Flash-Cart/Flash-Cart-Model/9.Eletrônica/Esquemáticos/Conexão da tela - PI2.jpg

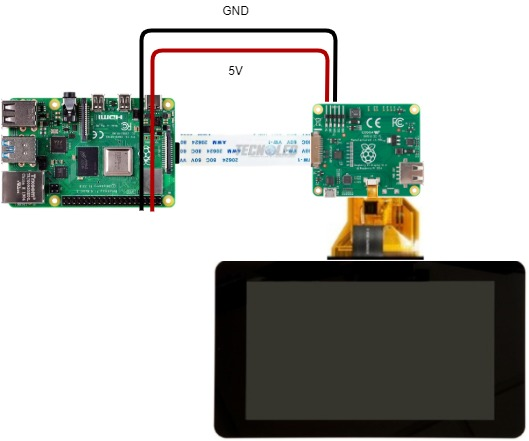
9.Eletrônica/Esquemáticos/Conexão da tela - PI2.jpg
