Flash-Cart/Flash-Cart-Model/2.CADs/Flash Cart Completo Final - 28_04_2021/FLASH CART/Toten de carregamento/suporte+toten.jpg

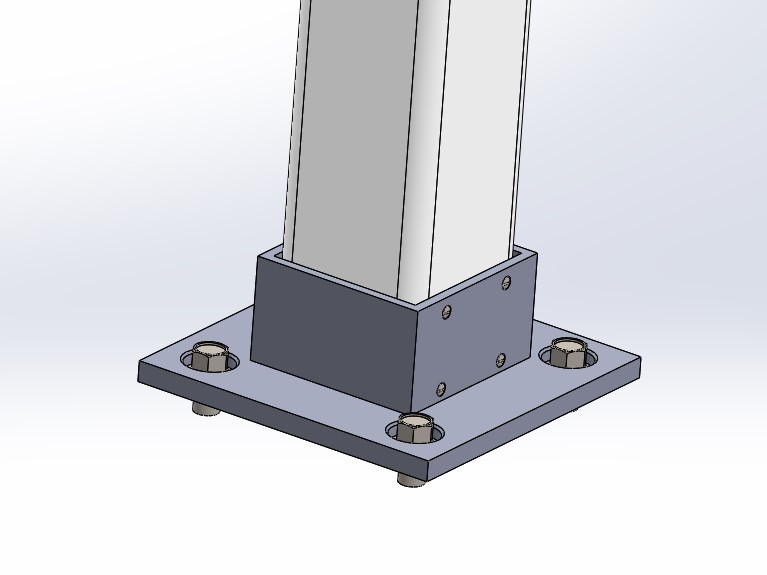
2.CADs/Flash Cart Completo Final - 28_04_2021/FLASH CART/Toten de carregamento/suporte+toten.jpg
