Flash-Cart/Flash-Cart-Model/9.Eletrônica/Referências/REFERÊNCIAS BIBLIOGRÁFICAS.docx

REFERÊNCIAS BIBLIOGRÁFICAS

BALANÇA:

[1] SILVA.F.T.F. Análise numérica e otimização de uma célula de carga de ponto único. UFRGS, 2017

Link: https://lume.ufrgs.br/bitstream/handle/10183/165161/001044445.pdf?sequence=1&isAllowed=y#page=1&zoom=auto,-15,842

[2] 7 PESO padronizado. . Acessado: 13-04-2021.

Link: https://www.troemner.com/weights/electronic-balance-test-weights/electronic-balance-test-weights-metric/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,

[3] SIMULADOR 625-Acessado: 13-04-2021

Link: https://docs.blhnobel.com/?id=2915

[5] ZHAO, W. et al. Design of dynamic calf weighing system based on moving-iir filter algorithm. Journal of Electrical Engineering & Technology, Springer, v. 16, n. 2, p. 1059–1069, 2021. Citado na página 50.

Link: https://link.springer.com/article/10.1007/s42835-020-00604-5

[6]datasheet L6E3

Link: https://www.zemiceurope.com/media/Documentation/L6E3_Datasheet.pdf, acessado em 13/04/21

[7]Peso da moeda de 1 real

Link: https://www.bcb.gov.br/dinheirobrasileiro/pdf/FolderMoedas.pdf, acesso em 12/04/21

[8]GETTING Started with Load Cells. . Acessado: 23-03-2021. Citado na página 50.

Link: https://learn.sparkfun.com/tutorials/getting-started-with-load-cells, acesso em 12/04/21

[9]Regulaçao técnica para célula de cargas:

ASL, S. E. et al. Part 1: Metrological and technical requirements. In: OIML. Metrological Regulation for Load Cells. [S.l.], 2017. p. 1–57. Citado na página 50.

Link: https://www.nist.gov/system/files/documents/2016/11/02/tc9_p1_n001_oiml_r60-1_5cd_clean.pdf , acesso em 12/04/21

[10] AMPLIFICADORHX711. . Acessado: 13-04-2021. Citado 2 vezes nas páginas 50 e 51

Link:https://www.alldatasheet.com/view.jsp?Searchword=HX711 , acesso em 12/04/21

[11]: ABNT_NBR_ISO_IEC_17025_2017

Link: http://www.inmetro.gov.br/credenciamento/eventos-cgcre/13-14-15Workshop/00-DOQ-CGCRE-087_rev_00_-_Orientacoes_gerais_sobre_os_requisitos_da_ABNT_NBR_ISO_IEC_17025_20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

[12] HIGH-SPEED CMOS Logic 16-Channel Analog Multiplexer/Demultiplexer. 2003. Acessado: 23-03-2021. Citado na página 50.

Link: https://www.alldatasheet.com/view.jsp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

SENSOR ULTRASSÔNICO:

[1] Datasheet hc-sr04:

ZHMUD, V. et al. Ultrasonic distance sensor hc-sr04. Automatics & Software Enginery. 2017. N4 (22), n. 7/212, p. 10, 2017

[2] LIU, Y.; YE, W.-J. Time consuming numerical model calibration using genetic algorithm (ga), 1-nearest neighbor (1nn) classifier and principal component analysis (pca). In: IEEE. 2005 IEEE Engineering in Medicine and Biology 27th Annual Conference. [S.l.], 2006. p. 1208–1211. Citado na página 67.

Link: https://pubmed.ncbi.nlm.nih.gov/17282410/

[3] GANDHA, G. I.; SANTOSO, D. A. The newton’s polynomial based-automatic model generation (amg) for sensor calibration to improve the performance of the low-cost ultrasonic range finder (hc-sr04). JURNAL INFOTEL, v. 12, n. 3, p. 115–122, 2020. Citado 3 vezes nas páginas 2, 67 e 68.

Link: https://ejournal.st3telkom.ac.id/index.php/infotel/article/view/486

[4]SRIVASTAVA, R.; SRIVASTAVA, P. K. Comparison of lagrange’s and newton’s interpolating polynomials. Journal of Experimental Sciences, v. 3, n. 1, 2012. Citado 2 vezes nas páginas 68 e 69.

Link : https://updatepublishing.com/journal/index.php/jes/article/download/1904/1886
