Flash-Cart/Flash-Cart-Model/10.Energia/folhas de projeto/folha de projeto carregador com fio.pdf

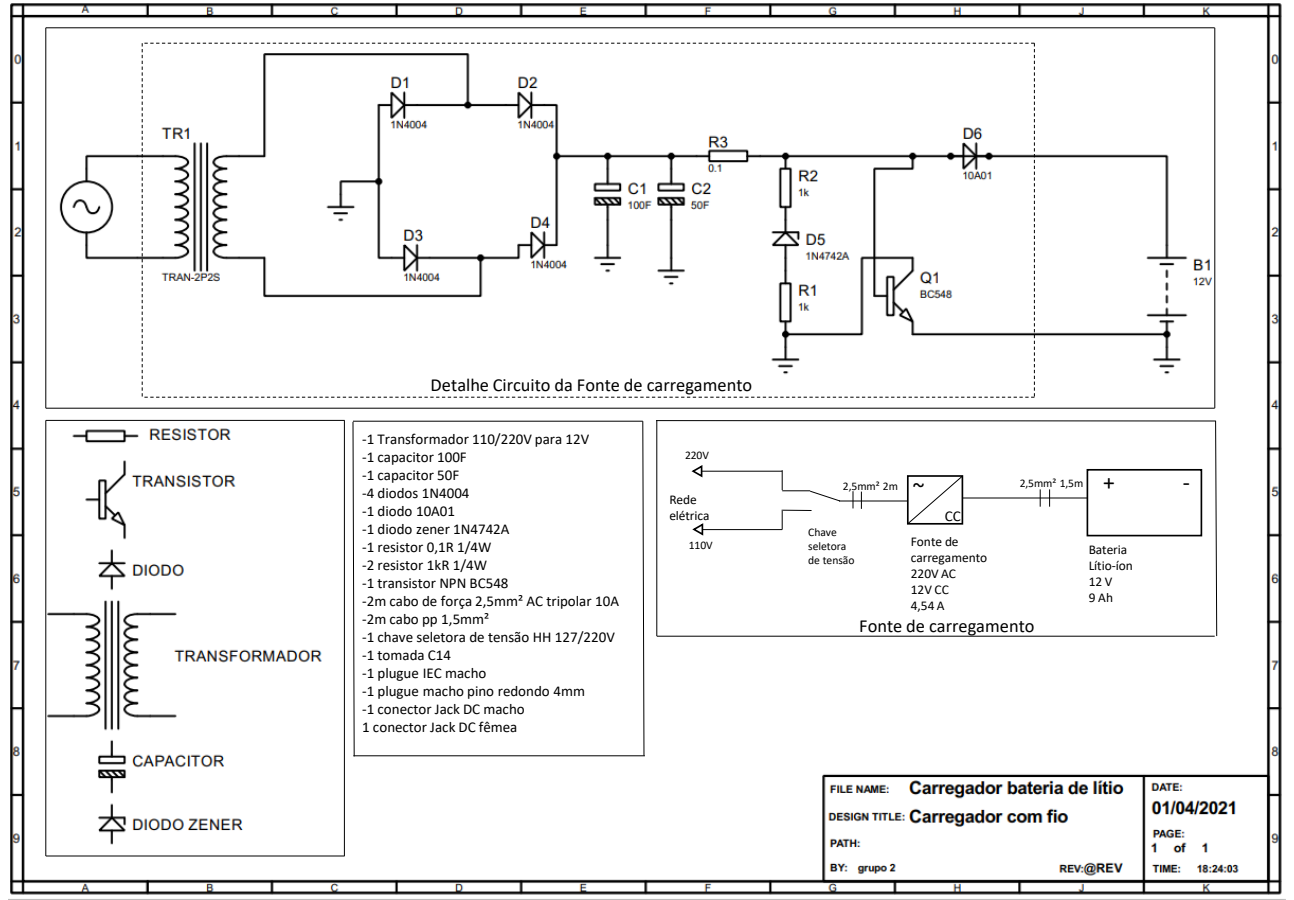
[picture p4: page 1]

### Detalhe Circuito da Fonte de carregamento

+ - ~

CC

Rede
elétrica

220V

110V

Chave
seletora
de tensão
2,5mm² 2m | 2,5mm² 1,5m

Fonte de
carregamento
220V AC
12V CC
4,54 A

Bateria
Lítio-íon
12 V
9 Ah

### Fonte de carregamento

-1 Transformador 110/220V para 12V -1 capacitor 100F
-1 capacitor 50F
-4 diodos 1N4004
-1 diodo 10A01
-1 diodo zener 1N4742A
-1 resistor 0,1R 1/4W
-2 resistor 1kR 1/4W
-1 transistor NPN BC548
-2m cabo de força 2,5mm² AC tripolar 10A -2m cabo pp 1,5mm²
-1 chave seletora de tensão HH 127/220V -1 tomada C14
-1 plugue IEC macho
-1 plugue macho pino redondo 4mm
-1 conector Jack DC macho
1 conector Jack DC fêmea
