Flash-Cart/Flash-Cart-Model/10.Energia/folhas de projeto/folha de projeto carregador sem fio  receptor.pdf

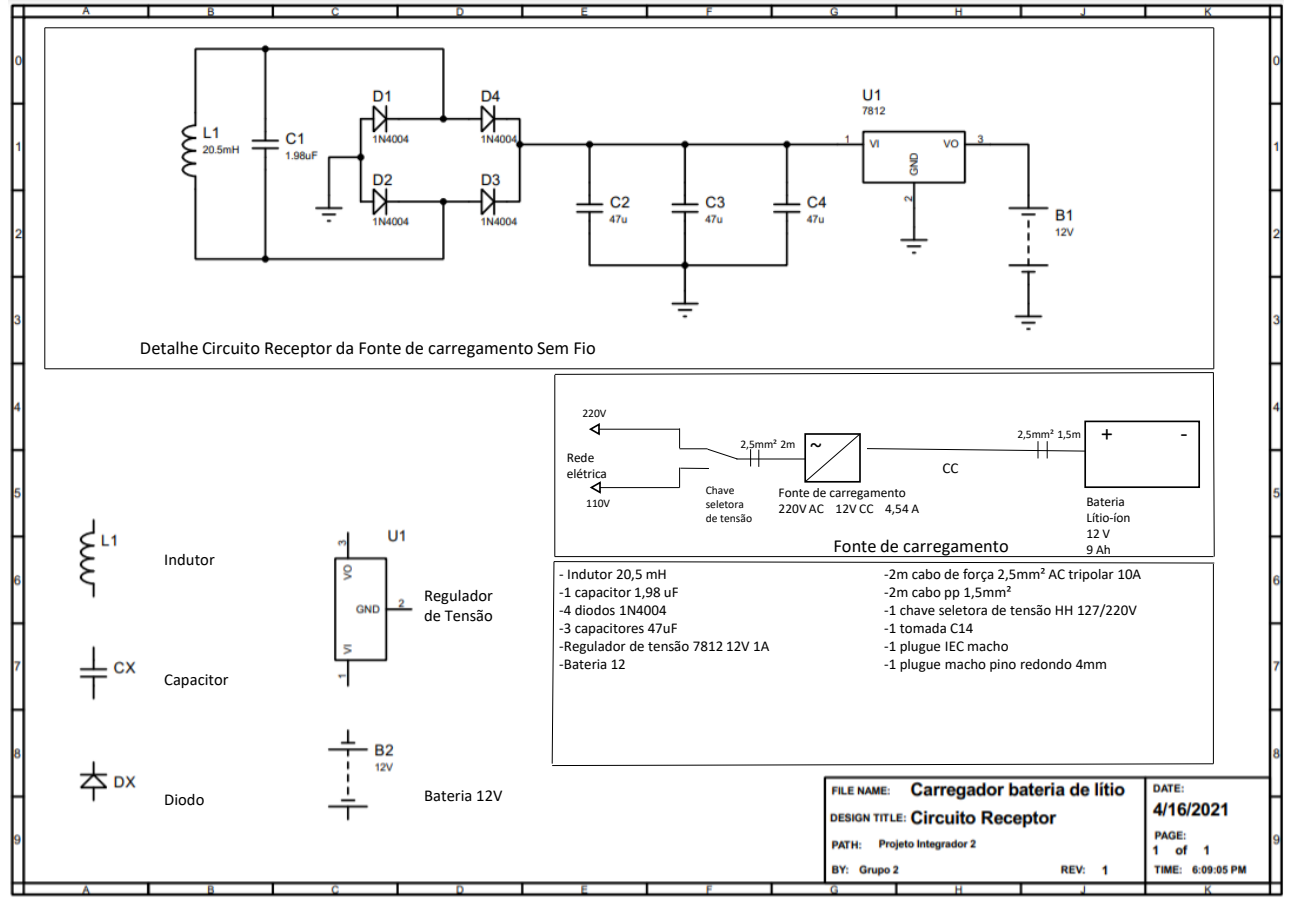
[picture p5: page 1]

### Detalhe Circuito Receptor da Fonte de carregamento Sem Fio

+ -
~
CC

Rede
elétrica

220V

110V

Chave
seletora
de tensão

2,5mm² 2m

2,5mm² 1,5m

Fonte de carregamento
220V AC 12V CC 4,54 A

Bateria
Lítio-íon
12 V
Fonte de carregamento | 9 Ah
- Indutor 20,5 mH
-1 capacitor 1,98 uF
-4 diodos 1N4004
-3 capacitores 47uF
-Regulador de tensão 7812 12V 1A -Bateria 12

-2m cabo de força 2,5mm² AC tripolar 10A -2m cabo pp 1,5mm²
-1 chave seletora de tensão HH 127/220V -1 tomada C14
-1 plugue IEC macho
-1 plugue macho pino redondo 4mm

Indutor

Capacitor

Diodo

Regulador
de Tensão

Bateria 12V

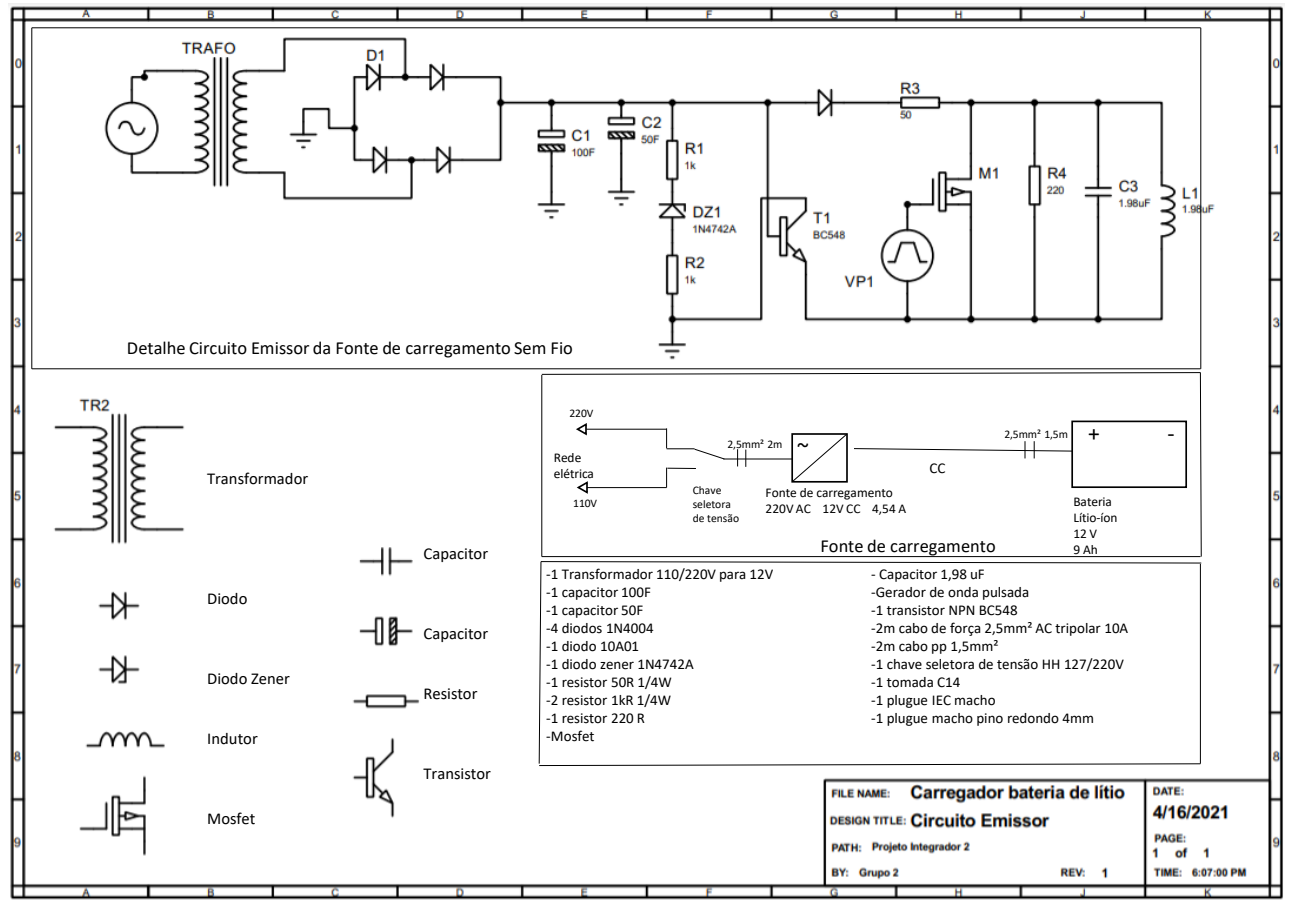
[picture p6: page 2]

### Detalhe Circuito Emissor da Fonte de carregamento Sem Fio

+ -
~
CC

Rede
elétrica

220V

110V

Chave
seletora
de tensão

2,5mm² 2m

2,5mm² 1,5m

Fonte de carregamento
220V AC 12V CC 4,54 A

Bateria
Lítio-íon
12 V
Fonte de carregamento | 9 Ah

-1 Transformador 110/220V para 12V -1 capacitor 100F
-1 capacitor 50F
-4 diodos 1N4004
-1 diodo 10A01
-1 diodo zener 1N4742A
-1 resistor 50R 1/4W
-2 resistor 1kR 1/4W
-1 resistor 220 R
-Mosfet
- Capacitor 1,98 uF
-Gerador de onda pulsada
-1 transistor NPN BC548
-2m cabo de força 2,5mm² AC tripolar 10A -2m cabo pp 1,5mm²
-1 chave seletora de tensão HH 127/220V -1 tomada C14
-1 plugue IEC macho
-1 plugue macho pino redondo 4mm

Transformador

Diodo

Diodo Zener

Indutor

Mosfet

Capacitor

Capacitor

Resistor

Transistor
