Flash-Cart/Flash-Cart-Model/9.Eletrônica/Eletrônica PC3.pptx

## Eletrônica - PC3

## Testes dos subsistemas

- Tem como objetivo verificar possíveis erros em cada subsistema em separado
- Devem ser realizados ao receber o carrinho e periodicamente para garantir o funcionamento do carrinho
- Composto de testes rápidos que podem ser efetuados por um funcionário sem experiência em eletrônica

## Teste da balança

- Consiste em posicionar um peso de teste cuja massa já é conhecida e verificar se o display mostra um valor adequado
- recomenda-se utilizar pesos padronizados; pesos de objetos comuns pode ser utilizados, mas deve-se adotar uma margem de erro maior nesses casos

## Teste do sensor ultrassônico

- Consiste em posicionar o carrinho contra a parede e utilizar um gabarito desenhado no chão como guia para movimentar o carrinho e checar a distância entre carrinho e parede

## teste do sistema RFID

- Os testes do sistema RFID podem ser divididos em 3 partes:
  - Teste de leitura: verificar se o sistema identifica uma tag colocada no carrinho
  - Teste de registro: verificar se o sistema leu e registro o produto relacionado aquela tag
  - Teste de tempo: verificar se a leitura e registro foram feitos em um tempo adequado
- Os testes dos sistema RFID requerem uma estrutura especial de antenas de teste

## Teste do sistema de trava

- Consiste em acionar o modo de teste que ativa os atuadores lineares de forma a travar as rodas do flash cart
- Depois de travado o funcionário deve tentar empurrar o carrinho e observar se há ou não movimento
- Deve-se atentar para movimento tanto das duas rodas quanto de uma das rodas somente

## Teste do sistema de áudio

- Este teste executa um áudio de teste.
- Para um bom resultado do teste recomenda-se a escolha de pelo menos 3 áudios com diferentes níveis de graves, médios e águdos

## Calibração dos subsistemas

- Tem objetivos de calibrar os subsistemas e ajustá-los de forma a obter uma resposta mais precisa
- Algumas calibrações envolvem processos que necessitam um funcionário com conhecimento técnico em eletrônica.

## Ajuste da odometria

- Esse ajuste se baseia no cálculo de um novo coeficiente que multiplica o número de passos contados pelo carrinho
- O funcionário deve movimentar linearmente o carrinho guiando-se pelo gabarito no chão
- Ao final do ajuste o algoritmo da MSP calcula automaticamente a nova constante que será utilizada na odometria

## Ajuste do sistema da balança

- Antes de ser feita a calibração em si deve-se verificar se há necessidade da calibração. Esta verificação é feita causando uma deformação virtual nos sensores da balança utilizando um resistor de teste. Caso o valor verificado nesse teste seja muito destoante do valor esperado deve-se prosseguir para a calibração.
- A calibração do sistema é feita utilizando um peso padronizado. O algoritmo na MSP ajusta o fator de calibração até que o peso medido pelo subsistema seja igual a ao peso padronizado
- A calibração das células individualmente é feita utilizando um calibrador portátil de precisão

## Ajuste do sensor ultrassônico

- Este ajuste é feito de forma automática pelo algoritmo de ajuste de curva na RASP
- Um funcionário deve mover o carrinho pelo gabarito desenhado no chão com o carrinho apontando na direção da parede
- O algoritmo calcula a distância medida e já tem embutido a distância real até o objeto . Esses dois valores são utilizados no aproximador de polinômio
