Flash-Cart/Flash-Cart-Model/2.CADs/Flash Cart Completo Final - 28_04_2021/FLASH CART/Balança/platform-scale-load-cell-350kg-200kg-100kg-60kg-1.snapshot.9/load_cell_sensor_FNL.JPG

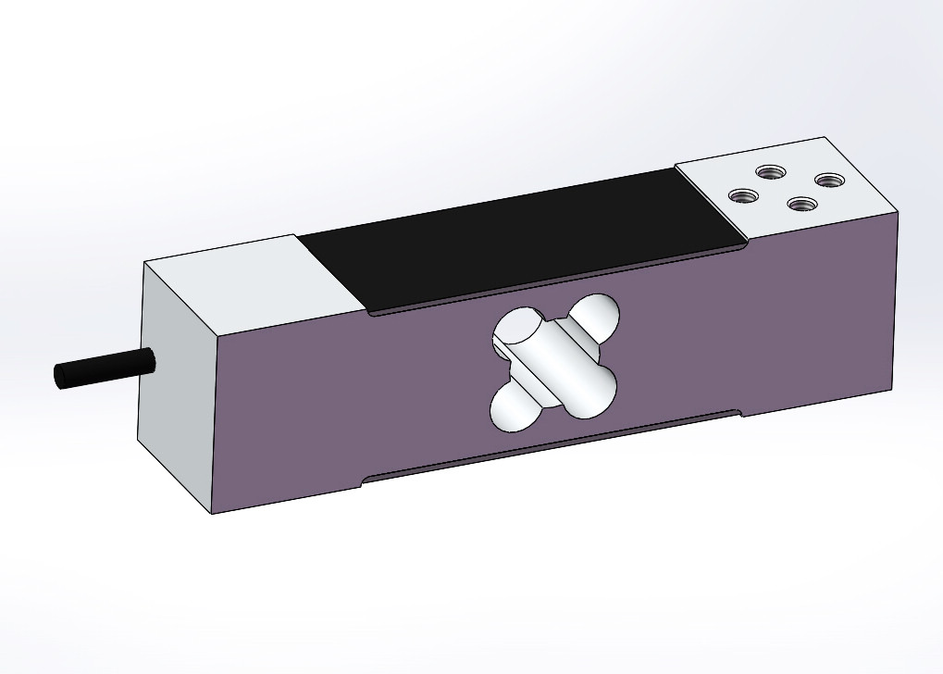
2.CADs/Flash Cart Completo Final - 28_04_2021/FLASH CART/Balança/platform-scale-load-cell-350kg-200kg-100kg-60kg-1.snapshot.9/load_cell_sensor_FNL.JPG
