Flash-Cart/Flash-Cart-Model/2.CADs/Flash Cart Completo Final - 28_04_2021/FLASH CART/Toten de carregamento/figuras/battery-circle-green-512.png

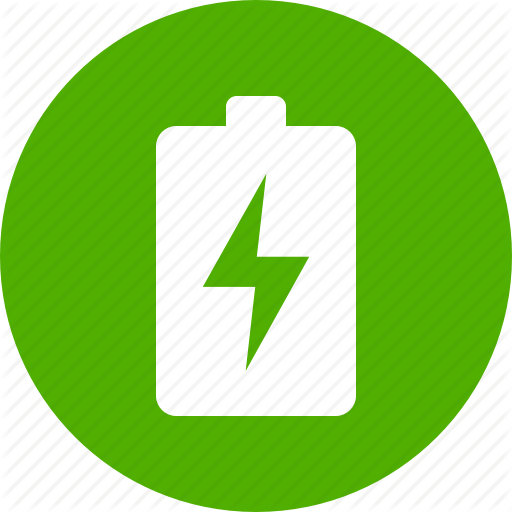
2.CADs/Flash Cart Completo Final - 28_04_2021/FLASH CART/Toten de carregamento/figuras/battery-circle-green-512.png
