Flash-Cart/Flash-Cart-Model/2.CADs/Flash Cart Completo Final - 28_04_2021/FLASH CART/Toten de carregamento/figuras/FOTO 1 - TOTEN.png

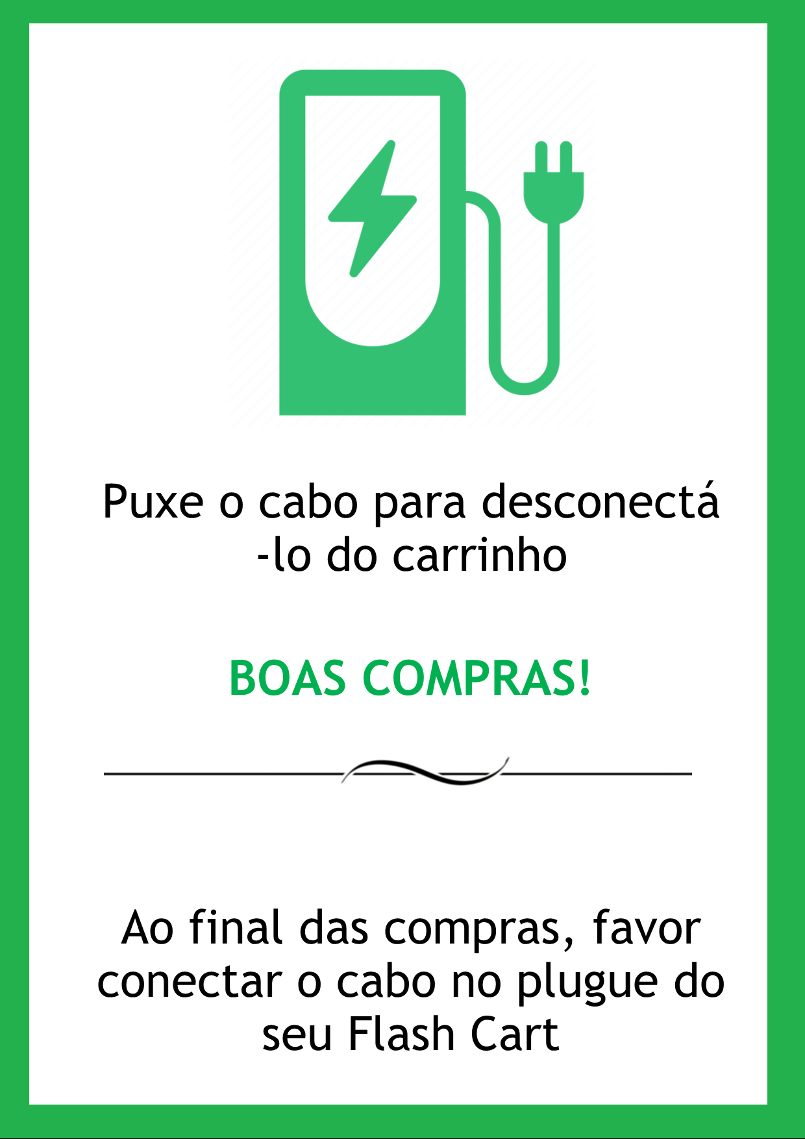
2.CADs/Flash Cart Completo Final - 28_04_2021/FLASH CART/Toten de carregamento/figuras/FOTO 1 - TOTEN.png
