Flash-Cart/Flash-Cart-Model/8.MoldeCesta/geometriaCesta.png

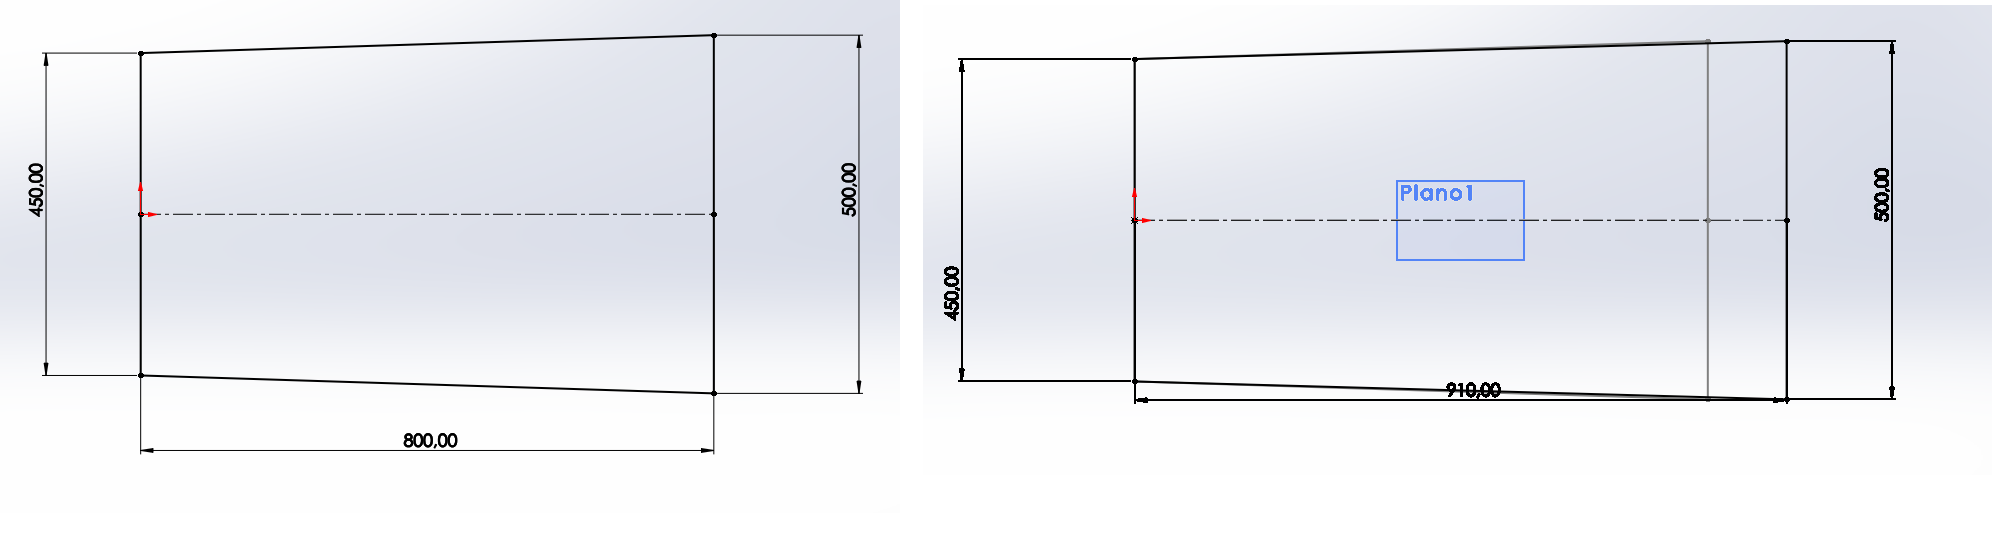
8.MoldeCesta/geometriaCesta.png
