Flash-Cart/Flash-Cart-Model/9.Eletrônica/Algoritmos/Diag_blocos_BalançaFinal.png

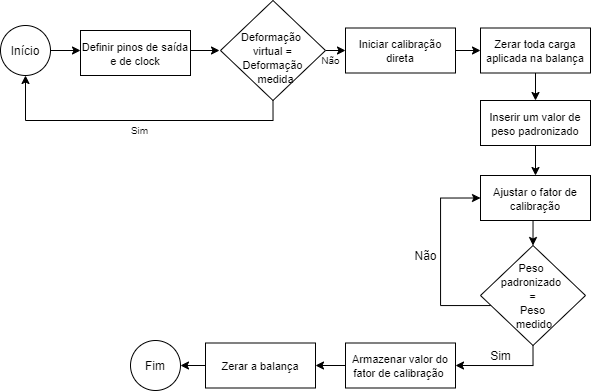
9.Eletrônica/Algoritmos/Diag_blocos_BalançaFinal.png
