Flash-Cart/Flash-Cart-Model/9.Eletrônica/Algoritmos/DiagBlocos_ultrassomFIR.png

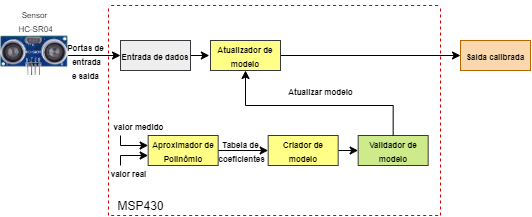
9.Eletrônica/Algoritmos/DiagBlocos_ultrassomFIR.png
