Flash-Cart/Flash-Cart-Model/9.Eletrônica/Esquemáticos/Altofalante - circuito.PNG

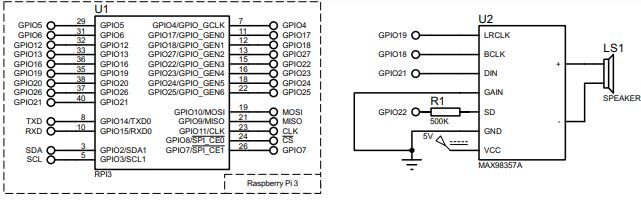
9.Eletrônica/Esquemáticos/Altofalante - circuito.PNG
