Flash-Cart/Flash-Cart-Model/9.Eletrônica/Esquemáticos/Altofalante - cirsuito da simulação.PNG

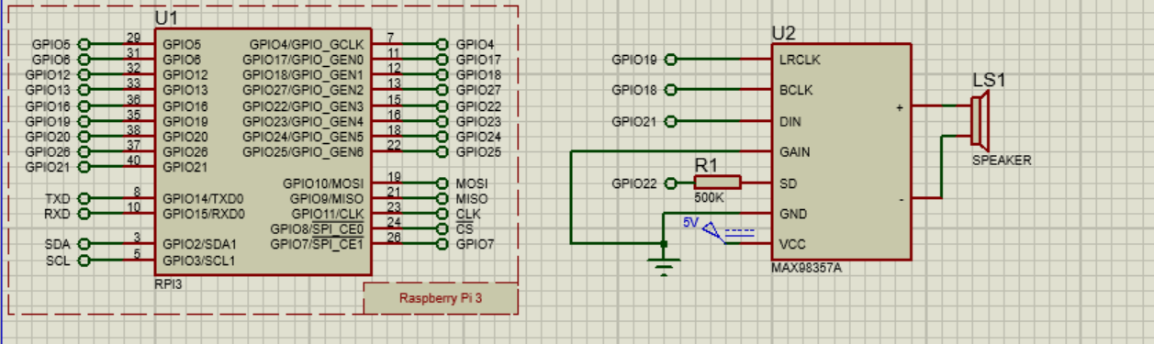
9.Eletrônica/Esquemáticos/Altofalante - cirsuito da simulação.PNG
