Flash-Cart/Flash-Cart-Model/9.Eletrônica/Esquemáticos/Diagrama geral.jpg

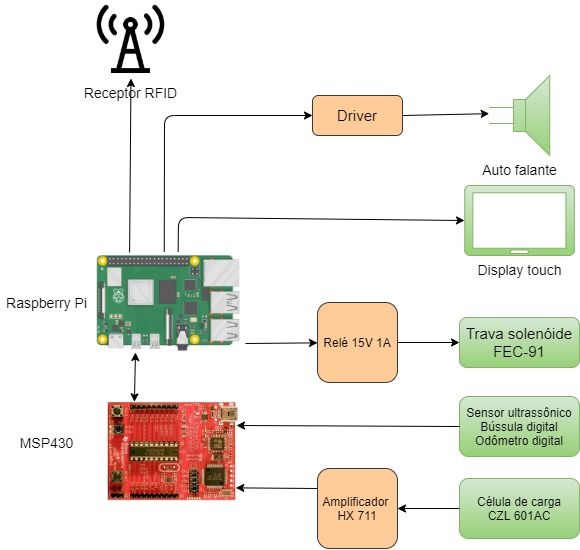
9.Eletrônica/Esquemáticos/Diagrama geral.jpg
