Flash-Cart/Flash-Cart-Model/9.Eletrônica/Esquemáticos/Trava de roda - circuito da simulacao.PNG

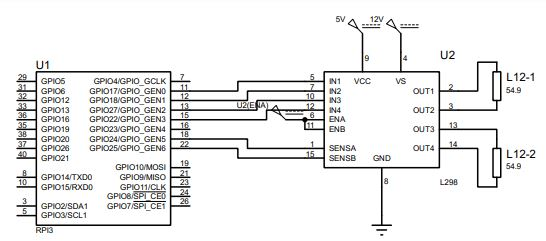
9.Eletrônica/Esquemáticos/Trava de roda - circuito da simulacao.PNG
