Flash-Cart/Flash-Cart-Model/10.Energia/imagens e esquemáticos/bateria_litio.png

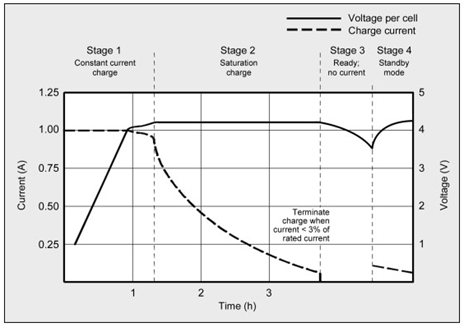
10.Energia/imagens e esquemáticos/bateria_litio.png
