Flash-Cart/Flash-Cart-Model/10.Energia/imagens e esquemáticos/Blocossemfio.PNG

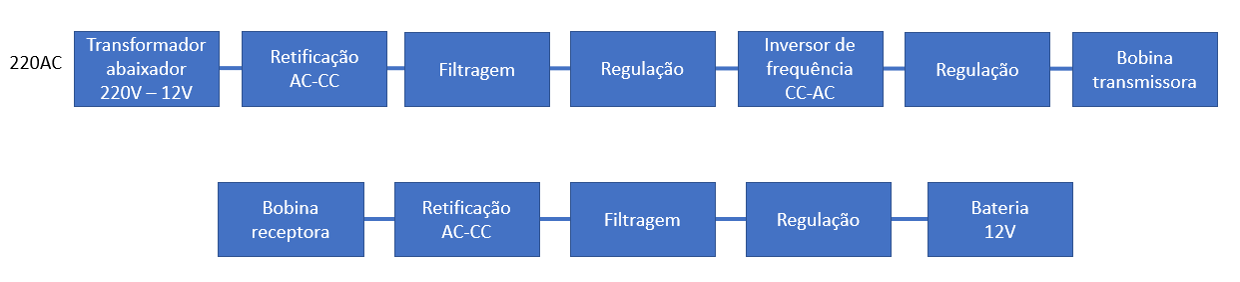
10.Energia/imagens e esquemáticos/Blocossemfio.PNG
