Flash-Cart/Flash-Cart-Model/10.Energia/imagens e esquemáticos/circuito_fonte_regulavel.PNG

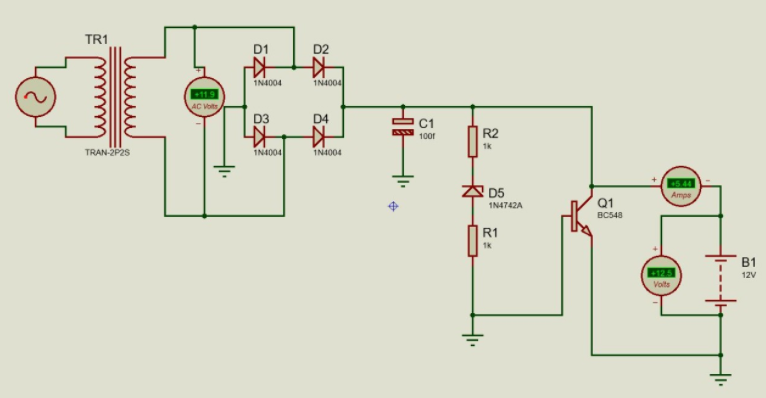
10.Energia/imagens e esquemáticos/circuito_fonte_regulavel.PNG
