Flash-Cart/Flash-Cart-Model/10.Energia/imagens e esquemáticos/diag_bloc_font_al.png

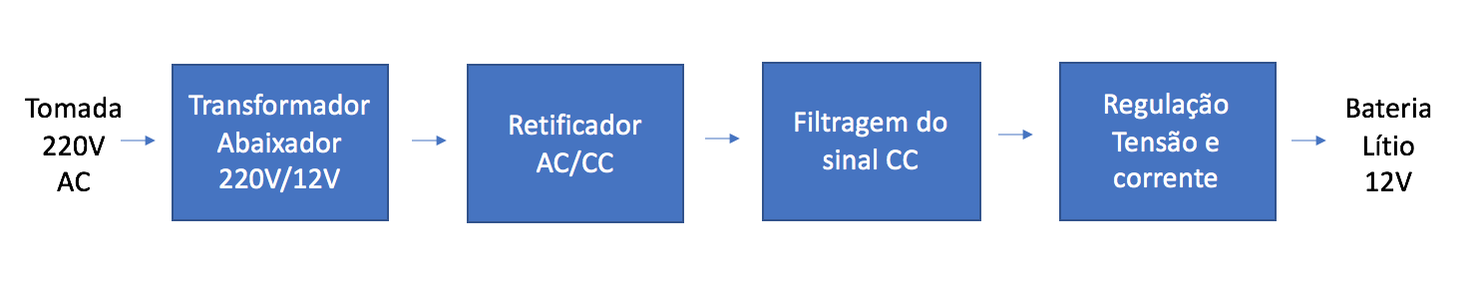
10.Energia/imagens e esquemáticos/diag_bloc_font_al.png
