Flash-Cart/Flash-Cart-Model/10.Energia/imagens e esquemáticos/emissor.JPG

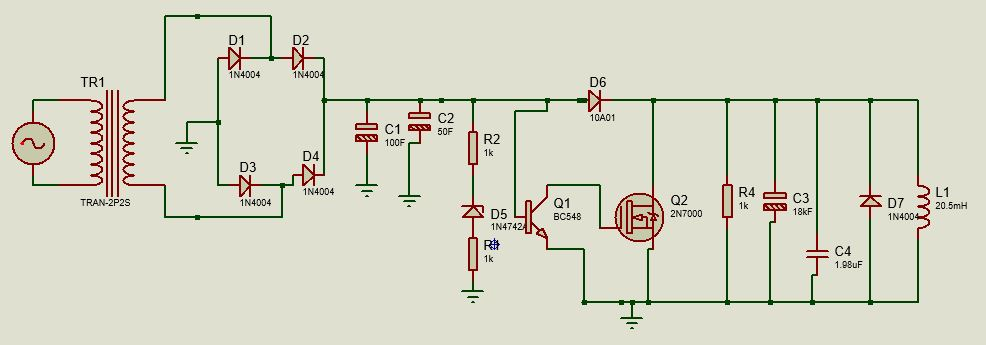
10.Energia/imagens e esquemáticos/emissor.JPG
