Flash-Cart/Flash-Cart-Model/10.Energia/imagens e esquemáticos/Figbobinas.png

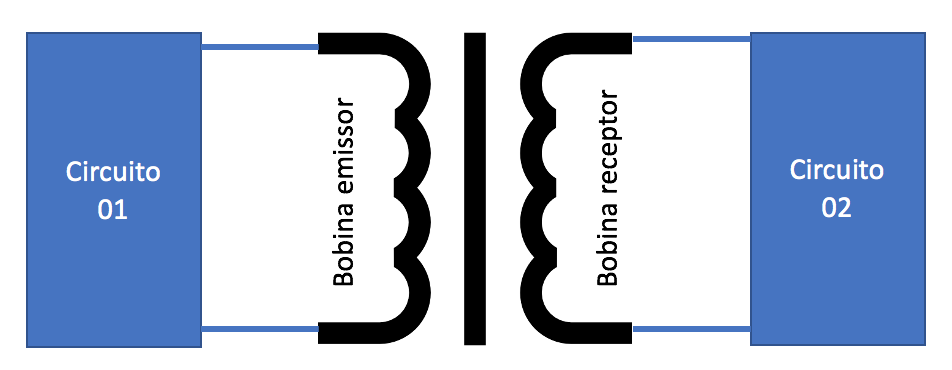
10.Energia/imagens e esquemáticos/Figbobinas.png
