Flash-Cart/Flash-Cart-Model/10.Energia/imagens e esquemáticos/filtro.PNG

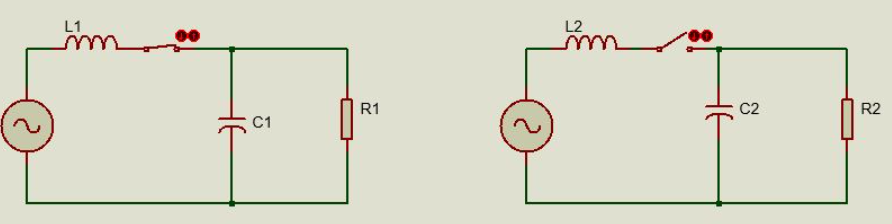
10.Energia/imagens e esquemáticos/filtro.PNG
