Flash-Cart/Flash-Cart-Model/10.Energia/imagens e esquemáticos/fio.PNG

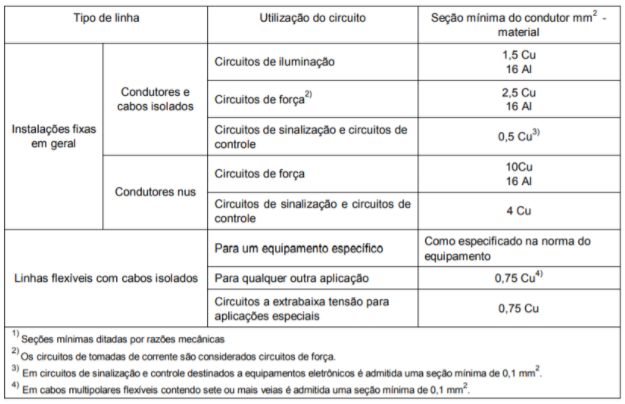
10.Energia/imagens e esquemáticos/fio.PNG
