Flash-Cart/Flash-Cart-Model/10.Energia/imagens e esquemáticos/fonte4.44.PNG

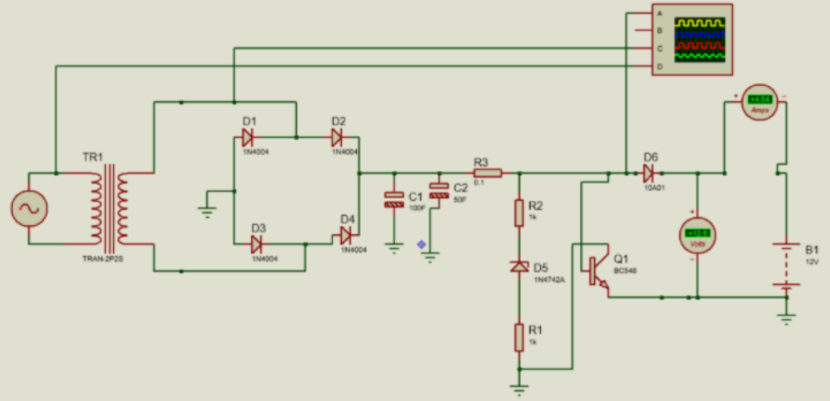
10.Energia/imagens e esquemáticos/fonte4.44.PNG
