Flash-Cart/Flash-Cart-Model/10.Energia/imagens e esquemáticos/ociloscopio.jpeg

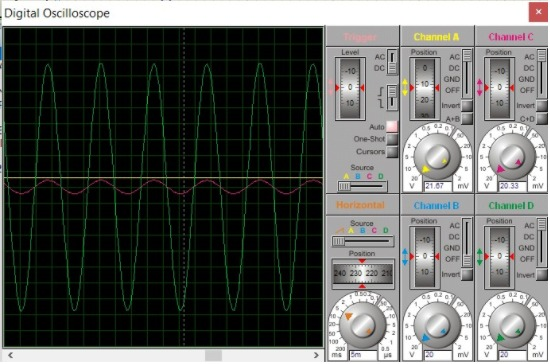
10.Energia/imagens e esquemáticos/ociloscopio.jpeg
