Flash-Cart/Flash-Cart-Model/10.Energia/imagens e esquemáticos/RCL.JPG

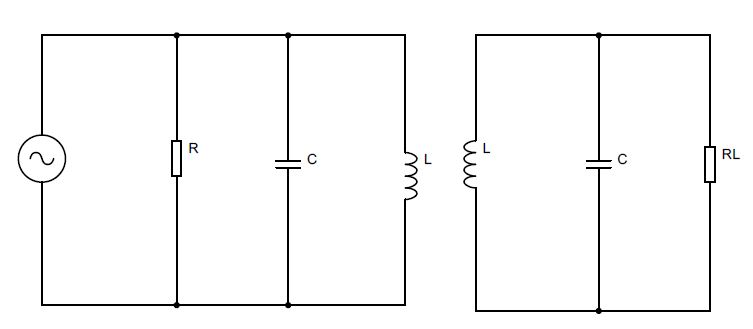
10.Energia/imagens e esquemáticos/RCL.JPG
