Flash-Cart/Flash-Cart-Model/10.Energia/imagens e esquemáticos/receptor.JPG

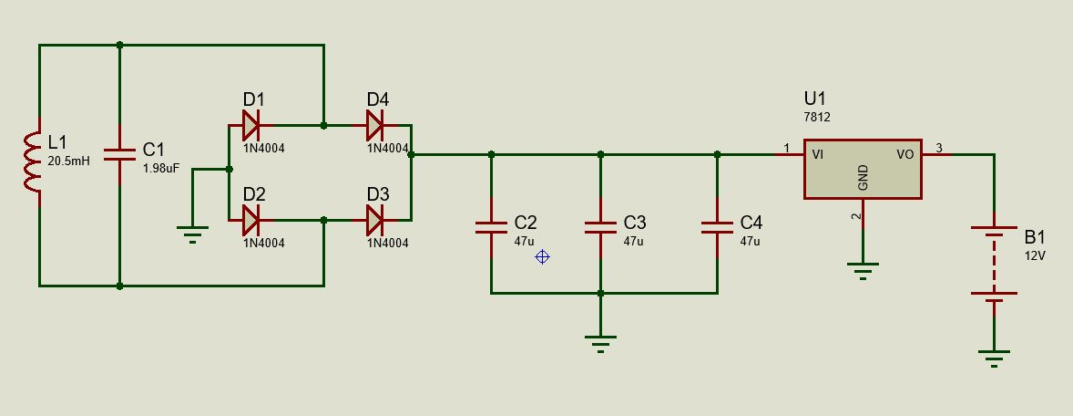
10.Energia/imagens e esquemáticos/receptor.JPG
