Flash-Cart/Flash-Cart-Model/10.Energia/imagens e esquemáticos/receptorsembateria.PNG

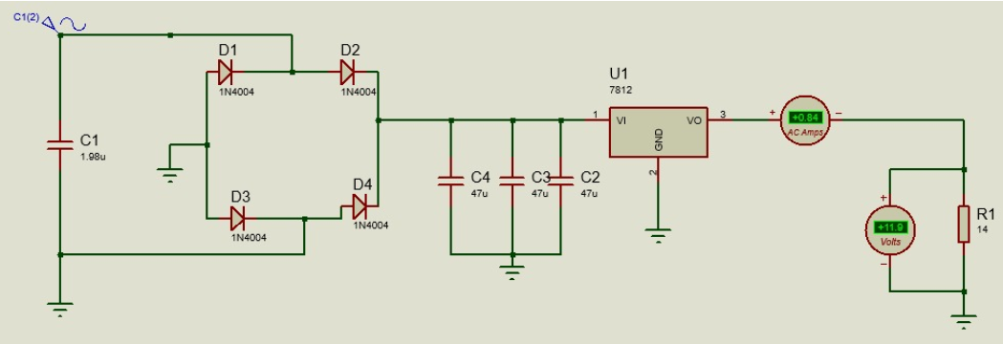
10.Energia/imagens e esquemáticos/receptorsembateria.PNG
