Flash-Cart/Flash-Cart-Model/10.Energia/imagens e esquemáticos/regulador.PNG

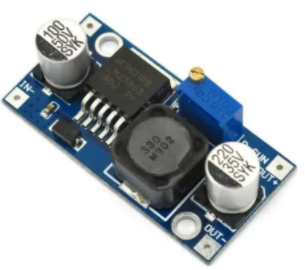
10.Energia/imagens e esquemáticos/regulador.PNG
