Flash-Cart/Flash-Cart-Model/10.Energia/imagens e esquemáticos/regulador_tensao.png

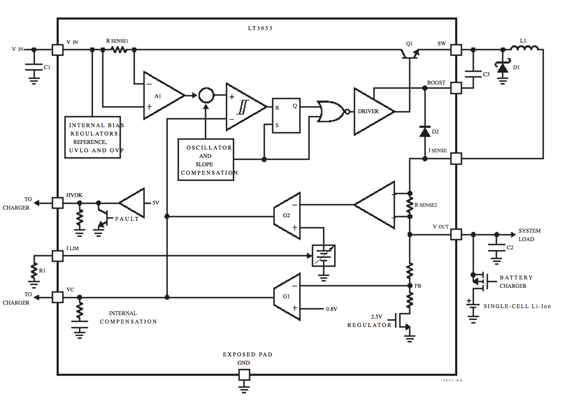
10.Energia/imagens e esquemáticos/regulador_tensao.png
