Flash-Cart/Flash-Cart-Model/10.Energia/imagens e esquemáticos/reguladorr.PNG

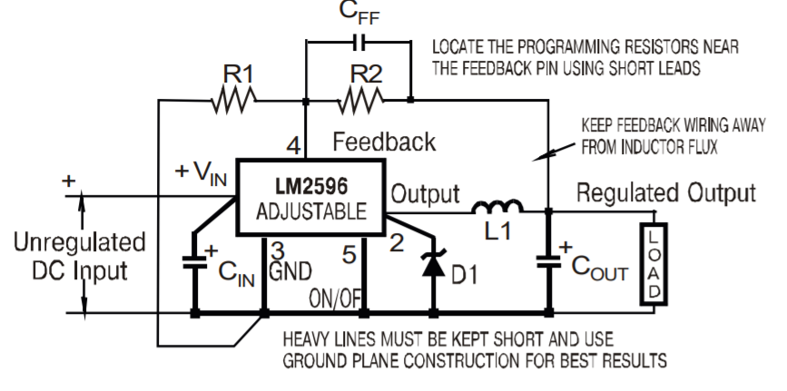
10.Energia/imagens e esquemáticos/reguladorr.PNG
