Flash-Cart/Flash-Cart-Model/10.Energia/imagens e esquemáticos/retificador.PNG

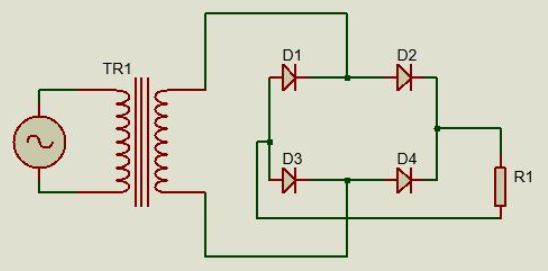
10.Energia/imagens e esquemáticos/retificador.PNG
