Flash-Cart/Flash-Cart-Model/10.Energia/imagens e esquemáticos/sistemaalimentacao.PNG

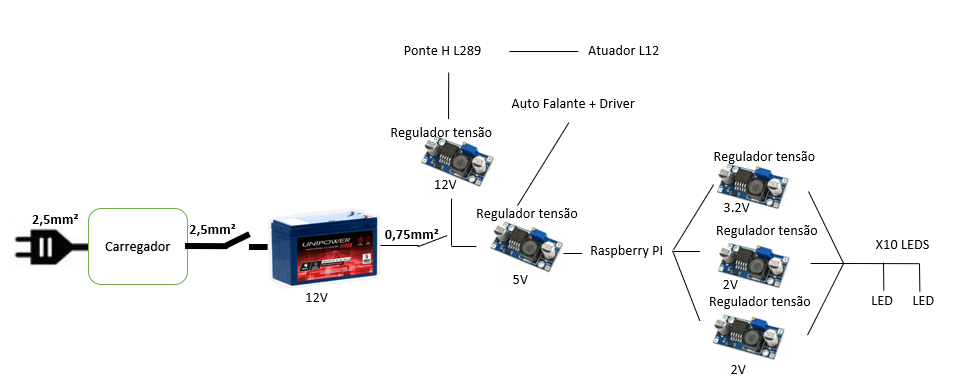
10.Energia/imagens e esquemáticos/sistemaalimentacao.PNG
