Flash-Cart/Flash-Cart-Model/7.Dados para o PC3/Dados para o PC3.xlsx

Sheet: Massa
Massa dos componentes totais
 |  | Componentes estruturais |  |  |  |  |  | Componentes estruturais
 |  |  | Massa da unidade | Número de unidades | Massa total |  |  |  | Massa da unidade | Número de unidades | Massa total
 |  |  | (kg) | - | (kg) |  |  |  | (kg) | - | (kg)
 |  | Chassi | 15.1 | 1 | 15.1 |  |  | Chassi | 5.0 | 1 | 5.0
 |  | Cesta | 1.3 | 1 | 1.3 | 1A |  | Cesta | 1.3 | 1 | 1.3
 |  | Capa da cesta | 13.7 | 1 | 13.7 | 2A e 3A |  | Capa da cesta | 13.7 | 1 | 13.7
 |  | Rodas Dianteira | 3.8 | 2 | 7.6 |  |  | Rodas Dianteira | 1.8 | 2 | 3.6
 |  | Roda Traseira | 5.8 | 2 | 11.6 |  |  | Roda Traseira | 2.9 | 2 | 5.8
 |  | Prato da balança | 3.9 | 1 | 0.5 | 3B |  | Prato da balança | 2.9 | 1 | 2.9
 |  | Armação inferior de madeira | 1.1 | 1 | 1.1 | 1B |  | Armação inferior de madeira | 0.8 | 1 | 0.8
 |  | Armação superior de madeira | 1.3 | 1 | 1.3 | 2B |  | Armação superior de madeira | 0.8 | 1 | 0.8
 |  | Chapinha de aço da balança | 0.1 | 8 | 0.7 | B.1.2 |  | Chapinha de aço da balança | 0.1 | 8 | 0.7
 |  | Baú de componentes eletrônicos | 0.4 | 1 | 0.4 | 1C |  | Baú de componentes eletrônicos | 0.4 | 1 | 0.4
 |  | Tampa superior do display | 0.6 | 1 | 0.6 | 2C |  | Tampa superior do display | 0.6 | 1 | 0.6
 |  | Tampa de abertura do suporte do display | 0.2 | 1 | 0.2 | 3C |  | Tampa de abertura do suporte do display | 0.2 | 1 | 0.2
 |  | Suporte reclinável do display | 0.5 | 1 | 0.5 | 4C |  | Suporte reclinável do display | 0.5 | 1 | 0.5
 |  | Capa da raspberry | 0.2 | 1 | 0.2 | 5C e 6C |  | Capa da raspberry | 0.2 | 1 | 0.2
 |  | Compartimento do plugue fêmea | 0.3 | 1 | 0.3 | 6A |  | Compartimento do plugue fêmea | 0.3 | 1 | 0.3
 |  | Carcaça da caixa de bateria | 2.6 | 1 | 2.6 | 1G |  | Carcaça da caixa de bateria | 2.6 | 1 | 2.6
 |  | Tampa da caixa de bateria | 0.2 | 1 | 0.2 | 2G |  | Tampa da caixa de bateria | 0.2 | 1 | 0.2
 |  | Suporte da bateria | 0.1 | 1 | 0.1 | 4G |  | Suporte da bateria | 0.1 | 1 | 0.1
 |  | Placa inferior |  |  | Já está computado |  |  | Placa inferior | 10.0 | 1 | 10.0
 |  | Total |  |  | 58.1 |  |  | Total |  |  | 49.6
 |  | Componentes eletro-eletrônicos |  |  |  |  |  | Componentes eletro-eletrônicos
 |  | Bateria | 0.5 | 1 | 0.5 | 3G |  | Bateria | 0.5 | 1 | 0.5
 |  | Transformador | 0.5 | 1 | 0.5 | A.1.4 |  | Transformador | 0.5 | 1 | 0.5
 |  | Antenas | 0.6 | 4 | 2.4 |  |  | Antenas | 0.6 | 4 | 2.4
 |  | Células de carga | 0.5 | 4 | 1.9 | B.1.1 |  | Células de carga | 0.5 | 4 | 1.9
 |  | Display Touch Screen Raspberry | 0.8 | 1 | 0.8 |  |  | Display Touch Screen Raspberry | 0.8 | 1 | 0.8
 |  | Máquina de pagamento | 0.3 | 1 | 0.3 |  |  | Máquina de pagamento | 0.3 | 1 | 0.3
 |  | Total |  |  | 6.4 |  |  | Total |  |  | 6.4
 |  | Total |  |  | 64.5 |  |  | Total |  |  | 56.0
 | Peças Caleffi |  |  |  |  |  | 24.533
 | F | Roda Dianteira (Montagem) | 1.8 | 2 | 3.6
 | 1F | Mecanismo Giratório | 0.34783 | 2
 | 2F | Suporte da roda dianteira | 0.53077 | 2
 | 3F | Roda Dianteira | 0.8 | 2
 | 5E & 4F | Interior da roda | 0.1 | 4
 | E | Roda Traseira (Montagem) | 2.9 | 2 | 5.8
 | 1E | Capa da Roda Traseira | 1 | 2
 | 2E | Atuador linear comercial | 0.05 | 2
 | 3E | Trava da Roda | 0.21944 | 2
 | 4E | Freio da Roda Traseira | 0.14082 | 2
 | 6E | Roda Traseira | 0.8 | 2
 | 7E | Suporte da Roda | 0.52394 | 2
 | D | Chassi (Montagem) | 15.133 | 1 | 15.133
 | 1D | Chapa Inferior | 10 | 1
 | 2D | Chassi Inferior | 1.1835 | 1
 | 3D | Chassi Inferior Traseiro | 0.29582 | 1
 | 4D | Chassi Vertical | 1.41335 | 1
 | 5D | Ligação do chassi vertical | 0.27668 | 1
 | 6D | Suporte do chassi da dianteira | 0.47664 | 1
 | 7D | Suporte do chassi no meio | 0.50876 | 1
 | 8D | Ligação da frente com o meio - Esquerda | 0.2186 | 1
 | 9D | Ligação da frente com o meio - Direita | 0.2186 | 1
 | 10D | Ligação do meio com a traseira - Esquerda | 0.20005 | 1
 | 11D | Ligação do meio com a traseira - Direita | 0.20005 | 1
 | 2B | Armação de madeira | 0.7768 | 2
 | D.1 | Montagem Com Solda | - | - | -
 |  |  |  | Total | 24.533
 |  |  |  | Total do Carrinho | 89.0
 |  | Molde (apenas a parte do caleffi ...) |  |  | 1.84577
 | 19H | Perfil 16 | 0.31091 | 1
 | 20H | Perfil 17 | 0.31033 | 1
 | 21H | Perfil 18 | 0.30782 | 1
 | 22H | Perfil 19 | 0.30744 | 1
 | 23H | Perfil 20 | 0.30473 | 1
 | 24H | Perfil 21 | 0.30454 | 1
 |  | Slot de carregamento | 8.2 | 1 | 8.2

Sheet: Componentes
Componentes
Balança
Componente | Quantidade
Armação inferior de madeira | 1
Armação Superior de madeira | 1
Prato de fibra de vidro/resina epóxi | 1
Célula de carga | 4
Chapinha de aço | 4
Parafuso HEXFHTS (5.5x13x11.2 mm) | 16
Cesta
Cesta de fibra de vidro/resina epóxi | 1
Capa para a cesta | 1
Capa traseira | 1
Sensor ultraasônico | 7
Parafusos

Sheet: Orçamento
Compra de materiais
 | Especificação | Preço da unidade | Quantidade | Preço total | Fornecedor
Madeira MDF Cru | 9 mm de espessura, 1,85 x 2,95 m | R$136.00 | 1 | R$136.00 | MG Madeireira
Isopor EPS, 5mm | 50 x 100 cm | R$0.50 | 3 | R$1.50 | Isoplan
Isopor EPS, 10 mm | 51 x 100 cm | R$1.42 | 3 | R$4.26 | Isoplan
Isopor EPS, 50 mm | 52 x 100 cm | R$7.12 | 3 | R$21.36 | Isoplan
Massa Acrílica Coral | 3,6 L | R$49.00 | 1 | R$49.00 | AC Coelho
Tinta branca Suvinil | 1 L | R$38.00 | 1 | R$38.00 | AC Coelho
Verniz Transparente | 1 L | R$31.00 | 1 | R$31.00 | AC Coelho
Total |  |  |  | R$281.12
Compra de serviço
 | Empresa | Valor
Fabricação do chassi | FFSantos | R$300.00
