Flash-Cart/Flash-Cart-Model/2.CADs/Flash Cart Completo Final - 28_04_2021/FLASH CART/Componentes Eletronicos/hcsr04/HcWithCover.SLDASM

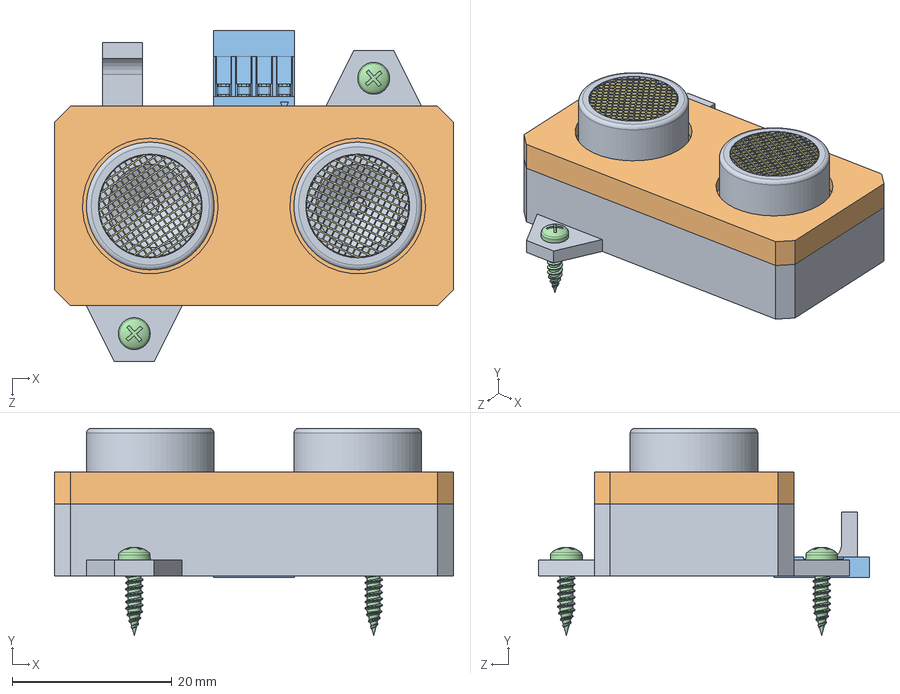
[picture p45: CAD file, 2021-04-28]
2.CADs/Flash Cart Completo Final - 28_04_2021/FLASH CART/Componentes Eletronicos/hcsr04/HcWithCover.SLDASM
50.0 x 26.0 x 41.5 mm
CoverBottom
BoardHCSR04
SOIC16 narrow x 3
Crystal Oscillator (SMD)
RES 0603 x 17
0603 Capacitor x 7
PLS-4R (DS-1022-1x4)
Transmitter
CoverTop
DS1071 (BLS) Connector
ISO 7049 - ST2,2x9,5 x 2
