Flash-Cart/Flash-Cart-Model/2.CADs/Flash Cart Completo Final - 28_04_2021/FLASH CART/Componentes Eletronicos/Montagem_SuporteEletronica_Com_Eletronica.SLDASM

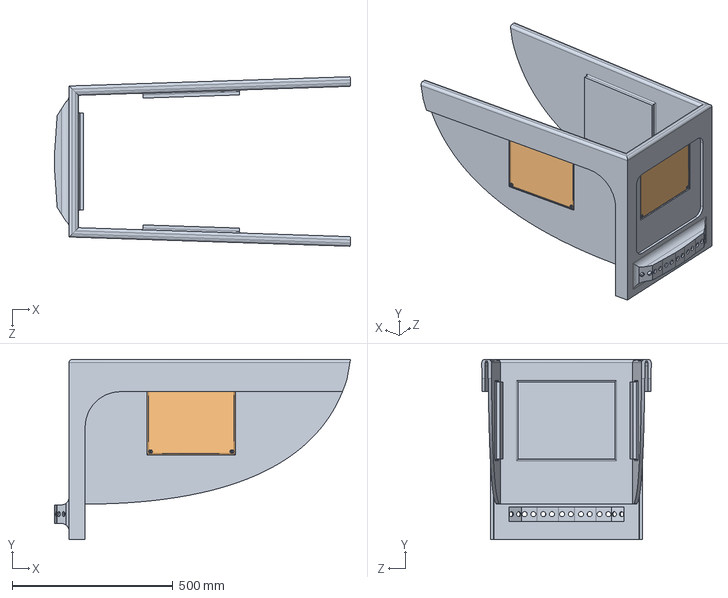
[picture p46: CAD file, 2021-04-28]
2.CADs/Flash Cart Completo Final - 28_04_2021/FLASH CART/Componentes Eletronicos/Montagem_SuporteEletronica_Com_Eletronica.SLDASM
919.8 x 560.0 x 526.9 mm
SuporteEletronica_Atualizado
Antena RFID AN610 x 3
