Flash-Cart/Flash-Cart-Model/5.Manuais/Caixa da bateria/passo1.SLDASM

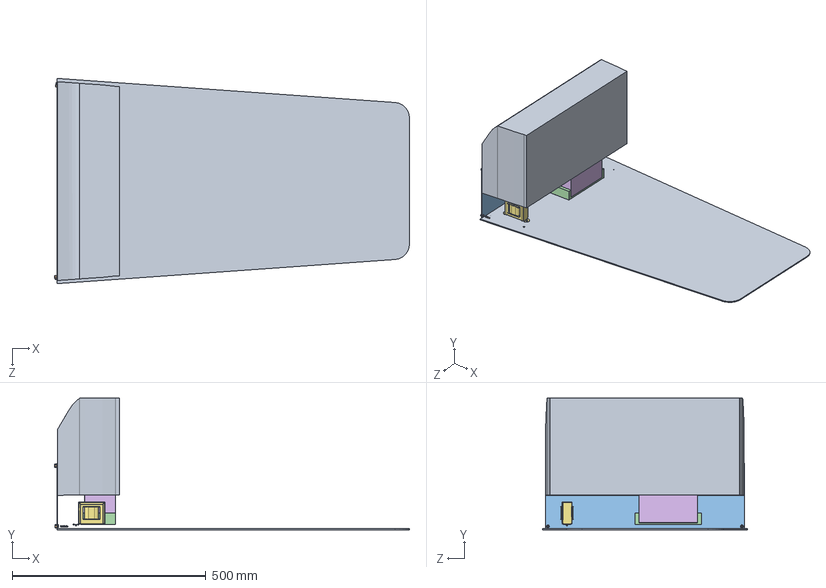
[picture p47: CAD file, 2021-04-28]
5.Manuais/Caixa da bateria/passo1.SLDASM
916.7 x 339.6 x 530.0 mm
Parte de baixo
pan slot head_am x 4
ChapaSuporteInferior_FlashCart
