Flash-Cart/Flash-Cart-Model/2.CADs/Flash Cart Completo Final - 28_04_2021/FLASH CART/Chassi/Montagem_FlashCart_Explodivel.SLDASM

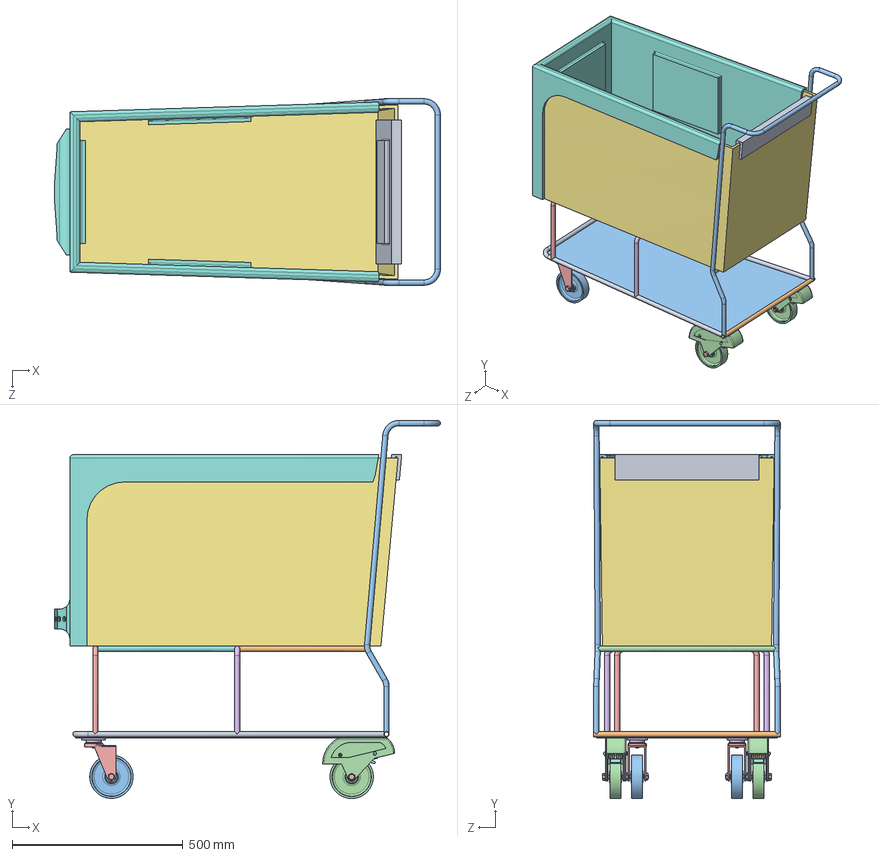
[picture p48: CAD file, 2021-04-28]
2.CADs/Flash Cart Completo Final - 28_04_2021/FLASH CART/Chassi/Montagem_FlashCart_Explodivel.SLDASM
1129.3 x 1106.3 x 545.9 mm
Chassi1_Inferior_Atualizado
Chassi2_Inferior_Atualizado
Chassi3_Vertical_Atualizado
Chassi4_HorizontalLigandoChassi3_Atualizado
Chassi5_Ligando_Frente_Atualizado
Chassi6_Ligando_Meio_Atualizado
Chassi7_Frente_Meio_Esquerda_Atualizado
Chassi8_Frente_Meio_Direita_Atualizado
Chassi9_Meio_Tras_Esquerda_Atualizado
Chassi10_Meio_Tras_Direita_Atualizado
ChapaSuporteInferior_FlashCart
Roda_Atualizada x 2
InteriorDaRoda_Atualizado x 2
SuporteDaRoda_Atualizado x 2
Trava_Atualizado x 2
Freio_Atualizado x 2
EXTENSION_10404_50MM.stp x 2
CLAMSHELL_BOT_10417.stp x 2
CLAMSHELL_TOP_10416.stp x 2
FASTENER_10427.stp x 8
GUIDE_10429.stp x 2
NUT_10419.stp x 2
GROMMET_3_HOLE.stp x 2
AsteDe50mm_Atualizado x 2
Pino_Atualizado x 2
CapaDoSuporteDaRoda_Atualizado x 2
formed hex screw_am x 4
hex nut jam_am x 10
socket button head cap screw_am x 8
Parafuso_M6_60mm x 2
BracadeiraAtuador x 2
hex nut style 2_am x 4
Roda_Frente_Atualizada x 2
InteriorDaRoda_Frente_Atualizado x 2
SuporteDaRoda_Frente_Atualizado x 2
Rolamento x 2
Cesta_Atualizada
SuporteEletronica_Atualizado
SuporteDeEletronica_Tras_Atualizado
