Flash-Cart/Flash-Cart-Model/2.CADs/Flash Cart Completo Final - 28_04_2021/FLASH CART/Plugue/Assem plugue.SLDASM

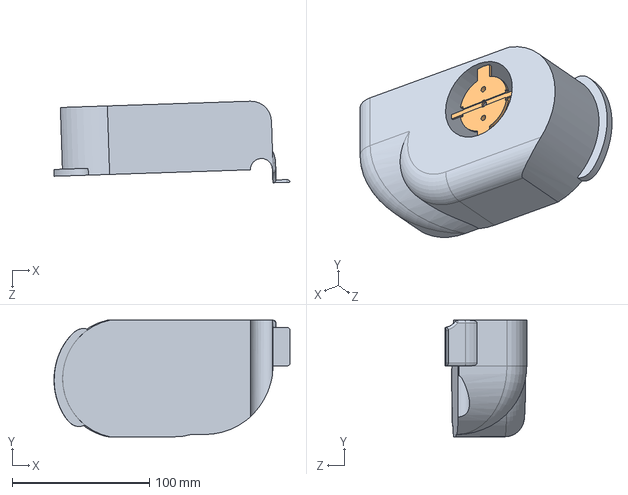
[picture p49: CAD file, 2021-04-28]
2.CADs/Flash Cart Completo Final - 28_04_2021/FLASH CART/Plugue/Assem plugue.SLDASM
172.1 x 85.0 x 59.5 mm
Carregador
plugue
