Flash-Cart/Flash-Cart-Model/2.CADs/Flash Cart Completo Final - 28_04_2021/FLASH CART/Rodas/RodaDaFrente/MontagemDaRoda_Frente_Atualizado.SLDASM

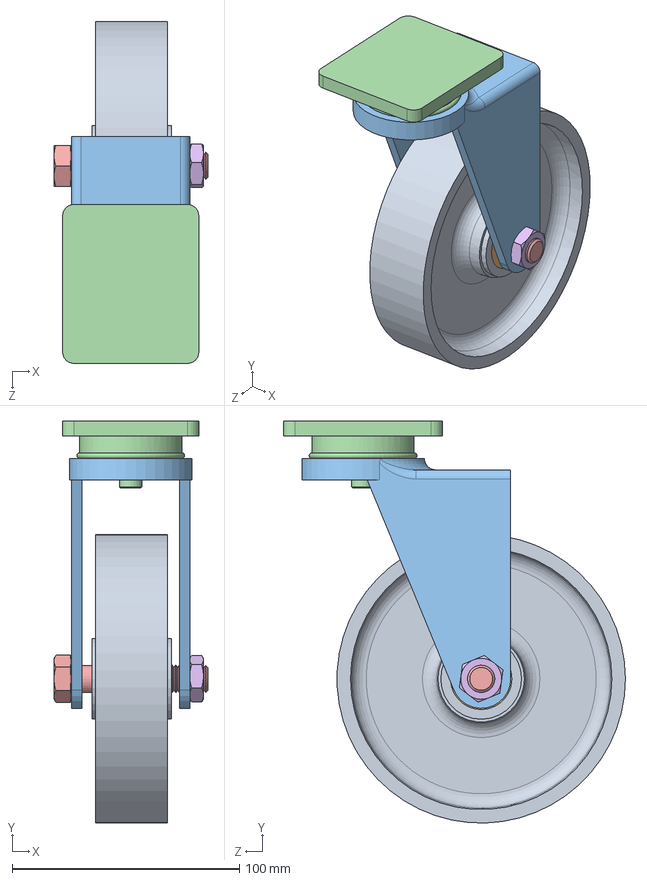
[picture p50: CAD file, 2021-04-28]
2.CADs/Flash Cart Completo Final - 28_04_2021/FLASH CART/Rodas/RodaDaFrente/MontagemDaRoda_Frente_Atualizado.SLDASM
67.8 x 177.0 x 150.5 mm
Roda_Frente_Atualizada
InteriorDaRoda_Frente_Atualizado
SuporteDaRoda_Frente_Atualizado
Rolamento
formed hex screw_am
hex nut jam_am
