Flash-Cart/Flash-Cart-Model/2.CADs/Flash Cart Completo Final - 28_04_2021/FLASH CART/Suporte inferior/parte de baixo assemb3.SLDASM

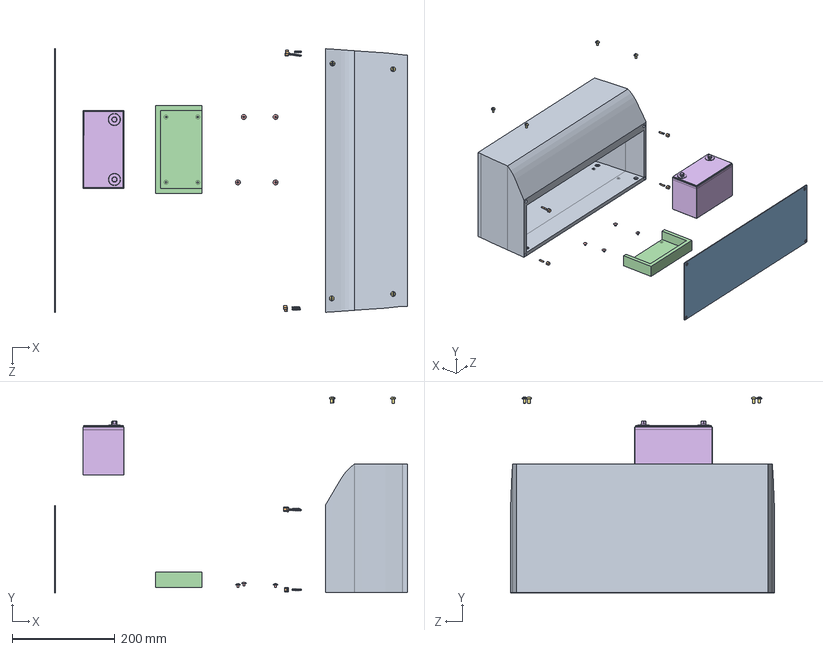
[picture p51: CAD file, 2021-04-28]
2.CADs/Flash Cart Completo Final - 28_04_2021/FLASH CART/Suporte inferior/parte de baixo assemb3.SLDASM
687.0 x 380.6 x 513.3 mm
Parte de baixo
Parafuso Sextavado M10 x 4
tampa parte de baixo
Suporte da bateria
truss head screw_ai x 4
bateria 2
pan slot head_am x 4
