Flash-Cart/Flash-Cart-Model/2.CADs/Flash Cart Completo Final - 28_04_2021/FLASH CART/Balança/Celuladecarga+placa.SLDASM

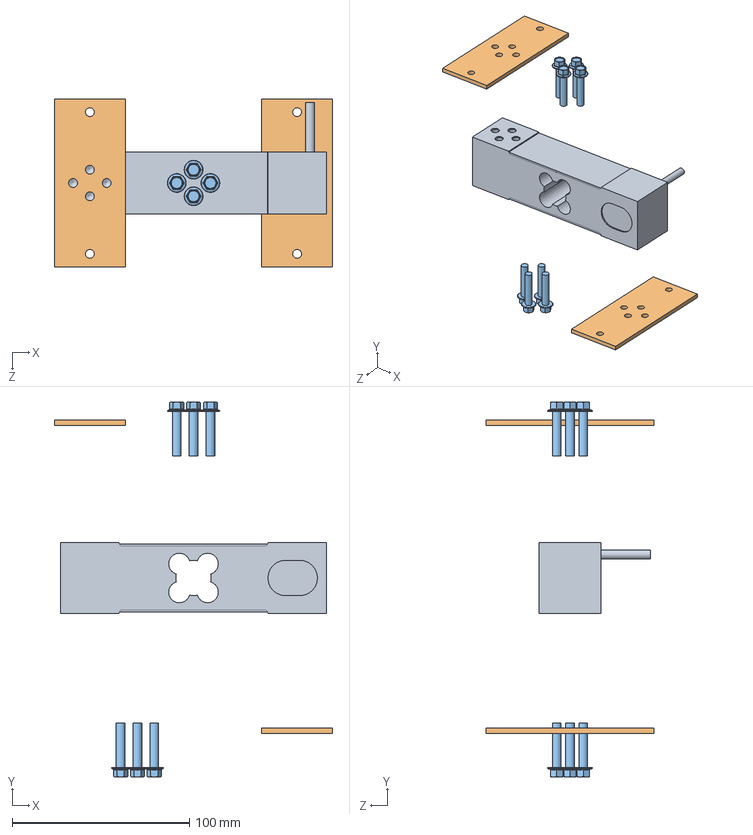
[picture p52: CAD file, 2021-04-28]
2.CADs/Flash Cart Completo Final - 28_04_2021/FLASH CART/Balança/Celuladecarga+placa.SLDASM
157.0 x 211.7 x 95.0 mm
weight_transducer_FNL
plaquinhas x 2
hex flange machine screw_am x 8
