Flash-Cart/Flash-Cart-Model/2.CADs/Flash Cart Completo Final - 28_04_2021/FLASH CART/Balança/módulo com amplificador de instrumentação hx711/HX711_SOP16.SLDASM

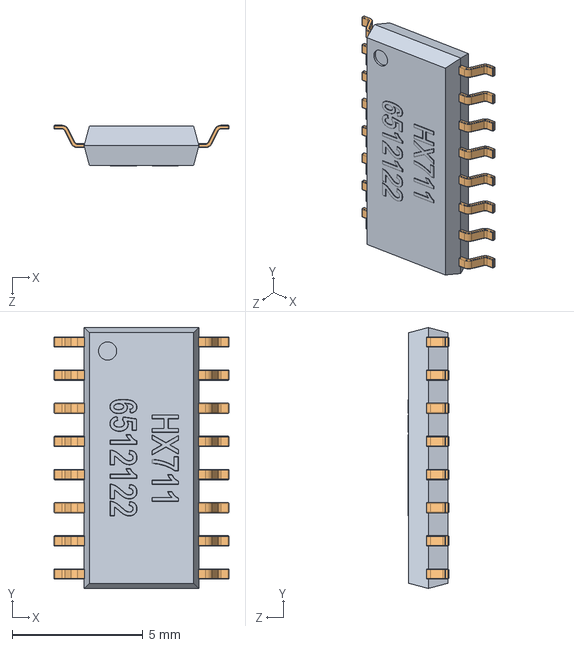
[picture p53: CAD file, 2021-04-28]
2.CADs/Flash Cart Completo Final - 28_04_2021/FLASH CART/Balança/módulo com amplificador de instrumentação hx711/HX711_SOP16.SLDASM
6.70 x 10.0 x 1.56 mm
base_HX711
pino_HX711 x 16
