Flash-Cart/Flash-Cart-Model/2.CADs/Flash Cart Completo Final - 28_04_2021/FLASH CART/Suporte superior/capa de metal para raspberry/assemb parafuso.SLDASM

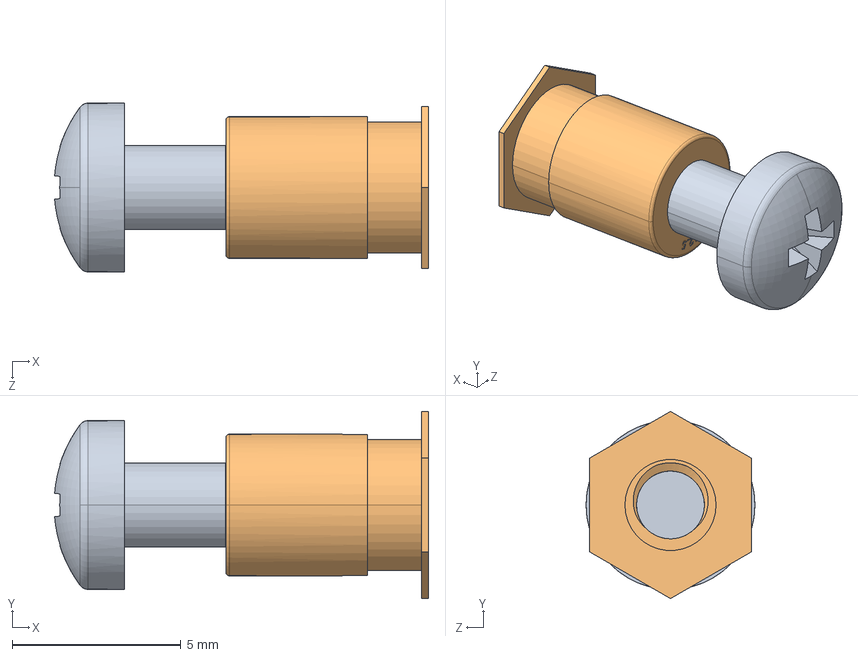
[picture p54: CAD file, 2021-04-28]
2.CADs/Flash Cart Completo Final - 28_04_2021/FLASH CART/Suporte superior/capa de metal para raspberry/assemb parafuso.SLDASM
11.1 x 5.54 x 5.00 mm
M2.5 X 4.step
Clinching Stand off M 2.5X 61.step
