Flash-Cart/Flash-Cart-Model/2.CADs/Flash Cart Completo Final - 28_04_2021/FLASH CART/Toten de carregamento/assembly do slot5.SLDASM

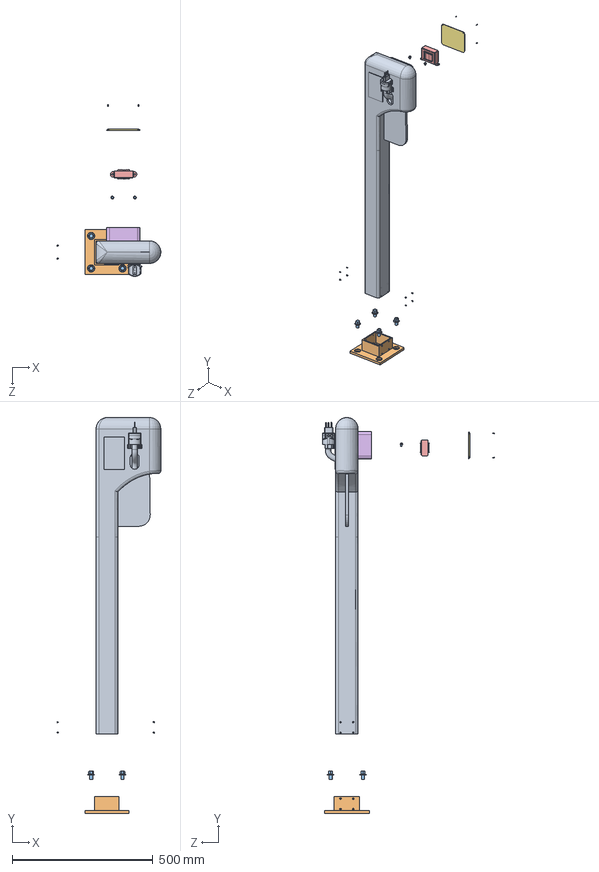
[picture p55: CAD file, 2021-04-28]
2.CADs/Flash Cart Completo Final - 28_04_2021/FLASH CART/Toten de carregamento/assembly do slot5.SLDASM
368.6 x 1407.1 x 610.7 mm
Carcaça
Suporte chao
hex flange machine screw_am x 6
countersunk slotted raised head screw_iso x 8
Transformer
caixa do transformador
tampa da caixa do transformador
pan cross head_am x 4
