Flash-Cart/Flash-Cart-Model/2.CADs/Flash Cart Completo Final - 28_04_2021/FLASH CART/Componentes Eletronicos/hcsr04/HC-SR04.SLDASM

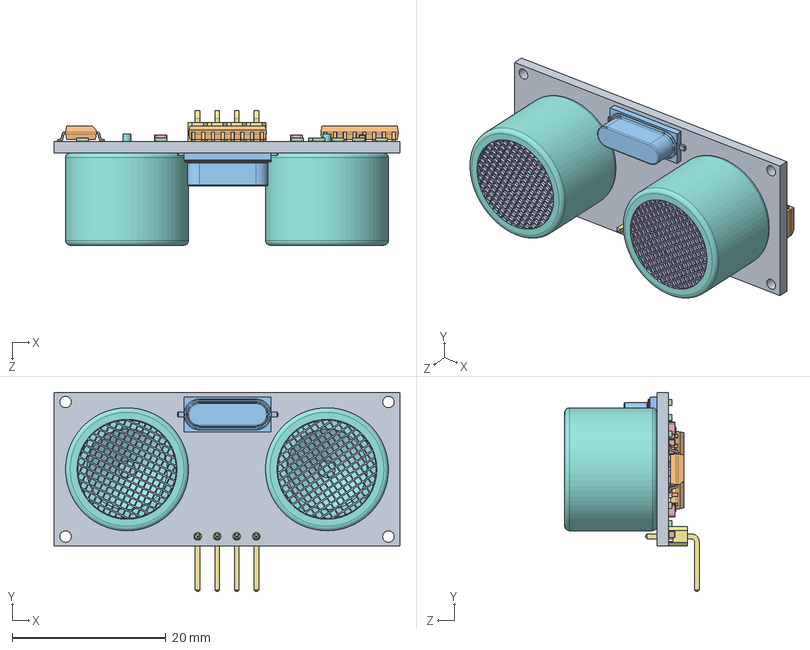
[picture p56: CAD file, 2021-04-28]
2.CADs/Flash Cart Completo Final - 28_04_2021/FLASH CART/Componentes Eletronicos/hcsr04/HC-SR04.SLDASM
45.0 x 25.9 x 17.5 mm
BoardHCSR04
SOIC16 narrow x 3
Crystal Oscillator (SMD)
RES 0603 x 17
0603 Capacitor x 7
PLS-4R (DS-1022-1x4)
Transmitter
