Flash-Cart/Flash-Cart-Model/2.CADs/Flash Cart Completo Final - 28_04_2021/FLASH CART/Balança/montagem_load cell.SLDASM

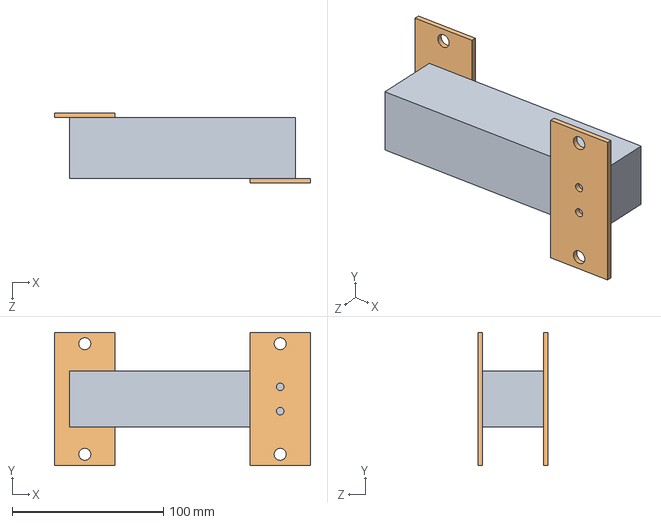
[picture p57: CAD file, 2021-04-28]
2.CADs/Flash Cart Completo Final - 28_04_2021/FLASH CART/Balança/montagem_load cell.SLDASM
169.0 x 88.0 x 46.0 mm
load_cell
plaquinhas x 2
