Flash-Cart/Flash-Cart-Model/2.CADs/Flash Cart Completo Final - 28_04_2021/FLASH CART/Rodas/Roda/MontagemDaRoda_Atualizado_Direita.SLDASM

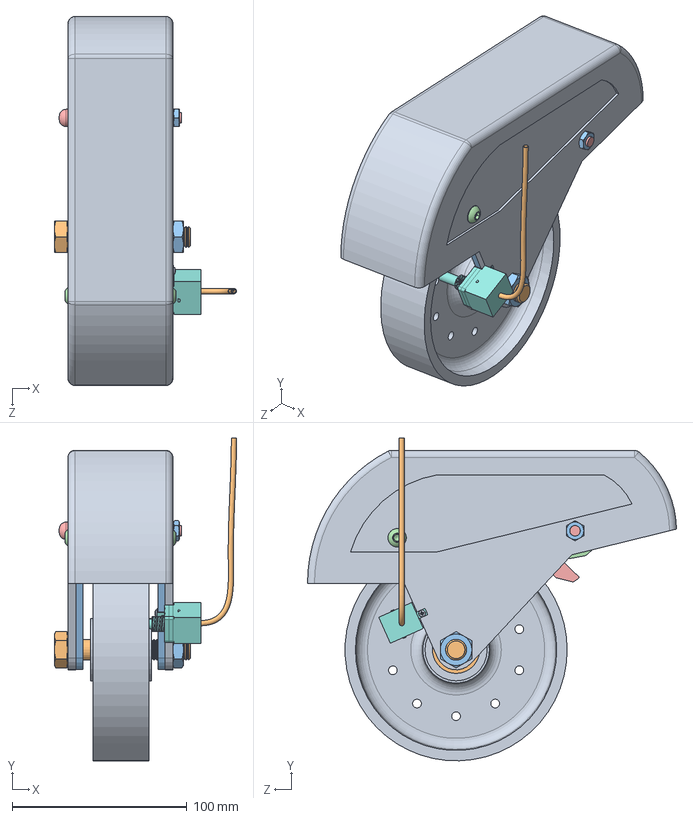
[picture p58: CAD file, 2021-04-28]
2.CADs/Flash Cart Completo Final - 28_04_2021/FLASH CART/Rodas/Roda/MontagemDaRoda_Atualizado_Direita.SLDASM
104.2 x 184.4 x 210.9 mm
Roda_Atualizada
InteriorDaRoda_Atualizado
SuporteDaRoda_Atualizado
Trava_Atualizado
Freio_Atualizado
EXTENSION_10404_50MM.stp
CLAMSHELL_BOT_10417.stp
CLAMSHELL_TOP_10416.stp
FASTENER_10427.stp x 4
GUIDE_10429.stp
NUT_10419.stp
GROMMET_3_HOLE.stp
AsteDe50mm_Atualizado
Pino_Atualizado
CapaDoSuporteDaRoda_Atualizado
formed hex screw_am
hex nut jam_am x 4
socket button head cap screw_am x 4
Parafuso_M6_60mm
BracadeiraAtuador
hex nut style 2_am x 2
Encoder
binding head screw_ai.1 x 2
cabo
