Flash-Cart/Flash-Cart-Model/2.CADs/Flash Cart Completo Final - 28_04_2021/FLASH CART/Suporte superior/Ensamble_soporte.SLDASM

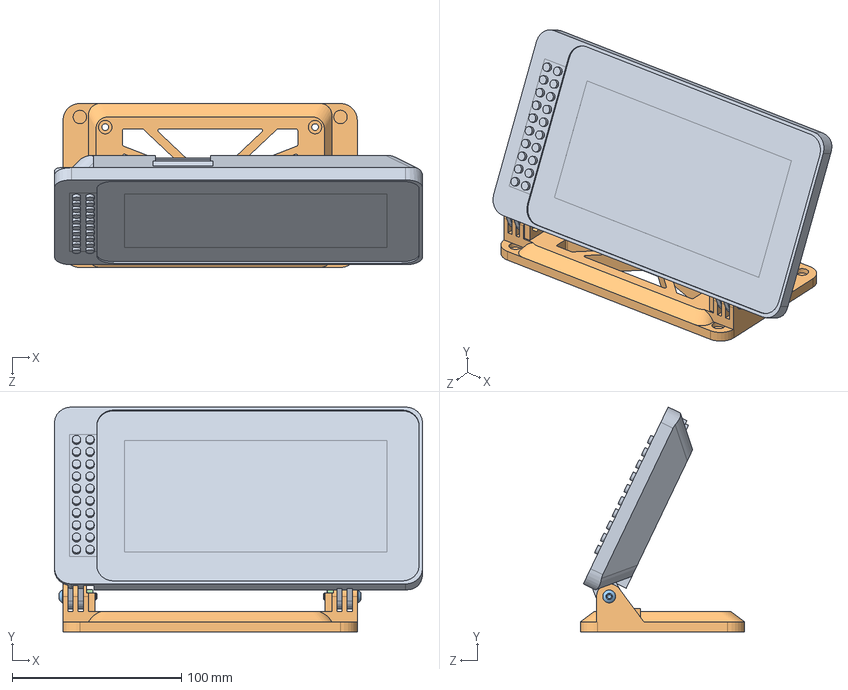
[picture p59: CAD file, 2021-04-28]
2.CADs/Flash Cart Completo Final - 28_04_2021/FLASH CART/Suporte superior/Ensamble_soporte.SLDASM
217.5 x 132.9 x 97.0 mm
DISPLAY
Base
socket button head cap screw_am x 2
hex nut style 2_am x 2
