Flash-Cart/Flash-Cart-Model/2.CADs/Flash Cart Completo Final - 28_04_2021/FLASH CART/Balança/Montagem_Balanca_manual5.SLDASM

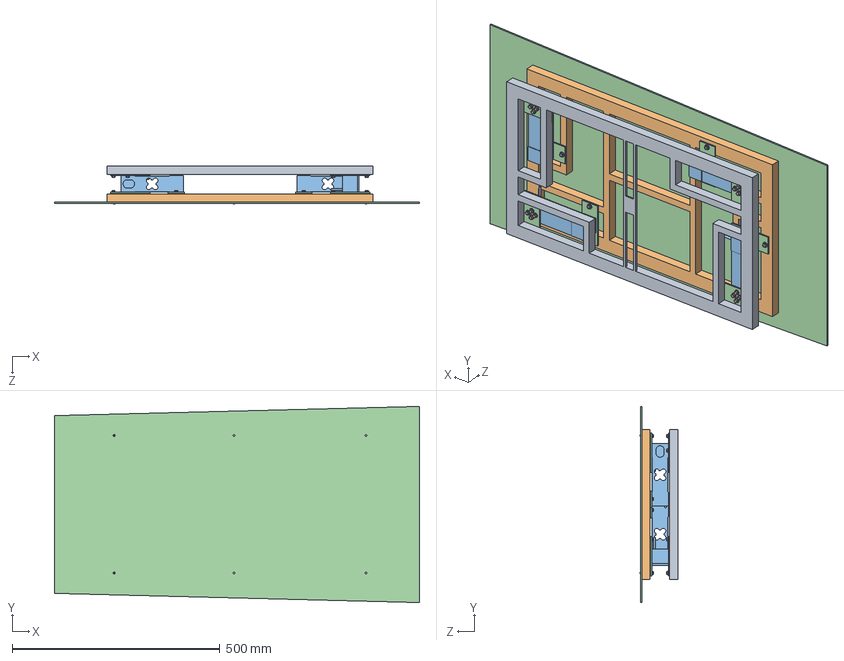
[picture p60: CAD file, 2021-04-28]
2.CADs/Flash Cart Completo Final - 28_04_2021/FLASH CART/Balança/Montagem_Balanca_manual5.SLDASM
877.9 x 471.8 x 91.2 mm
armacao_inferior_balanca
armacao_superior_balanca
weight_transducer_FNL x 4
plaquinhas x 8
hex flange machine screw_am x 32
hex flange head tapping screw_am x 16
placa_Valor predeterminado.STEP
RESISTOR_SMD_122_Valor predeterminado.STEP x 2
RESISTOR_SMD_822_Valor predeterminado.STEP
RESISTOR_SMD_203_Valor predeterminado.STEP
CAPACITOR_805_Valor predeterminado.STEP x 5
prato
90031A113_PHILLIPS FLAT HEAD SCREWS FOR WOOD x 6
