Flash-Cart/Flash-Cart-Model/2.CADs/Flash Cart Completo Final - 28_04_2021/FLASH CART/Balança/módulo com amplificador de instrumentação hx711/SOT23.SLDASM

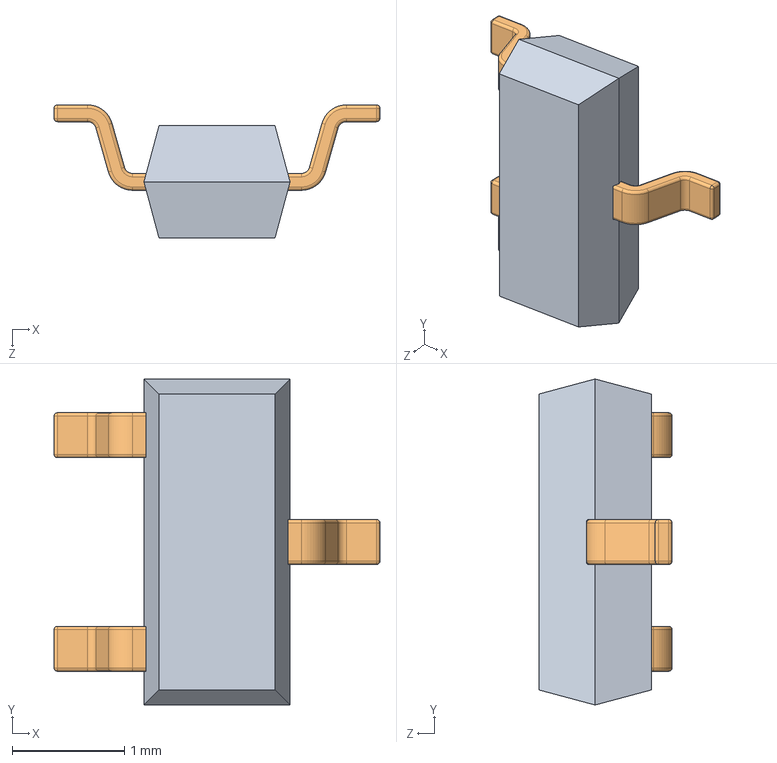
[picture p62: CAD file, 2021-04-28]
2.CADs/Flash Cart Completo Final - 28_04_2021/FLASH CART/Balança/módulo com amplificador de instrumentação hx711/SOT23.SLDASM
2.90 x 2.90 x 1.19 mm
TRANSISTOR_SOT23
PINO_SOT23 x 3
