Flash-Cart/Flash-Cart-Model/2.CADs/Flash Cart Completo Final - 28_04_2021/FLASH CART/Rodas/Roda/Atuador50mmAtualizado.SLDASM

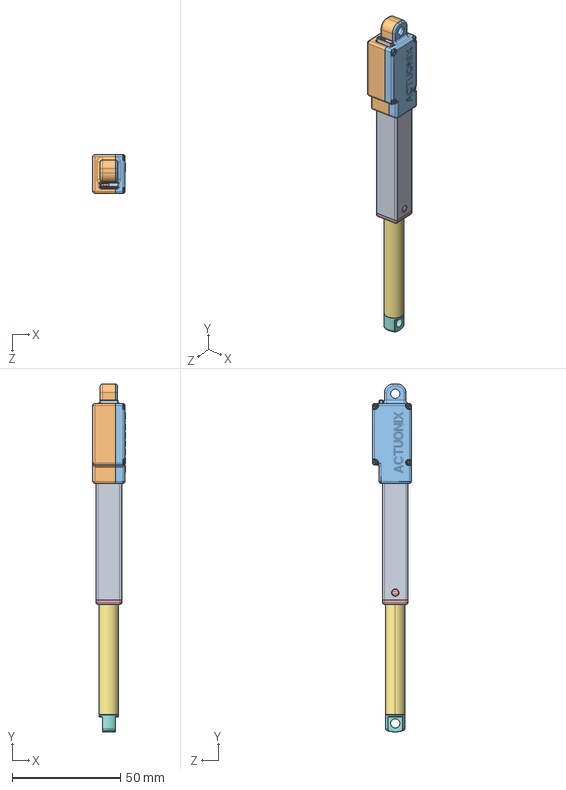
[picture p63: CAD file, 2021-04-28]
2.CADs/Flash Cart Completo Final - 28_04_2021/FLASH CART/Rodas/Roda/Atuador50mmAtualizado.SLDASM
15.1 x 161.0 x 18.0 mm
EXTENSION_10404_50MM.stp
CLAMSHELL_BOT_10417.stp
CLAMSHELL_TOP_10416.stp
FASTENER_10427.stp x 4
GUIDE_10429.stp
NUT_10419.stp
GROMMET_3_HOLE.stp
