Flash-Cart/Flash-Cart-Model/2.CADs/Flash Cart Completo Final - 28_04_2021/FLASH CART/Balança/plaquinhas.SLDPRT

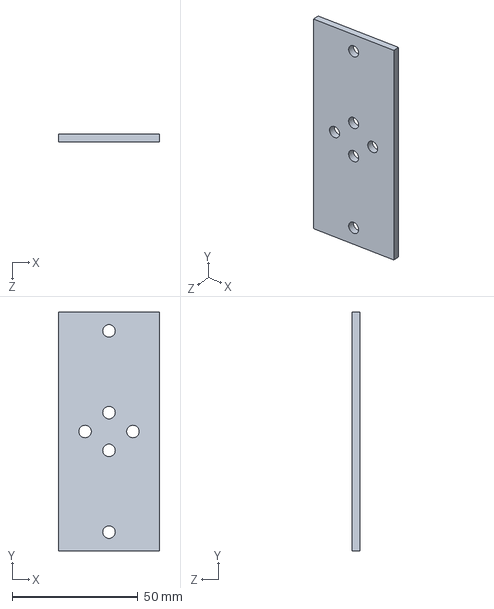
[picture p66: CAD file, 2021-04-28]
2.CADs/Flash Cart Completo Final - 28_04_2021/FLASH CART/Balança/plaquinhas.SLDPRT
40.0 x 95.0 x 3.00 mm
