Flash-Cart/Flash-Cart-Model/2.CADs/Flash Cart Completo Final - 28_04_2021/FLASH CART/Balança/platform-scale-load-cell-350kg-200kg-100kg-60kg-1.snapshot.9/weight_transducer_FNL.SLDPRT

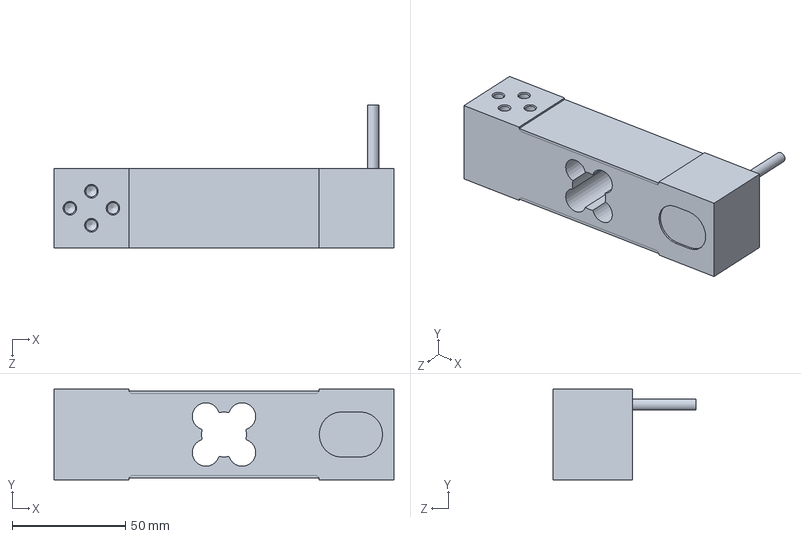
[picture p67: CAD file, 2021-04-28]
2.CADs/Flash Cart Completo Final - 28_04_2021/FLASH CART/Balança/platform-scale-load-cell-350kg-200kg-100kg-60kg-1.snapshot.9/weight_transducer_FNL.SLDPRT
150.0 x 40.0 x 63.0 mm
