Flash-Cart/Flash-Cart-Model/2.CADs/Flash Cart Completo Final - 28_04_2021/FLASH CART/Cesta/Cesta_Atualizada.SLDPRT

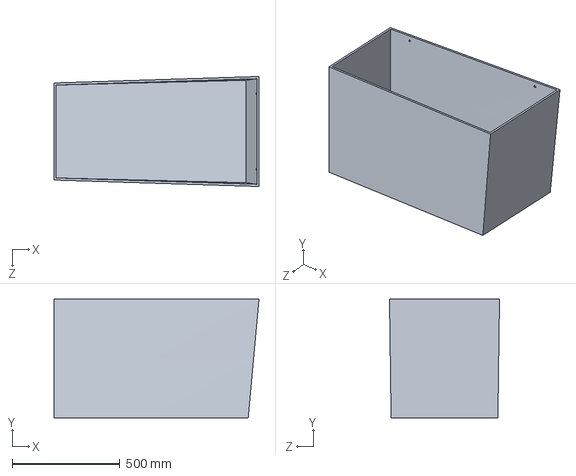
[picture p68: CAD file, 2021-04-28]
2.CADs/Flash Cart Completo Final - 28_04_2021/FLASH CART/Cesta/Cesta_Atualizada.SLDPRT
950.0 x 550.0 x 510.0 mm
