Flash-Cart/Flash-Cart-Model/2.CADs/Flash Cart Completo Final - 28_04_2021/FLASH CART/Chassi/Chassi8_Frente_Meio_Direita_Atualizado.SLDPRT

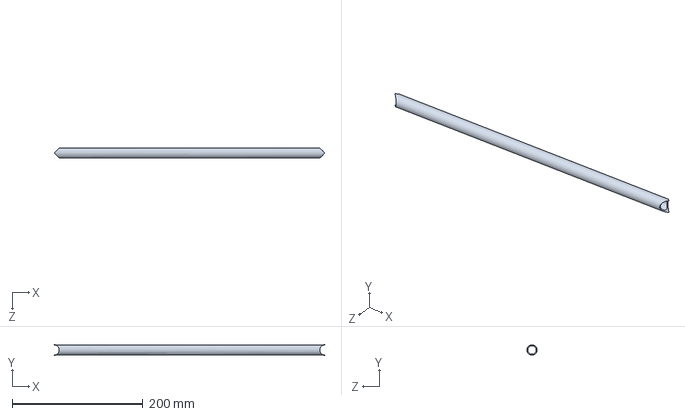
[picture p69: CAD file, 2021-04-28]
2.CADs/Flash Cart Completo Final - 28_04_2021/FLASH CART/Chassi/Chassi8_Frente_Meio_Direita_Atualizado.SLDPRT
415.0 x 15.9 x 15.9 mm
