Flash-Cart/Flash-Cart-Model/2.CADs/Flash Cart Completo Final - 28_04_2021/FLASH CART/Plugue/plugue.SLDPRT

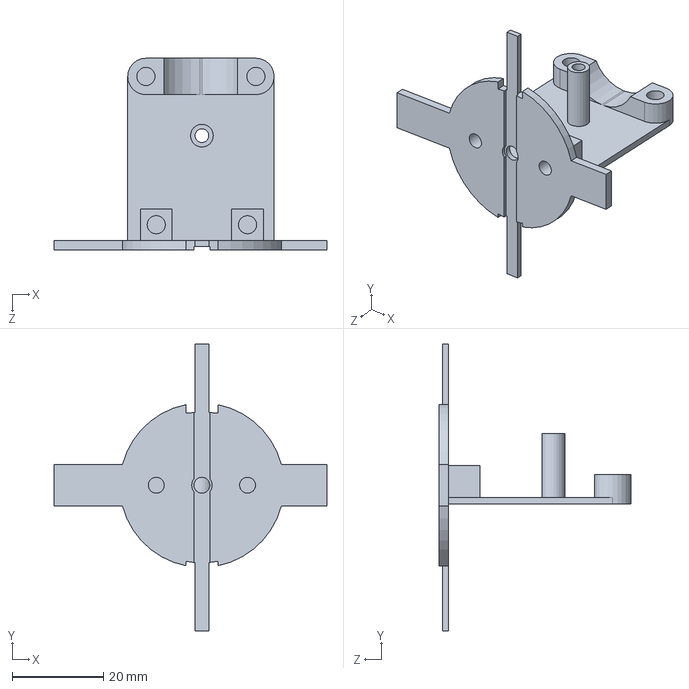
[picture p70: CAD file, 2021-04-28]
2.CADs/Flash Cart Completo Final - 28_04_2021/FLASH CART/Plugue/plugue.SLDPRT
59.8 x 62.9 x 42.0 mm
