Flash-Cart/Flash-Cart-Model/2.CADs/Flash Cart Completo Final - 28_04_2021/FLASH CART/Rodas/Roda/cabo.SLDPRT

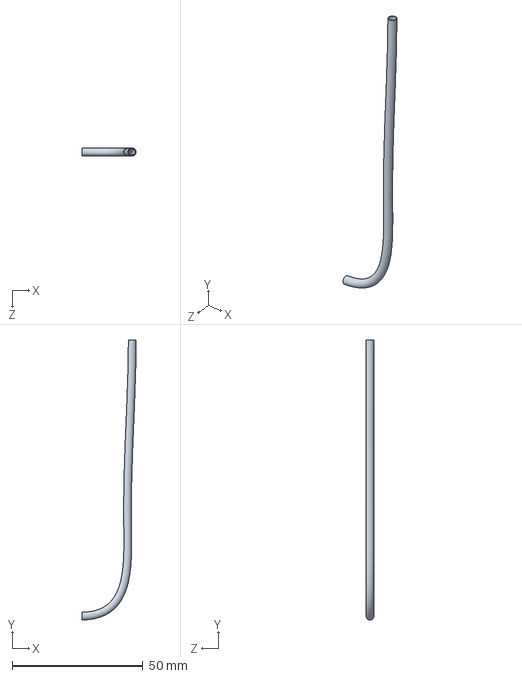
[picture p71: CAD file, 2021-04-28]
2.CADs/Flash Cart Completo Final - 28_04_2021/FLASH CART/Rodas/Roda/cabo.SLDPRT
20.8 x 107.2 x 3.00 mm
