Flash-Cart/Flash-Cart-Model/2.CADs/Flash Cart Completo Final - 28_04_2021/FLASH CART/Rodas/RodaDaFrente/SuporteDaRoda_Frente_Atualizado.SLDPRT

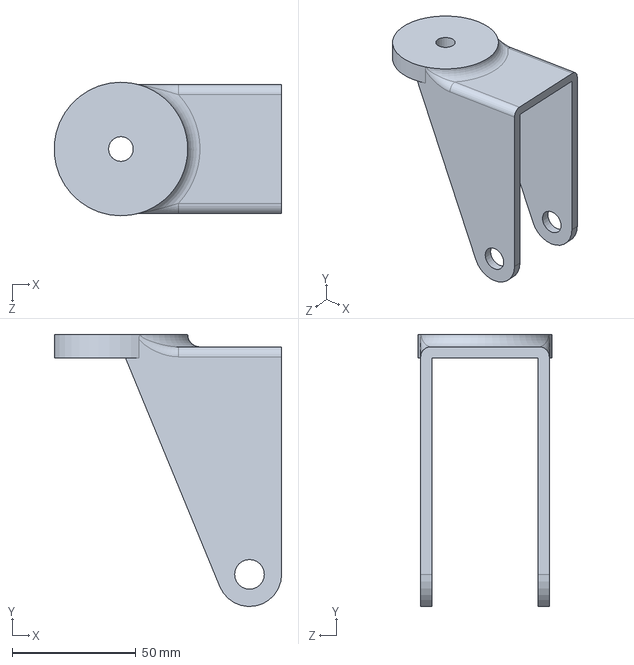
[picture p72: CAD file, 2021-04-28]
2.CADs/Flash Cart Completo Final - 28_04_2021/FLASH CART/Rodas/RodaDaFrente/SuporteDaRoda_Frente_Atualizado.SLDPRT
91.9 x 110.0 x 54.0 mm
