Flash-Cart/Flash-Cart-Model/2.CADs/Flash Cart Completo Final - 28_04_2021/FLASH CART/Suporte inferior/tampa parte de baixo.SLDPRT

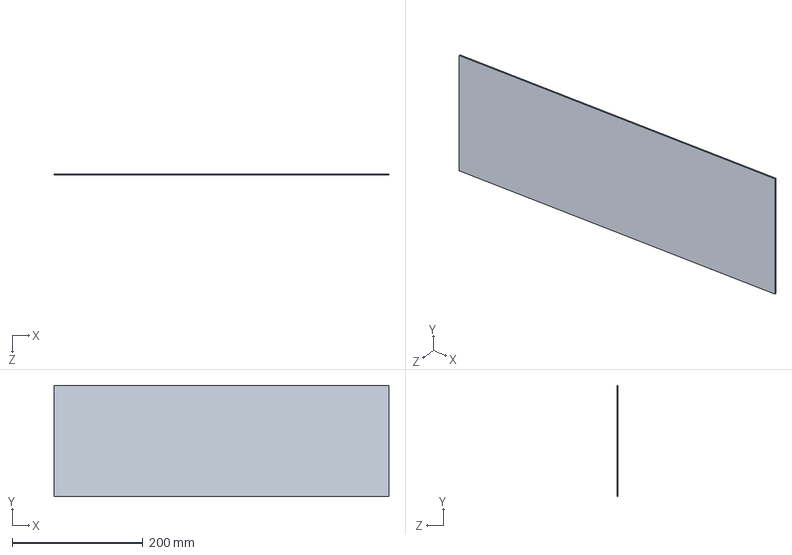
[picture p73: CAD file, 2021-04-28]
2.CADs/Flash Cart Completo Final - 28_04_2021/FLASH CART/Suporte inferior/tampa parte de baixo.SLDPRT
513.2 x 170.3 x 2.00 mm
