Flash-Cart/Flash-Cart-Model/2.CADs/Flash Cart Completo Final - 28_04_2021/FLASH CART/Suporte superior/capa de metal para raspberry/M3 x 5.STEP

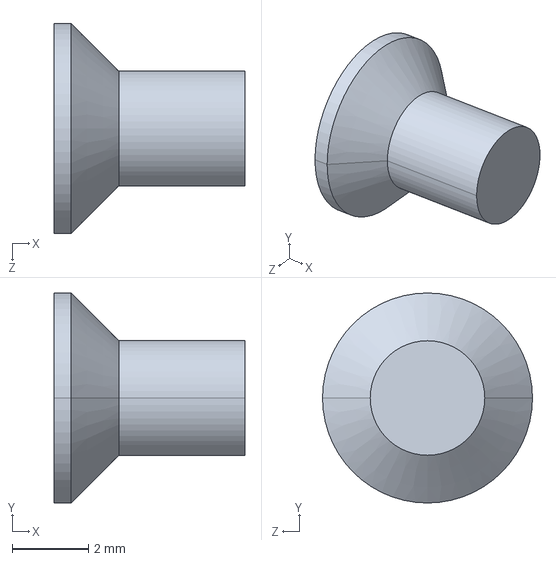
[picture p74: CAD file, 2021-04-28]
2.CADs/Flash Cart Completo Final - 28_04_2021/FLASH CART/Suporte superior/capa de metal para raspberry/M3 x 5.STEP
5.00 x 5.50 x 5.50 mm
