Flash-Cart/Flash-Cart-Model/2.CADs/Flash Cart Completo Final - 28_04_2021/FLASH CART/Suporte superior/Parafuso Sextavado M10.SLDPRT

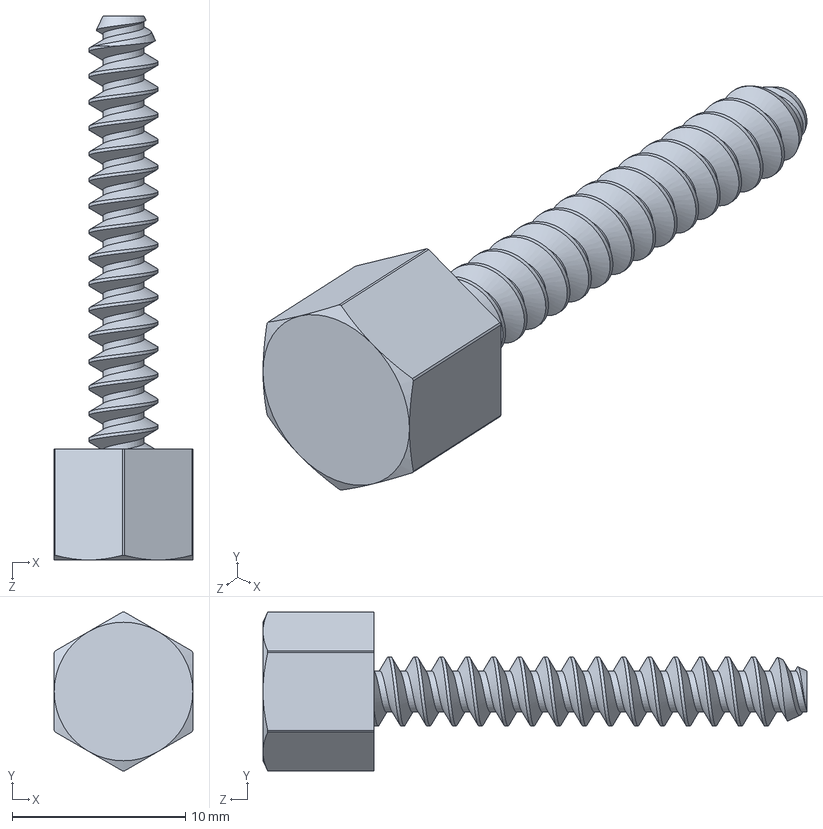
[picture p75: CAD file, 2021-04-28]
2.CADs/Flash Cart Completo Final - 28_04_2021/FLASH CART/Suporte superior/Parafuso Sextavado M10.SLDPRT
8.00 x 9.18 x 31.4 mm
