Flash-Cart/Flash-Cart-Model/2.CADs/Flash Cart Completo Final - 28_04_2021/FLASH CART/Toten de carregamento/pan cross head_am.SLDPRT

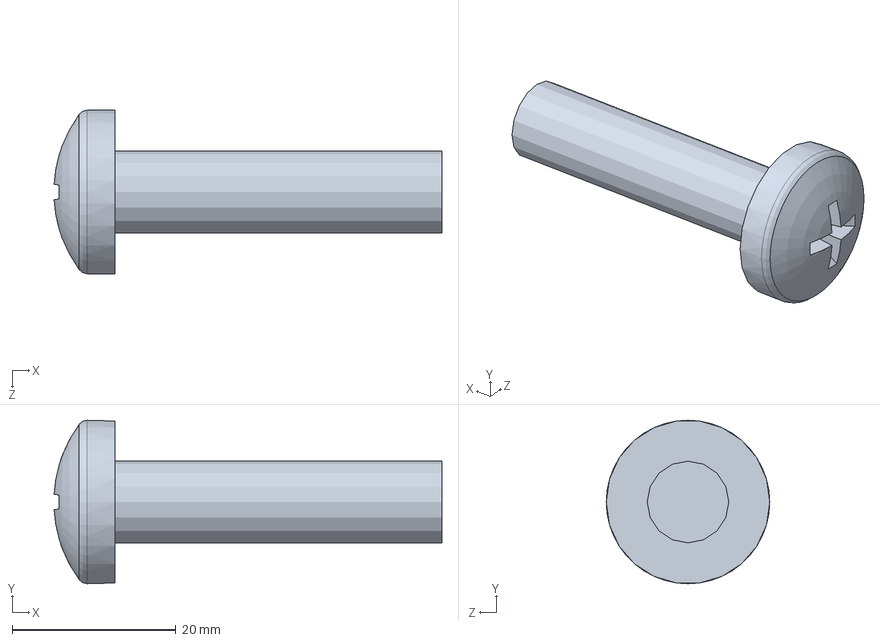
[picture p76: CAD file, 2021-04-28]
2.CADs/Flash Cart Completo Final - 28_04_2021/FLASH CART/Toten de carregamento/pan cross head_am.SLDPRT
47.4 x 20.0 x 20.0 mm
