Flash-Cart/Flash-Cart-Model/2.CADs/Flash Cart Completo Final - 28_04_2021/FLASH CART/Cesta/SuporteEletronica_Atualizado.SLDPRT

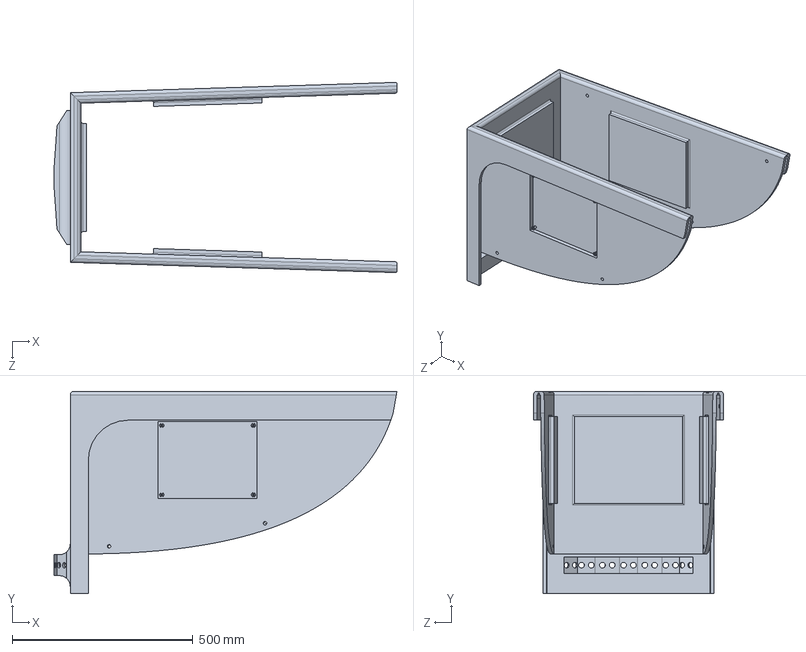
[picture p80: CAD file, 2021-04-28]
2.CADs/Flash Cart Completo Final - 28_04_2021/FLASH CART/Cesta/SuporteEletronica_Atualizado.SLDPRT
949.0 x 560.0 x 526.4 mm
