Flash-Cart/Flash-Cart-Model/2.CADs/Flash Cart Completo Final - 28_04_2021/FLASH CART/Componentes Eletronicos/Antena RFID AN610.SLDPRT

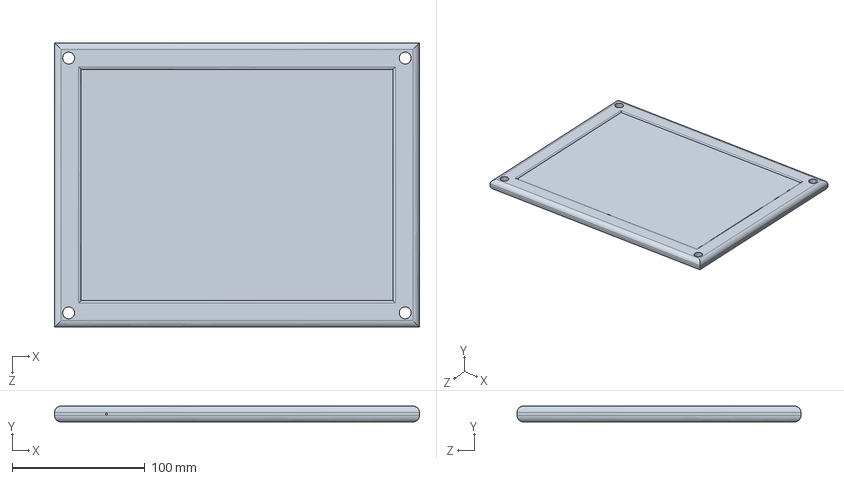
[picture p81: CAD file, 2021-04-28]
2.CADs/Flash Cart Completo Final - 28_04_2021/FLASH CART/Componentes Eletronicos/Antena RFID AN610.SLDPRT
275.0 x 12.0 x 214.0 mm
