Flash-Cart/Flash-Cart-Model/2.CADs/Flash Cart Completo Final - 28_04_2021/FLASH CART/Rodas/Roda/SuporteDaRoda_Atualizado.SLDPRT

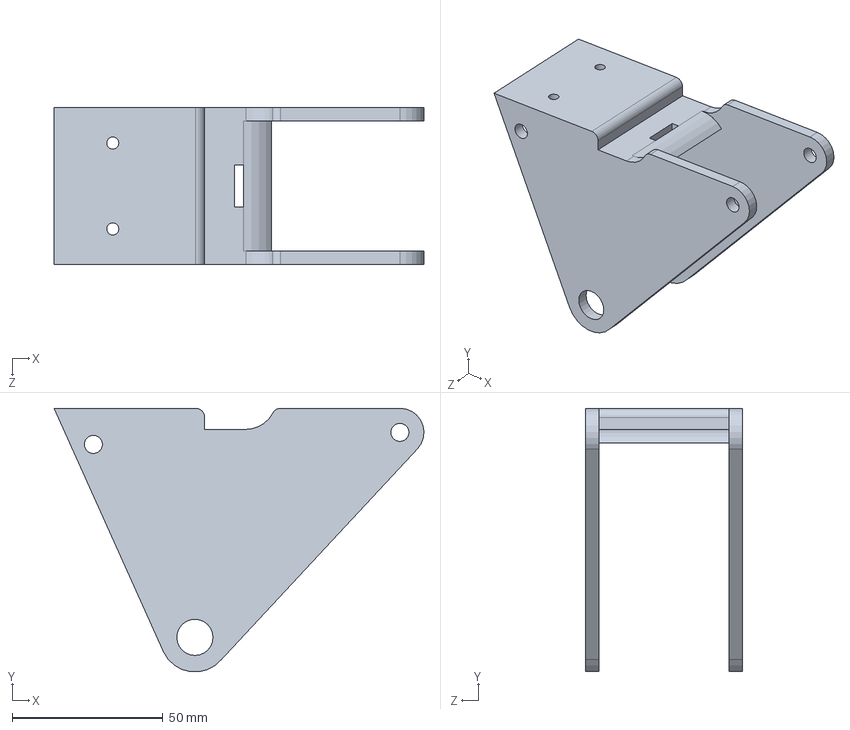
[picture p82: CAD file, 2021-04-28]
2.CADs/Flash Cart Completo Final - 28_04_2021/FLASH CART/Rodas/Roda/SuporteDaRoda_Atualizado.SLDPRT
122.7 x 87.4 x 52.0 mm
