Flash-Cart/Flash-Cart-Model/2.CADs/Flash Cart Completo Final - 28_04_2021/FLASH CART/Suporte superior/capa de metal para raspberry/M2.5 X 4.STEP

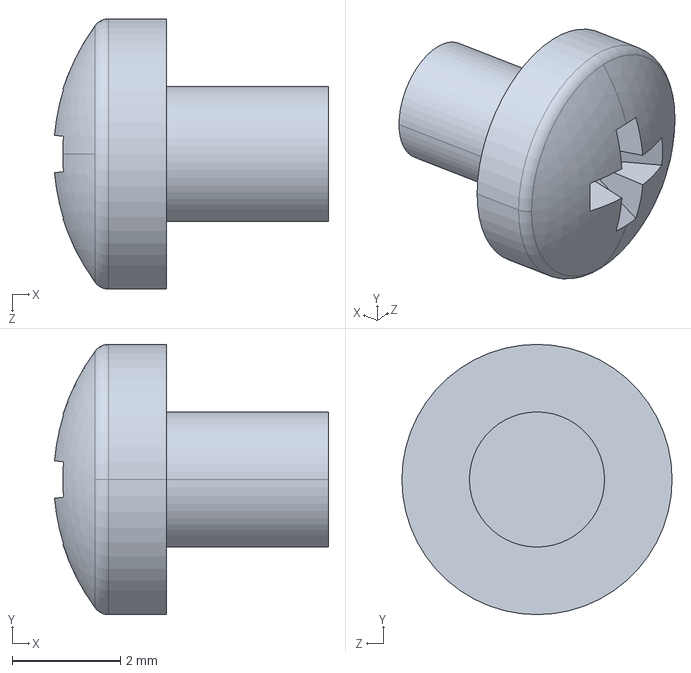
[picture p83: CAD file, 2021-04-28]
2.CADs/Flash Cart Completo Final - 28_04_2021/FLASH CART/Suporte superior/capa de metal para raspberry/M2.5 X 4.STEP
5.07 x 5.00 x 5.00 mm
