Flash-Cart/Flash-Cart-Model/2.CADs/Flash Cart Completo Final - 28_04_2021/FLASH CART/Suporte superior/tampa de baixo.SLDPRT

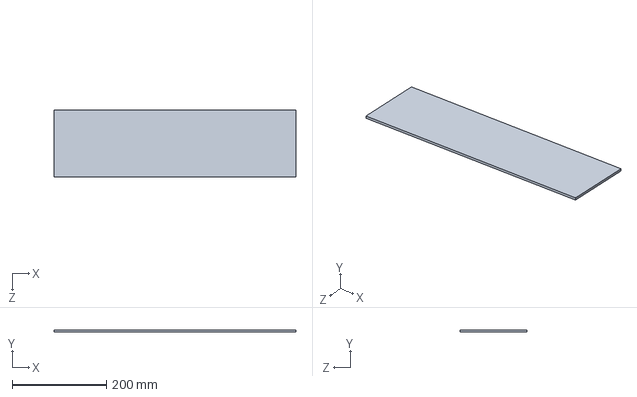
[picture p85: CAD file, 2021-04-28]
2.CADs/Flash Cart Completo Final - 28_04_2021/FLASH CART/Suporte superior/tampa de baixo.SLDPRT
512.8 x 5.00 x 142.5 mm
