Flash-Cart/Flash-Cart-Model/2.CADs/Flash Cart Completo Final - 28_04_2021/FLASH CART/Toten de carregamento/tampa da caixa do transformador.SLDPRT

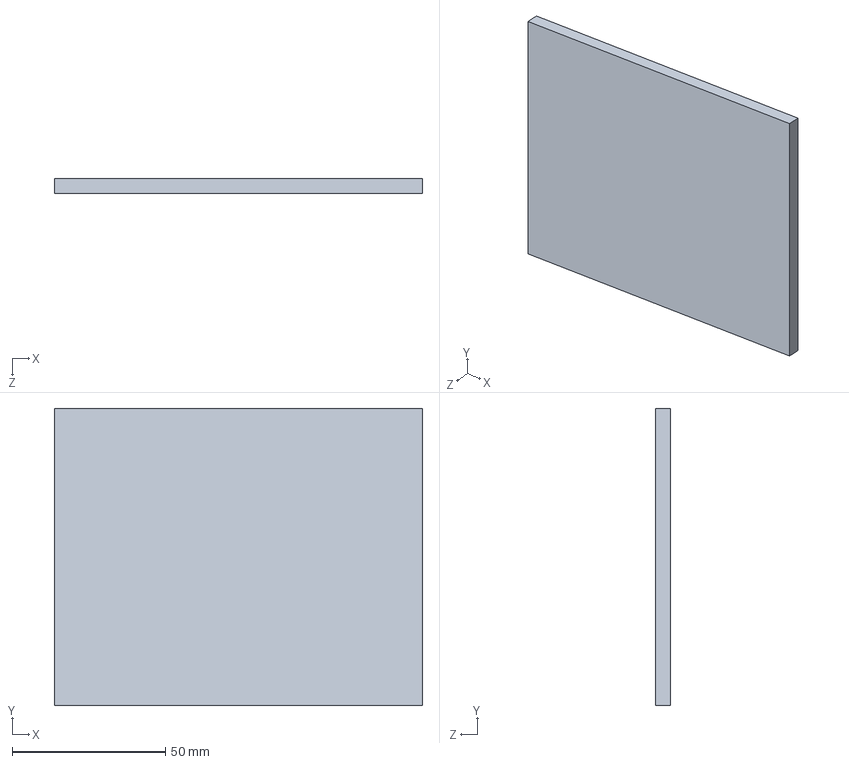
[picture p86: CAD file, 2021-04-28]
2.CADs/Flash Cart Completo Final - 28_04_2021/FLASH CART/Toten de carregamento/tampa da caixa do transformador.SLDPRT
120.0 x 97.0 x 5.00 mm
