Flash-Cart/Flash-Cart-Model/2.CADs/Flash Cart Completo Final - 28_04_2021/FLASH CART/Balança/módulo com amplificador de instrumentação hx711/pino_HX711.SLDPRT

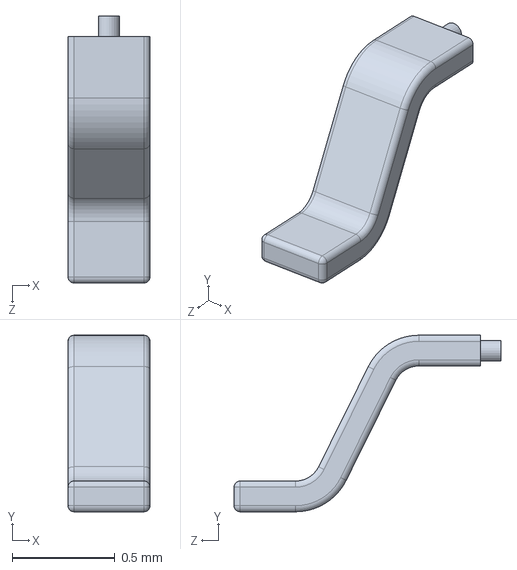
[picture p87: CAD file, 2021-04-28]
2.CADs/Flash Cart Completo Final - 28_04_2021/FLASH CART/Balança/módulo com amplificador de instrumentação hx711/pino_HX711.SLDPRT
0.4 x 0.86 x 1.30 mm
