Flash-Cart/Flash-Cart-Model/2.CADs/Flash Cart Completo Final - 28_04_2021/FLASH CART/Cesta/SuporteDeEletronica_Tras_Atualizado.SLDPRT

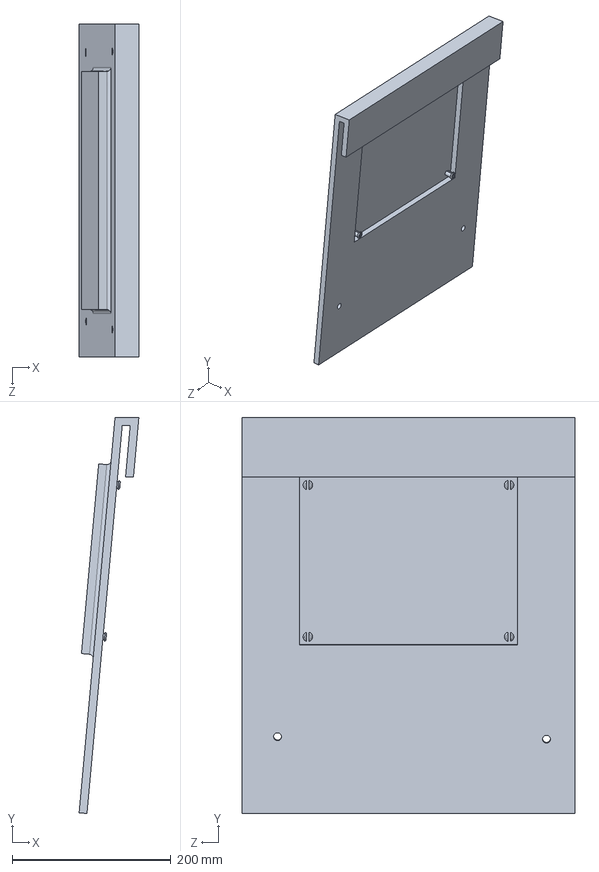
[picture p88: CAD file, 2021-04-28]
2.CADs/Flash Cart Completo Final - 28_04_2021/FLASH CART/Cesta/SuporteDeEletronica_Tras_Atualizado.SLDPRT
75.4 x 498.9 x 420.0 mm
