Flash-Cart/Flash-Cart-Model/2.CADs/Flash Cart Completo Final - 28_04_2021/FLASH CART/Chassi/Chassi9_Meio_Tras_Esquerda_Atualizado.SLDPRT

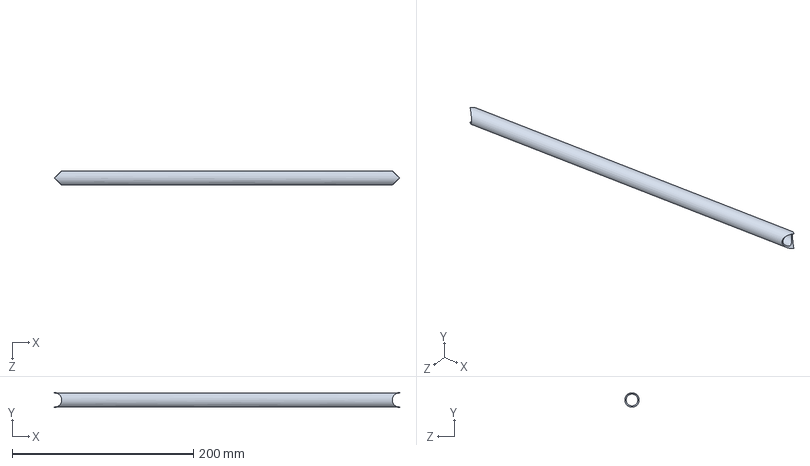
[picture p89: CAD file, 2021-04-28]
2.CADs/Flash Cart Completo Final - 28_04_2021/FLASH CART/Chassi/Chassi9_Meio_Tras_Esquerda_Atualizado.SLDPRT
380.8 x 15.9 x 15.9 mm
