Flash-Cart/Flash-Cart-Model/2.CADs/Flash Cart Completo Final - 28_04_2021/FLASH CART/Componentes Eletronicos/hcsr04/RES 0603.SLDPRT

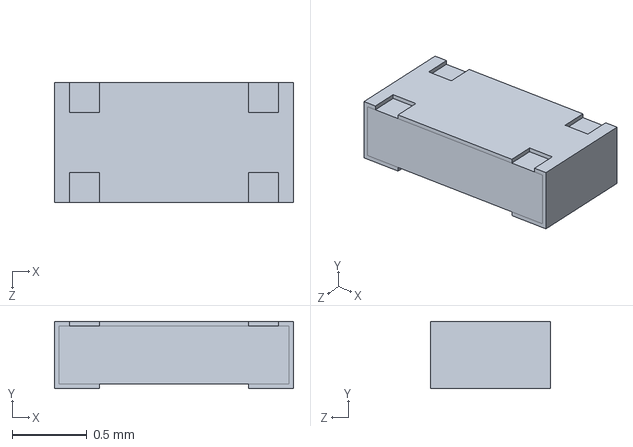
[picture p90: CAD file, 2021-04-28]
2.CADs/Flash Cart Completo Final - 28_04_2021/FLASH CART/Componentes Eletronicos/hcsr04/RES 0603.SLDPRT
1.60 x 0.45 x 0.8 mm
