Flash-Cart/Flash-Cart-Model/2.CADs/Flash Cart Completo Final - 28_04_2021/FLASH CART/Rodas/Roda/Freio_Atualizado.SLDPRT

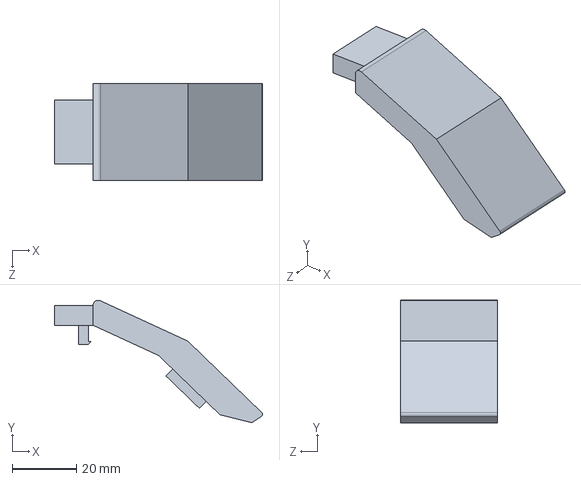
[picture p92: CAD file, 2021-04-28]
2.CADs/Flash Cart Completo Final - 28_04_2021/FLASH CART/Rodas/Roda/Freio_Atualizado.SLDPRT
64.7 x 38.1 x 30.0 mm
