Flash-Cart/Flash-Cart-Model/2.CADs/Flash Cart Completo Final - 28_04_2021/FLASH CART/Rodas/RodaDaFrente/Rolamento.SLDPRT

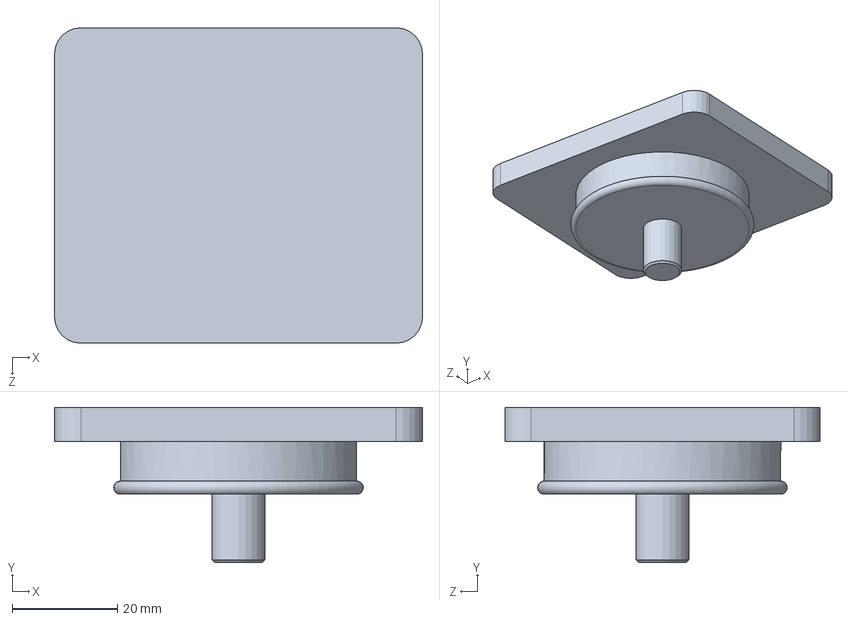
[picture p93: CAD file, 2021-04-28]
2.CADs/Flash Cart Completo Final - 28_04_2021/FLASH CART/Rodas/RodaDaFrente/Rolamento.SLDPRT
70.0 x 29.5 x 60.0 mm
