Flash-Cart/Flash-Cart-Model/2.CADs/Flash Cart Completo Final - 28_04_2021/FLASH CART/Suporte inferior/Parte de baixo com furo.SLDPRT

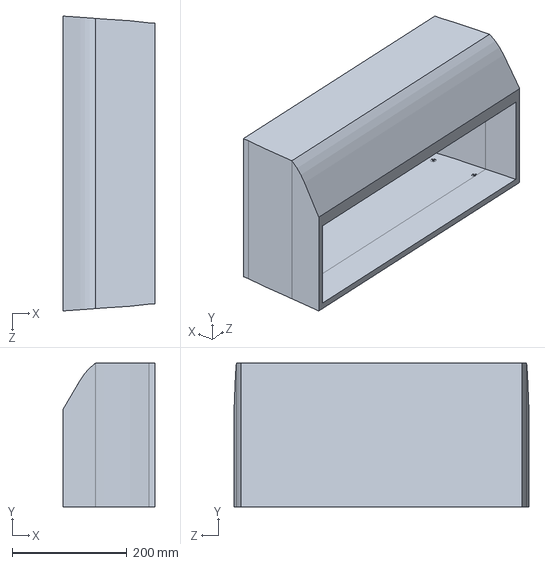
[picture p94: CAD file, 2021-04-28]
2.CADs/Flash Cart Completo Final - 28_04_2021/FLASH CART/Suporte inferior/Parte de baixo com furo.SLDPRT
159.9 x 250.6 x 513.2 mm
