Flash-Cart/Flash-Cart-Model/2.CADs/Flash Cart Completo Final - 28_04_2021/FLASH CART/Suporte superior/capa de metal para raspberry/Base.STEP

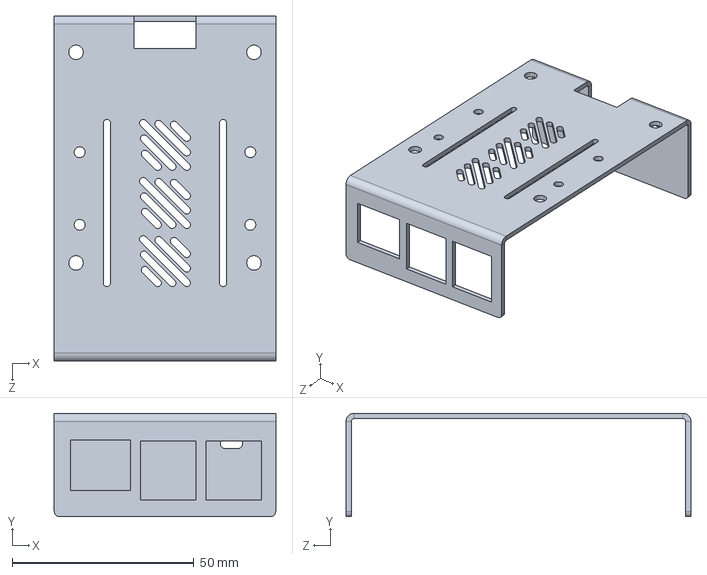
[picture p95: CAD file, 2021-04-28]
2.CADs/Flash Cart Completo Final - 28_04_2021/FLASH CART/Suporte superior/capa de metal para raspberry/Base.STEP
61.0 x 28.5 x 95.0 mm
