Flash-Cart/Flash-Cart-Model/2.CADs/Flash Cart Completo Final - 28_04_2021/FLASH CART/Suporte superior/tampa de trás.SLDPRT

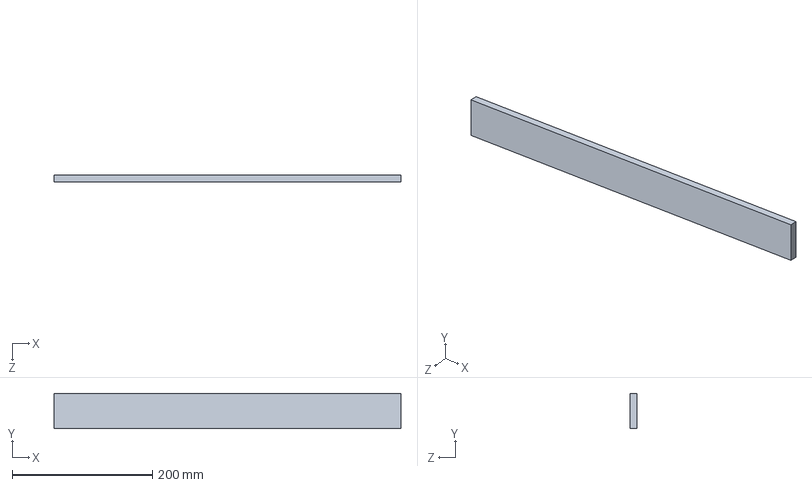
[picture p97: CAD file, 2021-04-28]
2.CADs/Flash Cart Completo Final - 28_04_2021/FLASH CART/Suporte superior/tampa de trás.SLDPRT
495.0 x 50.0 x 10.0 mm
