Flash-Cart/Flash-Cart-Model/2.CADs/Flash Cart Completo Final - 28_04_2021/FLASH CART/Toten de carregamento/pipe holder 32mm.SLDPRT

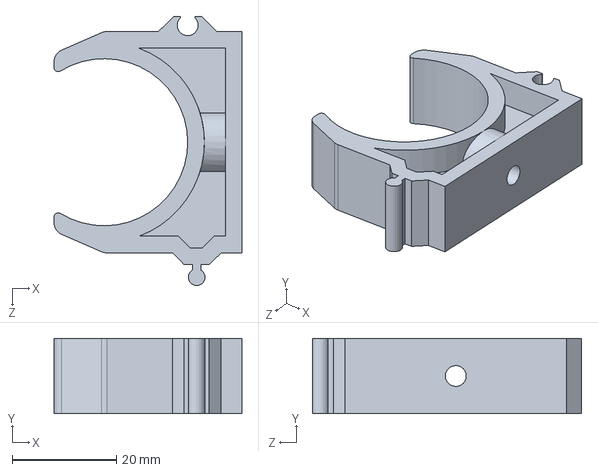
[picture p98: CAD file, 2021-04-28]
2.CADs/Flash Cart Completo Final - 28_04_2021/FLASH CART/Toten de carregamento/pipe holder 32mm.SLDPRT
36.0 x 14.4 x 51.5 mm
