Flash-Cart/Flash-Cart-Model/2.CADs/Flash Cart Completo Final - 28_04_2021/FLASH CART/Chassi/Chassi1_Inferior_Atualizado.SLDPRT

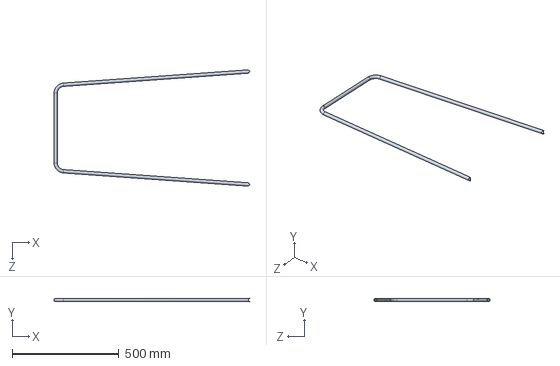
[picture p99: CAD file, 2021-04-28]
2.CADs/Flash Cart Completo Final - 28_04_2021/FLASH CART/Chassi/Chassi1_Inferior_Atualizado.SLDPRT
917.9 x 15.9 x 544.8 mm
