Flash-Cart/Flash-Cart-Model/2.CADs/Flash Cart Completo Final - 28_04_2021/FLASH CART/Componentes Eletronicos/hcsr04/Transmitter.SLDPRT

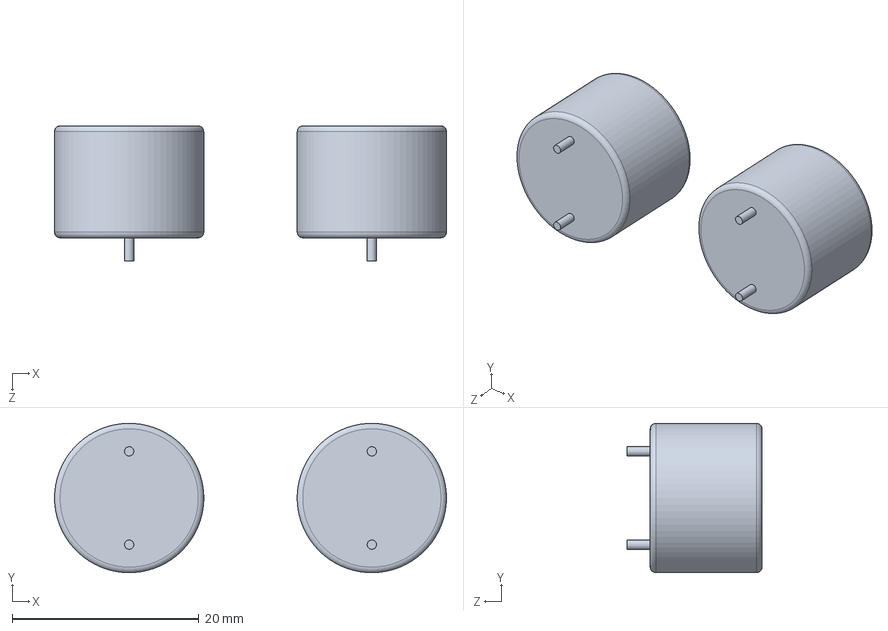
[picture p100: CAD file, 2021-04-28]
2.CADs/Flash Cart Completo Final - 28_04_2021/FLASH CART/Componentes Eletronicos/hcsr04/Transmitter.SLDPRT
42.0 x 16.0 x 14.5 mm
