Flash-Cart/Flash-Cart-Model/2.CADs/Flash Cart Completo Final - 28_04_2021/FLASH CART/Plugue/hack display.STEP

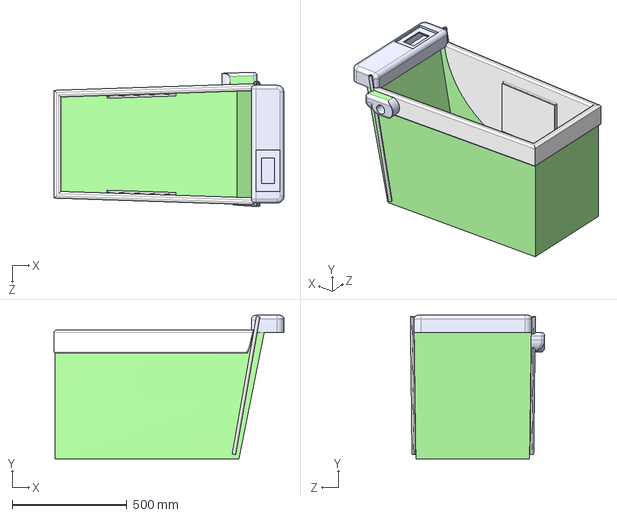
[picture p101: CAD file, 2021-04-28]
2.CADs/Flash Cart Completo Final - 28_04_2021/FLASH CART/Plugue/hack display.STEP
1001.3 x 625.0 x 585.4 mm
