Flash-Cart/Flash-Cart-Model/2.CADs/Flash Cart Completo Final - 28_04_2021/FLASH CART/Rodas/Roda/AsteDe50mm_Atualizado.SLDPRT

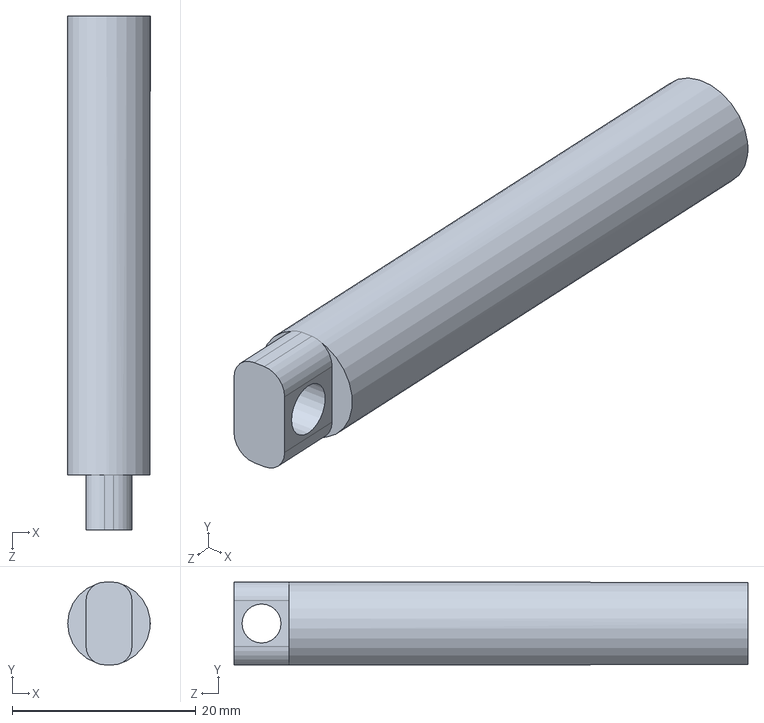
[picture p102: CAD file, 2021-04-28]
2.CADs/Flash Cart Completo Final - 28_04_2021/FLASH CART/Rodas/Roda/AsteDe50mm_Atualizado.SLDPRT
9.00 x 9.00 x 56.0 mm
