Flash-Cart/Flash-Cart-Model/2.CADs/Flash Cart Completo Final - 28_04_2021/FLASH CART/Rodas/RodaDaFrente/Pino_Frente_Atualizado.SLDPRT

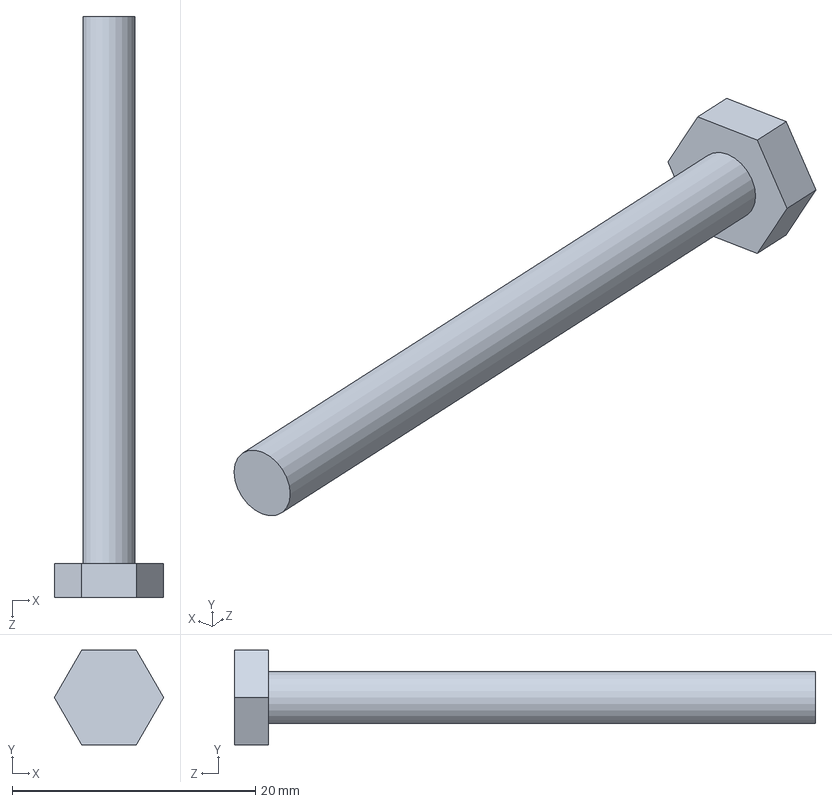
[picture p103: CAD file, 2021-04-28]
2.CADs/Flash Cart Completo Final - 28_04_2021/FLASH CART/Rodas/RodaDaFrente/Pino_Frente_Atualizado.SLDPRT
9.00 x 7.79 x 47.8 mm
