Flash-Cart/Flash-Cart-Model/2.CADs/Flash Cart Completo Final - 28_04_2021/FLASH CART/Suporte inferior/Body55.SLDPRT

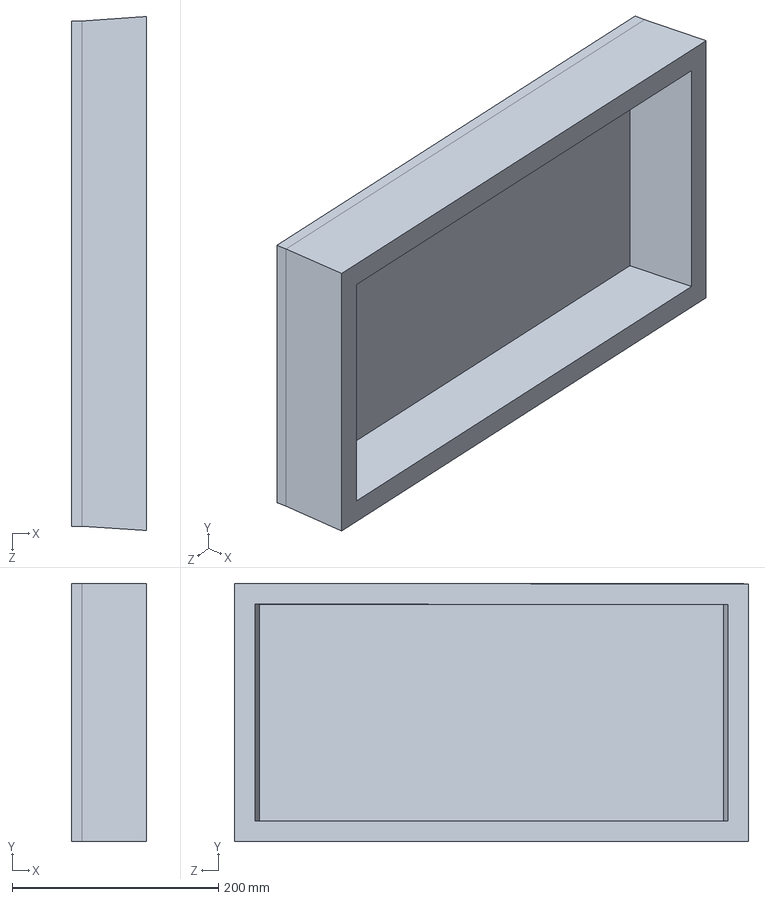
[picture p104: CAD file, 2021-04-28]
2.CADs/Flash Cart Completo Final - 28_04_2021/FLASH CART/Suporte inferior/Body55.SLDPRT
72.5 x 250.5 x 498.8 mm
