Flash-Cart/Flash-Cart-Model/2.CADs/Flash Cart Completo Final - 28_04_2021/FLASH CART/Suporte superior/DISPLAY.SLDPRT

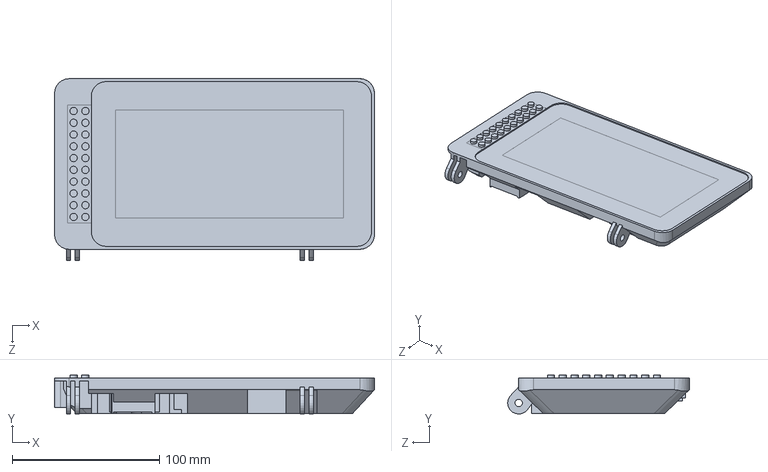
[picture p105: CAD file, 2021-04-28]
2.CADs/Flash Cart Completo Final - 28_04_2021/FLASH CART/Suporte superior/DISPLAY.SLDPRT
217.5 x 26.5 x 123.5 mm
