Flash-Cart/Flash-Cart-Model/2.CADs/Flash Cart Completo Final - 28_04_2021/FLASH CART/Chassi/Chassi4_HorizontalLigandoChassi3_Atualizado.SLDPRT

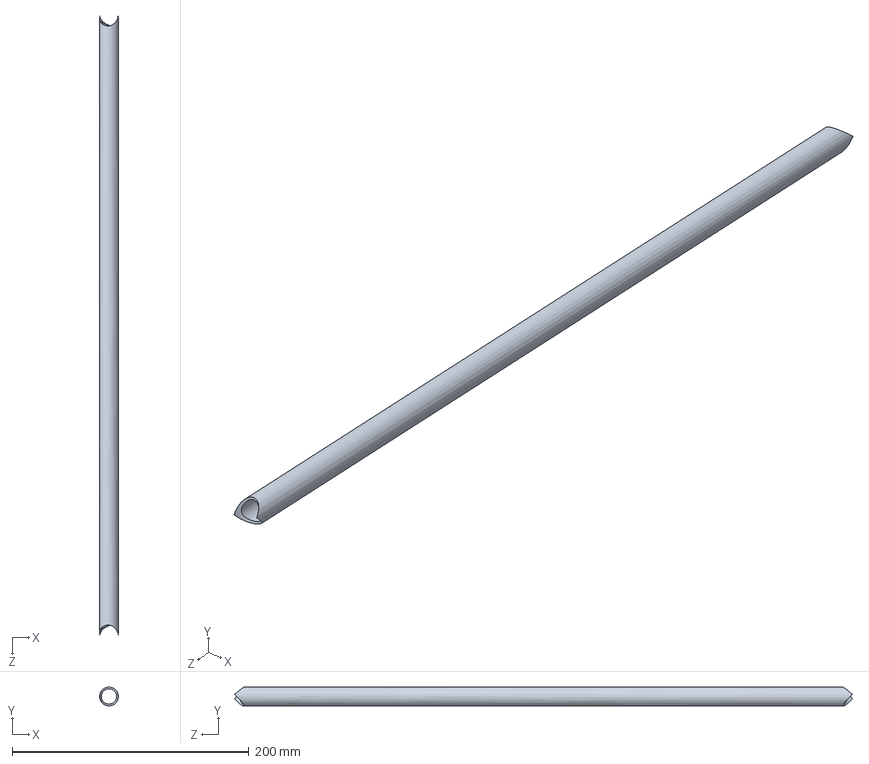
[picture p108: CAD file, 2021-04-28]
2.CADs/Flash Cart Completo Final - 28_04_2021/FLASH CART/Chassi/Chassi4_HorizontalLigandoChassi3_Atualizado.SLDPRT
15.9 x 15.9 x 522.1 mm
