Flash-Cart/Flash-Cart-Model/2.CADs/Flash Cart Completo Final - 28_04_2021/FLASH CART/Rodas/Roda/Trava_Atualizado.SLDPRT

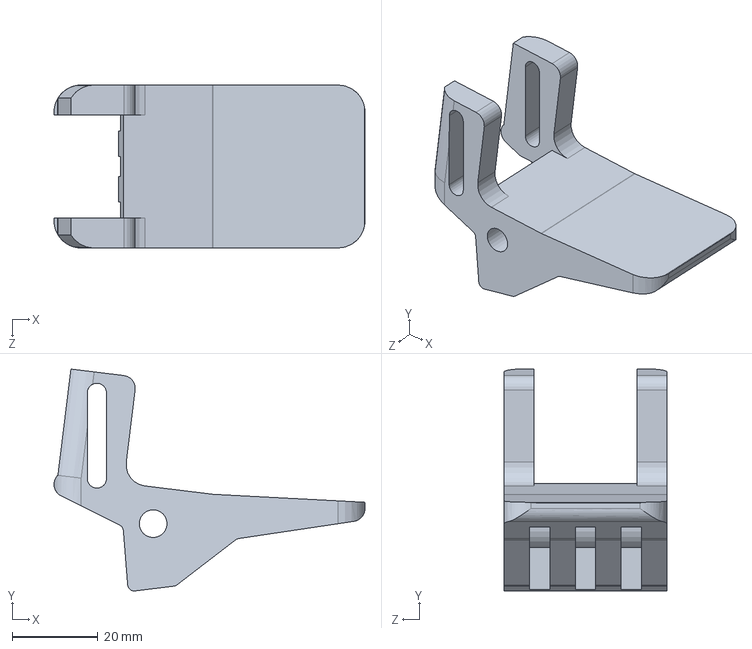
[picture p109: CAD file, 2021-04-28]
2.CADs/Flash Cart Completo Final - 28_04_2021/FLASH CART/Rodas/Roda/Trava_Atualizado.SLDPRT
72.6 x 51.8 x 38.1 mm
