Flash-Cart/Flash-Cart-Model/2.CADs/Flash Cart Completo Final - 28_04_2021/FLASH CART/Suporte inferior/Suporte da bateria.SLDPRT

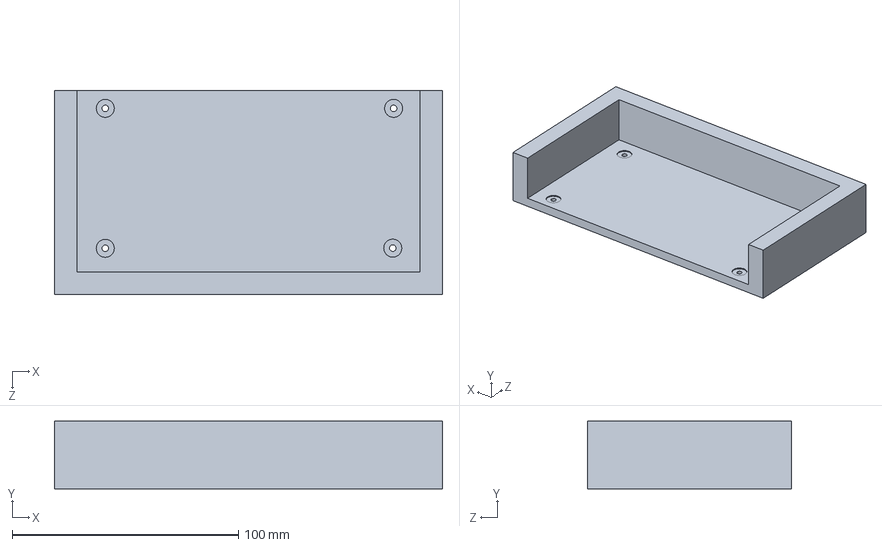
[picture p110: CAD file, 2021-04-28]
2.CADs/Flash Cart Completo Final - 28_04_2021/FLASH CART/Suporte inferior/Suporte da bateria.SLDPRT
171.3 x 30.0 x 90.1 mm
