Flash-Cart/Flash-Cart-Model/2.CADs/Flash Cart Completo Final - 28_04_2021/FLASH CART/Suporte superior/abraçadeira.SLDPRT

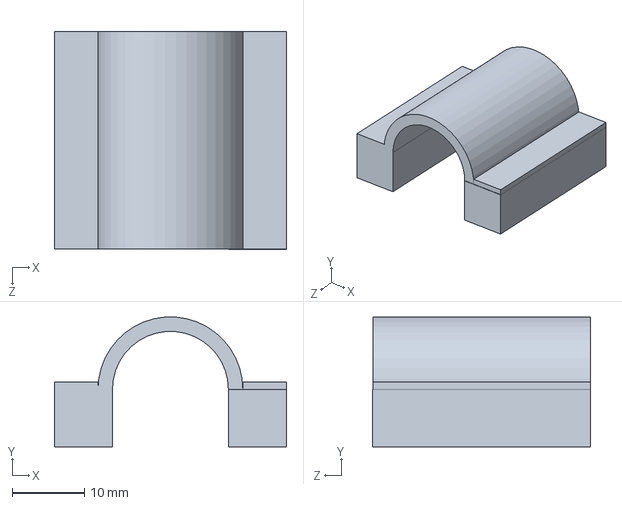
[picture p111: CAD file, 2021-04-28]
2.CADs/Flash Cart Completo Final - 28_04_2021/FLASH CART/Suporte superior/abraçadeira.SLDPRT
32.0 x 17.9 x 30.1 mm
