Flash-Cart/Flash-Cart-Model/2.CADs/Flash Cart Completo Final - 28_04_2021/FLASH CART/Suporte superior/capa de metal para raspberry/Clinching Stand off M 2.5X 61.STEP

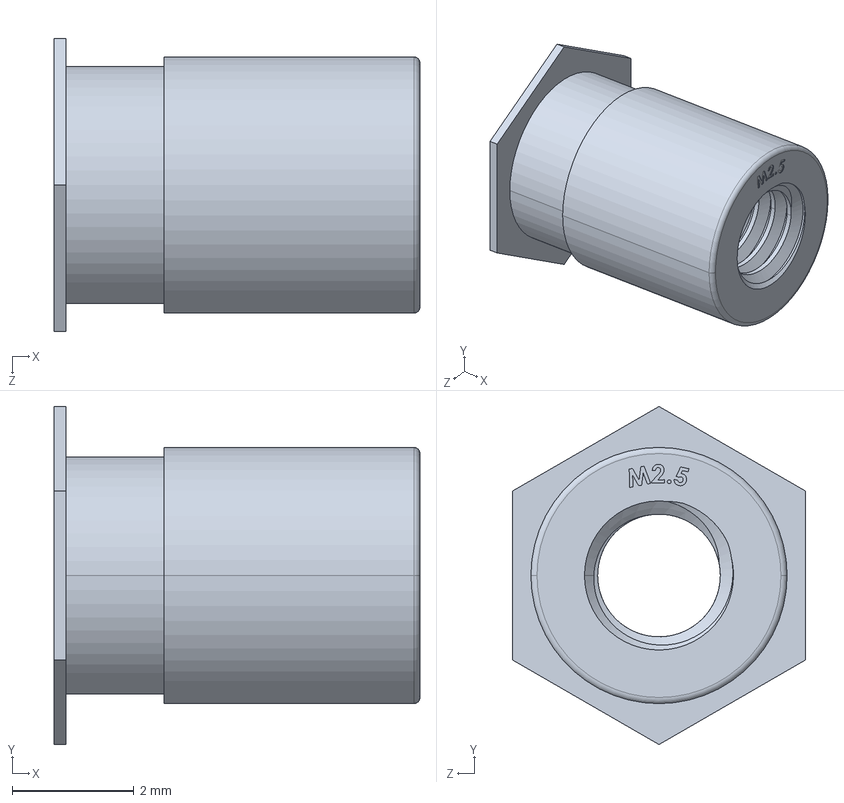
[picture p112: CAD file, 2021-04-28]
2.CADs/Flash Cart Completo Final - 28_04_2021/FLASH CART/Suporte superior/capa de metal para raspberry/Clinching Stand off M 2.5X 61.STEP
6.00 x 5.54 x 4.80 mm
