Flash-Cart/Flash-Cart-Model/2.CADs/Flash Cart Completo Final - 28_04_2021/FLASH CART/Toten de carregamento/adattatore.SLDPRT

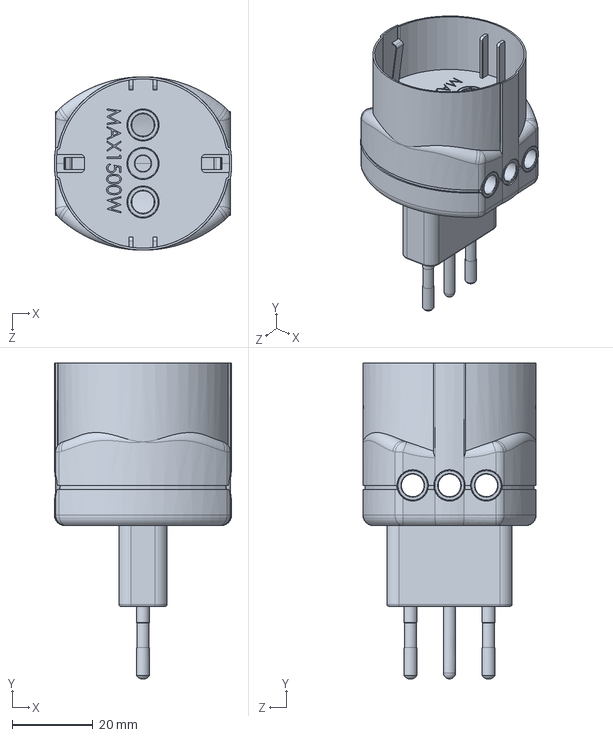
[picture p114: CAD file, 2021-04-28]
2.CADs/Flash Cart Completo Final - 28_04_2021/FLASH CART/Toten de carregamento/adattatore.SLDPRT
44.0 x 78.4 x 43.0 mm
