Flash-Cart/Flash-Cart-Model/2.CADs/Flash Cart Completo Final - 28_04_2021/FLASH CART/Balança/parafuso_m5_madeira.SLDPRT

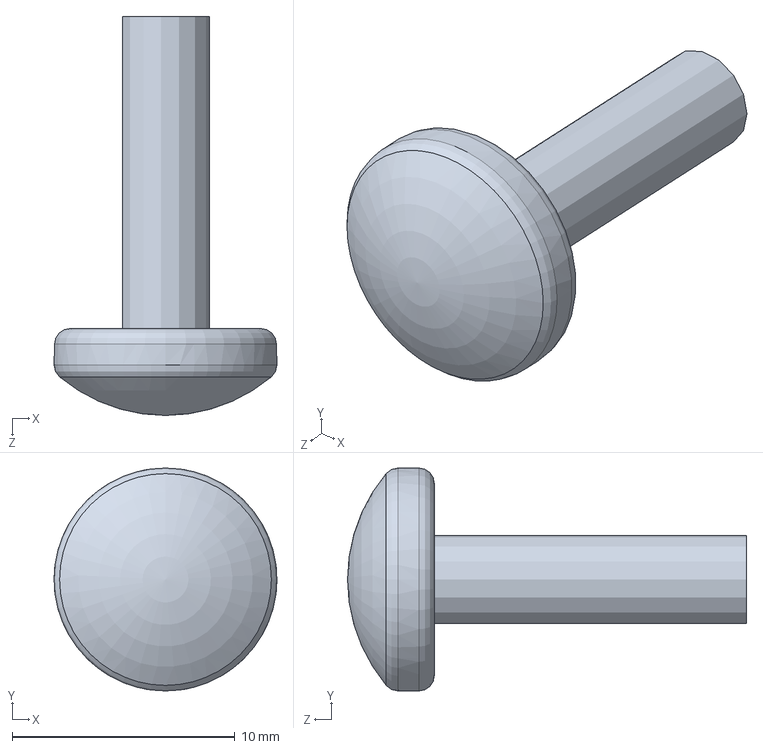
[picture p115: CAD file, 2021-04-28]
2.CADs/Flash Cart Completo Final - 28_04_2021/FLASH CART/Balança/parafuso_m5_madeira.SLDPRT
10.0 x 10.0 x 17.9 mm
