Flash-Cart/Flash-Cart-Model/2.CADs/Flash Cart Completo Final - 28_04_2021/FLASH CART/Componentes Eletronicos/hcsr04/CoverBottom.SLDPRT

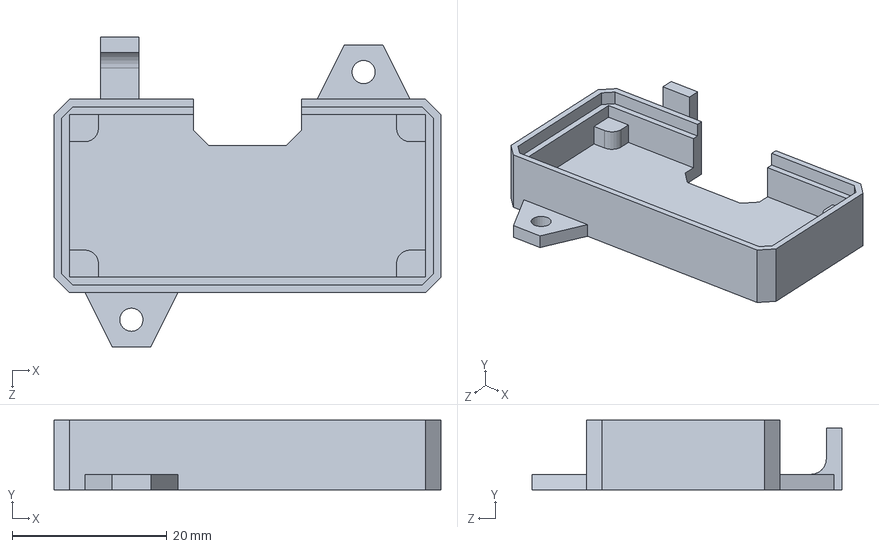
[picture p116: CAD file, 2021-04-28]
2.CADs/Flash Cart Completo Final - 28_04_2021/FLASH CART/Componentes Eletronicos/hcsr04/CoverBottom.SLDPRT
50.0 x 9.00 x 40.0 mm
