Flash-Cart/Flash-Cart-Model/2.CADs/Flash Cart Completo Final - 28_04_2021/FLASH CART/Rodas/Roda/Parafuso_M6_60mm.SLDPRT

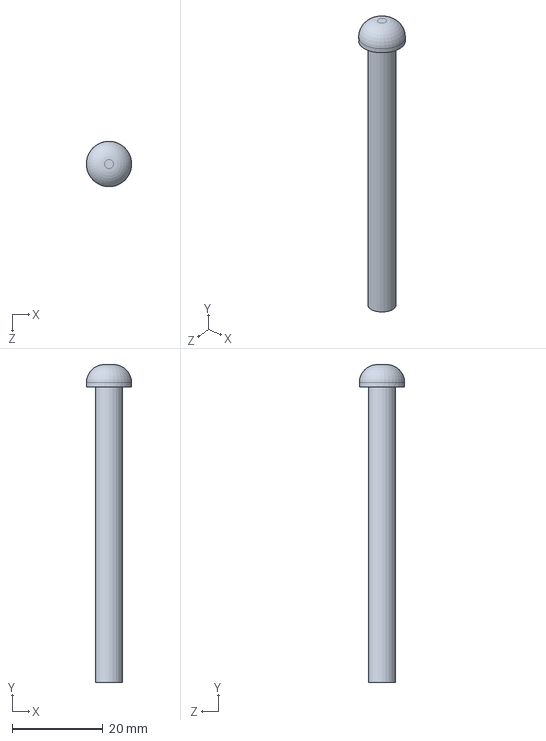
[picture p117: CAD file, 2021-04-28]
2.CADs/Flash Cart Completo Final - 28_04_2021/FLASH CART/Rodas/Roda/Parafuso_M6_60mm.SLDPRT
10.0 x 70.0 x 10.0 mm
