Flash-Cart/Flash-Cart-Model/2.CADs/Flash Cart Completo Final - 28_04_2021/FLASH CART/Rodas/RodaDaFrente/InteriorDaRoda_Frente_Atualizado.SLDPRT

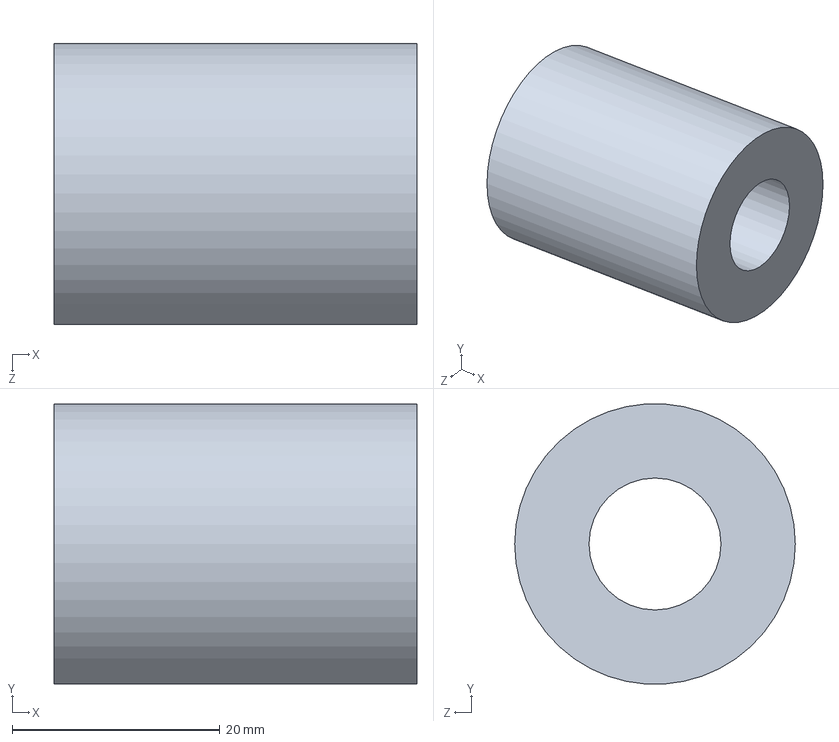
[picture p118: CAD file, 2021-04-28]
2.CADs/Flash Cart Completo Final - 28_04_2021/FLASH CART/Rodas/RodaDaFrente/InteriorDaRoda_Frente_Atualizado.SLDPRT
34.9 x 26.9 x 27.0 mm
