Flash-Cart/Flash-Cart-Model/2.CADs/Flash Cart Completo Final - 28_04_2021/FLASH CART/Suporte superior/raspberry-pi-4-model-b-1.snapshot.3/SD Card Slot, RPi4ModelB.SLDPRT

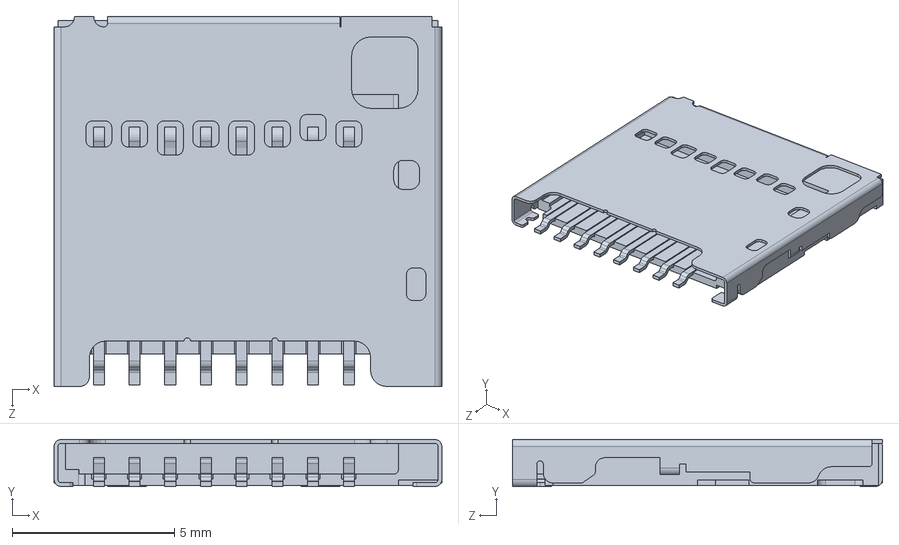
[picture p122: CAD file, 2021-04-28]
2.CADs/Flash Cart Completo Final - 28_04_2021/FLASH CART/Suporte superior/raspberry-pi-4-model-b-1.snapshot.3/SD Card Slot, RPi4ModelB.SLDPRT
11.9 x 1.45 x 11.4 mm
