Flash-Cart/Flash-Cart-Model/2.CADs/Flash Cart Completo Final - 28_04_2021/FLASH CART/Toten de carregamento/Suporte chao.SLDPRT

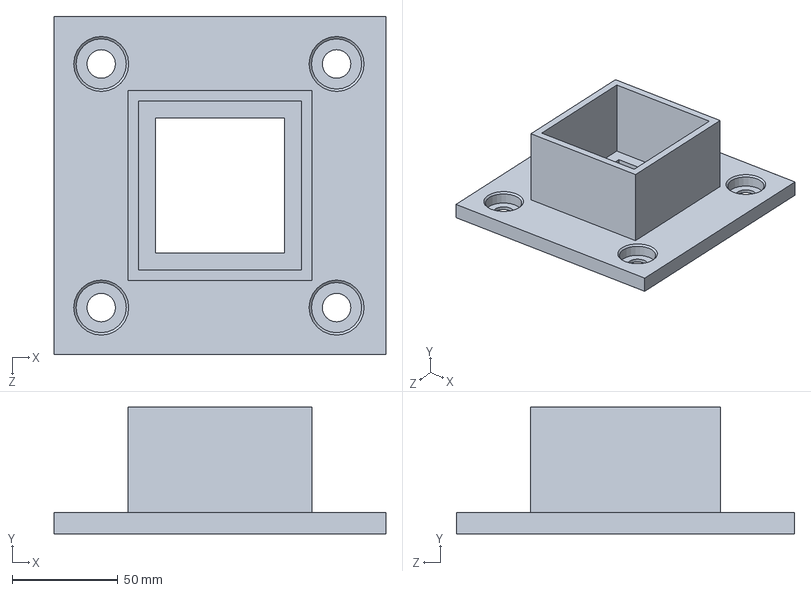
[picture p123: CAD file, 2021-04-28]
2.CADs/Flash Cart Completo Final - 28_04_2021/FLASH CART/Toten de carregamento/Suporte chao.SLDPRT
157.0 x 60.0 x 160.0 mm
