Flash-Cart/Flash-Cart-Model/2.CADs/Flash Cart Completo Final - 28_04_2021/FLASH CART/Balança/armacao_inferior_balanca.SLDPRT

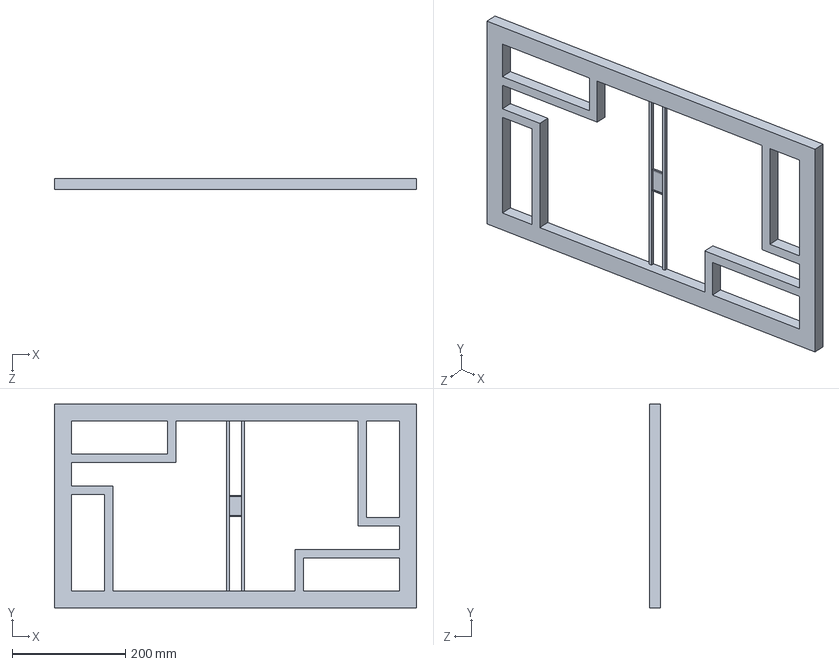
[picture p124: CAD file, 2021-04-28]
2.CADs/Flash Cart Completo Final - 28_04_2021/FLASH CART/Balança/armacao_inferior_balanca.SLDPRT
640.0 x 360.0 x 20.0 mm
