Flash-Cart/Flash-Cart-Model/2.CADs/Flash Cart Completo Final - 28_04_2021/FLASH CART/Rodas/RodaDaFrente/Roda_Frente_Atualizada.SLDPRT

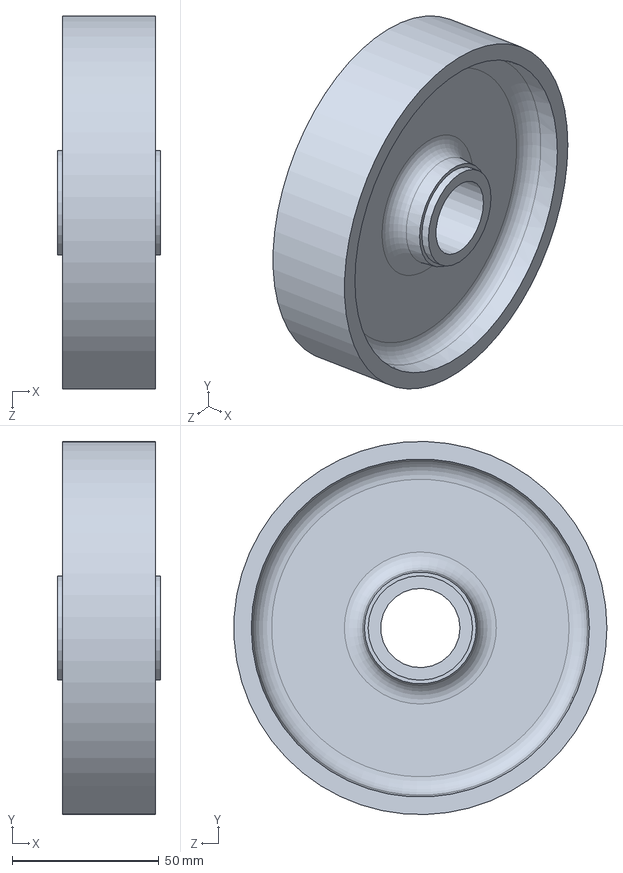
[picture p127: CAD file, 2021-04-28]
2.CADs/Flash Cart Completo Final - 28_04_2021/FLASH CART/Rodas/RodaDaFrente/Roda_Frente_Atualizada.SLDPRT
34.9 x 126.9 x 126.9 mm
