Flash-Cart/Flash-Cart-Model/2.CADs/Flash Cart Completo Final - 28_04_2021/FLASH CART/Suporte superior/Suporte do display correto.SLDPRT

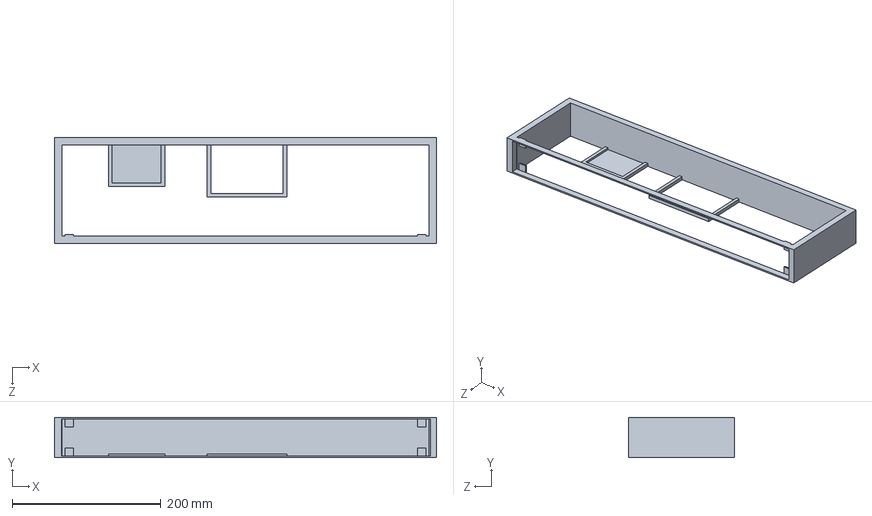
[picture p130: CAD file, 2021-04-28]
2.CADs/Flash Cart Completo Final - 28_04_2021/FLASH CART/Suporte superior/Suporte do display correto.SLDPRT
512.8 x 54.0 x 142.5 mm
