Flash-Cart/Flash-Cart-Model/2.CADs/Flash Cart Completo Final - 28_04_2021/FLASH CART/Toten de carregamento/caixa do transformador.SLDPRT

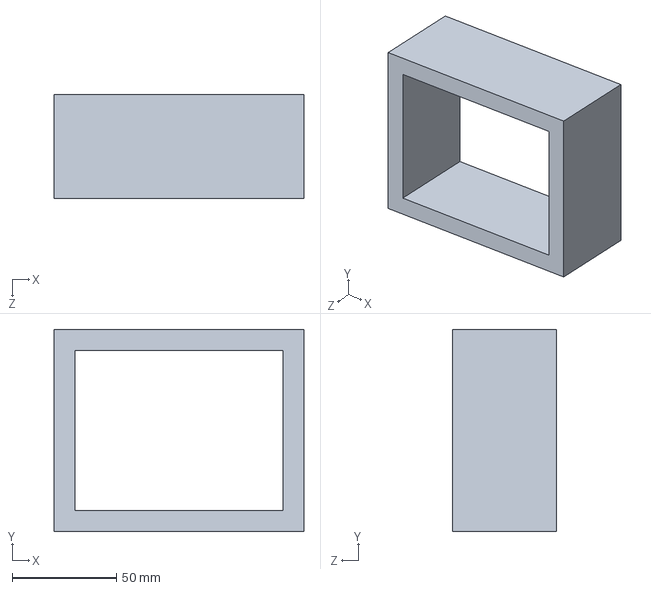
[picture p131: CAD file, 2021-04-28]
2.CADs/Flash Cart Completo Final - 28_04_2021/FLASH CART/Toten de carregamento/caixa do transformador.SLDPRT
120.0 x 97.0 x 50.0 mm
