Flash-Cart/Flash-Cart-Model/2.CADs/Flash Cart Completo Final - 28_04_2021/FLASH CART/Chassi/Chassi3_Vertical_Atualizado.SLDPRT

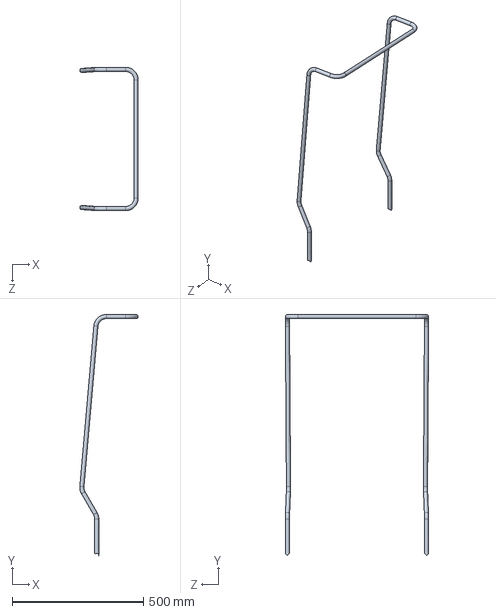
[picture p132: CAD file, 2021-04-28]
2.CADs/Flash Cart Completo Final - 28_04_2021/FLASH CART/Chassi/Chassi3_Vertical_Atualizado.SLDPRT
222.5 x 917.9 x 545.9 mm
