Flash-Cart/Flash-Cart-Model/2.CADs/Flash Cart Completo Final - 28_04_2021/FLASH CART/Suporte inferior/bateria 2.SLDPRT

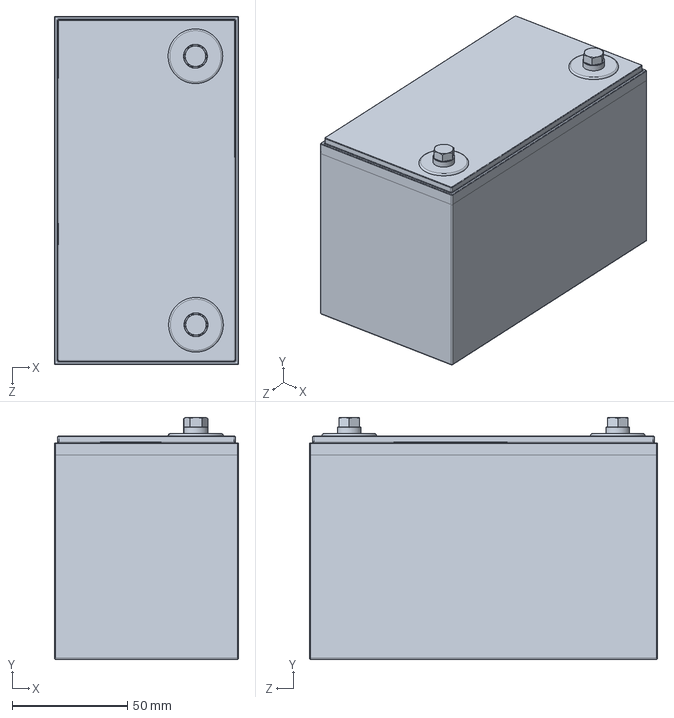
[picture p134: CAD file, 2021-04-28]
2.CADs/Flash Cart Completo Final - 28_04_2021/FLASH CART/Suporte inferior/bateria 2.SLDPRT
80.1 x 105.1 x 151.3 mm
