Flash-Cart/Flash-Cart-Model/2.CADs/Flash Cart Completo Final - 28_04_2021/FLASH CART/Suporte superior/tampa do suporte do display.SLDPRT

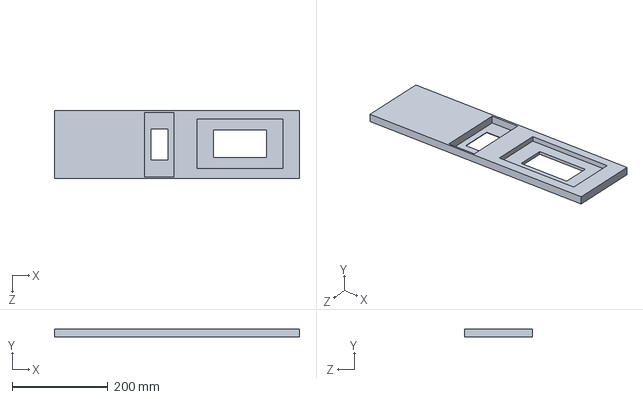
[picture p136: CAD file, 2021-04-28]
2.CADs/Flash Cart Completo Final - 28_04_2021/FLASH CART/Suporte superior/tampa do suporte do display.SLDPRT
512.8 x 16.0 x 142.5 mm
