Flash-Cart/Flash-Cart-Model/2.CADs/Flash Cart Completo Final - 28_04_2021/FLASH CART/Toten de carregamento/Carcaça.SLDPRT

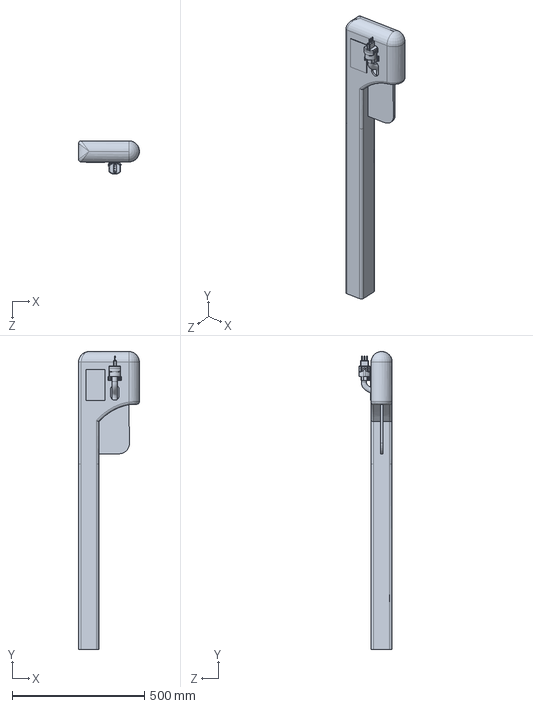
[picture p137: CAD file, 2021-04-28]
2.CADs/Flash Cart Completo Final - 28_04_2021/FLASH CART/Toten de carregamento/Carcaça.SLDPRT
230.0 x 1125.0 x 126.3 mm
