Flash-Cart/Flash-Cart-Model/2.CADs/Flash Cart Completo Final - 28_04_2021/FLASH CART/Balança/módulo com amplificador de instrumentação hx711/TRANSISTOR_SOT23.SLDPRT

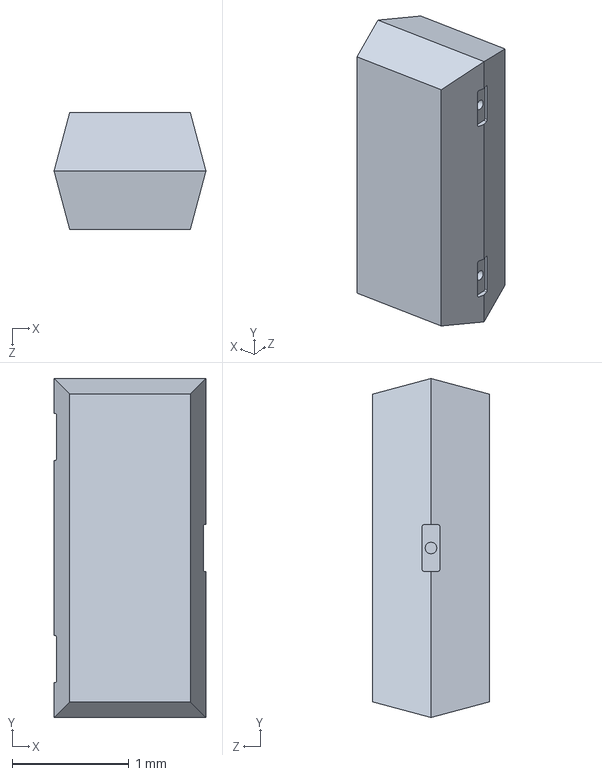
[picture p138: CAD file, 2021-04-28]
2.CADs/Flash Cart Completo Final - 28_04_2021/FLASH CART/Balança/módulo com amplificador de instrumentação hx711/TRANSISTOR_SOT23.SLDPRT
1.30 x 2.90 x 1.00 mm
