Flash-Cart/Flash-Cart-Model/2.CADs/Flash Cart Completo Final - 28_04_2021/FLASH CART/Chassi/MontagemChassi_FlashCart_TudoJunto.SLDPRT

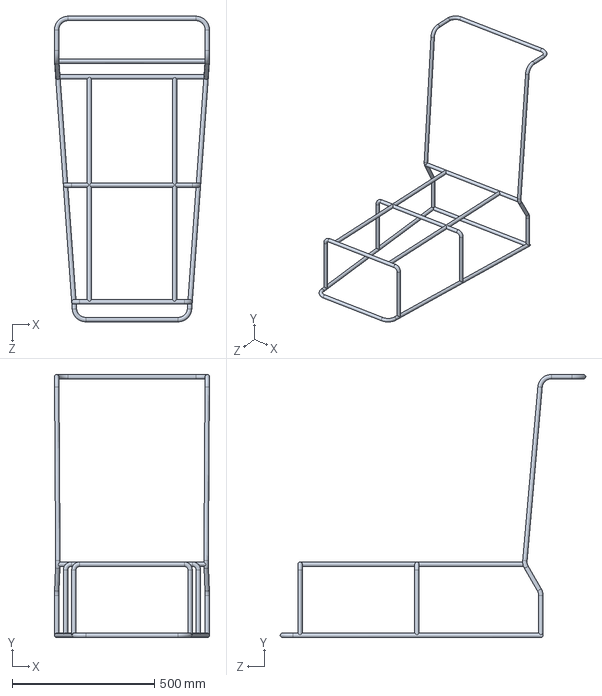
[picture p139: CAD file, 2021-04-28]
2.CADs/Flash Cart Completo Final - 28_04_2021/FLASH CART/Chassi/MontagemChassi_FlashCart_TudoJunto.SLDPRT
547.0 x 925.8 x 1075.8 mm
