Flash-Cart/Flash-Cart-Model/2.CADs/Flash Cart Completo Final - 28_04_2021/FLASH CART/Suporte superior/Q80 POS Terminal Detailed.SLDPRT

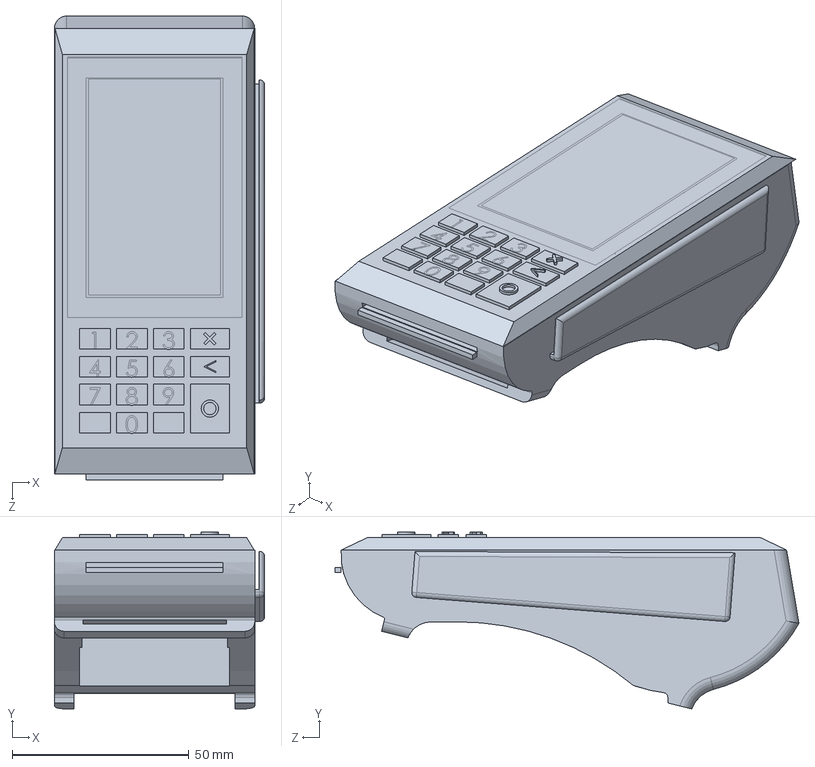
[picture p141: CAD file, 2021-04-28]
2.CADs/Flash Cart Completo Final - 28_04_2021/FLASH CART/Suporte superior/Q80 POS Terminal Detailed.SLDPRT
59.5 x 50.1 x 131.2 mm
