Flash-Cart/Flash-Cart-Model/2.CADs/Flash Cart Completo Final - 28_04_2021/FLASH CART/Chassi/Chassi5_Ligando_Frente_Atualizado.SLDPRT

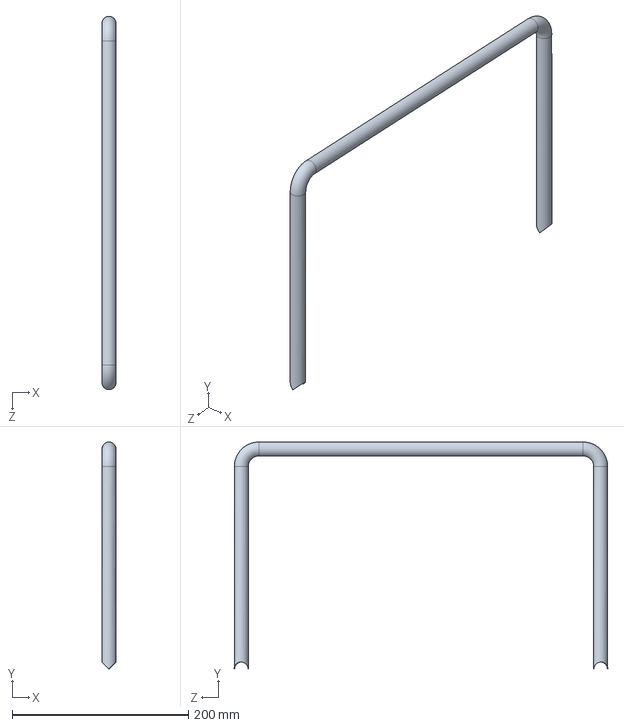
[picture p144: CAD file, 2021-04-28]
2.CADs/Flash Cart Completo Final - 28_04_2021/FLASH CART/Chassi/Chassi5_Ligando_Frente_Atualizado.SLDPRT
15.9 x 257.9 x 424.2 mm
