Flash-Cart/Flash-Cart-Model/2.CADs/Flash Cart Completo Final - 28_04_2021/FLASH CART/Chassi/ChapaSuporteInferior_FlashCart.SLDPRT

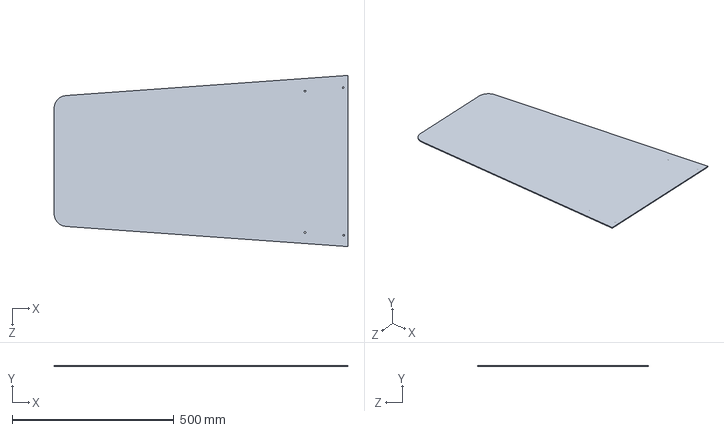
[picture p147: CAD file, 2021-04-28]
2.CADs/Flash Cart Completo Final - 28_04_2021/FLASH CART/Chassi/ChapaSuporteInferior_FlashCart.SLDPRT
910.0 x 3.00 x 530.0 mm
