Flash-Cart/Flash-Cart-Model/2.CADs/Flash Cart Completo Final - 28_04_2021/FLASH CART/Rodas/Roda/CapaDoSuporteDaRoda_Atualizado.SLDPRT

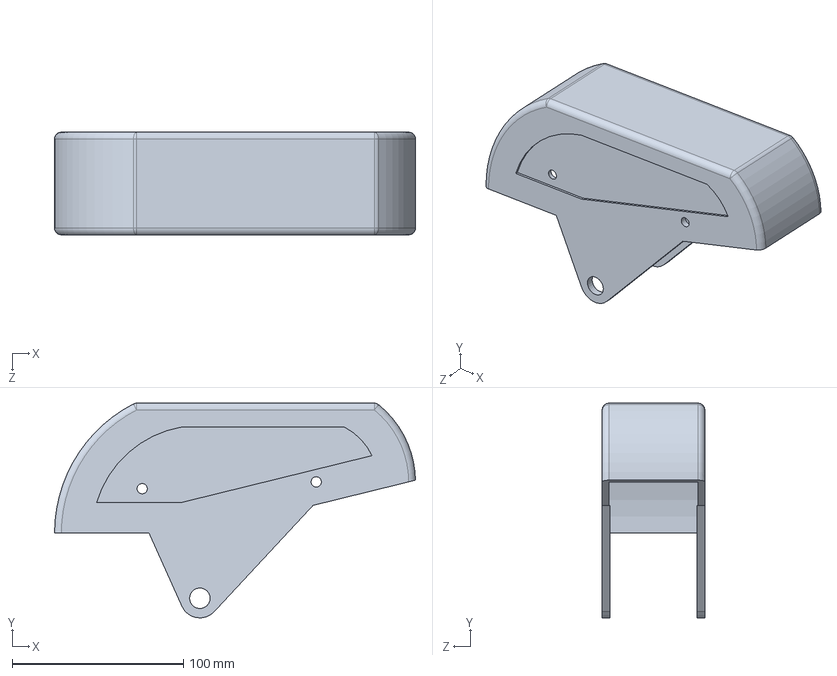
[picture p148: CAD file, 2021-04-28]
2.CADs/Flash Cart Completo Final - 28_04_2021/FLASH CART/Rodas/Roda/CapaDoSuporteDaRoda_Atualizado.SLDPRT
210.9 x 125.5 x 60.0 mm
