Flash-Cart/Flash-Cart-Model/2.CADs/Flash Cart Completo Final - 28_04_2021/FLASH CART/Componentes Eletronicos/hcsr04/PLS-4R (DS-1022-1x4).SLDPRT

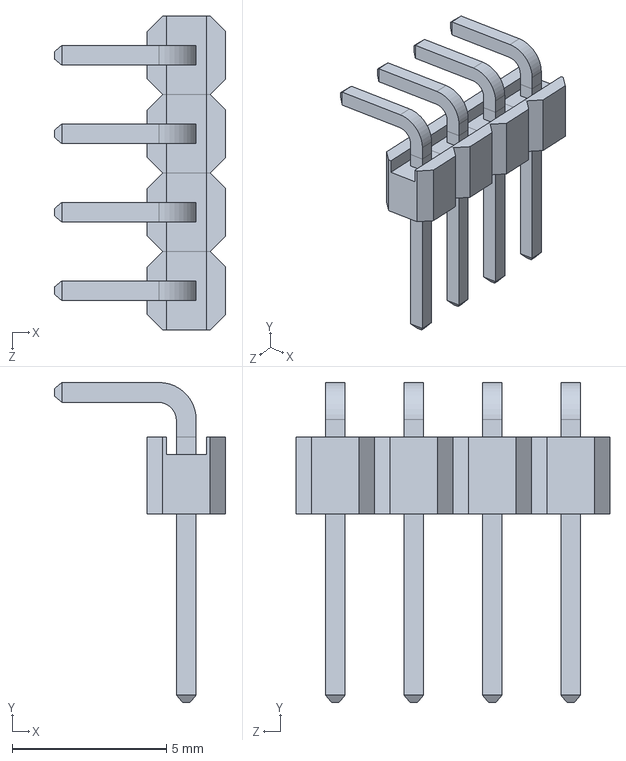
[picture p151: CAD file, 2021-04-28]
2.CADs/Flash Cart Completo Final - 28_04_2021/FLASH CART/Componentes Eletronicos/hcsr04/PLS-4R (DS-1022-1x4).SLDPRT
5.54 x 10.4 x 10.2 mm
