Flash-Cart/Flash-Cart-Model/2.CADs/Flash Cart Completo Final - 28_04_2021/FLASH CART/Balança/módulo com amplificador de instrumentação hx711/HX711.STEP

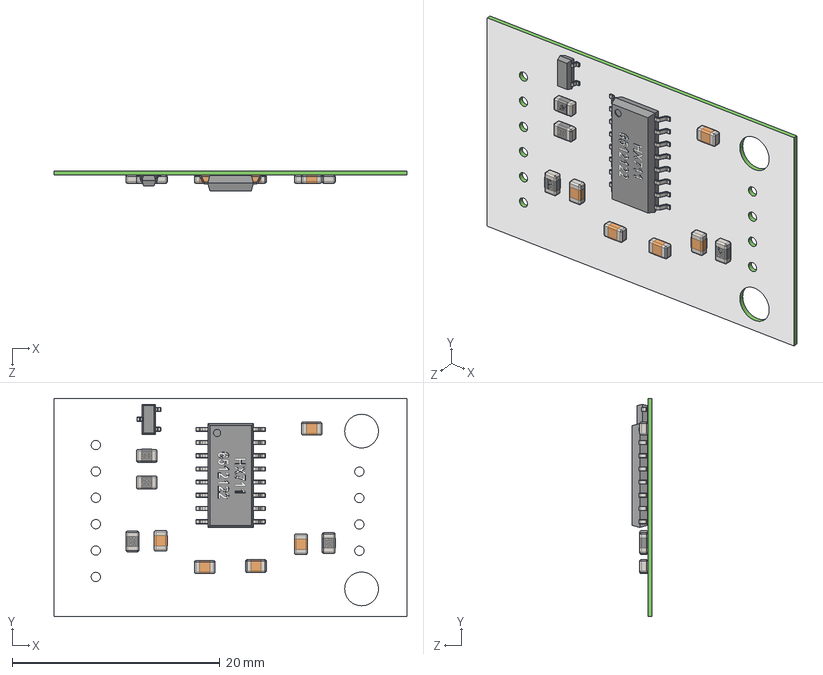
[picture p153: CAD file, 2021-04-28]
2.CADs/Flash Cart Completo Final - 28_04_2021/FLASH CART/Balança/módulo com amplificador de instrumentação hx711/HX711.STEP
34.0 x 21.0 x 1.97 mm
placa_Valor predeterminado
base_HX711_Valor predeterminado
pino_HX711_Valor predeterminado x 16
RESISTOR_SMD_122_Valor predeterminado x 2
RESISTOR_SMD_822_Valor predeterminado
RESISTOR_SMD_203_Valor predeterminado
CAPACITOR_805_Valor predeterminado x 5
TRANSISTOR_SOT23_Valor predeterminado
PINO_SOT23_Valor predeterminado x 3
