Flash-Cart/Flash-Cart-Model/2.CADs/Flash Cart Completo Final - 28_04_2021/FLASH CART/Rodas/Roda/Roda_Atualizada.SLDPRT

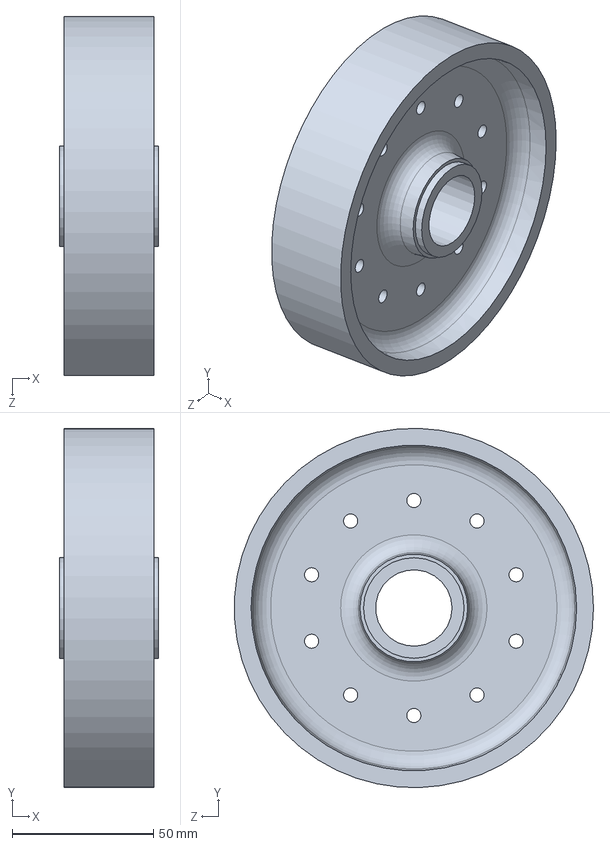
[picture p154: CAD file, 2021-04-28]
2.CADs/Flash Cart Completo Final - 28_04_2021/FLASH CART/Rodas/Roda/Roda_Atualizada.SLDPRT
34.9 x 126.9 x 126.9 mm
