Flash-Cart/Flash-Cart-Model/2.CADs/Flash Cart Completo Final - 28_04_2021/FLASH CART/Balança/módulo com amplificador de instrumentação hx711/RESISTOR_SMD_122.SLDPRT

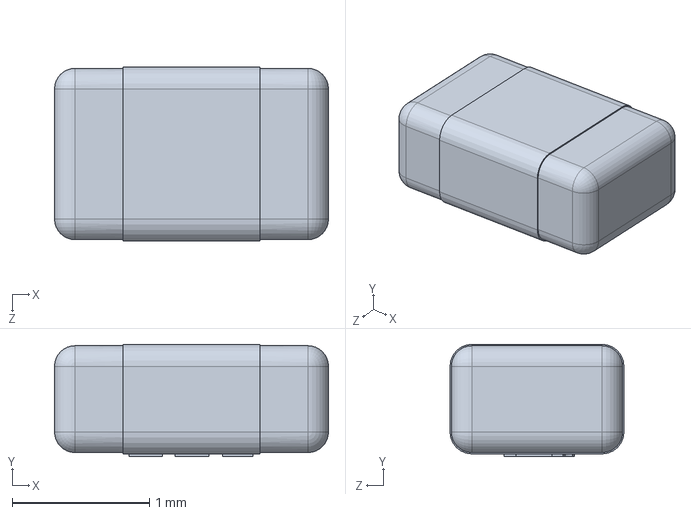
[picture p159: CAD file, 2021-04-28]
2.CADs/Flash Cart Completo Final - 28_04_2021/FLASH CART/Balança/módulo com amplificador de instrumentação hx711/RESISTOR_SMD_122.SLDPRT
2.00 x 0.82 x 1.27 mm
