Flash-Cart/Flash-Cart-Model/2.CADs/Flash Cart Completo Final - 28_04_2021/FLASH CART/Rodas/Roda/BracadeiraAtuador.SLDPRT

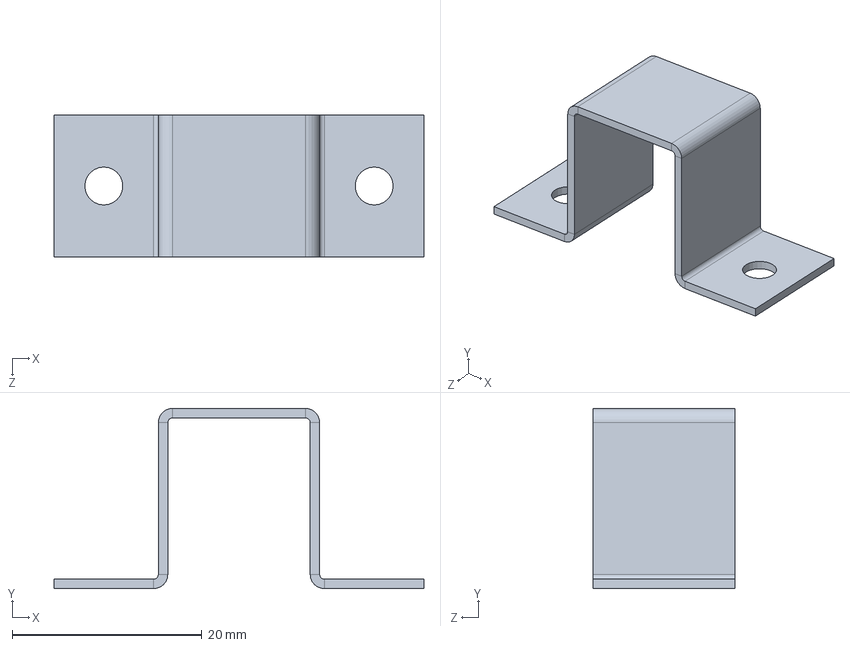
[picture p160: CAD file, 2021-04-28]
2.CADs/Flash Cart Completo Final - 28_04_2021/FLASH CART/Rodas/Roda/BracadeiraAtuador.SLDPRT
39.0 x 19.0 x 15.0 mm
