Flash-Cart/Flash-Cart-Model/(list of files, cad)

Other CAD files:
2.CADs/Flash Cart Completo Final - 28_04_2021/FLASH CART/Rodas/RodaDaFrente/MontagemDaRoda_Frente_Esquerda_Atualizado.SLDASM
2.CADs/Flash Cart Completo Final - 28_04_2021/FLASH CART/Componentes Eletronicos/hcsr04/Crystal Oscillator (SMD).sldprt
2.CADs/Flash Cart Completo Final - 28_04_2021/FLASH CART/Balança/módulo com amplificador de instrumentação hx711/pino_HX711_Valor predeterminado.STEP.SLDPRT
2.CADs/Flash Cart Completo Final - 28_04_2021/FLASH CART/Chassi/Chassi7_Frente_Meio_Esquerda_Atualizado.SLDPRT
2.CADs/Flash Cart Completo Final - 28_04_2021/FLASH CART/Balança/módulo com amplificador de instrumentação hx711/TRANSISTOR_SOT23_Valor predeterminado.STEP.SLDPRT
2.CADs/Flash Cart Completo Final - 28_04_2021/FLASH CART/Componentes Eletronicos/hcsr04/Mesh.sldprt
2.CADs/Flash Cart Completo Final - 28_04_2021/FLASH CART/Suporte inferior/Parte de baixo.SLDPRT
2.CADs/Flash Cart Completo Final - 28_04_2021/FLASH CART/Balança/módulo com amplificador de instrumentação hx711/PINO_SOT23_Valor predeterminado.STEP.SLDPRT
2.CADs/Flash Cart Completo Final - 28_04_2021/FLASH CART/Balança/parafuso_m5_comprimento_14mm_madeira.SLDPRT
2.CADs/Flash Cart Completo Final - 28_04_2021/FLASH CART/Componentes Eletronicos/hcsr04/SOIC16 narrow.sldprt
2.CADs/Flash Cart Completo Final - 28_04_2021/FLASH CART/Balança/módulo com amplificador de instrumentação hx711/RESISTOR_SMD_203.SLDPRT
2.CADs/Flash Cart Completo Final - 28_04_2021/FLASH CART/Chassi/Chassi10_Meio_Tras_Direita_Atualizado.SLDPRT
2.CADs/Flash Cart Completo Final - 28_04_2021/FLASH CART/Componentes Eletronicos/hcsr04/0603 Capacitor.sldprt
2.CADs/Flash Cart Completo Final - 28_04_2021/FLASH CART/Rodas/Roda/InteriorDaRoda_Atualizado.SLDPRT
2.CADs/Flash Cart Completo Final - 28_04_2021/FLASH CART/Balança/módulo com amplificador de instrumentação hx711/base_HX711_Valor predeterminado.STEP.SLDPRT
2.CADs/Flash Cart Completo Final - 28_04_2021/FLASH CART/Rodas/Roda/Pino_Atualizado.SLDPRT
2.CADs/Flash Cart Completo Final - 28_04_2021/FLASH CART/Suporte superior/raspberry-pi-4-model-b-1.snapshot.3/M2.5 X 4.step.SLDPRT
2.CADs/Flash Cart Completo Final - 28_04_2021/FLASH CART/Suporte superior/raspberry-pi-4-model-b-1.snapshot.3/Cover.step.SLDPRT
2.CADs/Flash Cart Completo Final - 28_04_2021/FLASH CART/Suporte superior/raspberry-pi-4-model-b-1.snapshot.3/Display Connector, RPi4ModelB.SLDPRT
2.CADs/Flash Cart Completo Final - 28_04_2021/FLASH CART/Suporte superior/raspberry-pi-4-model-b-1.snapshot.3/Clinching Stand off M 2.5X 61.step.SLDPRT
2.CADs/Flash Cart Completo Final - 28_04_2021/FLASH CART/Balança/90031A113_PHILLIPS FLAT HEAD SCREWS FOR WOOD.SLDPRT
2.CADs/Flash Cart Completo Final - 28_04_2021/FLASH CART/Balança/m5_12mm.SLDPRT
2.CADs/Flash Cart Completo Final - 28_04_2021/FLASH CART/Balança/m8_16mm.SLDPRT
2.CADs/Flash Cart Completo Final - 28_04_2021/FLASH CART/Balança/módulo com amplificador de instrumentação hx711/HX711.SLDASM
2.CADs/Flash Cart Completo Final - 28_04_2021/FLASH CART/Cesta/SuporteEletronica_Atualizado.STL
2.CADs/Flash Cart Completo Final - 28_04_2021/FLASH CART/Componentes Eletronicos/hcsr04/ISO 7049 - ST2,2x9,5.SLDPRT
2.CADs/Flash Cart Completo Final - 28_04_2021/FLASH CART/Plugue/hack display.IGS
2.CADs/Flash Cart Completo Final - 28_04_2021/FLASH CART/Rodas/Roda/Encoder.IGS
2.CADs/Flash Cart Completo Final - 28_04_2021/FLASH CART/Rodas/Roda/binding head screw_ai.SLDPRT
2.CADs/Flash Cart Completo Final - 28_04_2021/FLASH CART/Rodas/Roda/cabo.IGS
2.CADs/Flash Cart Completo Final - 28_04_2021/FLASH CART/Rodas/Roda/socket button head cap screw_am.SLDPRT
2.CADs/Flash Cart Completo Final - 28_04_2021/FLASH CART/Suporte superior/Ensamble_soporte.SLDPRT
2.CADs/Flash Cart Completo Final - 28_04_2021/FLASH CART/Suporte superior/binding head screw_ai.sldprt
5.Manuais/Balança/Montagem_Balanca_manual.SLDDRW
5.Manuais/Balança/Montagem_Balanca_manual1.1.SLDDRW
5.Manuais/Balança/Montagem_Balanca_manual2.SLDDRW
5.Manuais/Balança/Montagem_Balanca_manual3.SLDDRW
5.Manuais/Balança/Montagem_Balanca_manual4.1.SLDDRW
5.Manuais/Balança/Montagem_Balanca_manual4.SLDDRW
5.Manuais/Balança/Montagem_Balanca_manual5.SLDDRW
5.Manuais/Balança/Montagem_Balanca_manualX.SLDDRW
5.Manuais/Caixa da bateria/Exploded caixa da bateria atualizado.SLDDRW
5.Manuais/Caixa da bateria/passo1.SLDDRW
5.Manuais/Caixa da bateria/passo2 atualizado.SLDDRW
5.Manuais/Caixa da bateria/passo3 atualizado.SLDDRW
5.Manuais/Caixa da bateria/passo4 atualizado.SLDDRW
5.Manuais/Cesta + balança + capas/Flash cart.SLDDRW
5.Manuais/Cesta + balança + capas/passo1.SLDDRW
5.Manuais/Cesta + balança + capas/passo2.SLDDRW
5.Manuais/Cesta + balança + capas/passo3.SLDDRW
5.Manuais/Cesta + balança + capas/passo4.SLDDRW
5.Manuais/Explodida chassi + roda + placa/exploded chassi roda e placa.SLDDRW
5.Manuais/Plugue/passo1.SLDDRW
5.Manuais/Plugue/passo2.SLDDRW
5.Manuais/Plugue/passo3.SLDDRW
5.Manuais/Suporte do display/passo1.SLDDRW
5.Manuais/Suporte do display/passo2.SLDDRW
5.Manuais/Suporte do display/passo3.SLDDRW
5.Manuais/Suporte do display/passo4.SLDDRW
5.Manuais/Suporte do display/passo5.SLDDRW
5.Manuais/slot de carregamento/passo 0.SLDDRW
5.Manuais/slot de carregamento/passo 1.SLDDRW
5.Manuais/slot de carregamento/passo 2.SLDDRW
