Flash-Cart/Flash-Cart-Model/10.Energia/referencial teorico/Tutorial_Proteus_Simulacao.pdf

## Retificadores

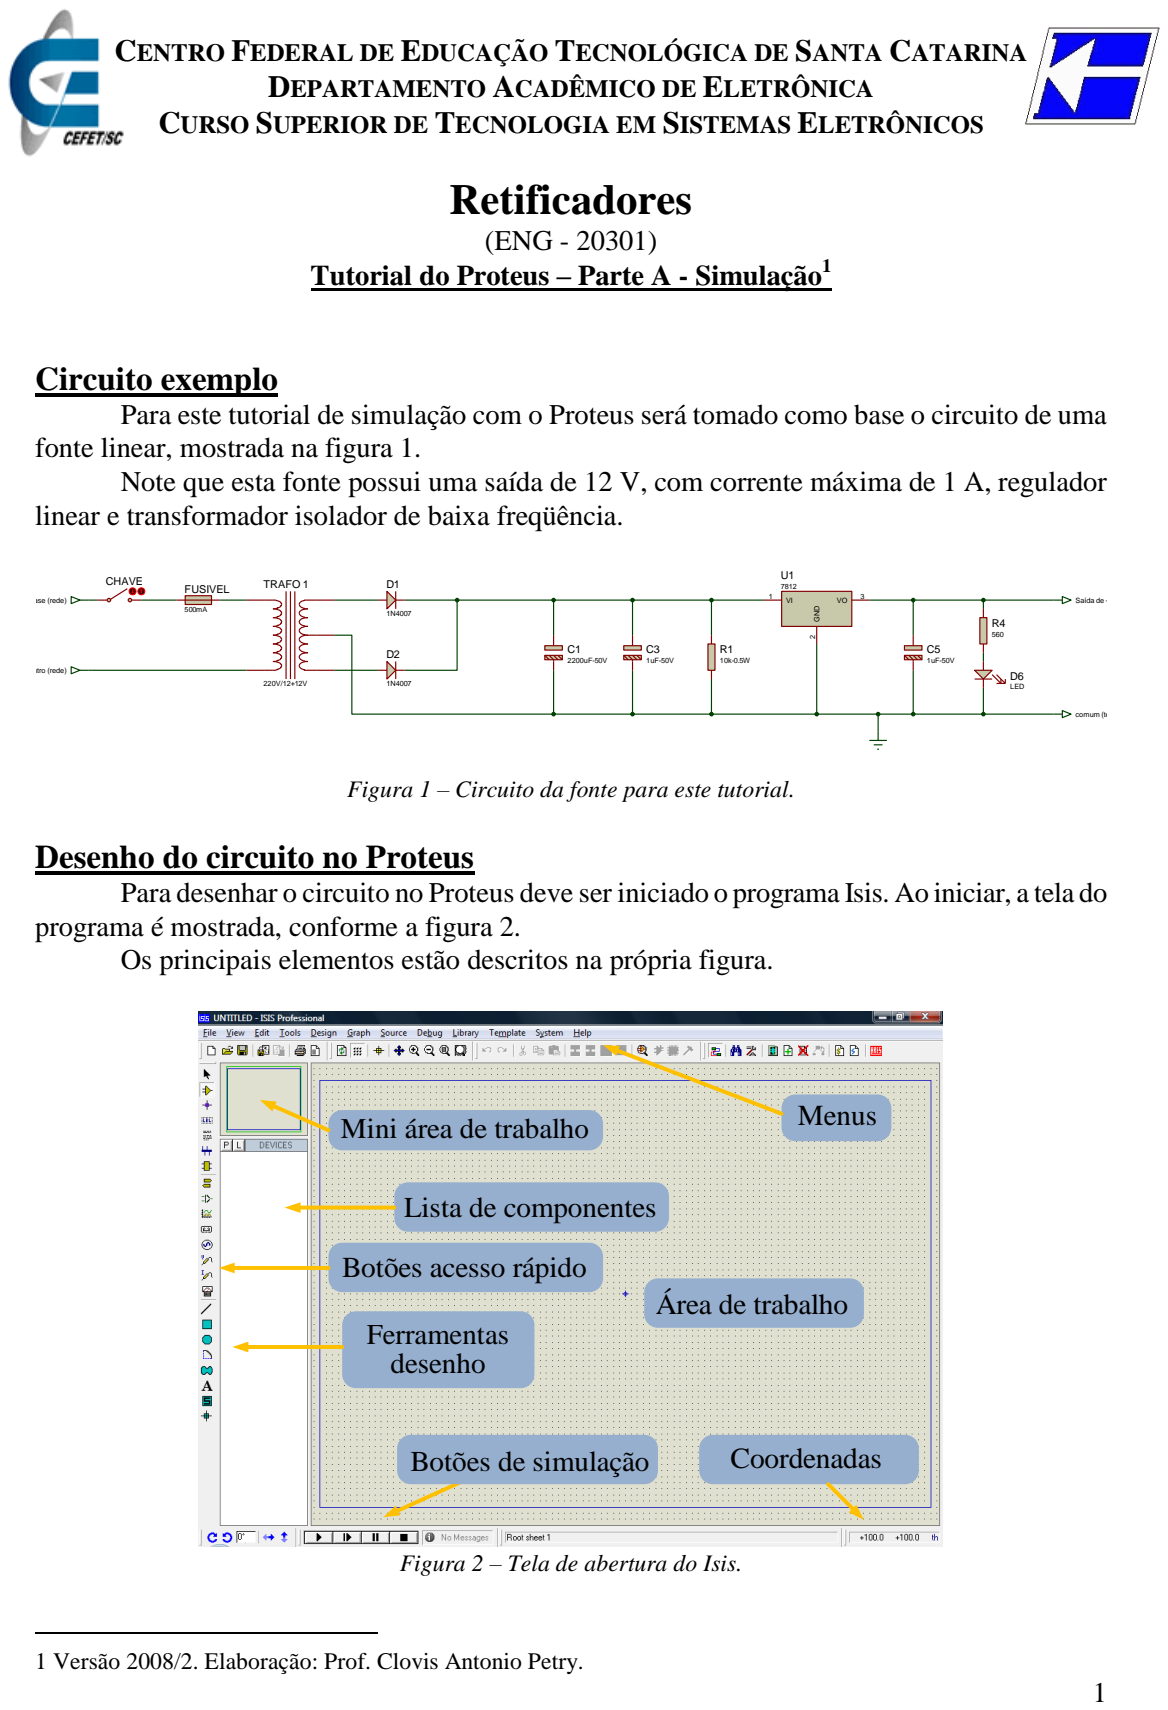
[picture p165: page 1]

CENTRO FEDERAL DE EDUCAÇÃO TECNOLÓGICA DE SANTA CATARINA

DEPARTAMENTO ACADÊMICO DE ELETRÔNICA

CURSO SUPERIOR DE TECNOLOGIA EM SISTEMAS ELETRÔNICOS

Tutorial do Proteus – Parte A - Simulação¹

Para este tutorial de simulação com o Proteus será tomado como base o circuito de uma

fonte linear, mostrada na figura 1.

Note que esta fonte possui uma saída de 12 V, com corrente máxima de 1 A, regulador

linear e transformador isolador de baixa freqüência.

Figura 1 – Circuito da fonte para este tutorial.

Desenho do circuito no Proteus

Para desenhar o circuito no Proteus deve ser iniciado o programa Isis. Ao iniciar, a tela do

programa é mostrada, conforme a figura 2.

Os principais elementos estão descritos na própria figura.

Figura 2 – Tela de abertura do Isis.

1 Versão 2008/2. Elaboração: Prof. Clovis Antonio Petry.

2

O primeiro passo é a busca dos componentes na biblioteca do Proteus. Para isso deve ser selecionado o botão adequado e depois teclar no botão com a letra P (pick), como está mostrado na figura 3.

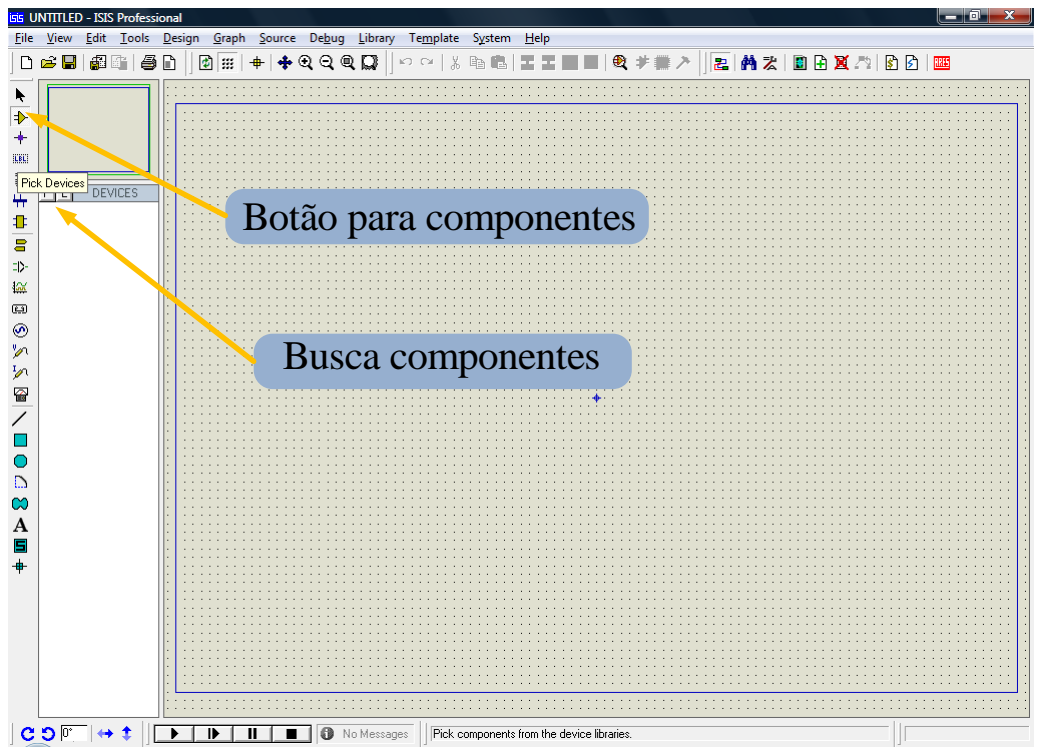
[picture p166: figure]

Botão para componentes Busca componentes

Figura 3 – Busca de componentes.

A tela que aparece ao ser acionado o botão para busca de componentes é mostrada na figura 4, com a descrição das principais partes desta tela. Na figura 5 mostra-se um exemplo para um componente clássico. Notar que é possível visualizar o símbolo do componente e seu encapsulamento, o que será fundamental para o desenho da placa de circuito impresso (PCB).

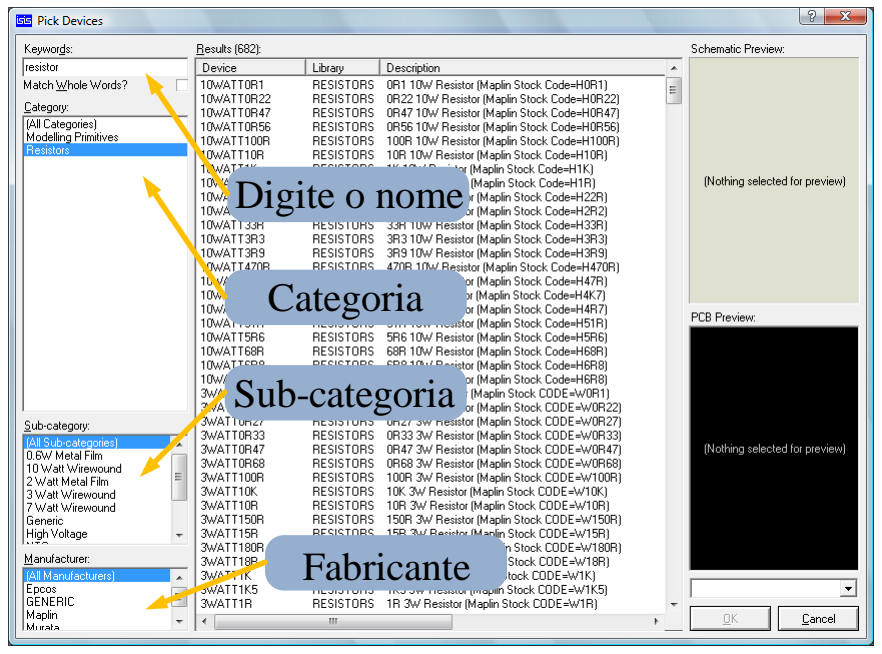
[picture p167: figure]

### Digite o nome Categoria Sub-categoria Fabricante

Figura 4 – Tela de busca de componentes.

3

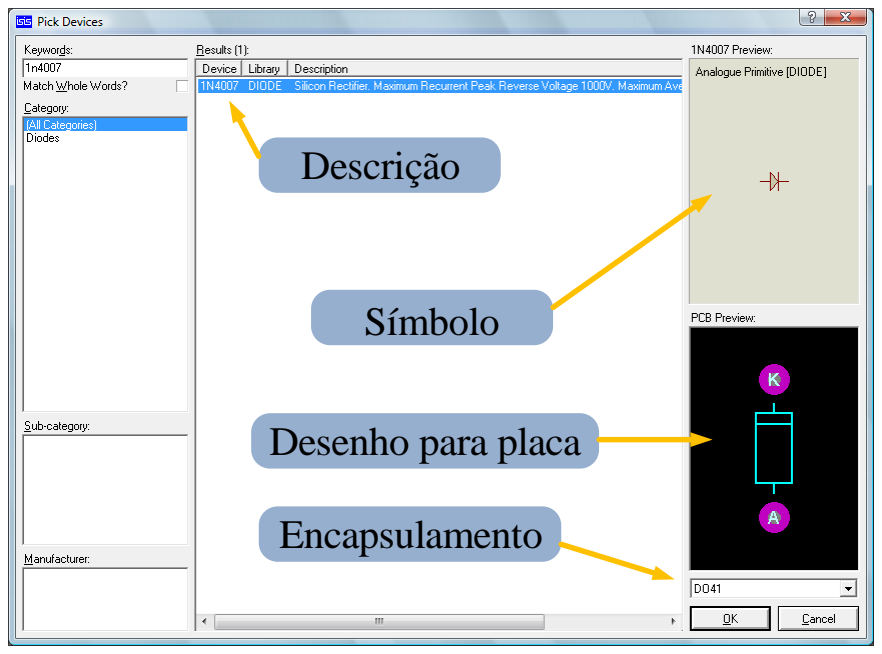
[picture p168: figure]

### Descrição Símbolo Desenho para placa Encapsulamento

Figura 5 – Exemplo de um componente clássico da biblioteca do Proteus.

Os componentes podem ser buscados e selecionados todos antes da colocação no circuito. Isto é feito clicando duas vezes sobre o componente selecionado, sem fechar a janela de busca de componentes. Localize os componentes conforme a tabela abaixo:

Descrição | Componente | Encapsulamento
Diodo 1N4007 | 1N4007 | DO41
Fonte de tensão | VSINE | Não tem
Conector de dois pinos | CONN-SIL2 | CONN-SIL2
Chave liga-desliga | SWITCH | Não tem
Fusível | FUSE | Não tem
Transformador | TRAN-2P3S | Não tem
Conector de três pinos | CONN-SIL3 | CONN-SIL3
Capacitor de 2200 μF x 50 V | HITEMP2200U50V | ELEC-RAD30
Capacitor de 1 μF x 100 V | HITEMP1U100V | ELEC-RAD10
Resistor de 10 kΩ x ½ W | Resistor genérico | RES40
Regulador de tensão | LM7812 | P1
Resistor de 560 Ω x1/8 W | Resistor genérico | RES40
Led convencional | LED-BLUE | LED

Ao posicionar os componentes no circuito, você poderá girá-los antes ou depois do posicionamento. Na figura 6 são mostradas as teclas usadas para o rotacionamento antes de soltá-los no circuito.

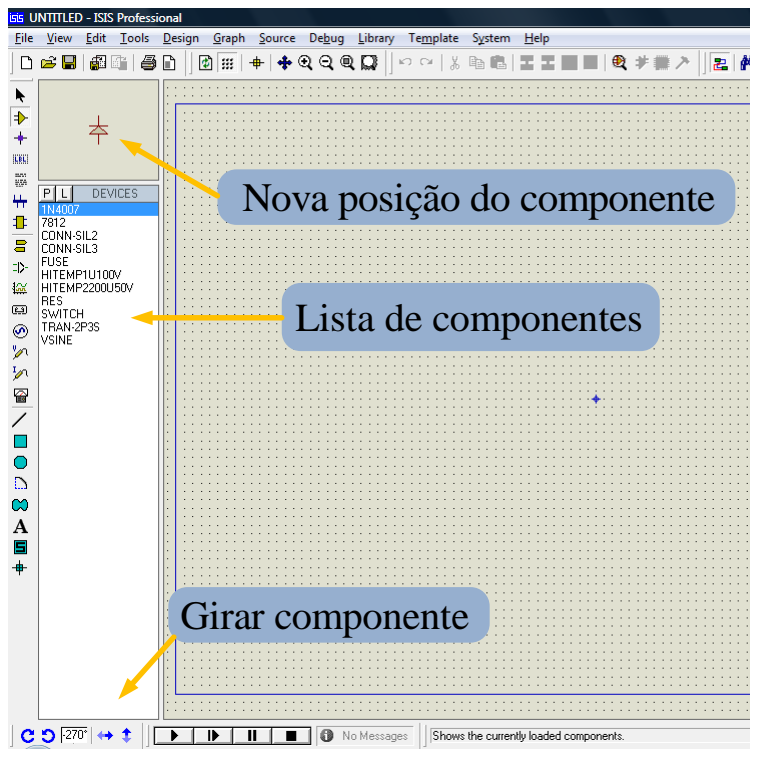
[picture p169: figure]

4

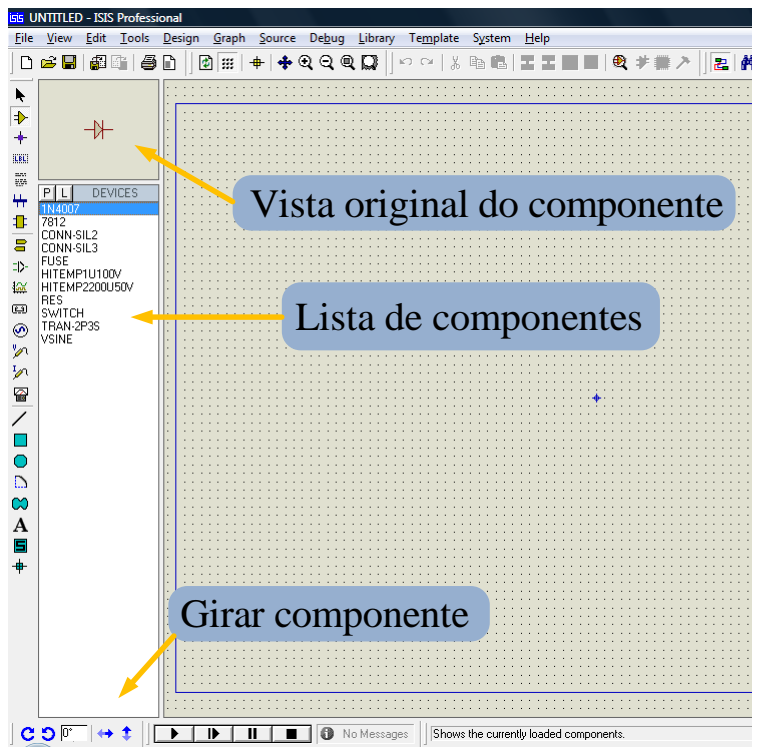
[picture p170: figure]

Vista original do componente Girar componente Lista de componentes

Figura 6 – Girando componentes antes de posicionar os mesmos no circuito.

Girar componente Nova posição do componente Lista de componentes

Figura 7 – Girando componentes antes de posicionar os mesmos no circuito.

Se o componente for posicionado antes de ser girado, pode ainda ser girado livremente após sua colocação. Isto será feito usando as ferramentas mostradas na figura 8.

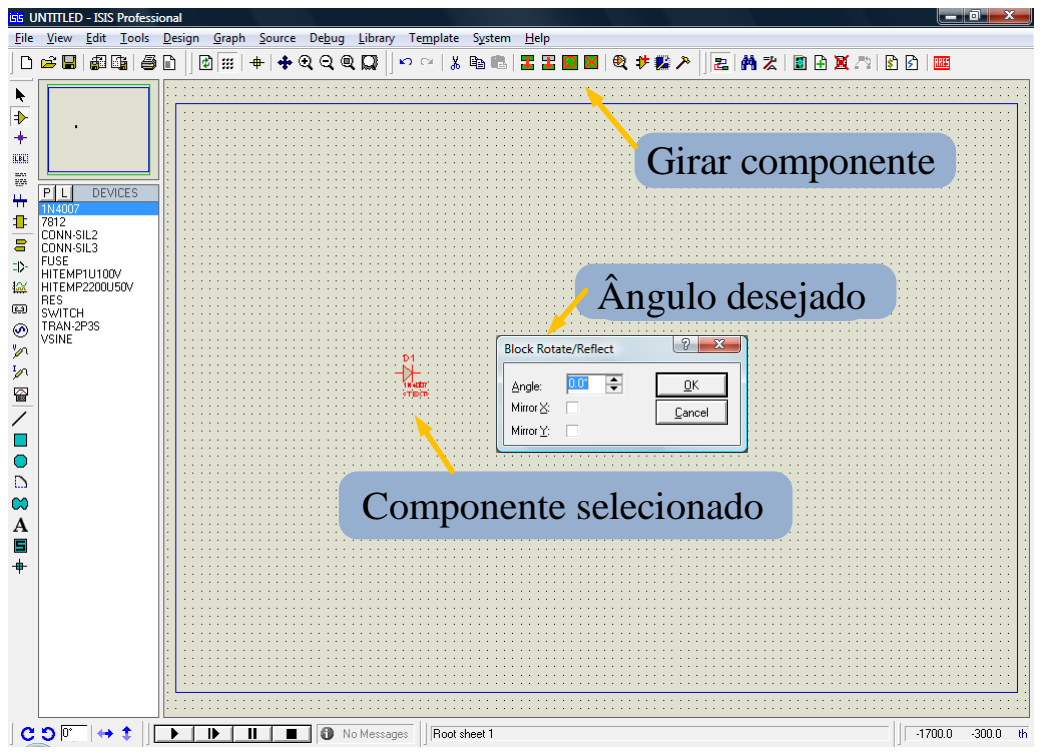
[picture p171: figure]

Girar componente Componente selecionado Ângulo desejado

Figura 8 – Girando componentes depois de posicionar os mesmos no circuito.

Ao desenhar circuitos maiores, o tamanho da folha (retângulo azul) pode não ser suficientemente grande para permitir a colocação de todos os componentes. Se isso ocorrer, o tamanho da folha pode ser alterado conforme a figura 9.

5

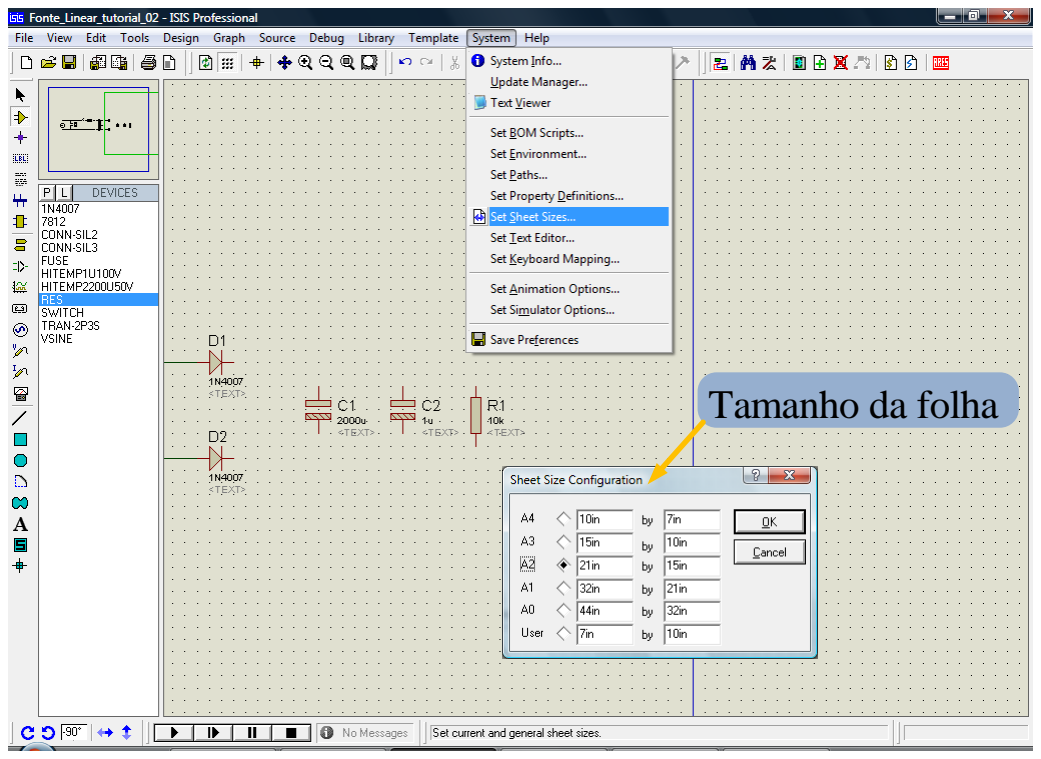
[picture p172: figure]
Tamanho da folha

Figura 9 – Alterando o tamanho da folha.

Muitas vezes pode ser necessário repetir algum componente ou parte do circuito. O Proteus possui ferramentas para copiar componentes ou parte do circuito, como está mostrado na figura 10.

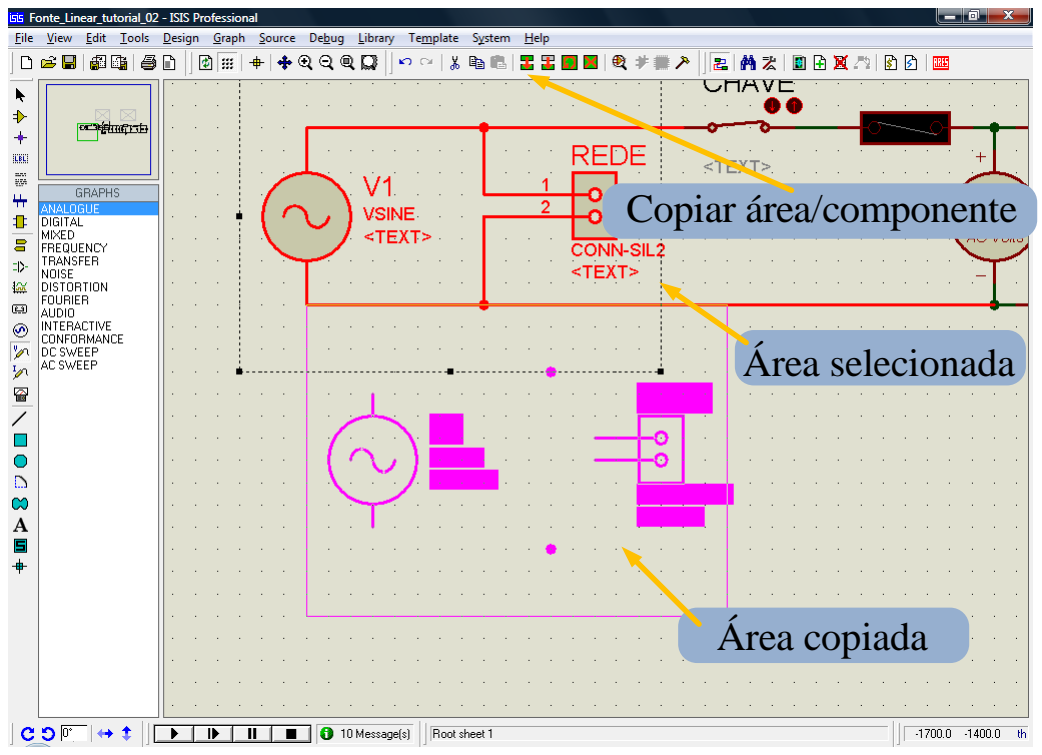
[picture p173: figure]

Área selecionada Área copiada Copiar área/componente

Figura 10 – Copiando componentes/circuito.

Para mover componentes ou partes do circuito, estes devem ser selecionados (ficando na cor vermelha) e em seguida arrastados para o local desejado. Notar que as conexões permanecem inalteradas.

Os componentes posicionados e conectados devem ter suas características alteradas conforme as figuras a seguir.

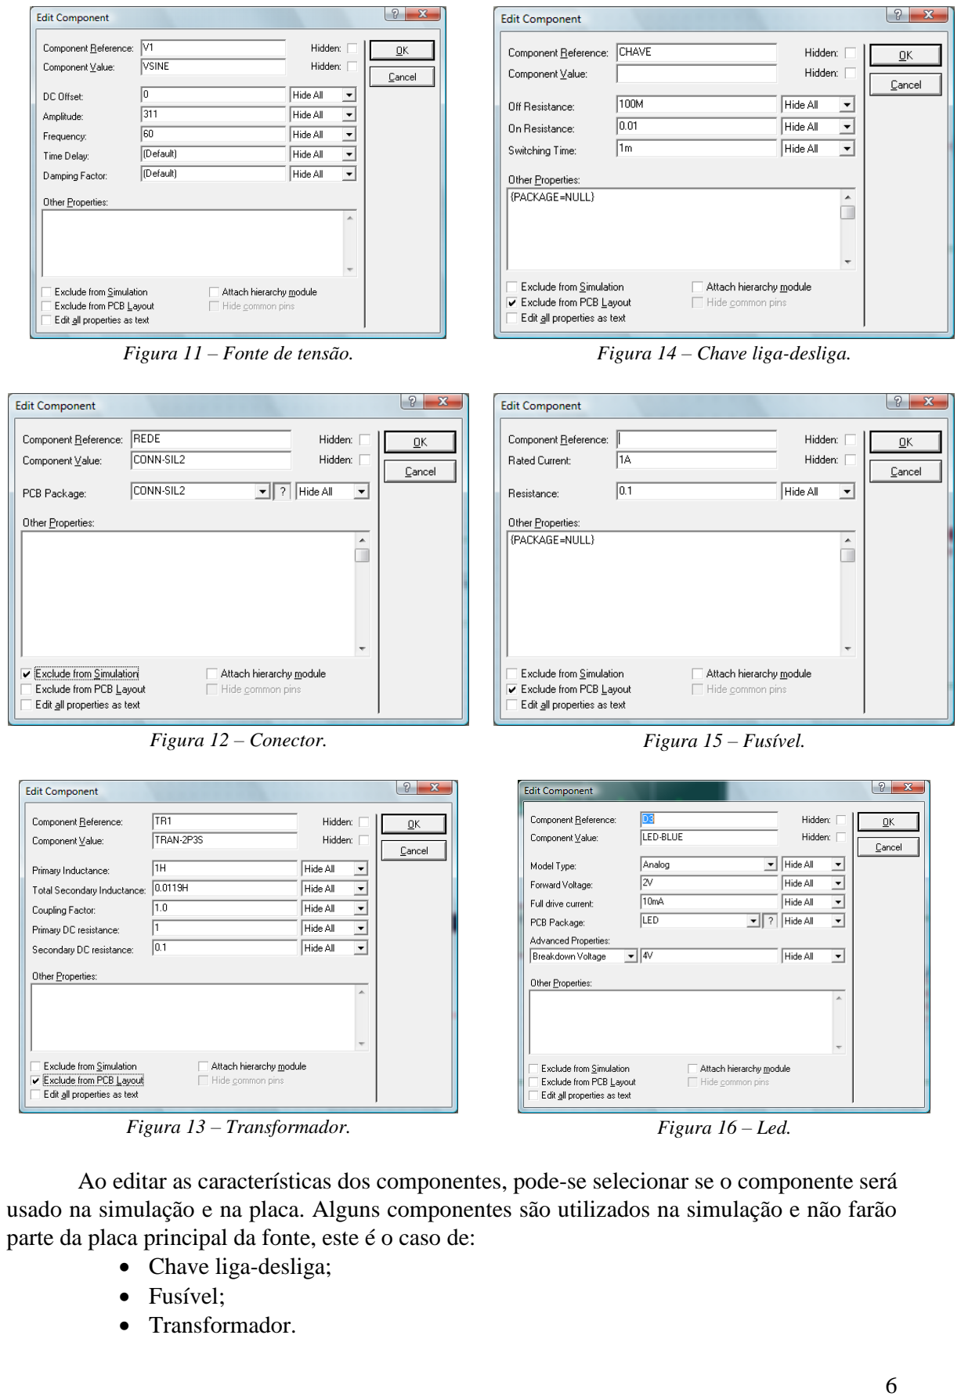
[picture p174: page 6]

6

Figura 11 – Fonte de tensão.

Figura 12 – Conector.

Figura 13 – Transformador.

Figura 14 – Chave liga-desliga.

Figura 15 – Fusível.

Figura 16 – Led.

Ao editar as características dos componentes, pode-se selecionar se o componente será usado na simulação e na placa. Alguns componentes são utilizados na simulação e não farão parte da placa principal da fonte, este é o caso de:
- Chave liga-desliga;
- Fusível;
- Transformador.

7

Outros componentes serão utilizados na placa e não na simulação:
- Conectores.

Instrumentos de medida, fontes de alimentação e outros elementos usados durante a simulação não são usados na placa de circuito impresso.
Após posicionar os componentes no circuito, os mesmos devem ser conectados entre si, conforme mostrado na figura 17. É importante notar que nas conexões (nós) do circuito, deve aparecer explicitamente o círculo indicando a conexão, caso contrário poderá ocorrer erros na simulação.
Ao terminar o desenho do circuito e antes de iniciar a simulação, deve ser identificado o ponto de referência do circuito, ou seja, a massa ou terra, como está mostrado na figura 18. Para visualizar o valor das variáveis do circuito, instrumentos de medida devem ser posicionados em posições adequadas como é mostrado na figura 19.

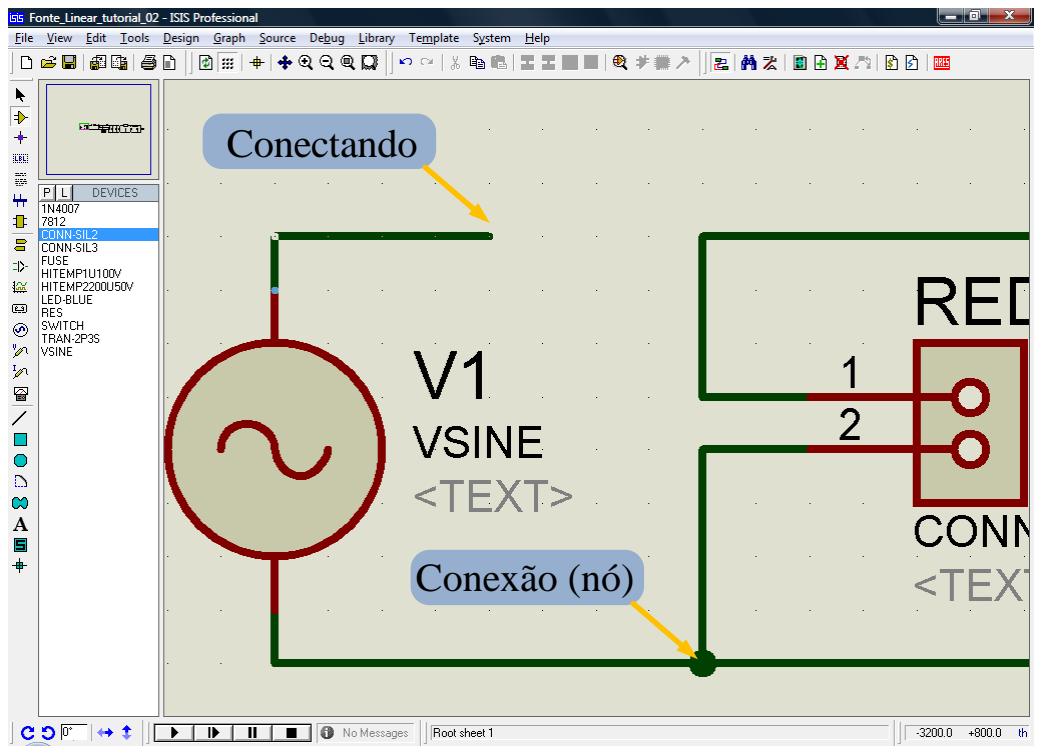
[picture p175: figure]
Conexão (nó) Conectando

Figura 17 – Conectando os componentes.

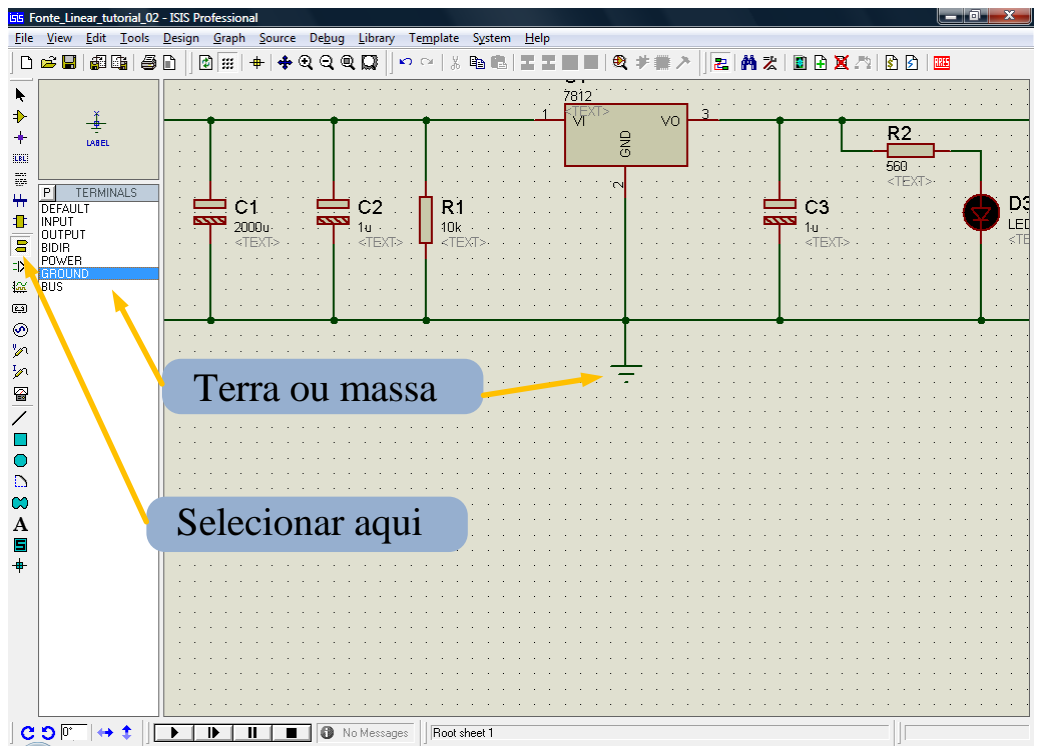
[picture p176: figure]
Terra ou massa Selecionar aqui

Figura 18 – Massa ou terra (referência) do circuito.

8

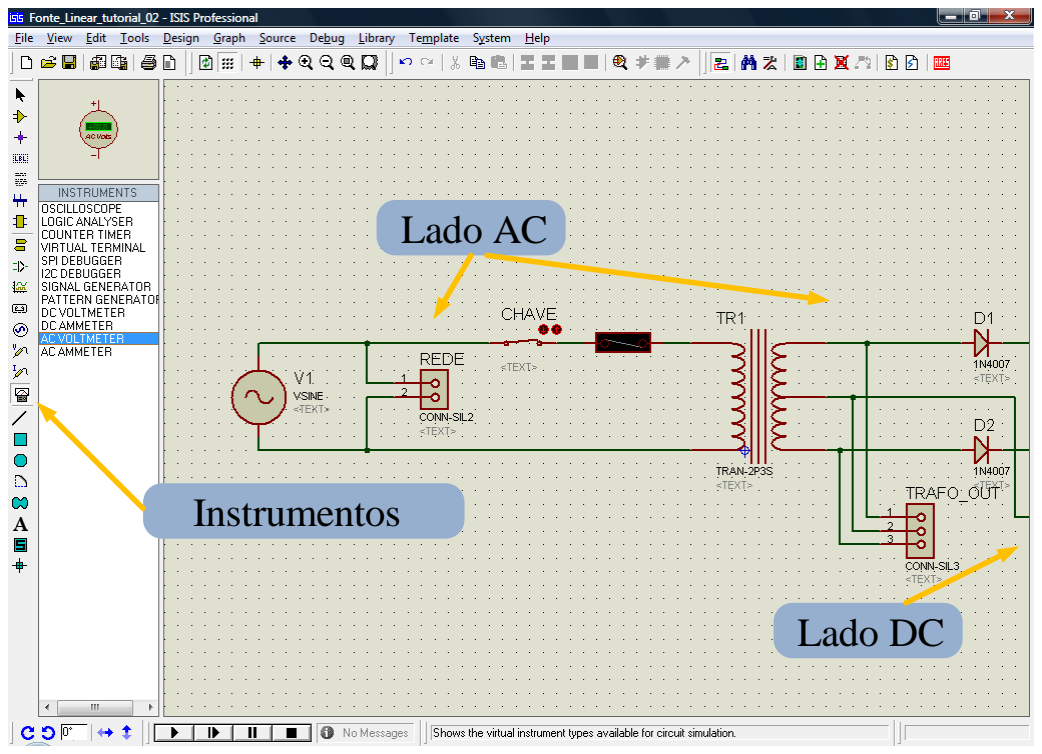
[picture p177: figure]
InstrumentosLado AC; Lado DC

Figura 19 – Inserindo instrumentos de medida ao circuito.

Simulação do circuito
Após a colocação dos instrumentos, a simulação pode ser iniciada. O Proteus possui duas formas distintas de simular um circuito:
- Simulação interativa;
- Simulação seqüencial (iterativa sem interação).

A primeira forma, mostrada na figura 20, permite a interação entre usuário e software, ou seja, chaves podem ser abertas ou fechadas, leds aparecem ligados ou não, etc.
A segunda forma permite traçar gráficos em função do tempo ou não, mas não permite interação com o usuário. Os instrumentos mostrados na figura 20, e o osciloscópio mostrado na figura 24 são exemplos de instrumentos para simulação interativa. Note que a tensão de saída do transformador é maior do que a esperada, então deve ser ajustada a indutância do secundário para que a saída seja de 24 V quando a rede estiver em 220 V.

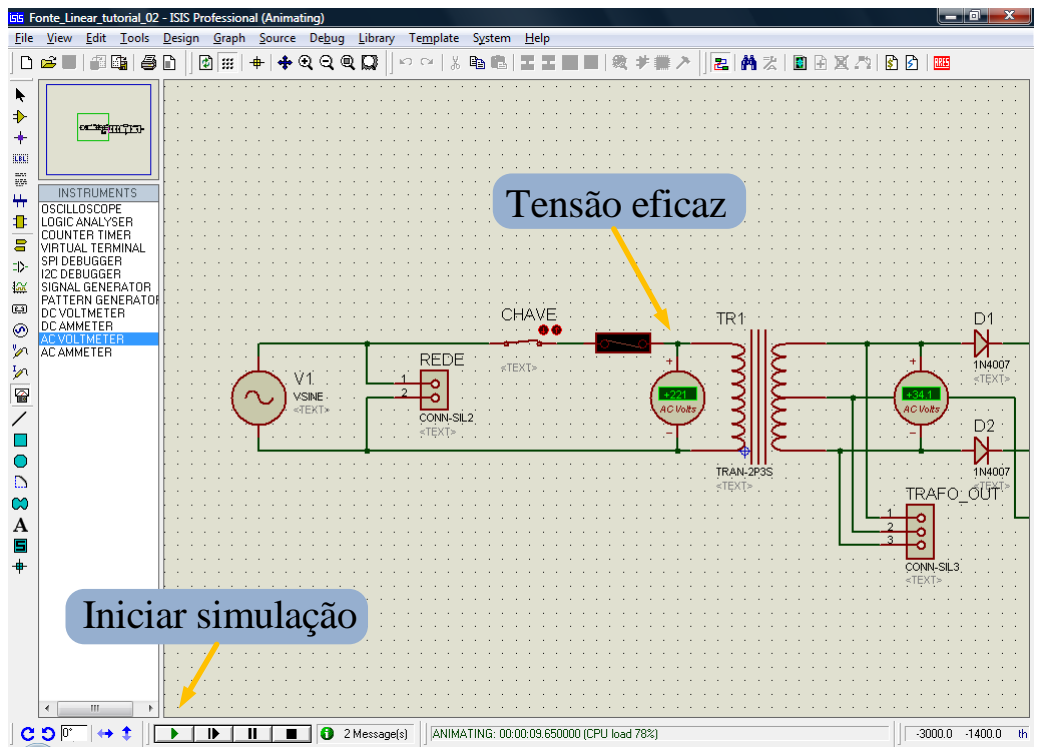
[picture p178: figure]
Iniciar simulação; Tensão eficaz

Figura 20 – Iniciando a simulação.

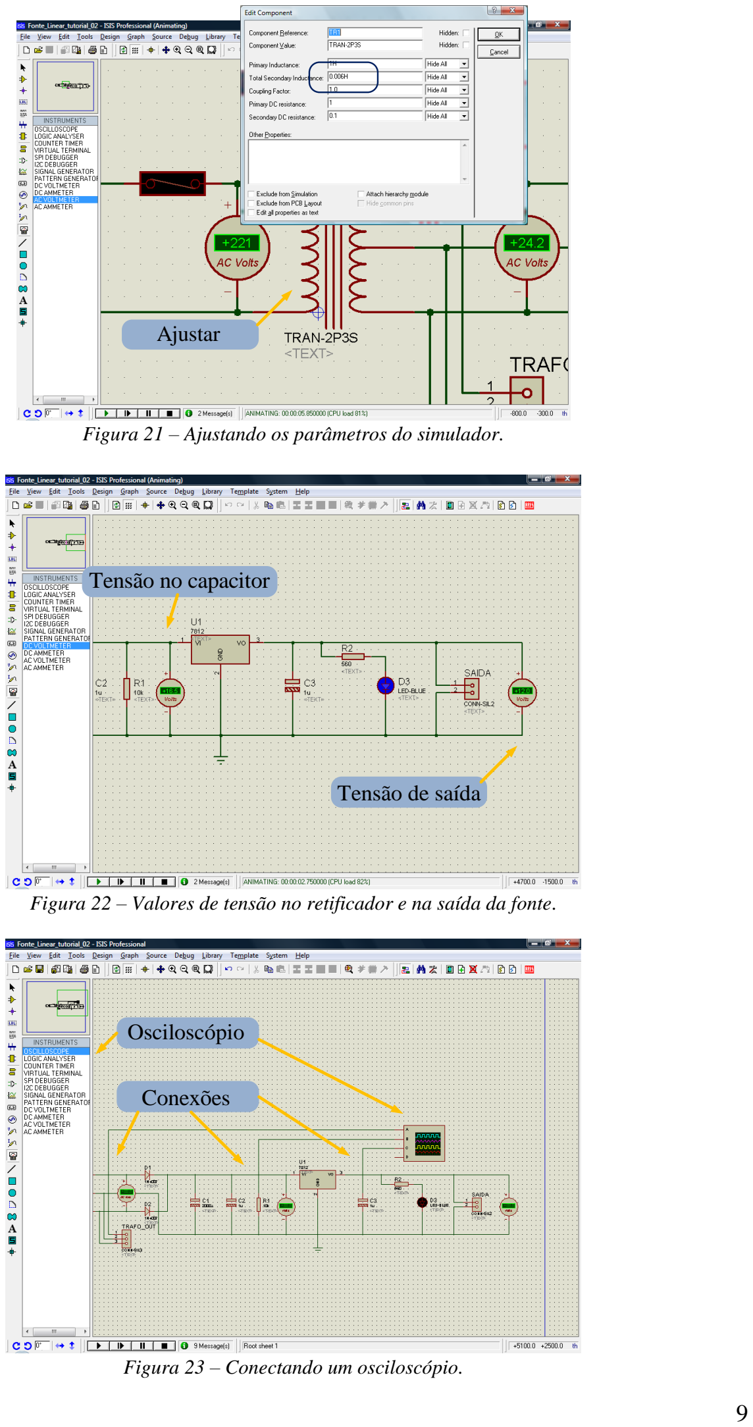
[picture p179: page 9]

9

Ajustar

Figura 21 – Ajustando os parâmetros do simulador.

Tensão no capacitor | Tensão de saída

Figura 22 – Valores de tensão no retificador e na saída da fonte.

Osciloscópio Conexões

Figura 23 – Conectando um osciloscópio.

10

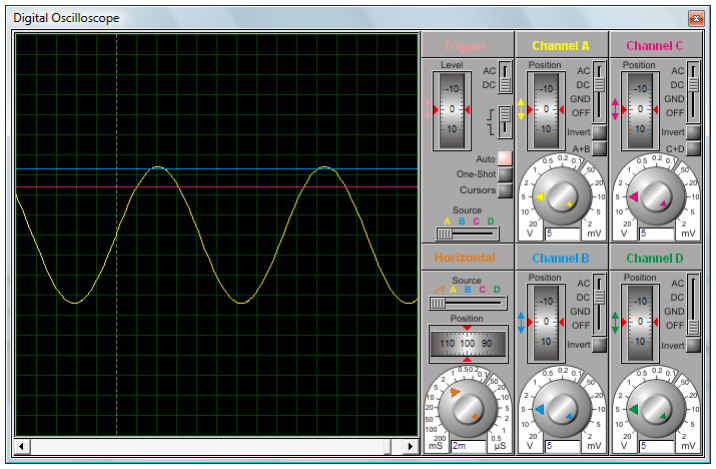
[picture p180: figure]

Figura 24 – Conectando um osciloscópio.

A visualização de formas de onda é muito importante em eletrônica. O osciloscópio pode ser utilizado para esta função, mas não permite a cópia da imagem, adição de muitas formas de onda, etc. Neste caso é mais interessante utilizar um gráfico analógico, com ponteiras posicionadas nos pontos do circuito onde se deseja visualizar a forma de onda, conforme está mostrado na figura 25.

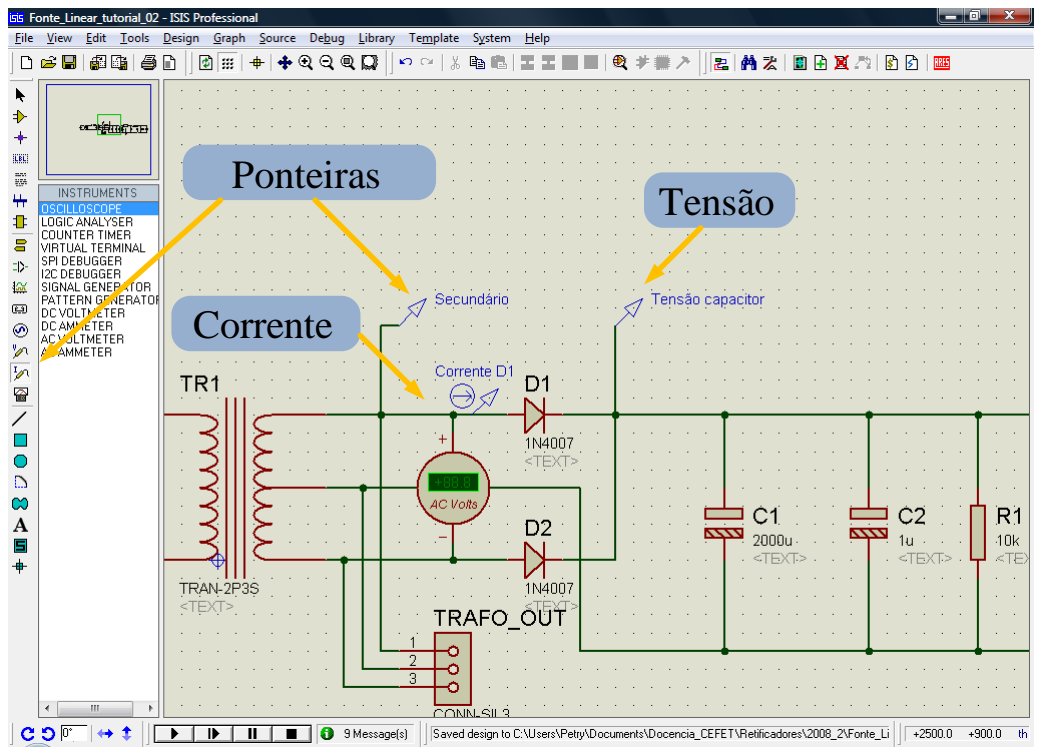
[picture p181: figure]
Ponteiras; Tensão Corrente

Figura 25 – Posicionando ponteiras para visualizar formas de onda.

Em seguida é necessário desejar um retângulo na tela, com o tamanho do gráfico desejado, como na figura 26.

Após isto devem ser determinados os parâmetros da simulação, como por exemplo: tempo inicial, tempo final, etc.

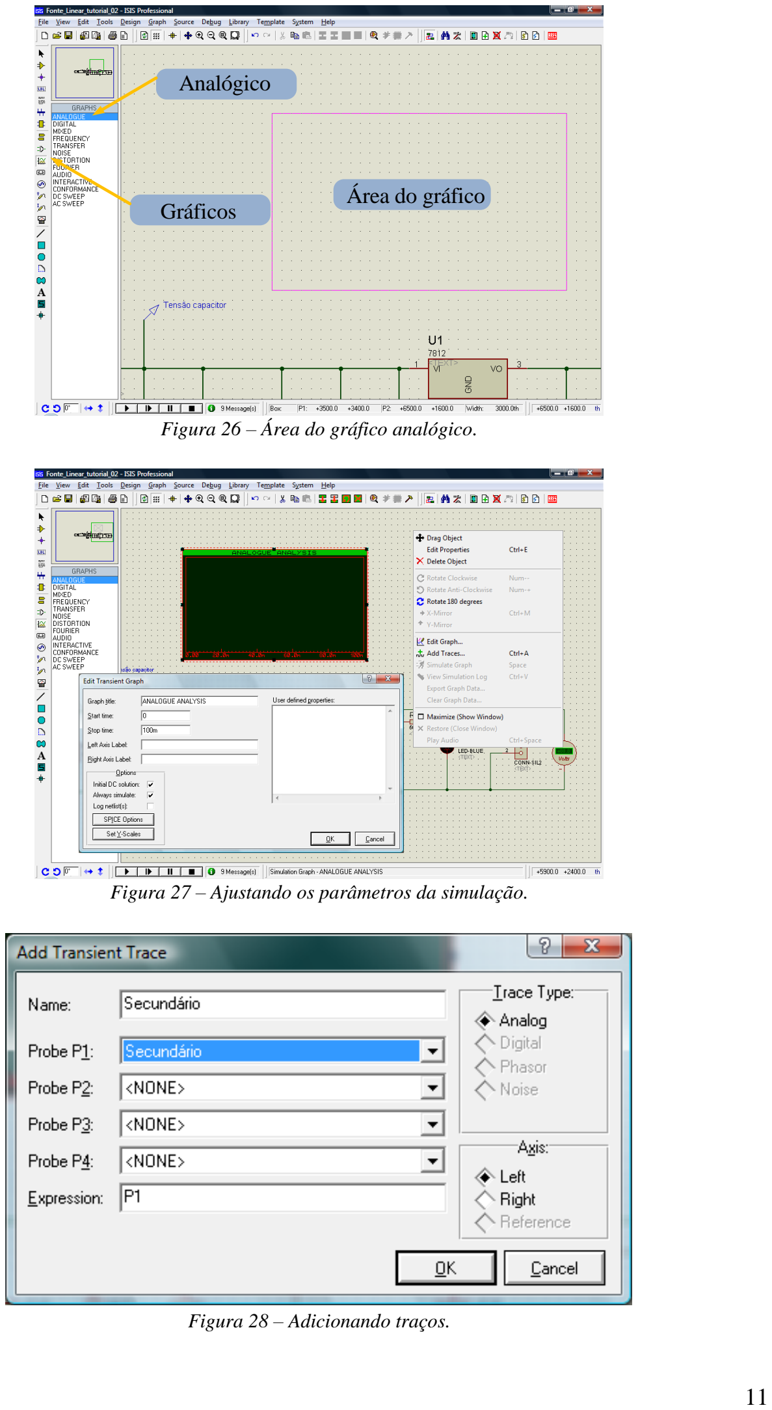
[picture p182: page 11]

11

Gráficos | Área do gráfico Analógico

Figura 26 – Área do gráfico analógico.

Figura 27 – Ajustando os parâmetros da simulação.

Figura 28 – Adicionando traços.

12

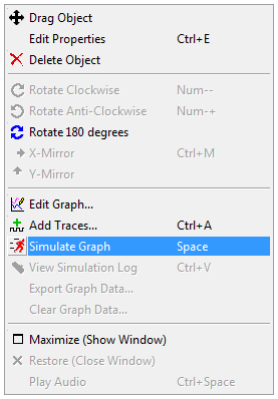
[picture p183: figure]

Figura 29 – Simulando o gráfico.

Ao adicionar traços, como mostrado na figura 28, utilize a cada vez um traço apenas, do contrário as variáveis serão somadas (P1 + P2 + P3 + Pn).
Ao clicar no topo do gráfico analógico, este será mostrado na forma de janela, como está mostrado na figura 30.

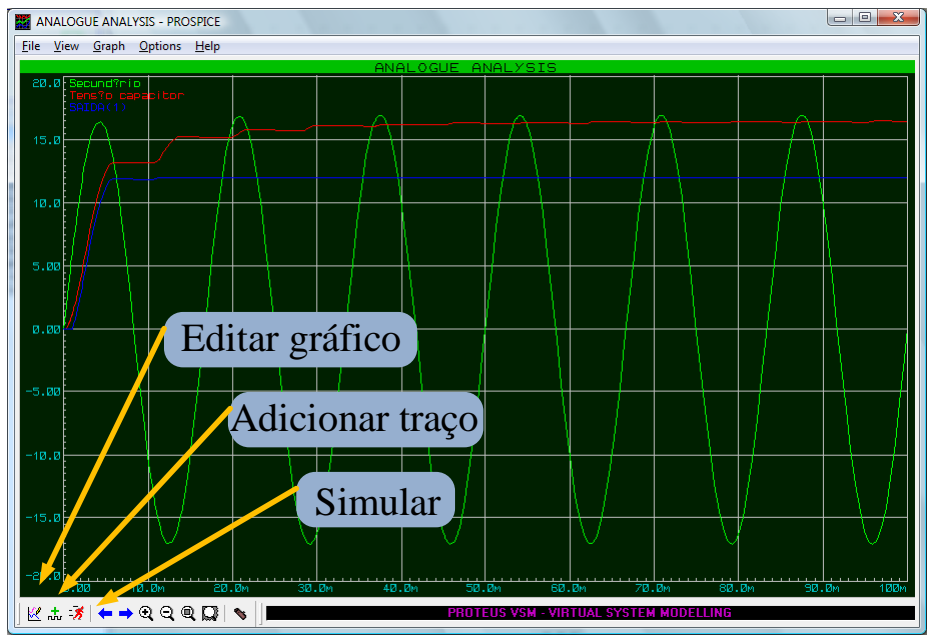
[picture p184: figure]
Editar gráfico Adicionar traço Simular

Figura 30 – Simulando o gráfico.

Ao final, o circuito simulado estará conforme a figura 31.

13

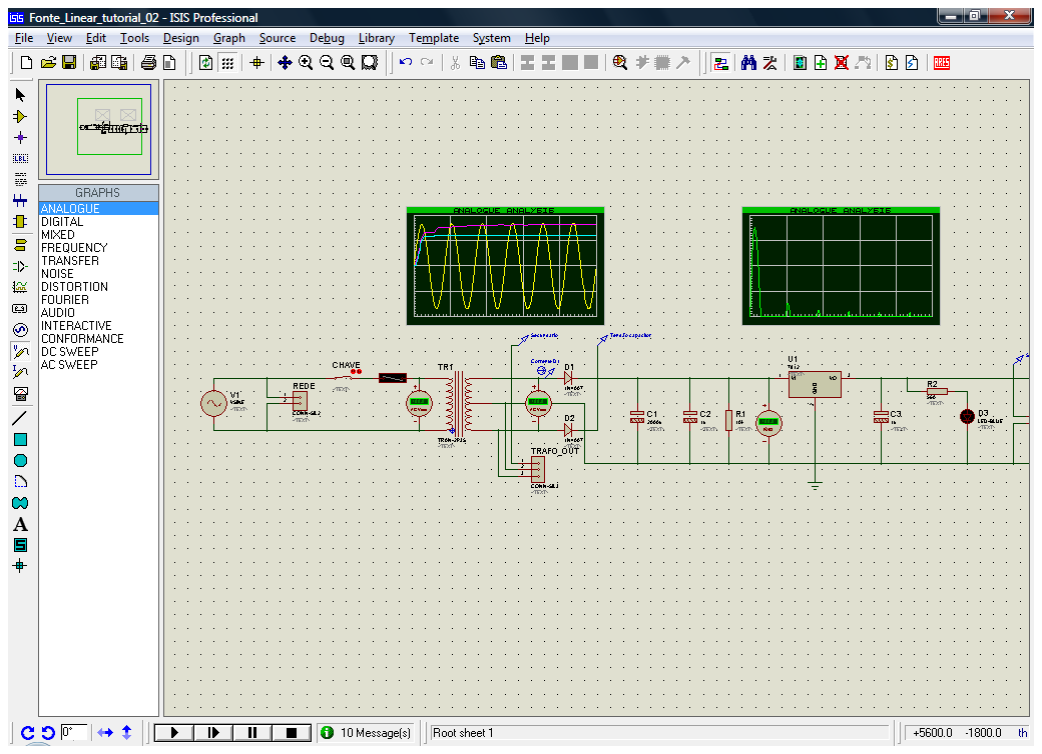
[picture p185: figure]

Figura 31 – Circuito completo.

Problemas de simulação
Alguns problemas freqüentes de simulação que ocorrem no Proteus são:
- Falta de terra no circuito;
- Componentes sem conexão;
- Malhas com indutores, fontes e pouca resistência.

Se o circuito estiver correto e a tentativa de inserir resistências não funcionar, o último recurso é alterar os parâmetros de simulação. Veja na figura 32 como acessar os parâmetros de simulação e os ajustes que podem ser feitos.
O parâmetro Gmin pode ser alterado (diminuído), para, por exemplo, 1e-9. Isto equivale a aumentar a resistência dos componentes, conexões, etc.

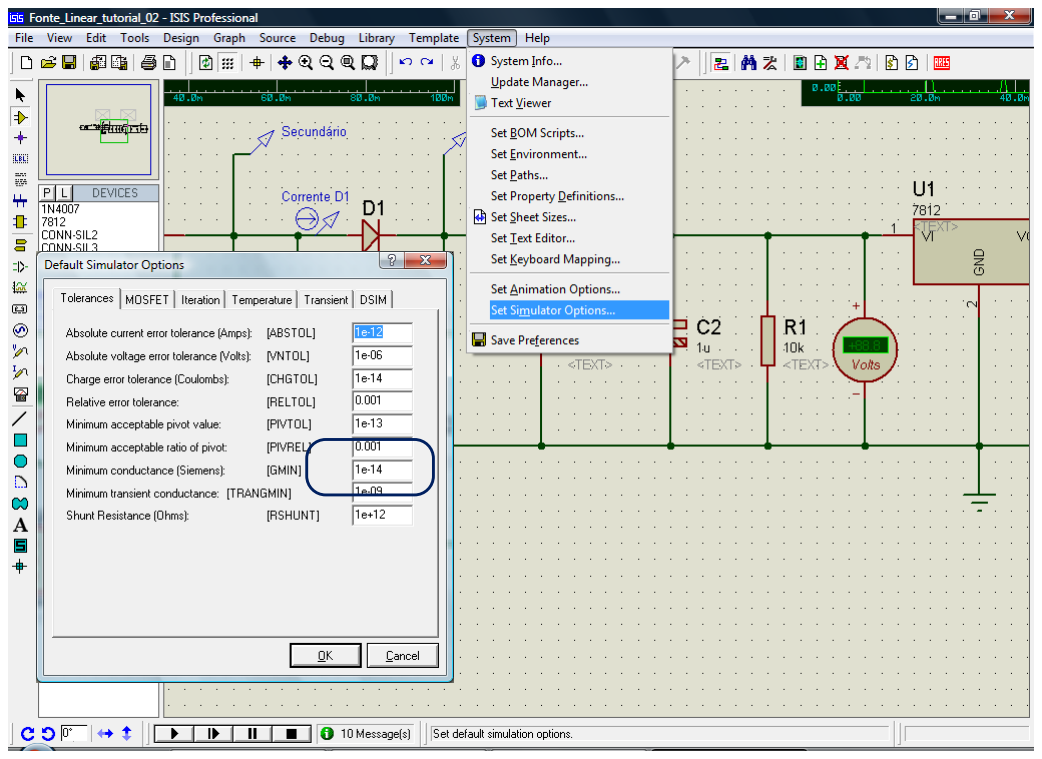
[picture p186: figure]

Figura 32 – Ajustando os parâmetros de simulação.
