Flash-Cart/Flash-Cart-Model/5.Manuais/Manual_Chassi/Documento sem título.docx

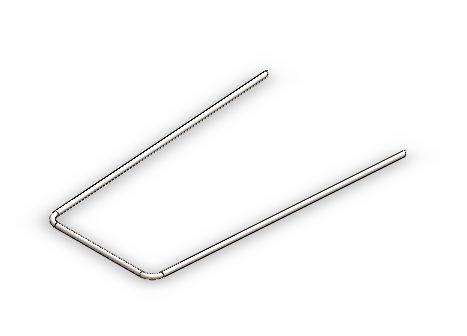
[picture p187: figure]
