Flash-Cart/Flash-Cart-Model/5.Manuais/Manual_Chassi/Manual Chassi.docx

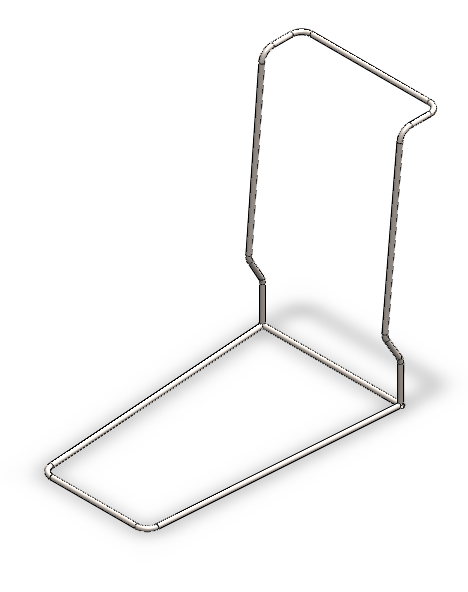
[picture p188: figure]
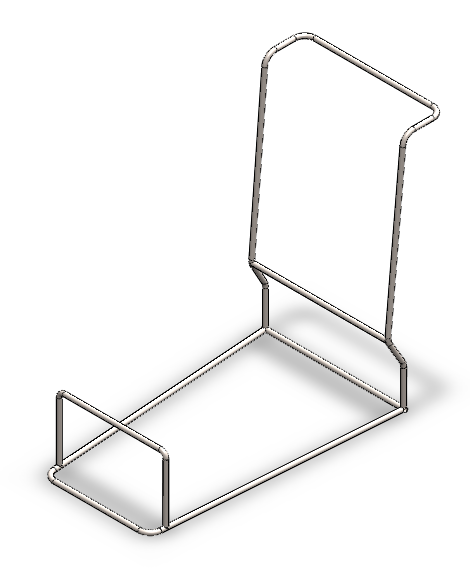
[picture p189: figure]
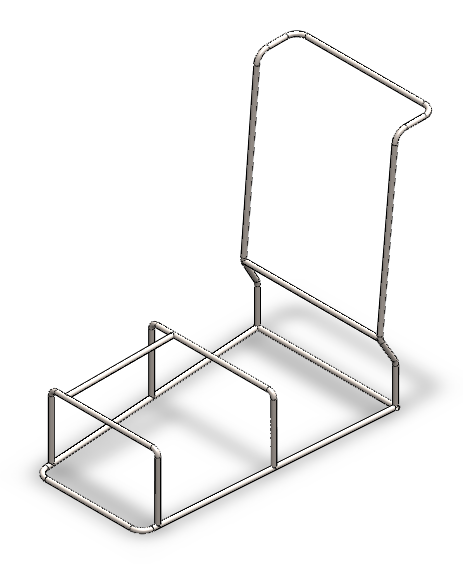
[picture p190: figure]
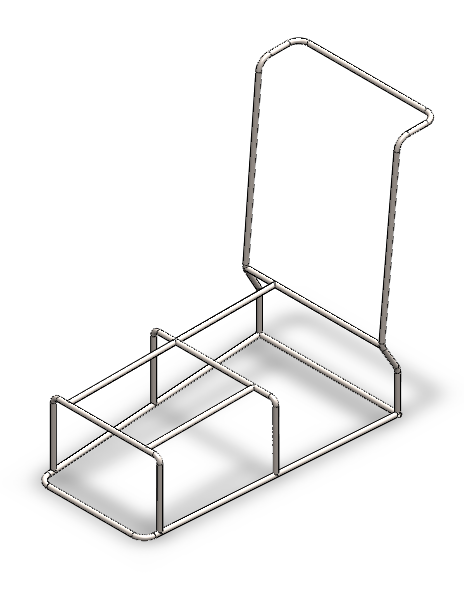
[picture p191: figure]
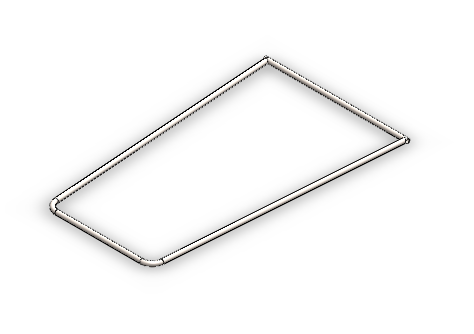
[picture p192: figure]
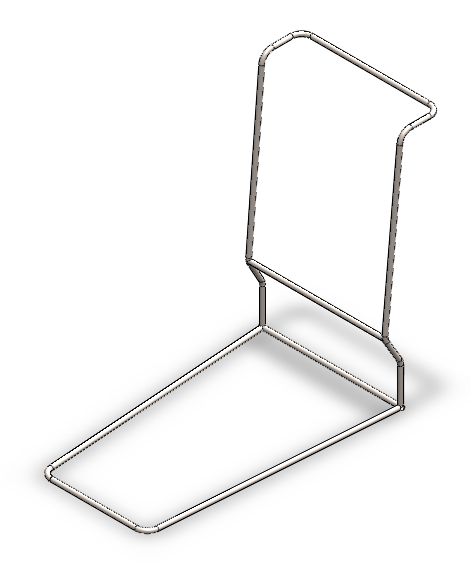
[picture p193: figure]
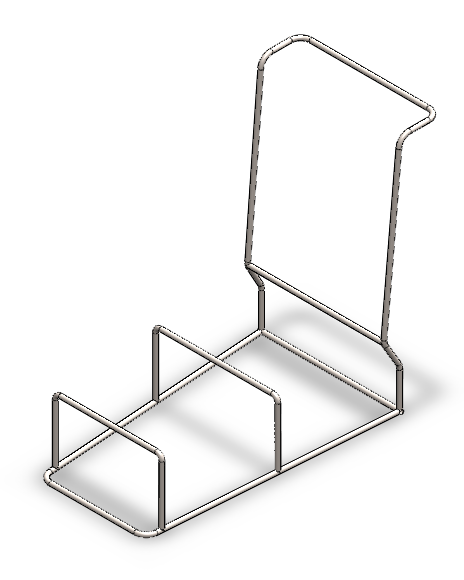
[picture p194: figure]
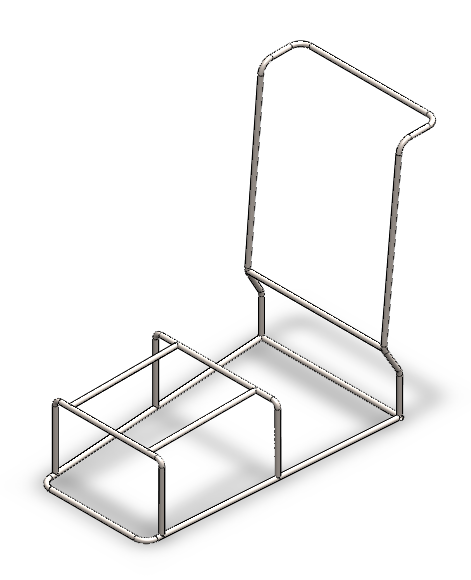
[picture p195: figure]
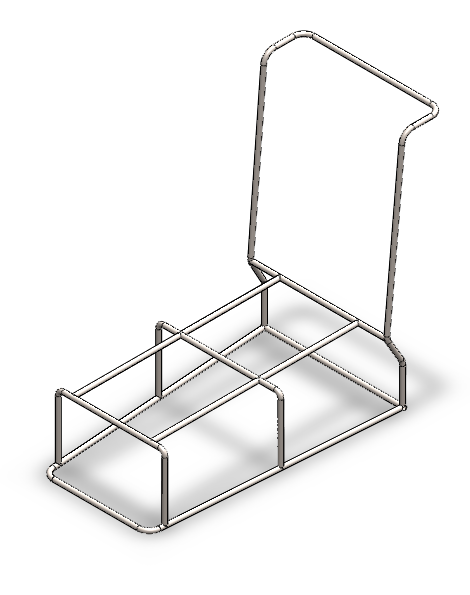
[picture p196: figure]

Etapa 1 Etapa 3 Etapa 5 Etapa 7 Etapa 9 | Etapa 2 Etapa 4 Etapa 6 Etapa 8 Etapa 10
