Flash-Cart/Flash-Cart-Model/5.Manuais/Manual_RodaTraseira/Manual_RodaTraseira.docx

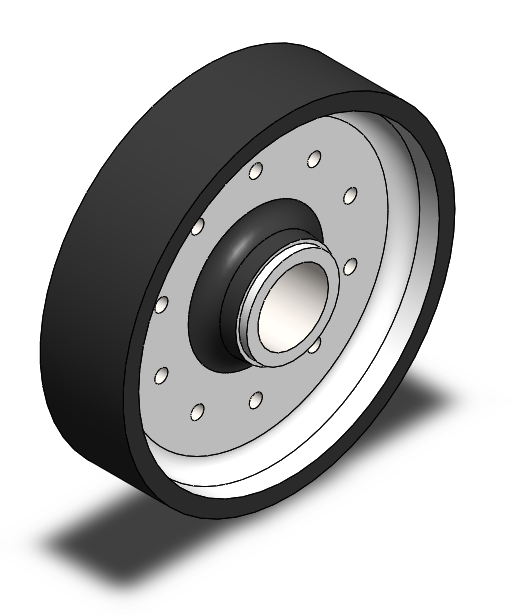
[picture p197: figure]
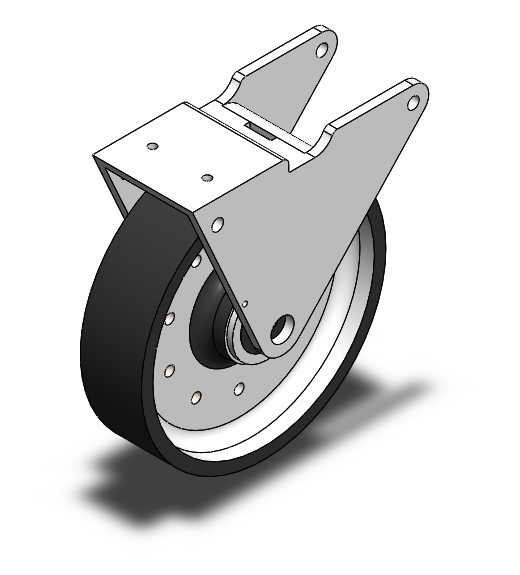
[picture p198: figure]
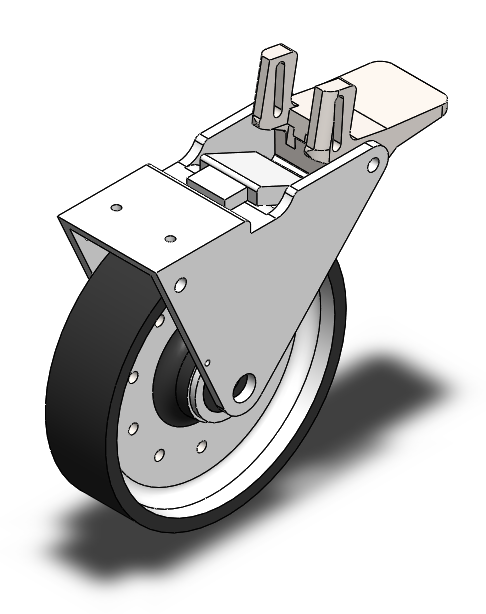
[picture p199: figure]
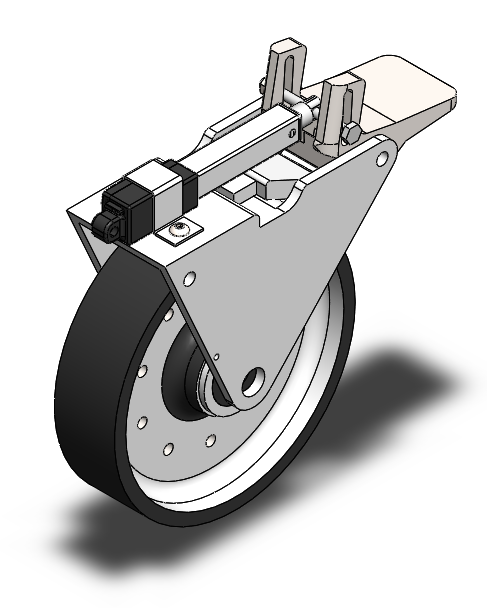
[picture p200: figure]
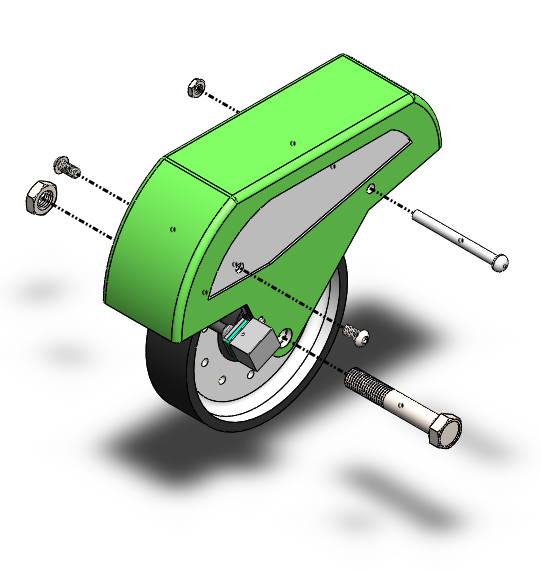
[picture p201: figure]
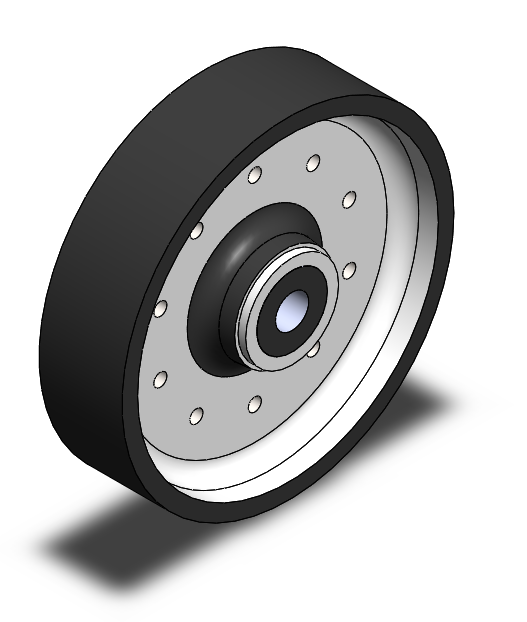
[picture p202: figure]
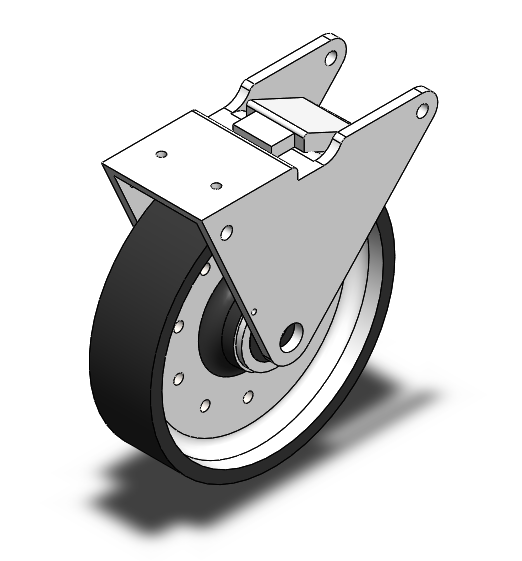
[picture p203: figure]
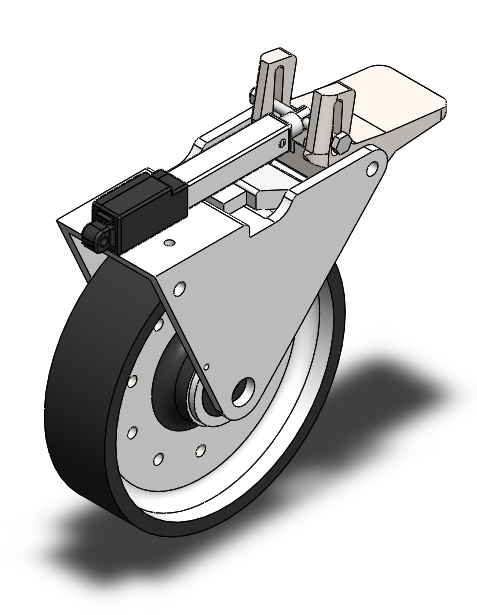
[picture p204: figure]
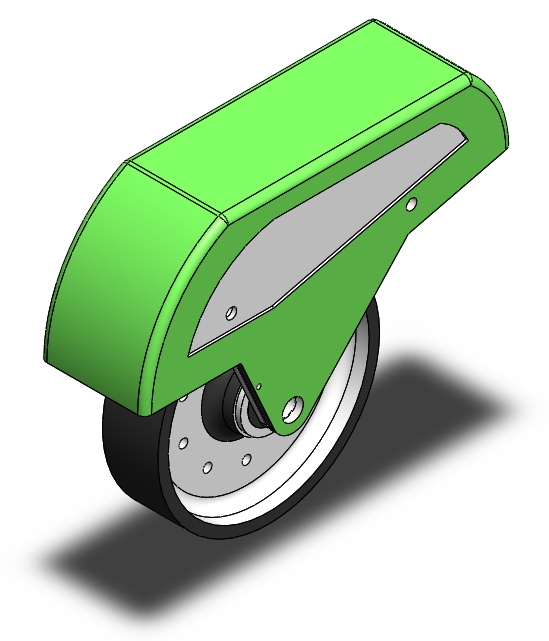
[picture p205: figure]
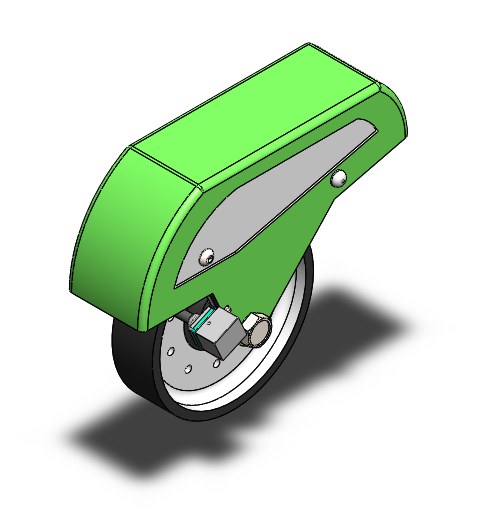
[picture p206: figure]

Etapa 1 Etapa 3 Etapa 5 Etapa 7 Etapa 9 | Etapa 2 Etapa 4 Etapa 6 Etapa 8 Etapa 10
