Flash-Cart/Flash-Cart-Model/2.CADs/Flash Cart Completo Final - 28_04_2021/FLASH CART/Chassi/MontagemChassi_FlashCart_TudoJunto.PNG

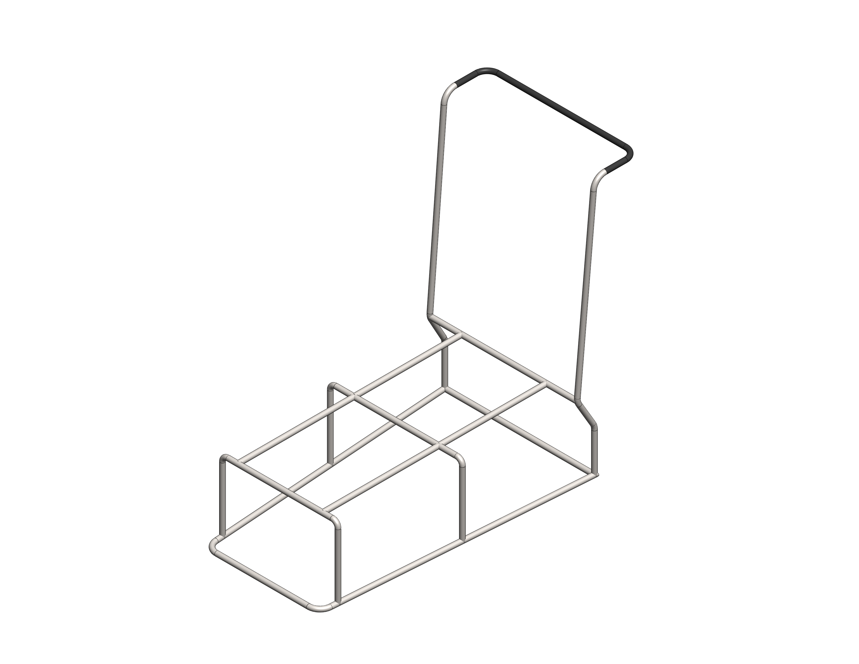
2.CADs/Flash Cart Completo Final - 28_04_2021/FLASH CART/Chassi/MontagemChassi_FlashCart_TudoJunto.PNG
