Flash-Cart/Flash-Cart-Model/5.Manuais/Manual_Chassi/Manual Chassi (1)/Manual Chassi-2.png

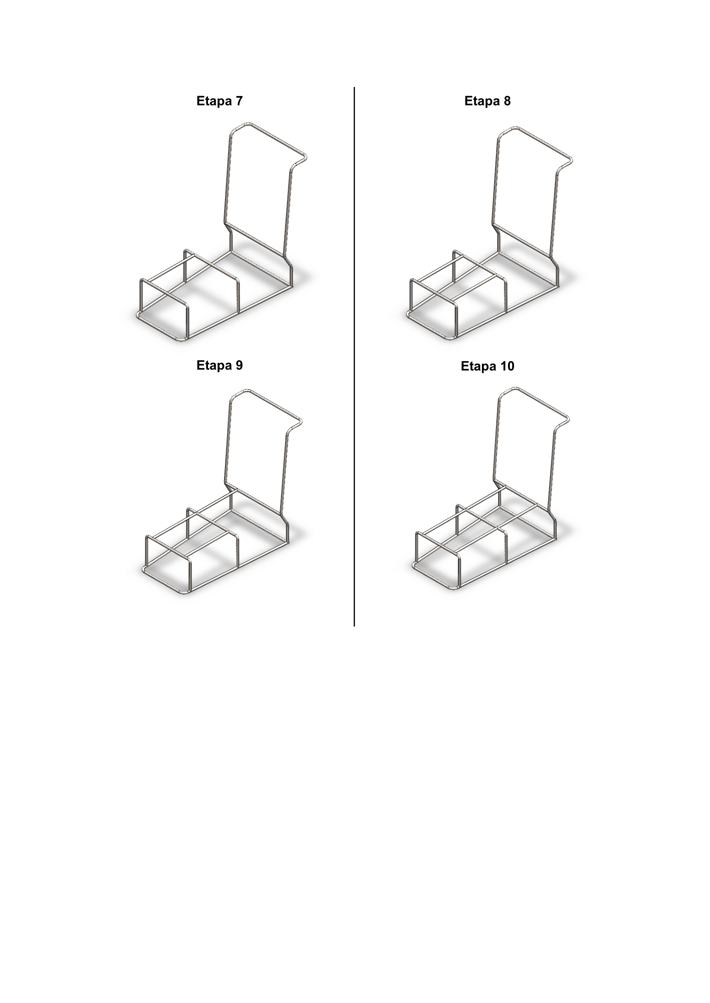
5.Manuais/Manual_Chassi/Manual Chassi (1)/Manual Chassi-2.png
