Flash-Cart/Flash-Cart-Model/9.Eletrônica/Algoritmos/Algoritmo_Calibracao_Manaul.png

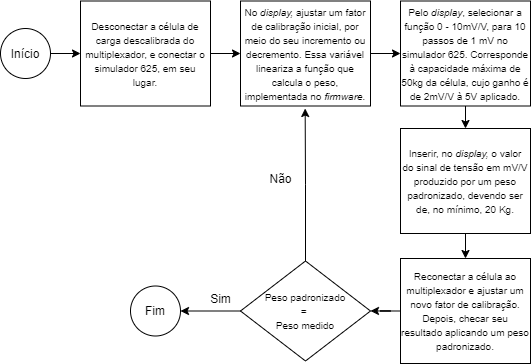
9.Eletrônica/Algoritmos/Algoritmo_Calibracao_Manaul.png
