Flash-Cart/Flash-Cart-Model/9.Eletrônica/Algoritmos/teste_ultrassom.png

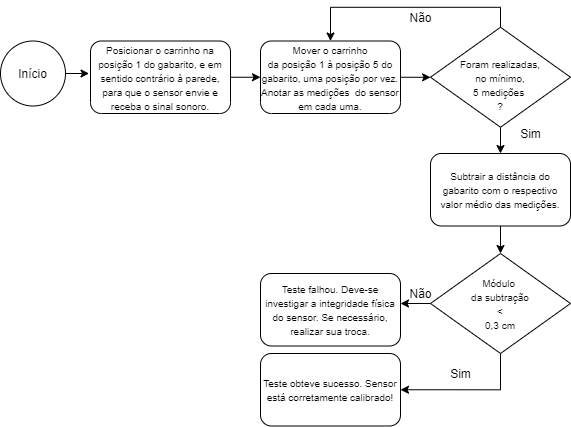
9.Eletrônica/Algoritmos/teste_ultrassom.png
