Flash-Cart/Flash-Cart-Model/5.Manuais/Manual_RodaTraseira/RodaTraseira.pdf

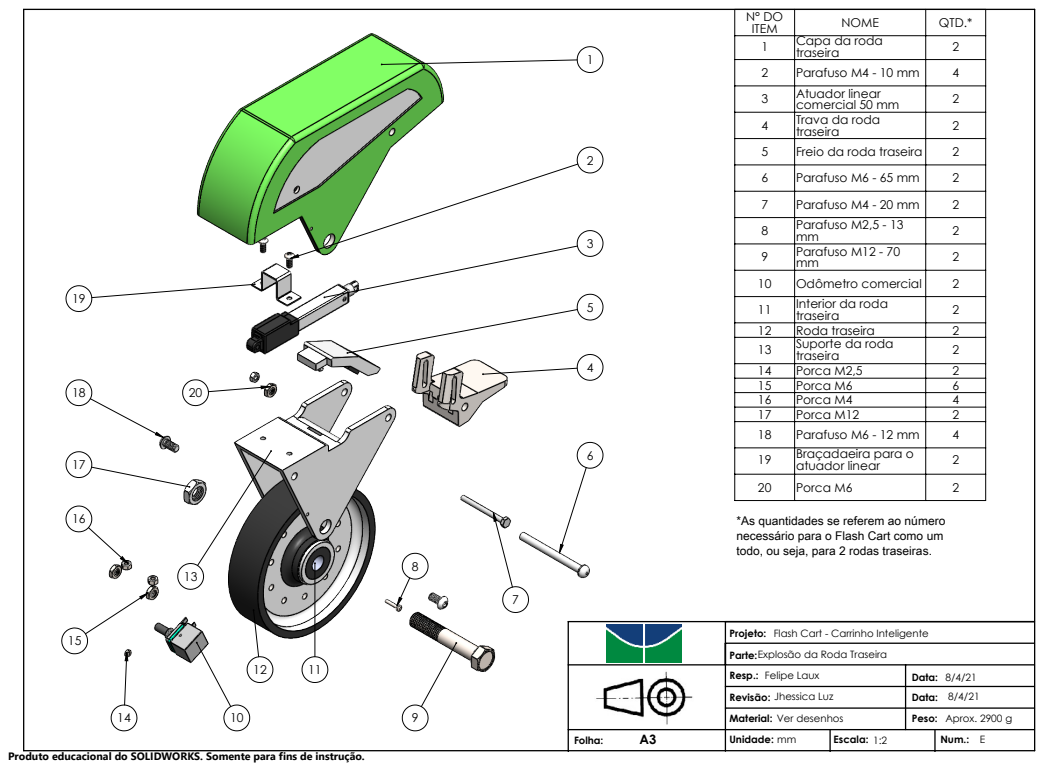
[picture p212: page 1]

N° DO ITEM | NOME | QTD.*
1 | Capa da roda traseira | 2

2 | Parafuso M4 - 10 mm | 4
3 | Atuador linear comercial 50 mm | 2
4 | Trava da roda traseira | 2

5 | Freio da roda traseira | 2
6 | Parafuso M6 - 65 mm | 2
7 | Parafuso M4 - 20 mm | 2
8 | Parafuso M2,5 - 13 mm | 2
9 | Parafuso M12 - 70 mm | 2

10 | Odômetro comercial | 2
11 | Interior da roda traseira | 2
12 | Roda traseira | 2
13 | Suporte da roda traseira | 2
14 | Porca M2,5 | 2
15 | Porca M6 | 6
16 | Porca M4 | 4
17 | Porca M12 | 2
18 | Parafuso M6 - 12 mm | 4
19 | Braçadaeira para o atuador linear | 2

20 | Porca M6 | 2

*As quantidades se referem ao número
necessário para o Flash Cart como um
todo, ou seja, para 2 rodas traseiras.

Projeto:
Parte:
Explosão da Roda Traseira

Flash Cart - Carrinho Inteligente

Resp.: Felipe Laux | Data: 8/4/21
Revisão: Jhessica Luz | Data: 8/4/21
Material: Ver desenhos | Peso: Aprox. 2900 g

Folha: A3 | Unidade: mm | Escala: 1:2 | Num.: E

Produto educacional do SOLIDWORKS. Somente para fins de instrução.

D | D

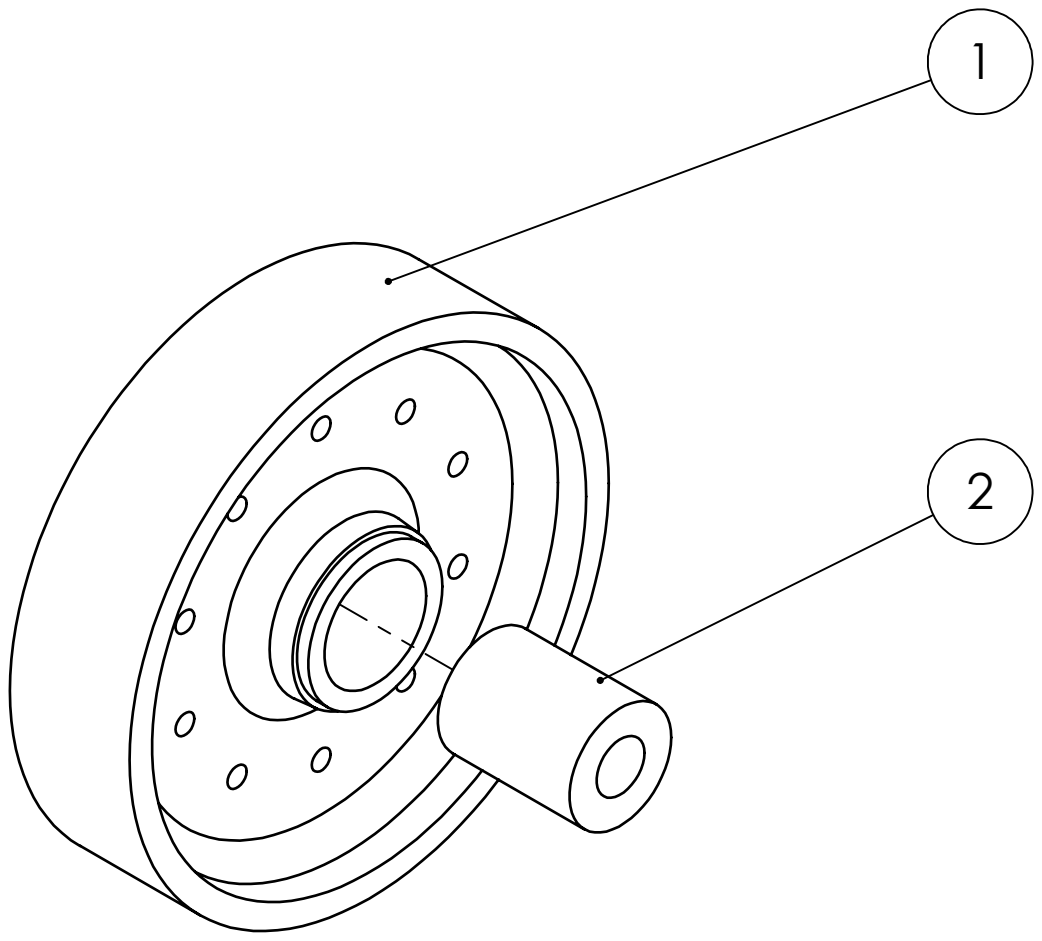
[picture p213: page 2]

D | D

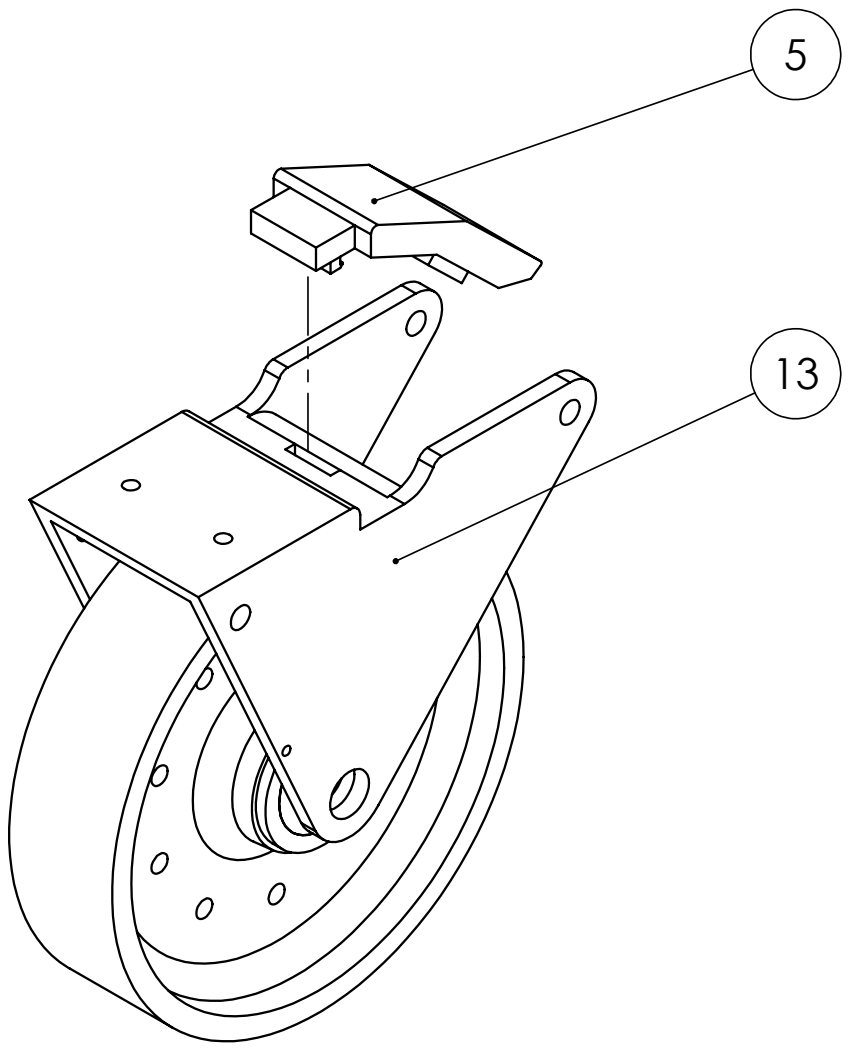
[picture p214: page 3]

D | D

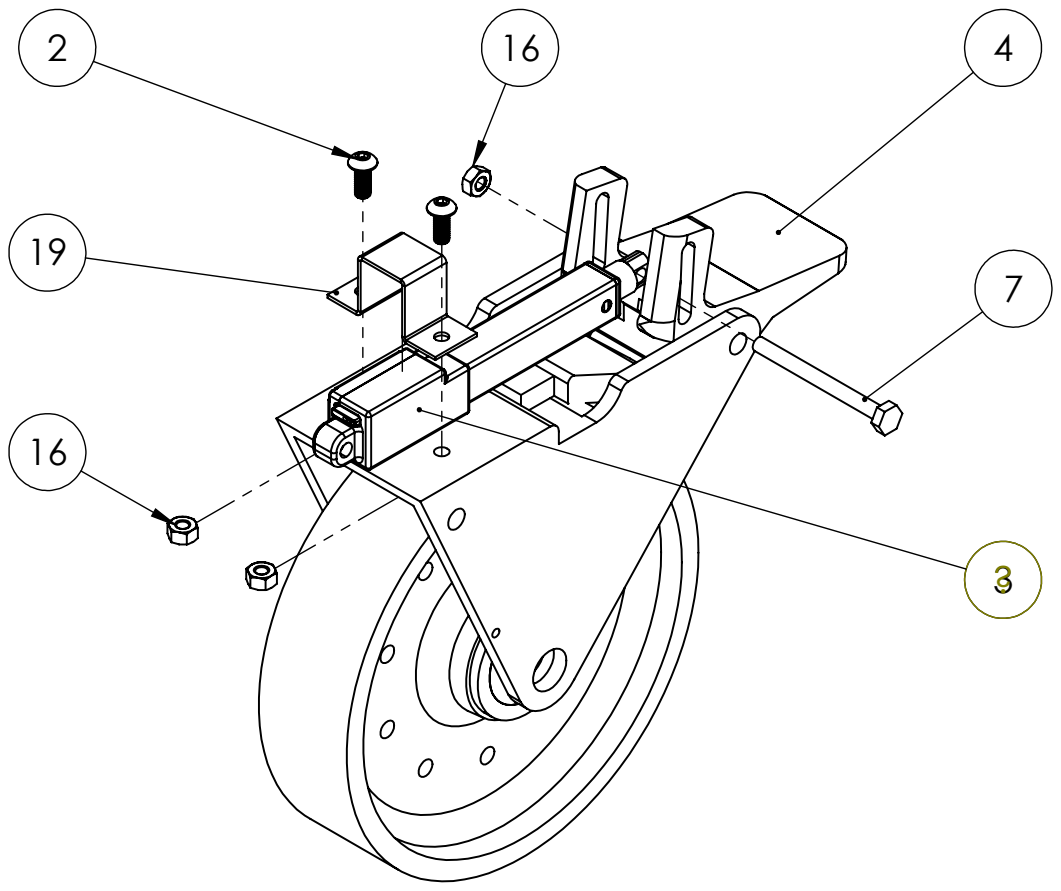
[picture p215: page 4]

D | D

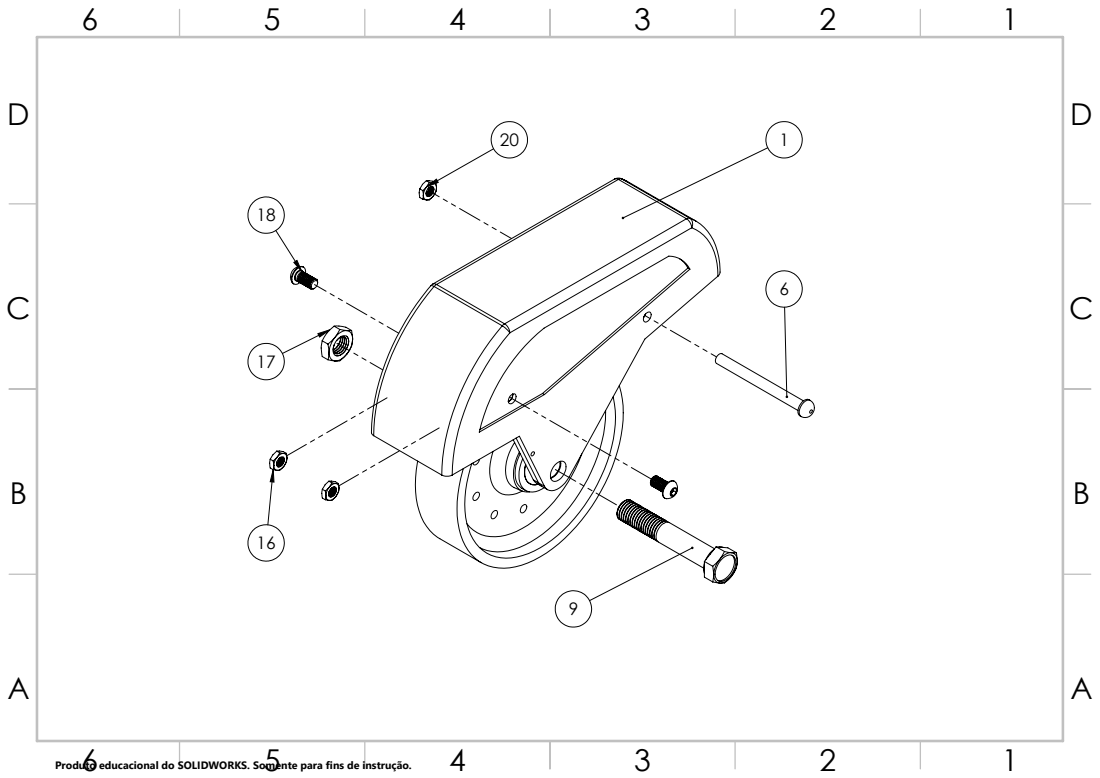
[picture p216: page 5]

D | D

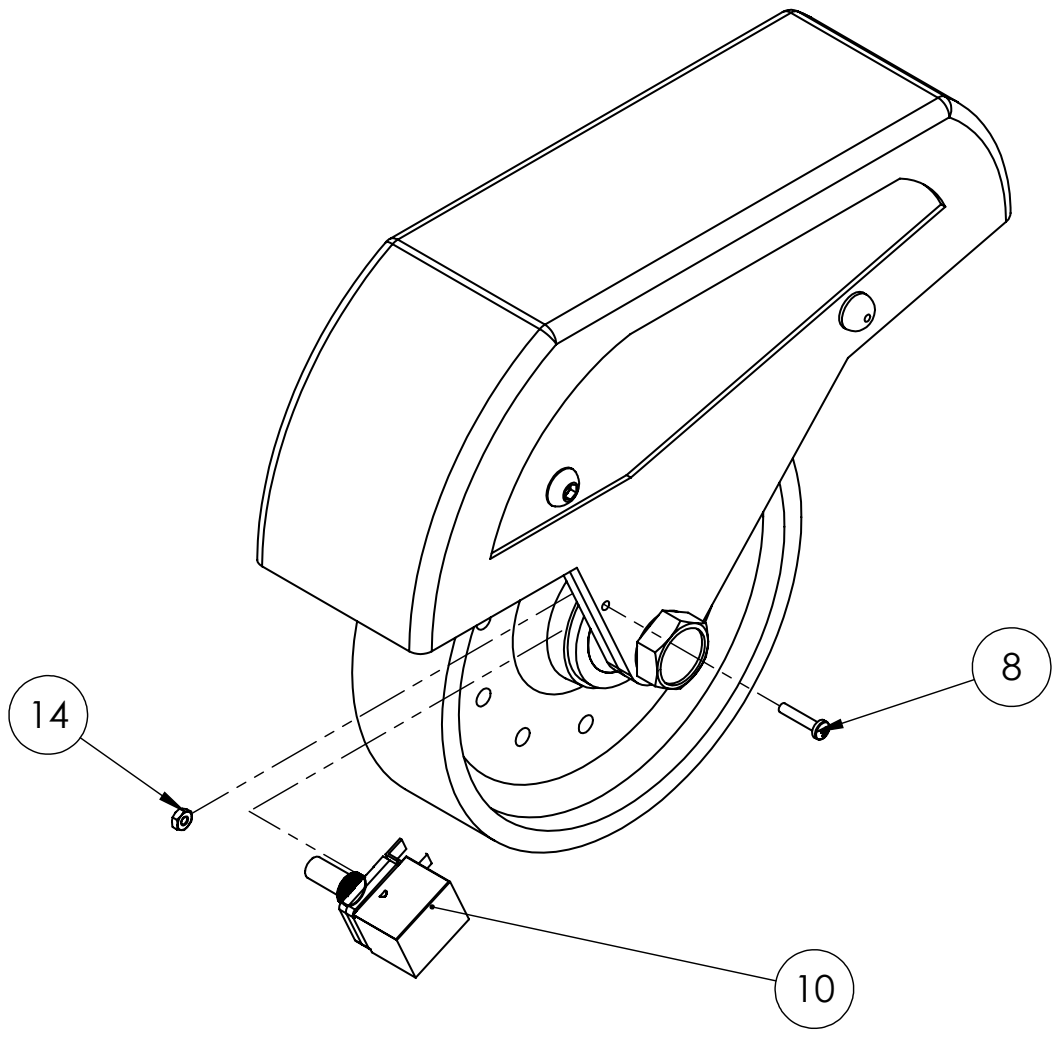
[picture p217: page 6]

D | D

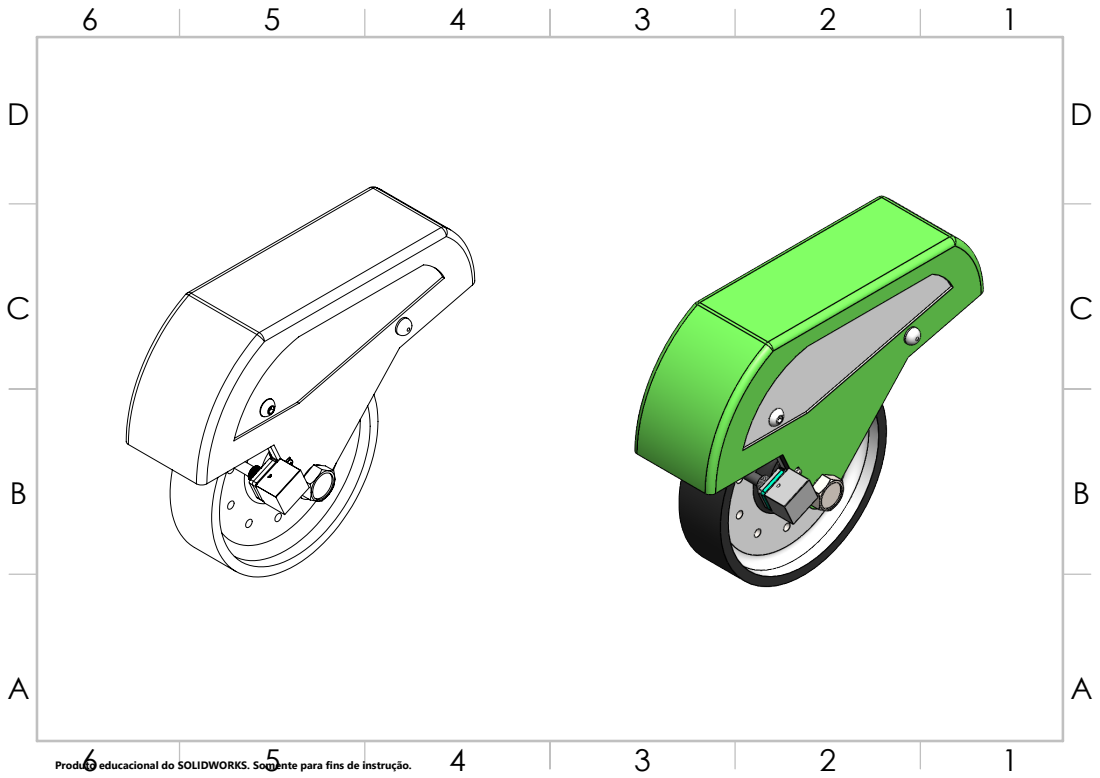
[picture p218: page 7]
