Flash-Cart/Flash-Cart-Model/5.Manuais/Caixa da bateria/Exploded caixa da bateria atualizado.pdf

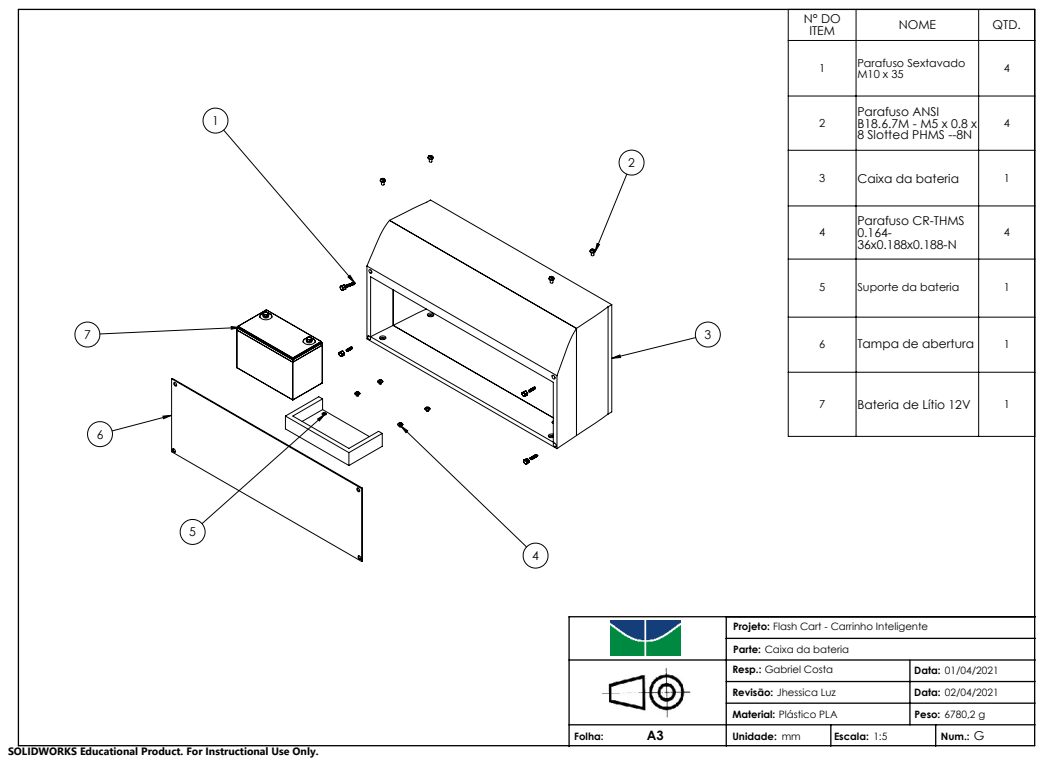
[picture p219: page 1]

N° DO ITEM | NOME | QTD.

1 | Parafuso Sextavado M10 x 35 | 4

2 | Parafuso ANSI B18.6.7M - M5 x 0.8 x 8 Slotted PHMS --8N | 4

3 | Caixa da bateria | 1

4 | Parafuso CR-THMS 0.164-36x0.188x0.188-N | 4

5 | Suporte da bateria | 1

6 | Tampa de abertura | 1

7 | Bateria de Lítio 12V | 1

Projeto:
Flash Cart - Carrinho Inteligente
Parte:
Caixa da bateria

Resp.: Gabriel Costa | Data: 01/04/2021
Revisão: Jhessica Luz | Data: 02/04/2021
Material: Plástico PLA | Peso: 6780,2 g

Folha: A3 | mm Unidade: | Escala: 1:5 | G Num.:

SOLIDWORKS Educational Product. For Instructional Use Only.
