Flash-Cart/Flash-Cart-Model/5.Manuais/Cesta + balança + capas/Passo1.pdf

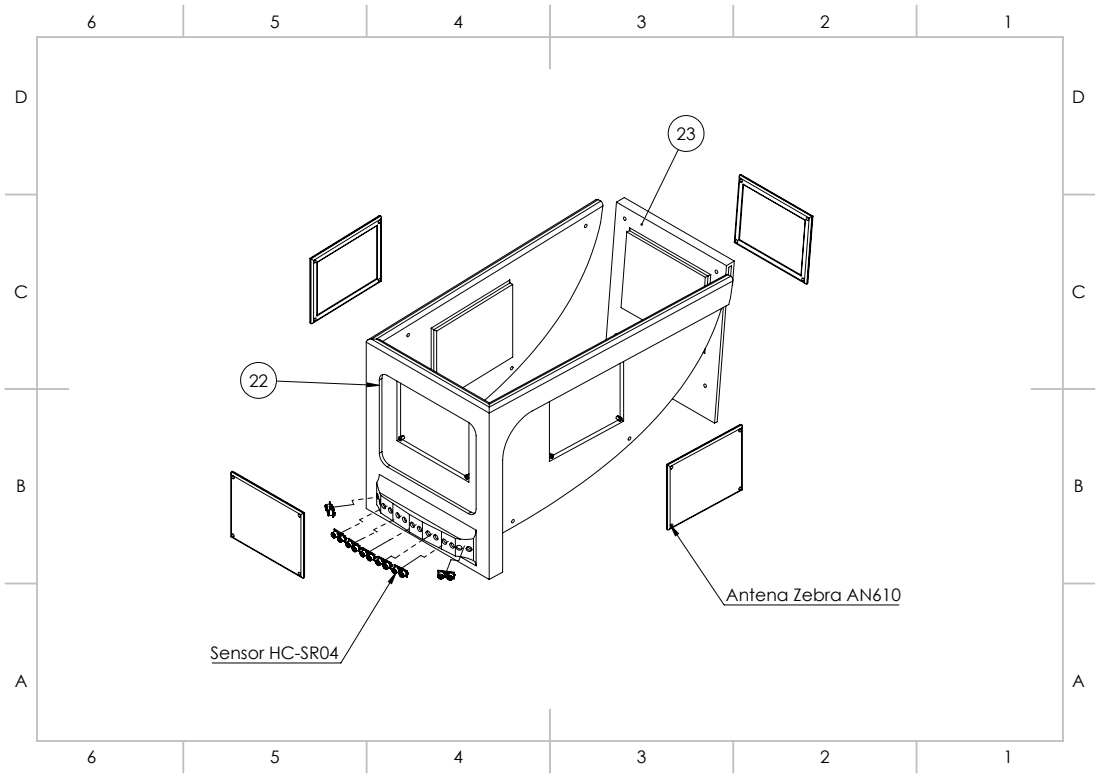
[picture p220: page 1]
Antena Zebra AN610; Sensor HC-SR04
