Flash-Cart/Flash-Cart-Model/5.Manuais/Cesta + balança + capas/passo2.pdf

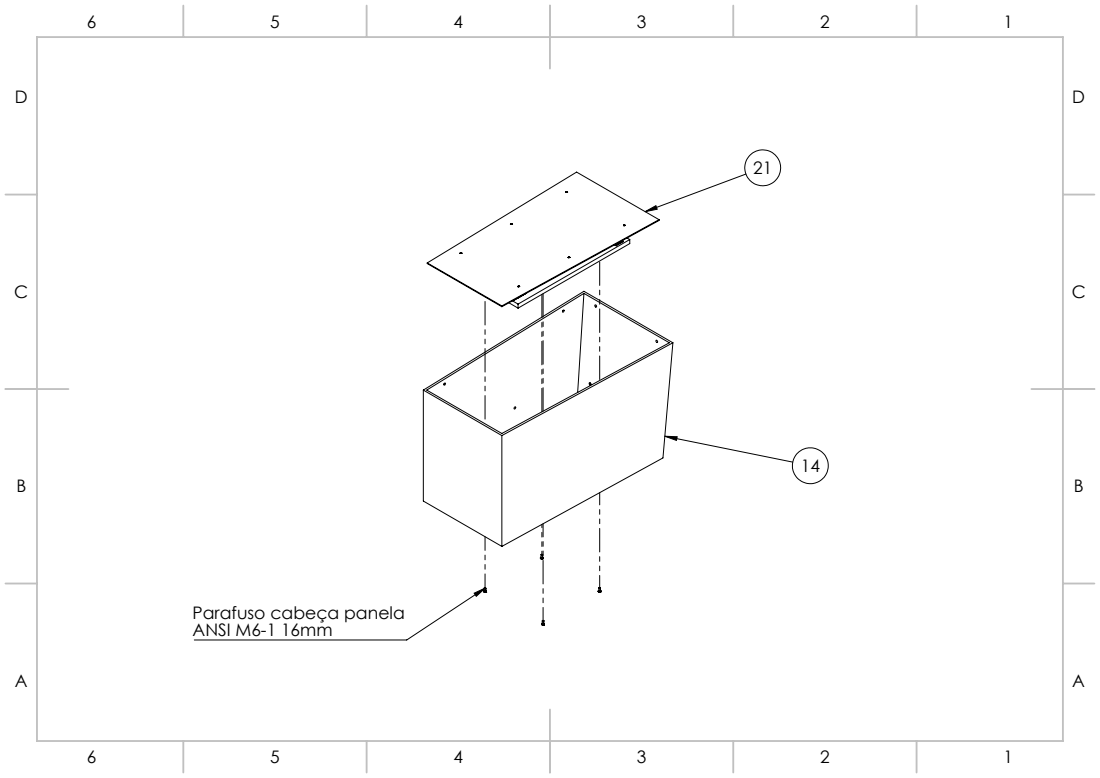
[picture p221: page 1]

Parafuso cabeça panela
ANSI M6-1 16mm
