Flash-Cart/Flash-Cart-Model/5.Manuais/Cesta + balança + capas/passo3.pdf

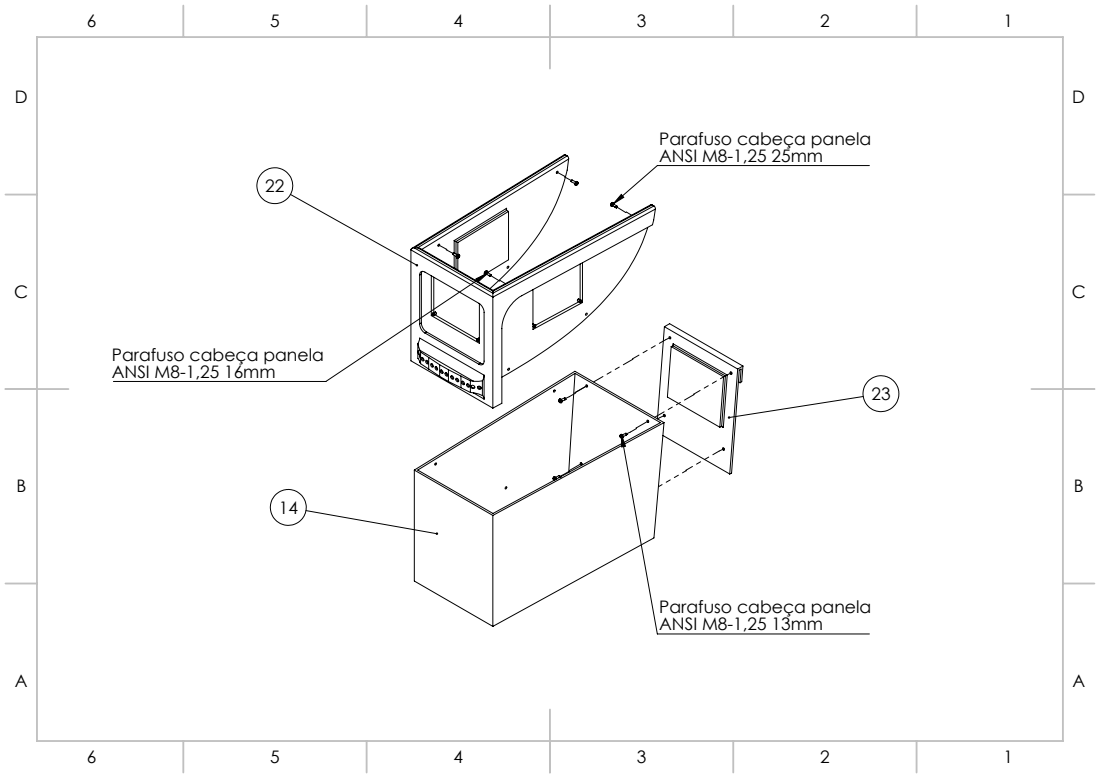
[picture p222: page 1]

Parafuso cabeça panela
ANSI M8-1,25 25mm

ANSI M8-1,25 16mm

ANSI M8-1,25 13mm
