Flash-Cart/Flash-Cart-Model/5.Manuais/slot de carregamento/passo 0.pdf

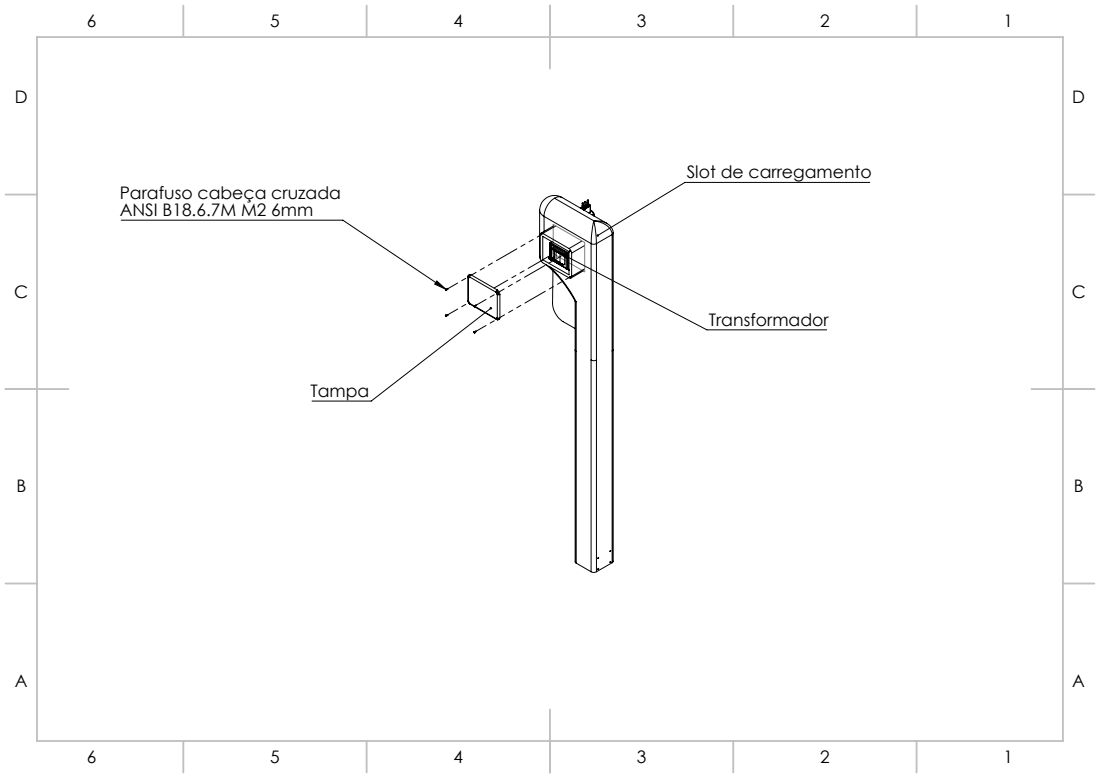
[picture p223: page 1]

Slot de carregamento

Parafuso cabeça cruzada
ANSI B18.6.7M M2 6mm
