Flash-Cart/Flash-Cart-Model/5.Manuais/slot de carregamento/passo 1.pdf

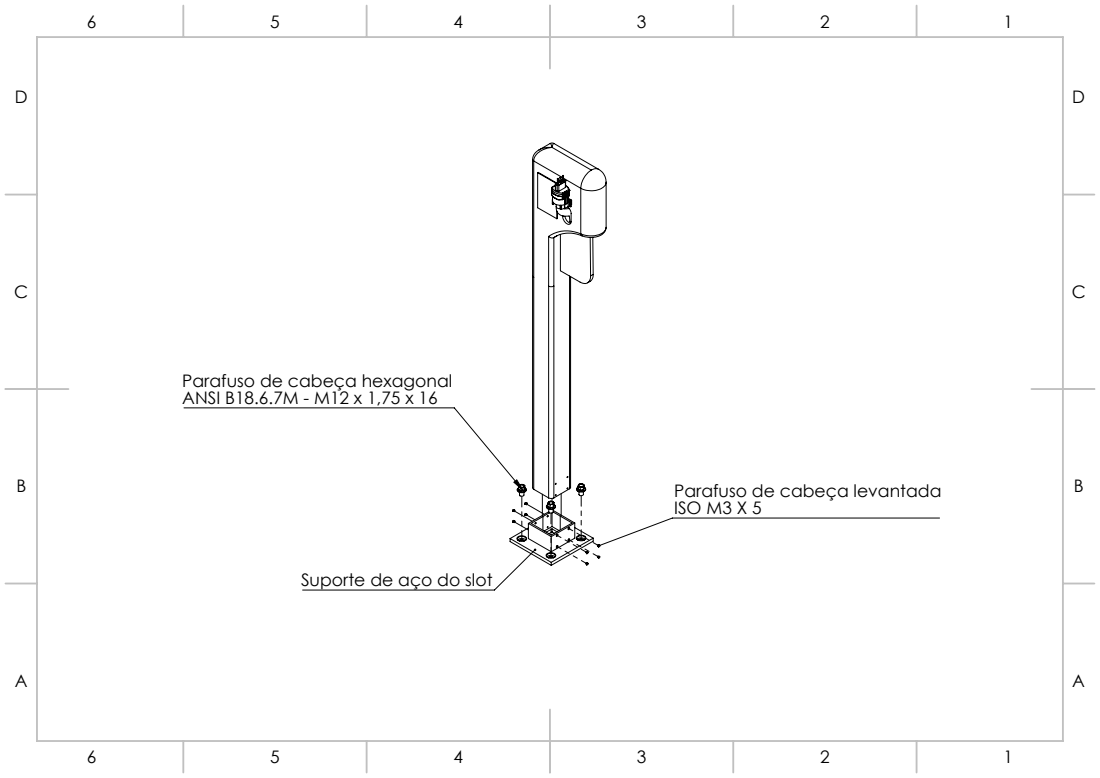
[picture p224: page 1]

Parafuso de cabeça hexagonal
ANSI B18.6.7M - M12 x 1,75 x 16

Parafuso de cabeça levantada
ISO M3 X 5

Suporte de aço do slot
