Flash-Cart/Flash-Cart-Model/5.Manuais/Suporte do display/Explode_suportedodisplay_colorido.pdf

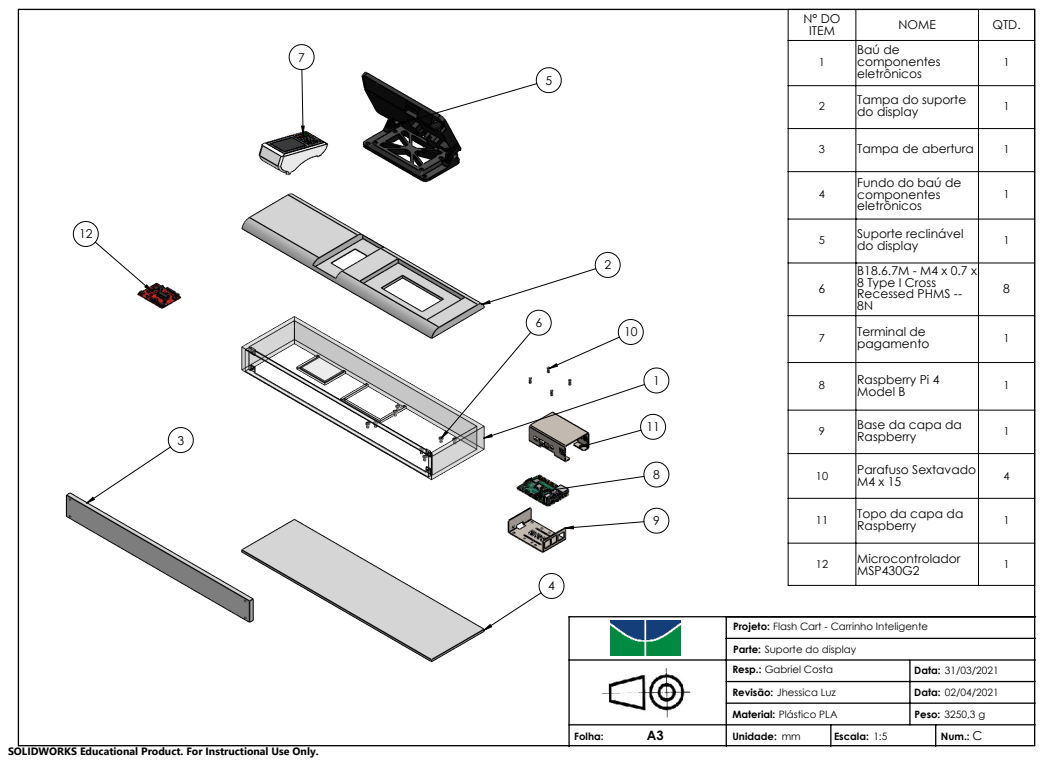
[picture p225: page 1]

N° DO ITEM | NOME | QTD.

1 | Baú de componentes eletrônicos | 1

2 | Tampa do suporte do display | 1

3 | Tampa de abertura | 1

4 | Fundo do baú de componentes eletrônicos | 1

5 | Suporte reclinável do display | 1

6 | B18.6.7M - M4 x 0.7 x 8 Type I Cross Recessed PHMS --8N | 8

7 | Terminal de pagamento | 1

8 | Raspberry Pi 4 Model B | 1

9 | Base da capa da Raspberry | 1

10 | Parafuso Sextavado M4 x 15 | 4

11 | Topo da capa da Raspberry | 1

12 | Microcontrolador MSP430G2 | 1

Projeto:
Flash Cart - Carrinho Inteligente
Parte:
Suporte do display

Resp.: Gabriel Costa | Data: 31/03/2021
Revisão: Jhessica Luz | Data: 02/04/2021
Material: Plástico PLA | Peso: 3250,3 g

Folha: A3 | mm Unidade: | Escala: 1:5 | C Num.:

SOLIDWORKS Educational Product. For Instructional Use Only.
