Flash-Cart/Flash-Cart-Model/4.Desenhos Tecnicos/Desenhos finais /Jhéssica/antenarevisada.PDF

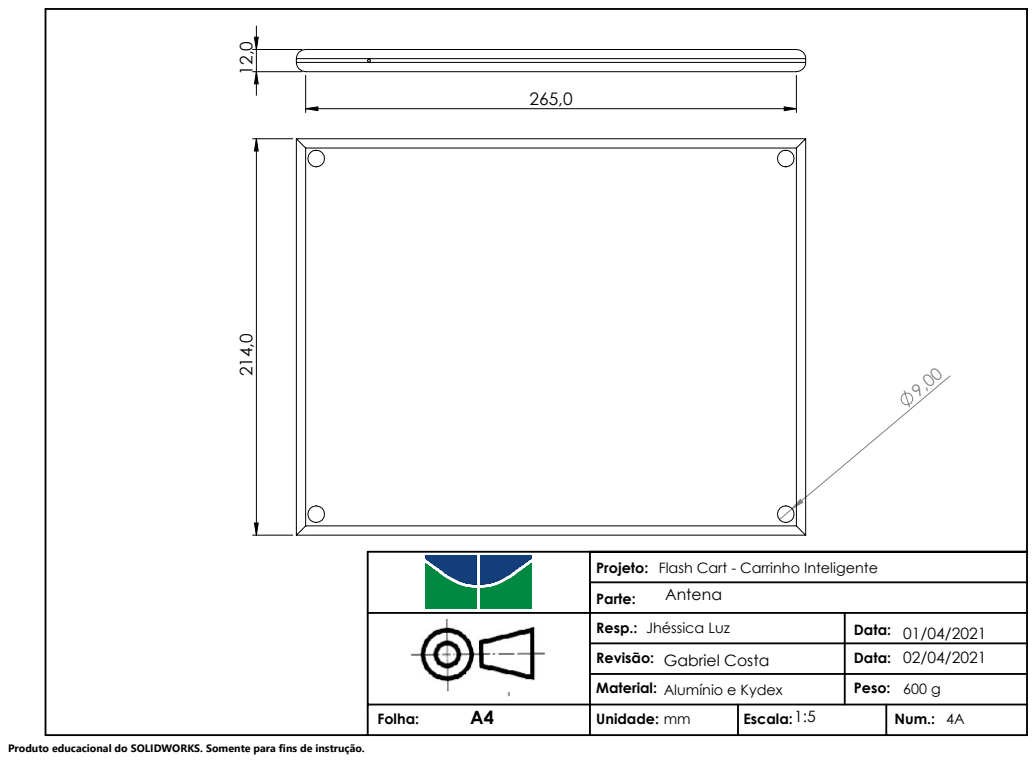
[picture p226: page 1]

Flash Cart - Carrinho Inteligente
Antena

Resp.: Jhéssica Luz | Data: 01/04/2021
Revisão: Gabriel Costa | Data: 02/04/2021
Material: Alumínio e Kydex | Peso: 600 g

Folha: A4 | Unidade: mm | 1:5 Escala: | Num.: 4A

Produto educacional do SOLIDWORKS. Somente para fins de instrução.
