Flash-Cart/Flash-Cart-Model/4.Desenhos Tecnicos/Desenhos finais /Jhéssica/capa-revisada.PDF

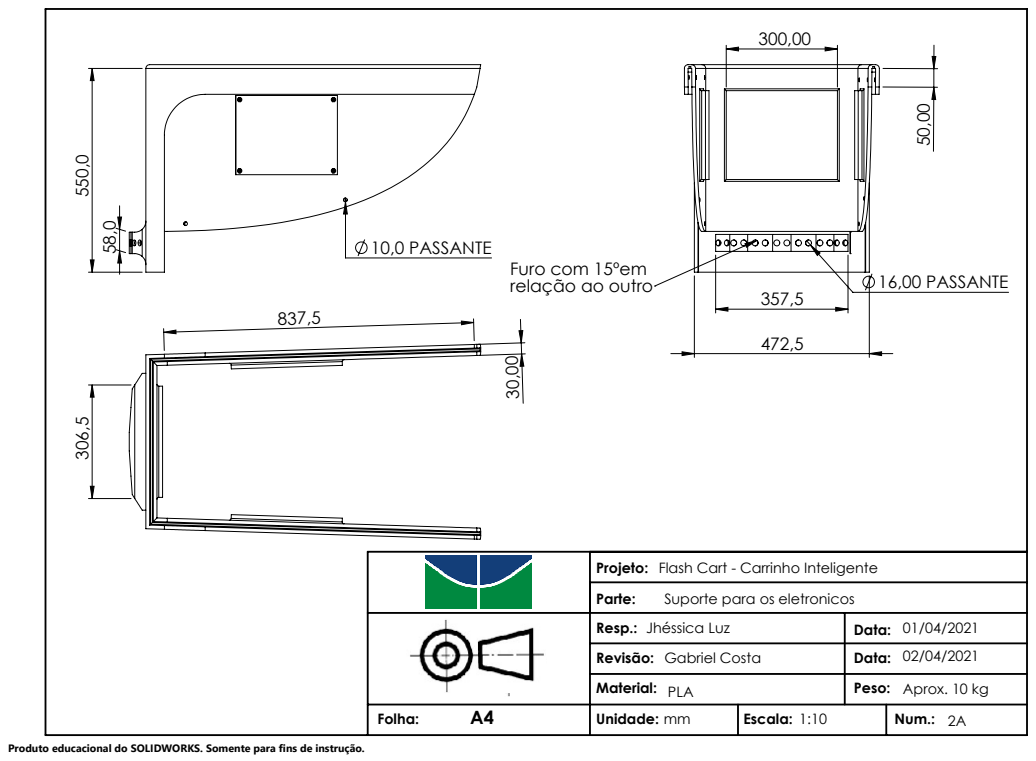
[picture p227: page 1]
10,0 PASSANTE; 16,00 PASSANTE

Furo com 15ºem
relação ao outro

Flash Cart - Carrinho Inteligente
Suporte para os eletronicos

Resp.: Jhéssica Luz | Data: 01/04/2021
Revisão: Gabriel Costa | Data: 02/04/2021
Material: PLA | Peso: Aprox. 10 kg

Folha: A4 | Unidade: mm | Escala: 1:10 | Num.: 2A

Produto educacional do SOLIDWORKS. Somente para fins de instrução.
