Flash-Cart/Flash-Cart-Model/4.Desenhos Tecnicos/Desenhos finais /Jhéssica/cestadesenho-revisada.PDF

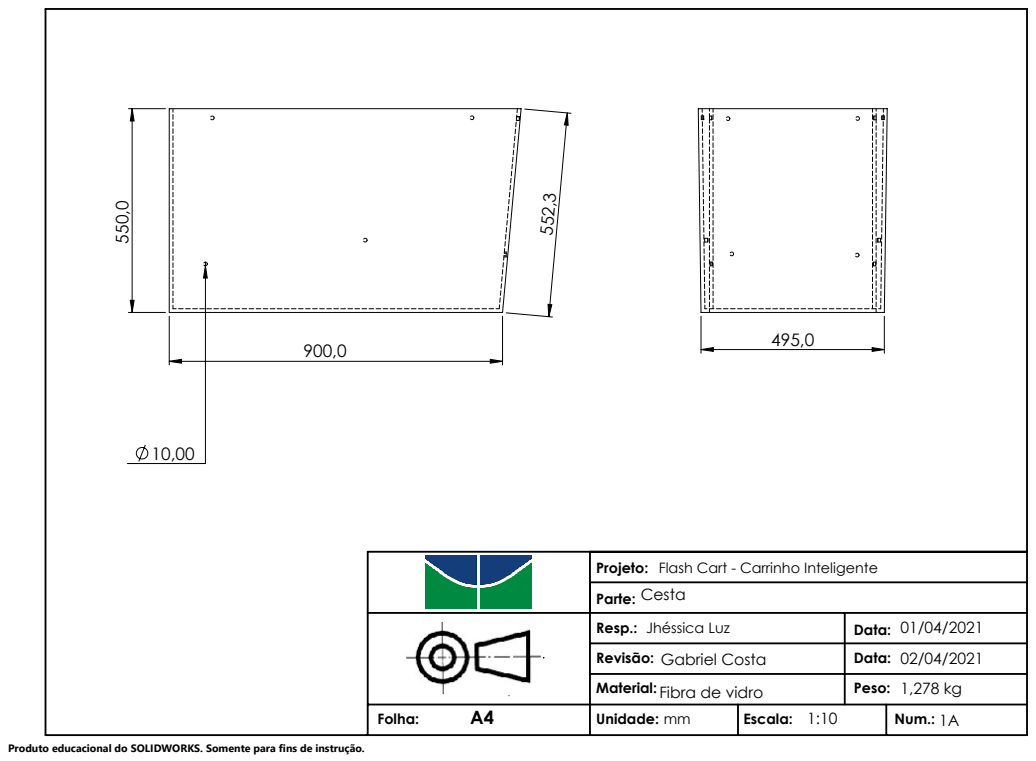
[picture p228: page 1]

Flash Cart - Carrinho Inteligente

Resp.: Jhéssica Luz | Data: 01/04/2021
Revisão: Gabriel Costa | Data: 02/04/2021
Material: Fibra de vidro | Peso: 1,278 kg

Folha: A4 | Unidade: mm | Escala: 1:10 | Num.: 1A

Produto educacional do SOLIDWORKS. Somente para fins de instrução.
