Flash-Cart/Flash-Cart-Model/4.Desenhos Tecnicos/Desenhos finais /Jhéssica/desenhotras-revisado.PDF

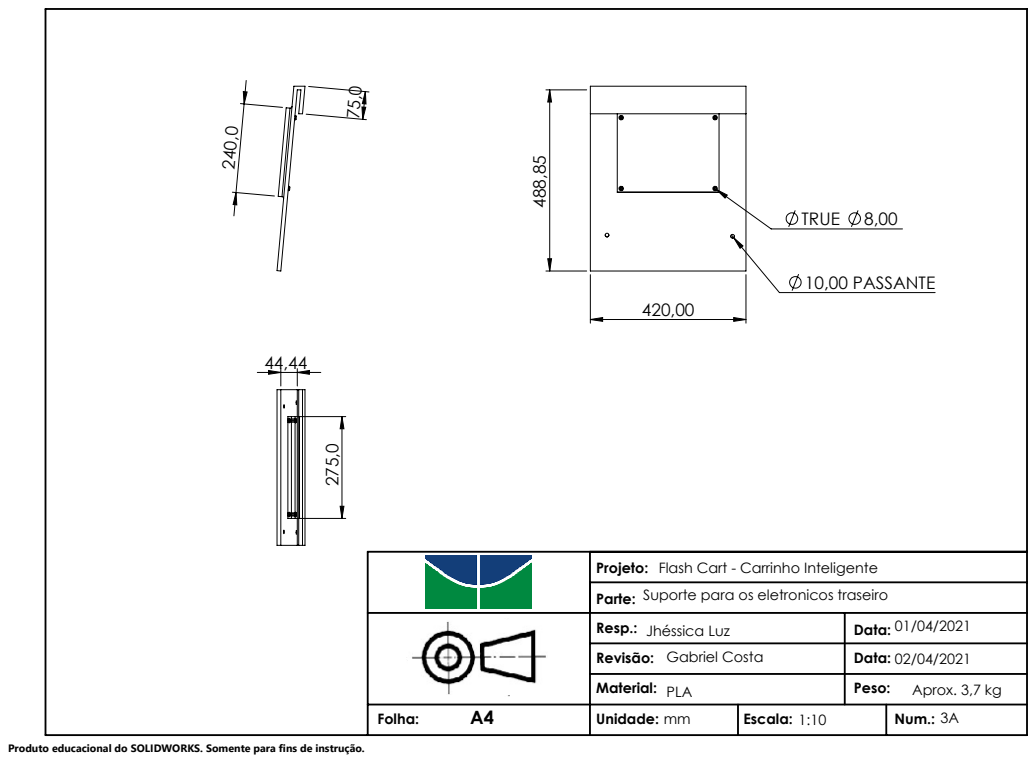
[picture p229: page 1]
TRUE 8,00; 10,00 PASSANTE

Projeto:
Suporte para os eletronicos traseiro
Parte:

Flash Cart - Carrinho Inteligente

Resp.: Jhéssica Luz | Data: 01/04/2021
Revisão: Gabriel Costa | Data: 02/04/2021
Material: PLA | Peso: Aprox. 3,7 kg

Folha: A4 | Unidade: mm | Escala: 1:10 | Num.: 3A

Produto educacional do SOLIDWORKS. Somente para fins de instrução.
