Flash-Cart/Flash-Cart-Model/4.Desenhos Tecnicos/Desenhos finais /Jhéssica/desenhoultra-revisado.PDF

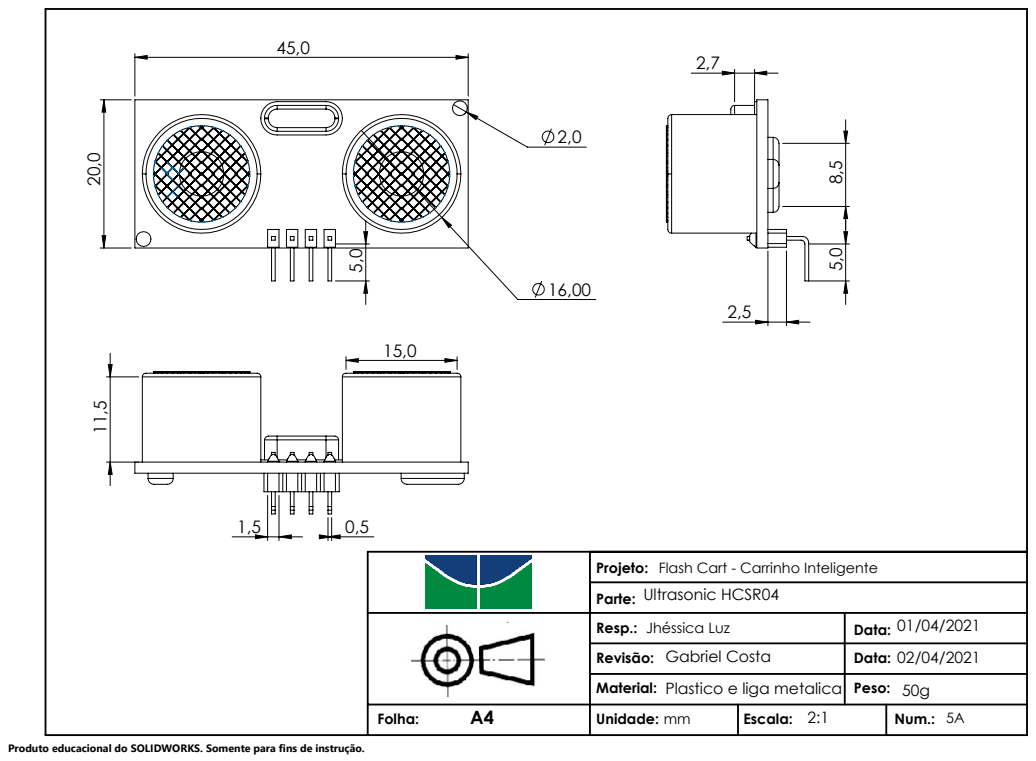
[picture p230: page 1]
Ultrasonic HCSR04

Flash Cart - Carrinho Inteligente

Resp.: Jhéssica Luz | 01/04/2021 Data:
Revisão: Gabriel Costa | Data: 02/04/2021
Material: Plastico e liga metalica | Peso: 50g

Folha: A4 | Unidade: mm | 2:1 Escala: | Num.: 5A

Produto educacional do SOLIDWORKS. Somente para fins de instrução.
