Flash-Cart/Flash-Cart-Model/4.Desenhos Tecnicos/Desenhos finais /Jhéssica/esqueletoVertical3H.PDF

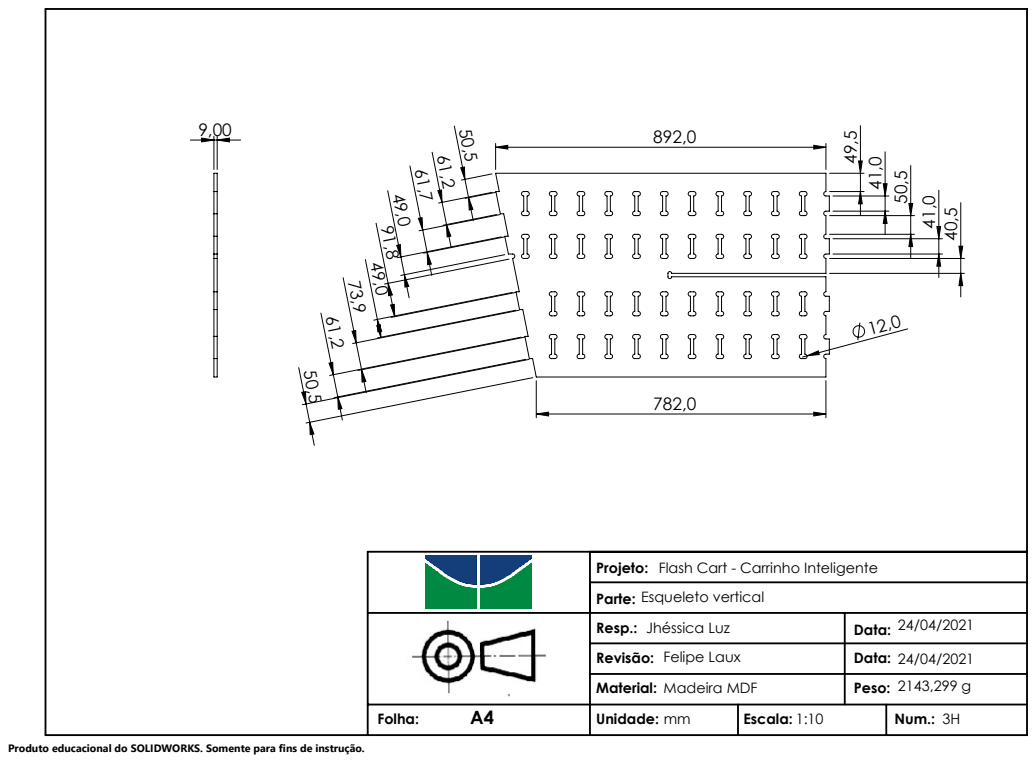
[picture p231: page 1]
Esqueleto vertical

Flash Cart - Carrinho Inteligente

Resp.: Jhéssica Luz | 24/04/2021 Data:
Revisão: Felipe Laux | Data: 24/04/2021
Material: Madeira MDF | Peso: 2143,299 g

Folha: A4 | Unidade: mm | Escala: 1:10 | Num.: 3H

Produto educacional do SOLIDWORKS. Somente para fins de instrução.
