Flash-Cart/Flash-Cart-Model/4.Desenhos Tecnicos/Desenhos finais /Jhéssica/m1pCimaDireita-PDF.PDF

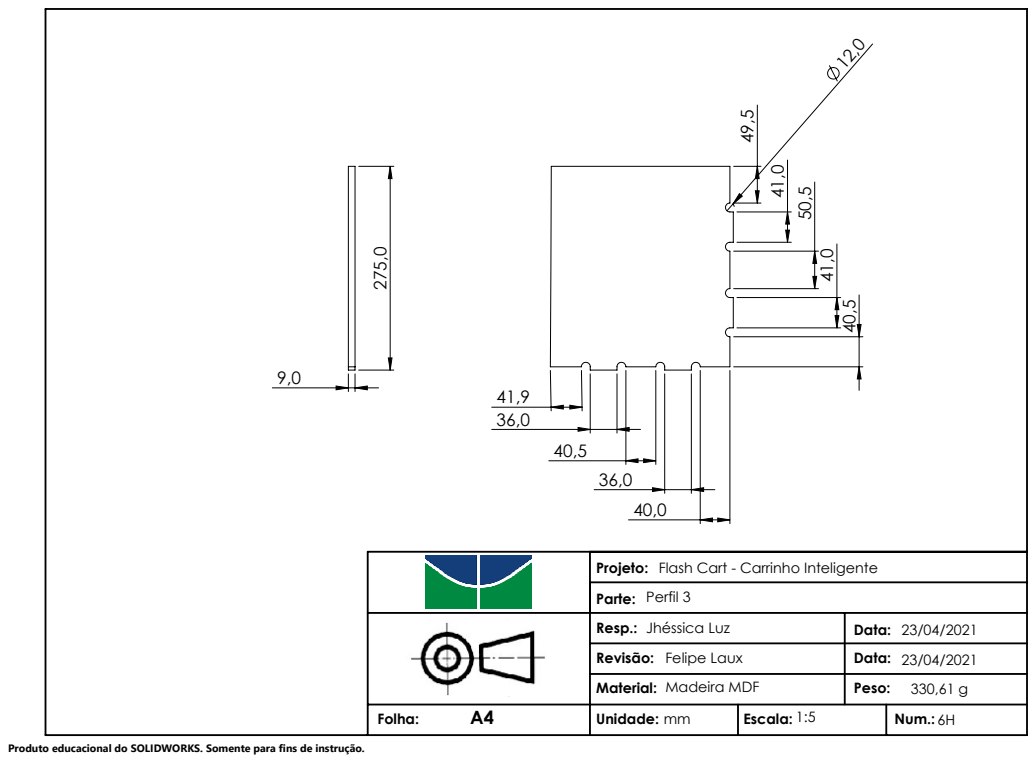
[picture p232: page 1]
Perfil 3

Flash Cart - Carrinho Inteligente

Resp.: Jhéssica Luz | Data: 23/04/2021
Revisão: Felipe Laux | Data: 23/04/2021
Material: Madeira MDF | Peso: 330,61 g

Folha: A4 | Unidade: mm | Escala: 1:5 | Num.: 6H

Produto educacional do SOLIDWORKS. Somente para fins de instrução.
