Flash-Cart/Flash-Cart-Model/4.Desenhos Tecnicos/Desenhos finais /Jhéssica/perfil2.PDF

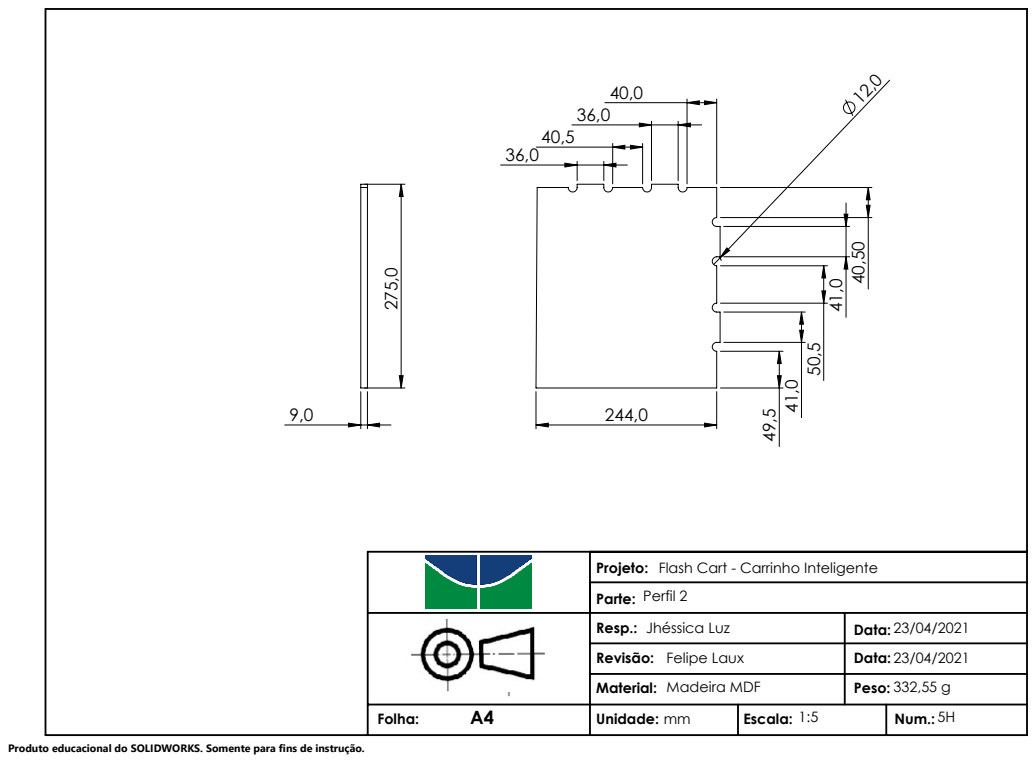
[picture p234: page 1]
Perfil 2

Flash Cart - Carrinho Inteligente

Resp.: Jhéssica Luz | Data: 23/04/2021
Revisão: Felipe Laux | Data: 23/04/2021
Material: Madeira MDF | Peso: 332,55 g

Folha: A4 | Unidade: mm | Escala: 1:5 | Num.: 5H

Produto educacional do SOLIDWORKS. Somente para fins de instrução.
