Flash-Cart/Flash-Cart-Model/4.Desenhos Tecnicos/Desenhos finais /Jhéssica/tampaFrente-desenho2H.PDF

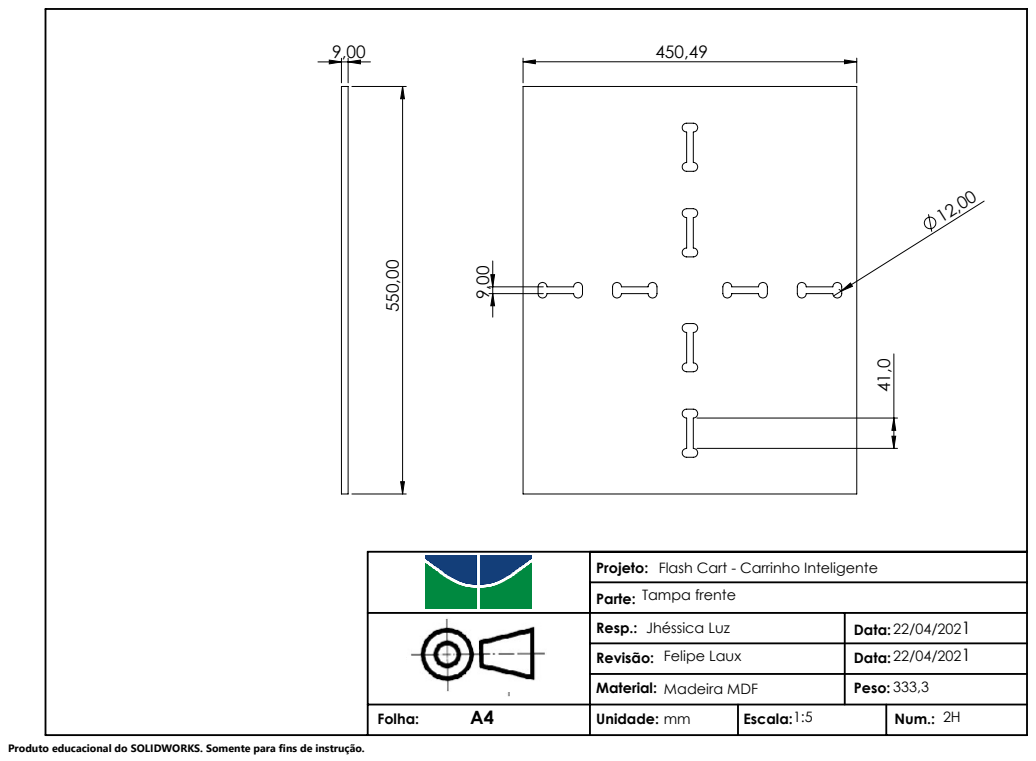
[picture p235: page 1]
Tampa frente

Flash Cart - Carrinho Inteligente

Resp.: Jhéssica Luz | 22/04/2021 Data:
Revisão: Felipe Laux | 22/04/2021 Data:
Material: Madeira MDF | Peso: 333,3

Folha: A4 | Unidade: mm | Escala: 1:5 | Num.: 2H

Produto educacional do SOLIDWORKS. Somente para fins de instrução.
