Flash-Cart/Flash-Cart-Model/4.Desenhos Tecnicos/Desenhos finais /Jhéssica/tampaTras-desenho1H.PDF

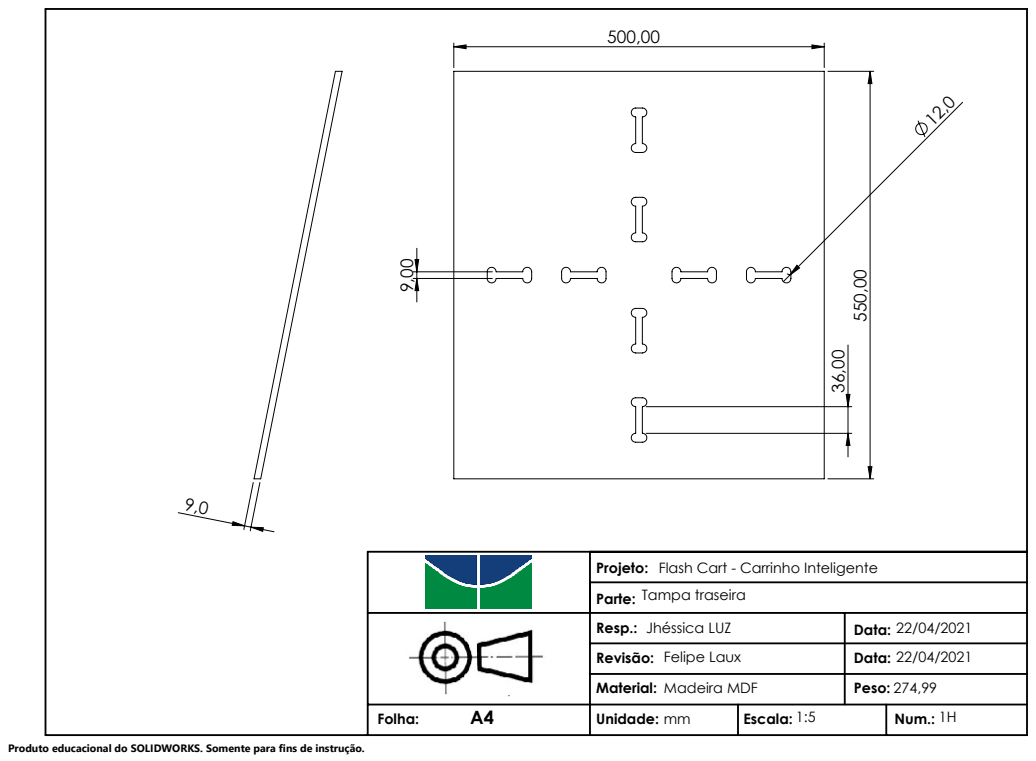
[picture p236: page 1]
Tampa traseira

Flash Cart - Carrinho Inteligente

Resp.: Jhéssica LUZ | Data: 22/04/2021
Revisão: Felipe Laux | Data: 22/04/2021
Material: Madeira MDF | Peso: 274,99

Folha: A4 | Unidade: mm | Escala: 1:5 | Num.: 1H

Produto educacional do SOLIDWORKS. Somente para fins de instrução.
