Flash-Cart/Flash-Cart-Model/4.Desenhos Tecnicos/Desenhos finais /Caleffi/Chassi/10D.PDF

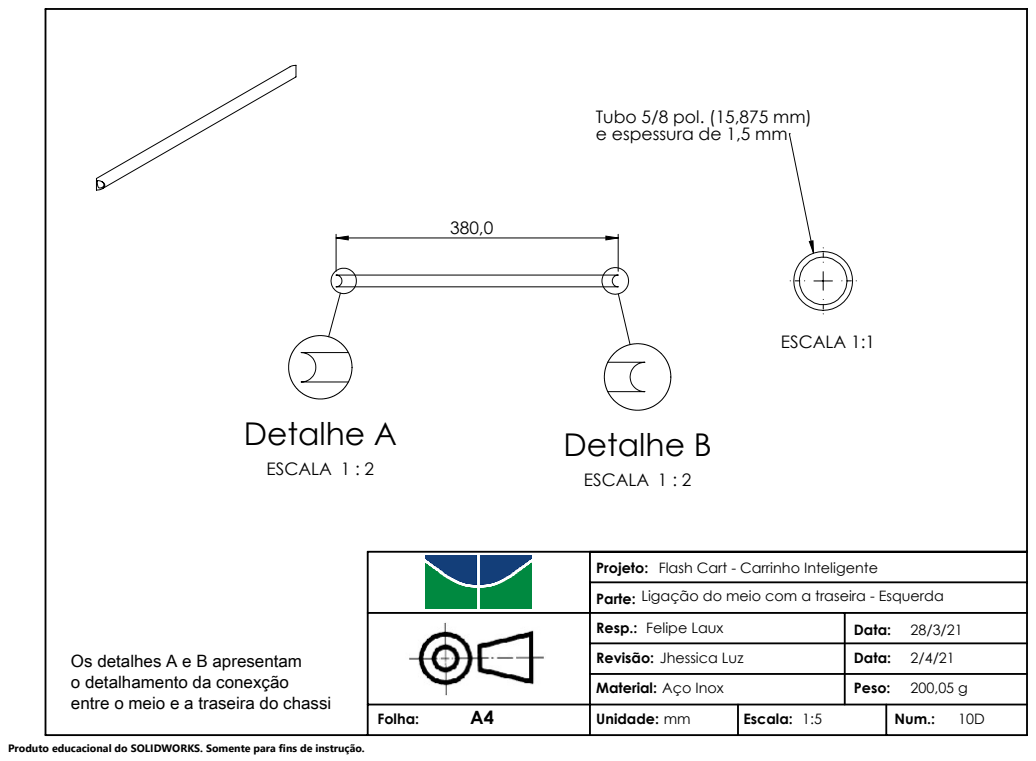
[picture p237: page 1]
Detalhe A; ESCALA 1 : 2; Detalhe B; ESCALA 1:1

Tubo 5/8 pol. (15,875 mm)
e espessura de 1,5 mm

Projeto:
Ligação do meio com a traseira - Esquerda
Parte:

Flash Cart - Carrinho Inteligente

Resp.: Felipe Laux | Data: 28/3/21
Revisão: Jhessica Luz | Data: 2/4/21
Material: Aço Inox | Peso: 200,05 g

Os detalhes A e B apresentam
o detalhamento da conexção
entre o meio e a traseira do chassi

Folha: A4 | Unidade: mm | Escala: 1:5 | Num.: 10D

Produto educacional do SOLIDWORKS. Somente para fins de instrução.
