Flash-Cart/Flash-Cart-Model/4.Desenhos Tecnicos/Desenhos finais /Caleffi/Chassi/1D.PDF

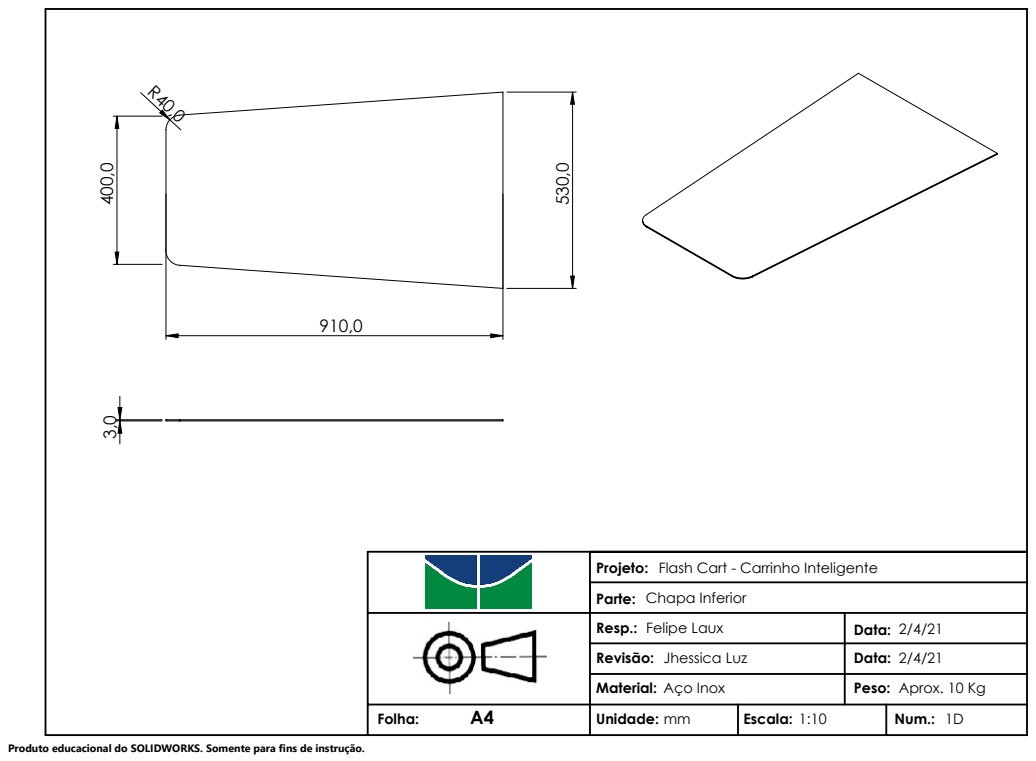
[picture p238: page 1]
Chapa Inferior

Flash Cart - Carrinho Inteligente

Resp.: Felipe Laux | Data: 2/4/21
Revisão: Jhessica Luz | Data: 2/4/21
Material: Aço Inox | Peso: Aprox. 10 Kg

Folha: A4 | Unidade: mm | Escala: 1:10 | Num.: 1D

Produto educacional do SOLIDWORKS. Somente para fins de instrução.
