Flash-Cart/Flash-Cart-Model/4.Desenhos Tecnicos/Desenhos finais /Caleffi/Chassi/2D.PDF

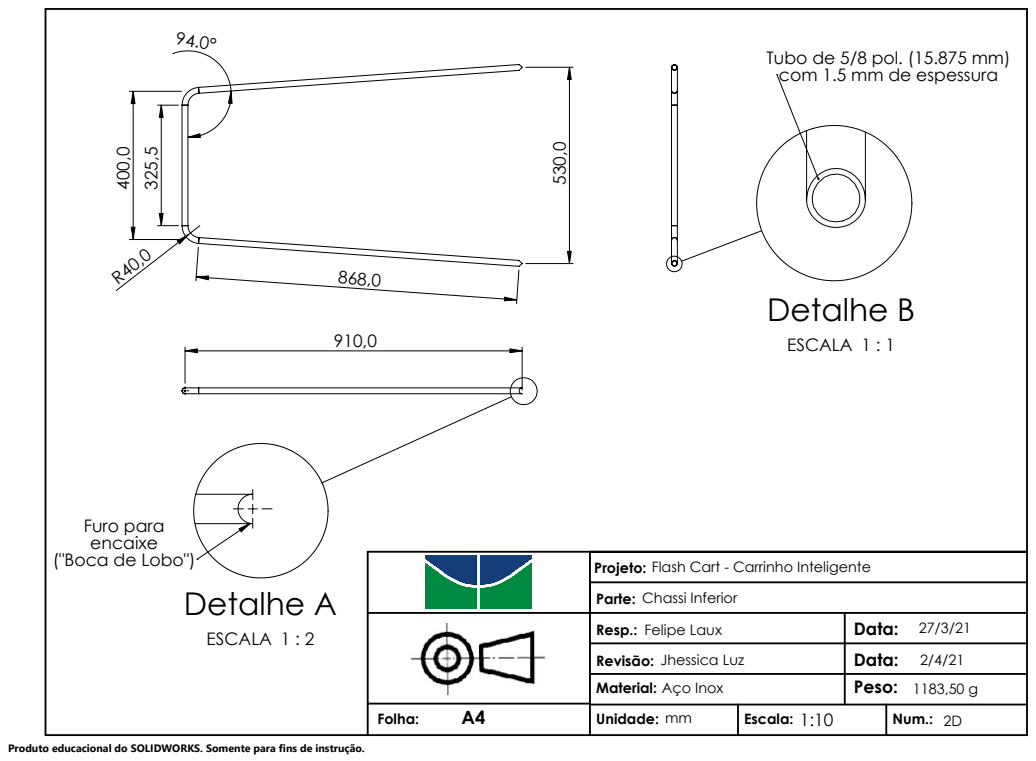
[picture p239: page 1]
Detalhe A; ESCALA 1 : 2; Detalhe B; ESCALA 1 : 1

Tubo de 5/8 pol. (15.875 mm)
com 1.5 mm de espessura

Furo para
encaixe
("Boca de Lobo")

Projeto:
Flash Cart - Carrinho Inteligente
Parte:
Chassi Inferior

Resp.: Felipe Laux | Data: 27/3/21
Revisão: Jhessica Luz | Data: 2/4/21
Material: Aço Inox | Peso: 1183,50 g

Folha: A4 | Unidade: mm | Escala: 1:10 | Num.: 2D

Produto educacional do SOLIDWORKS. Somente para fins de instrução.
