Flash-Cart/Flash-Cart-Model/4.Desenhos Tecnicos/Desenhos finais /Caleffi/Chassi/4D.PDF

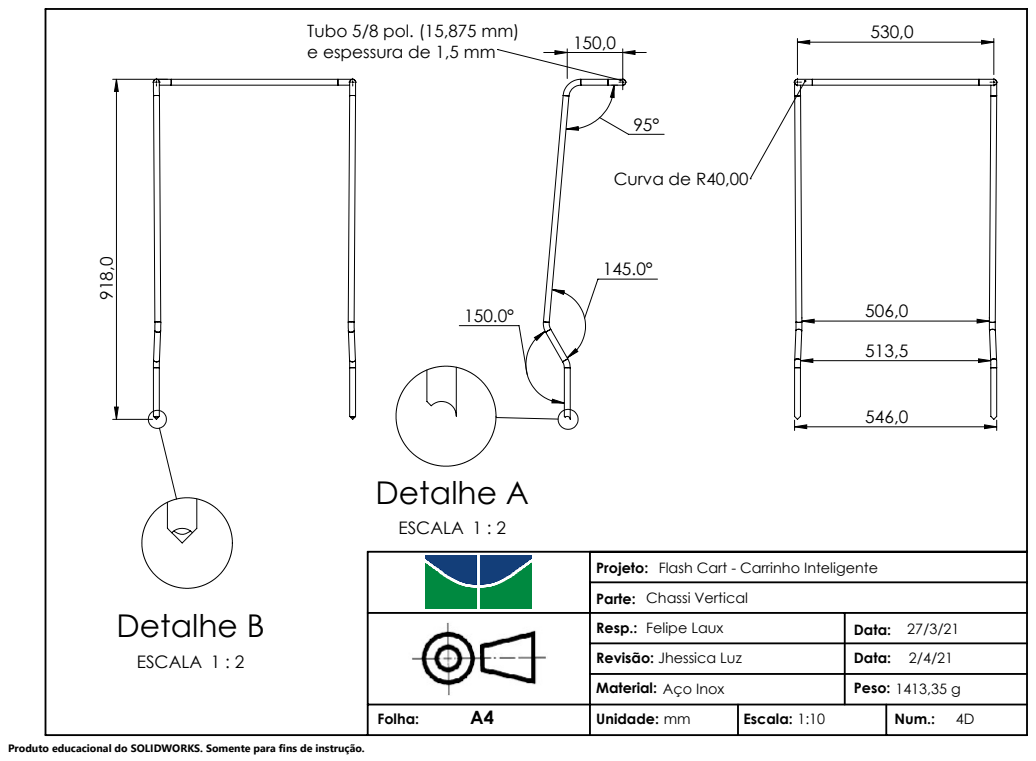
[picture p241: page 1]
Detalhe A; ESCALA 1 : 2; Detalhe B; Curva de R40,00; Chassi Vertical

Tubo 5/8 pol. (15,875 mm)
e espessura de 1,5 mm

Flash Cart - Carrinho Inteligente

Resp.: Felipe Laux | Data: 27/3/21
Revisão: Jhessica Luz | Data: 2/4/21
Material: Aço Inox | Peso: 1413,35 g

Folha: A4 | Unidade: mm | Escala: 1:10 | Num.: 4D

Produto educacional do SOLIDWORKS. Somente para fins de instrução.
