Flash-Cart/Flash-Cart-Model/4.Desenhos Tecnicos/Desenhos finais /Caleffi/Chassi/5D.PDF

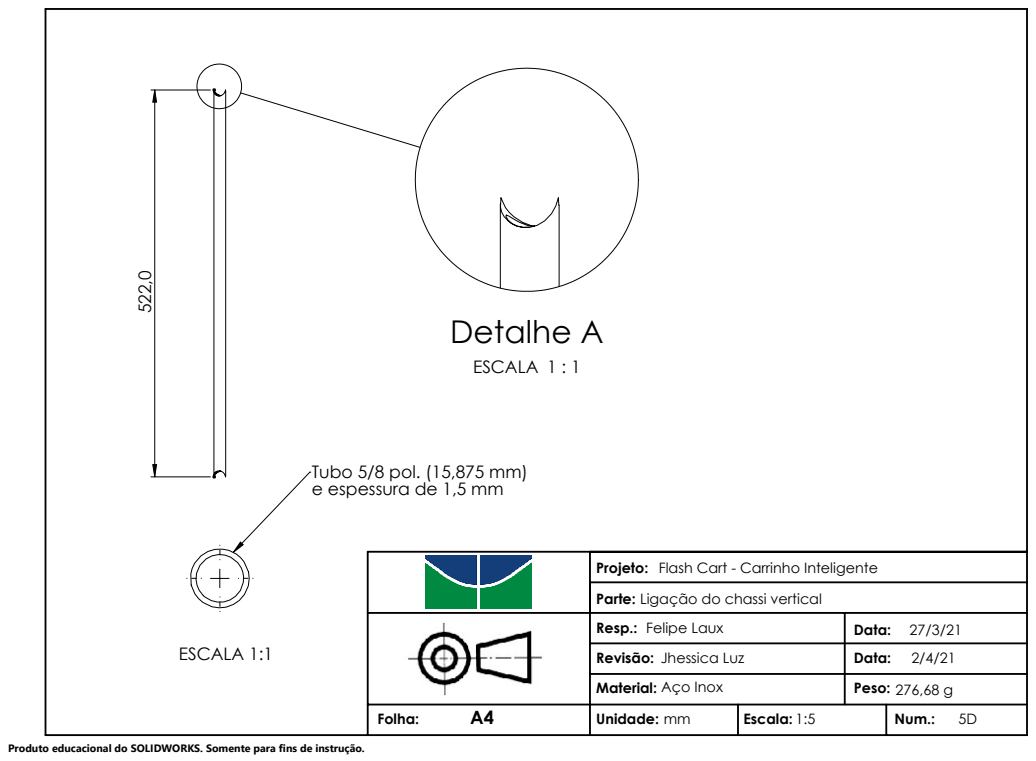
[picture p242: page 1]
ESCALA 1:1; Detalhe A; ESCALA 1 : 1

Tubo 5/8 pol. (15,875 mm)
e espessura de 1,5 mm

Projeto:
Parte:
Ligação do chassi vertical

Flash Cart - Carrinho Inteligente

Resp.: Felipe Laux | Data: 27/3/21
Revisão: Jhessica Luz | Data: 2/4/21
Material: Aço Inox | Peso: 276,68 g

Folha: A4 | Unidade: mm | Escala: 1:5 | Num.: 5D

Produto educacional do SOLIDWORKS. Somente para fins de instrução.
