Flash-Cart/Flash-Cart-Model/4.Desenhos Tecnicos/Desenhos finais /Caleffi/Chassi/7D.PDF

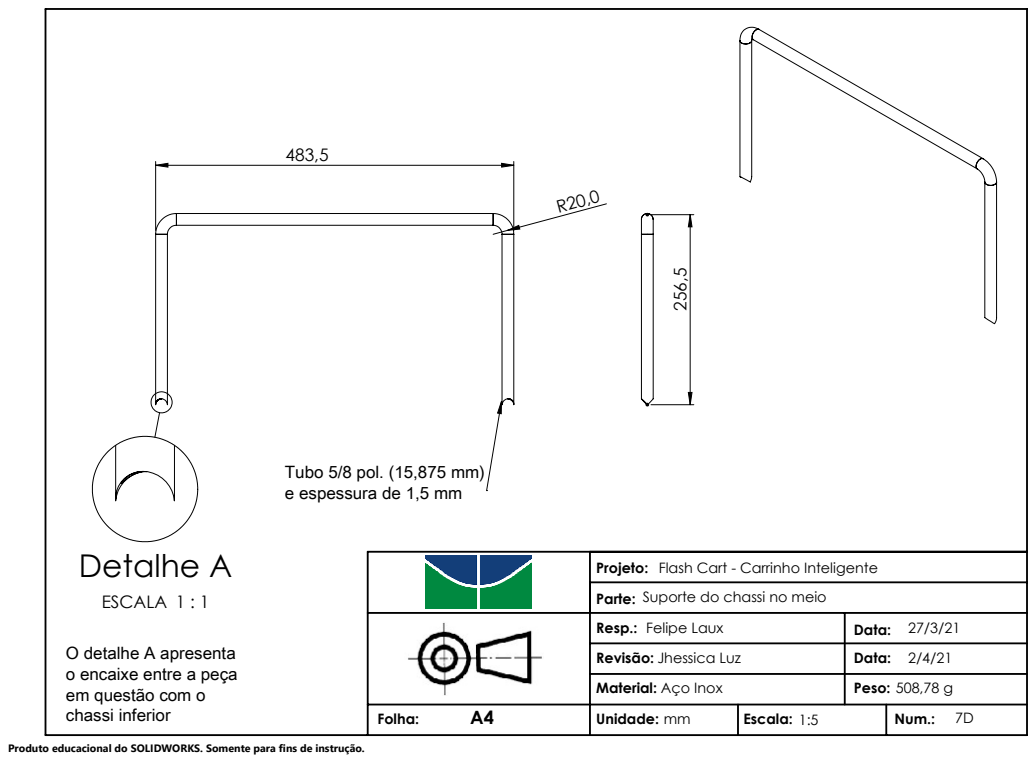
[picture p244: page 1]
Detalhe A; ESCALA 1 : 1

Tubo 5/8 pol. (15,875 mm)
e espessura de 1,5 mm

Projeto:
Suporte do chassi no meio
Parte:

Flash Cart - Carrinho Inteligente

Resp.: Felipe Laux | Data: 27/3/21
Revisão: Jhessica Luz | Data: 2/4/21
Material: Aço Inox | Peso: 508,78 g

O detalhe A apresenta
o encaixe entre a peça
em questão com o
chassi inferior

Folha: A4 | Unidade: mm | Escala: 1:5 | Num.: 7D

Produto educacional do SOLIDWORKS. Somente para fins de instrução.
