Flash-Cart/Flash-Cart-Model/4.Desenhos Tecnicos/Desenhos finais /Caleffi/Chassi/8D.PDF

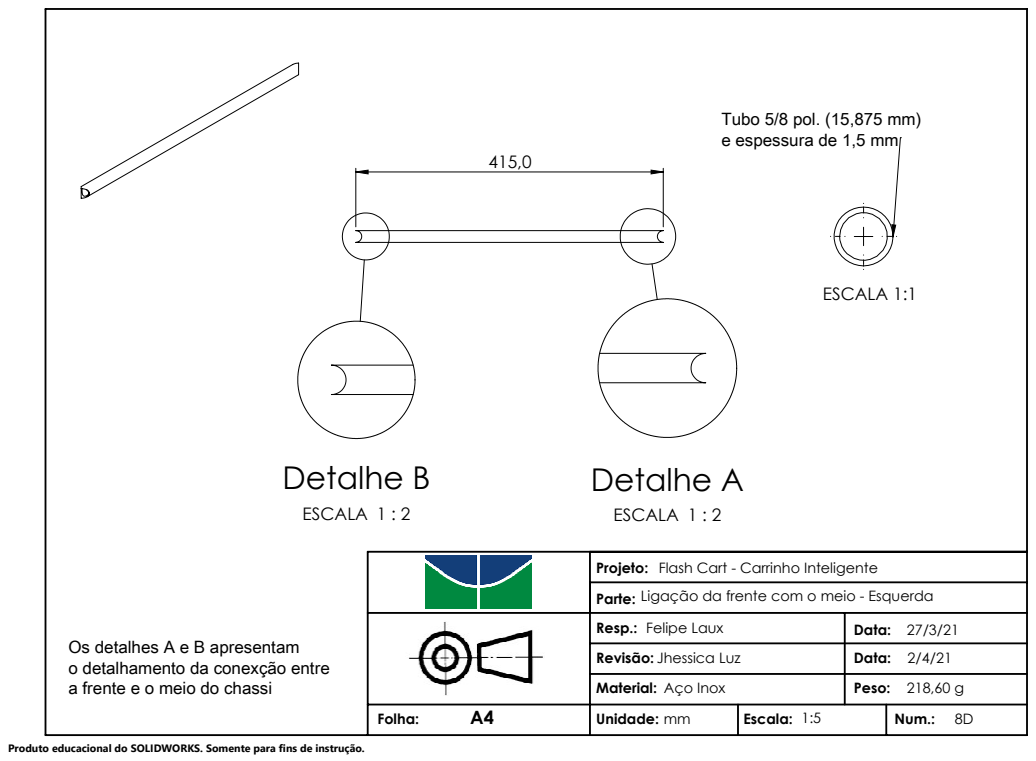
[picture p245: page 1]
Detalhe B; ESCALA 1 : 2; Detalhe A; ESCALA 1:1

Tubo 5/8 pol. (15,875 mm)
e espessura de 1,5 mm

Projeto:
Ligação da frente com o meio - Esquerda
Parte:

Flash Cart - Carrinho Inteligente

Resp.: Felipe Laux | Data: 27/3/21
Revisão: Jhessica Luz | Data: 2/4/21
Material: Aço Inox | Peso: 218,60 g

Os detalhes A e B apresentam
o detalhamento da conexção entre
a frente e o meio do chassi

Folha: A4 | Unidade: mm | Escala: 1:5 | Num.: 8D

Produto educacional do SOLIDWORKS. Somente para fins de instrução.
