Flash-Cart/Flash-Cart-Model/4.Desenhos Tecnicos/Desenhos finais /Caleffi/Chassi/D.1.PDF

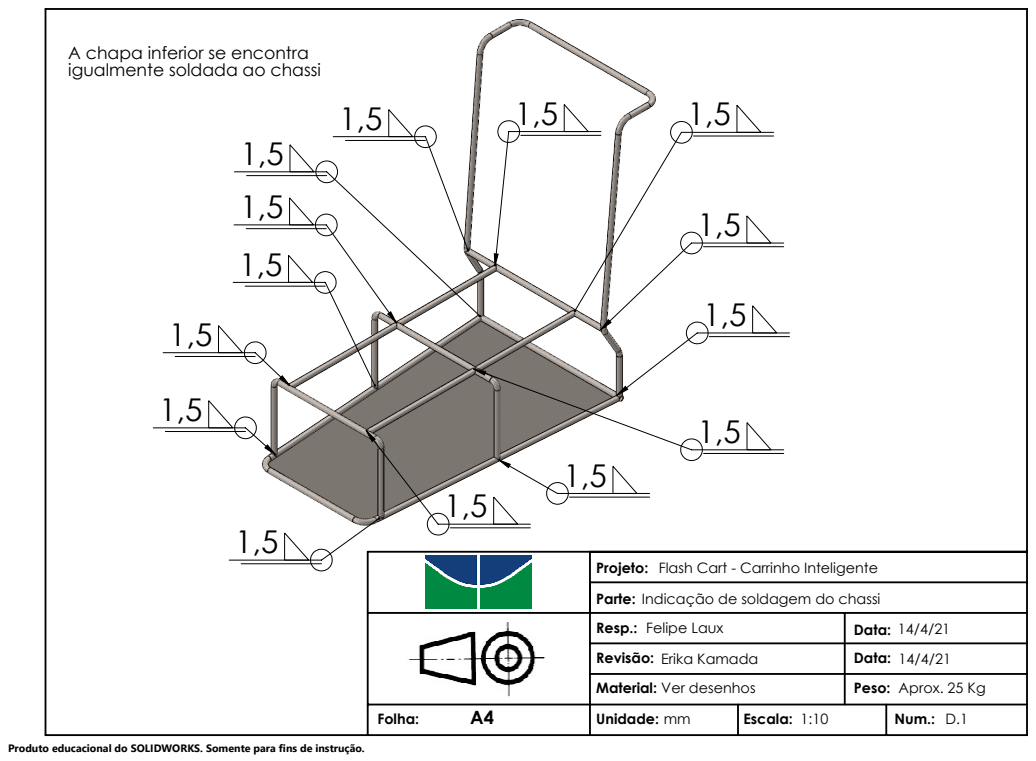
[picture p246: page 1]

A chapa inferior se encontra
igualmente soldada ao chassi

Projeto:
Parte:
Indicação de soldagem do chassi

Flash Cart - Carrinho Inteligente

Resp.: Felipe Laux | Data: 14/4/21
Revisão: Erika Kamada | Data: 14/4/21
Material: Ver desenhos | Peso: Aprox. 25 Kg

Folha: A4 | Unidade: mm | Escala: 1:10 | Num.: D.1

Produto educacional do SOLIDWORKS. Somente para fins de instrução.
