Flash-Cart/Flash-Cart-Model/4.Desenhos Tecnicos/Desenhos finais /Caleffi/Molde/19H.PDF

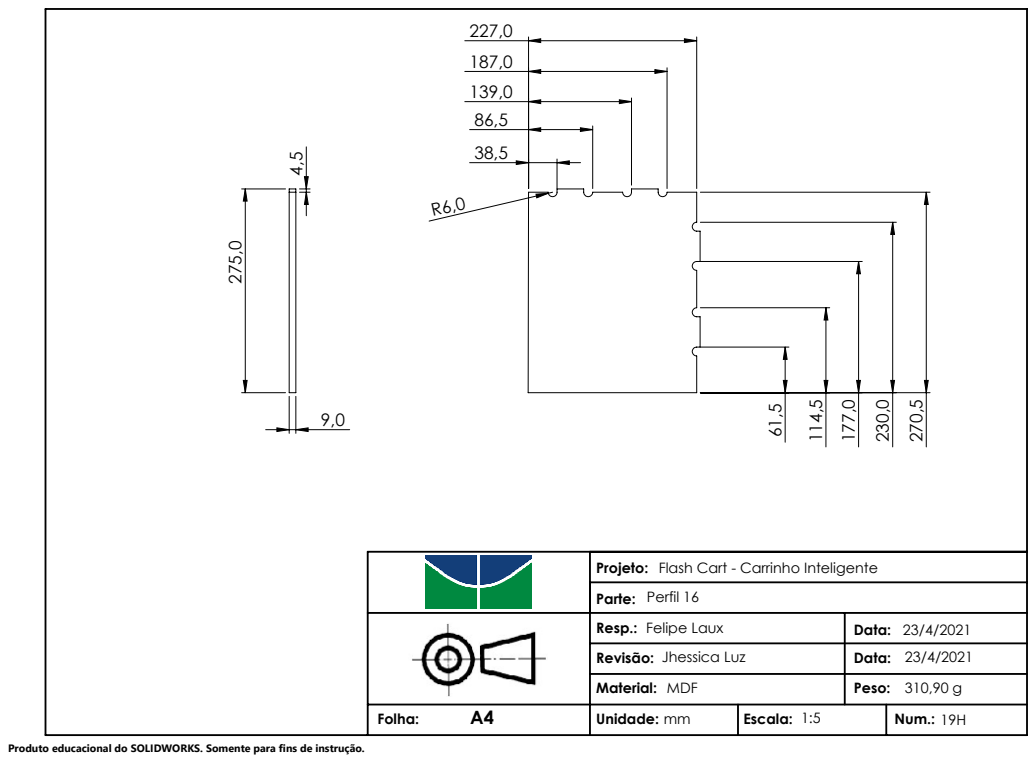
[picture p247: page 1]
Perfil 16

Flash Cart - Carrinho Inteligente

Resp.: Felipe Laux | Data: 23/4/2021
Revisão: Jhessica Luz | Data: 23/4/2021
Material: MDF | Peso: 310,90 g

Folha: A4 | Unidade: mm | Escala: 1:5 | Num.: 19H

Produto educacional do SOLIDWORKS. Somente para fins de instrução.
