Flash-Cart/Flash-Cart-Model/5.Manuais/Balança/Montagem_Balanca_manual.pdf

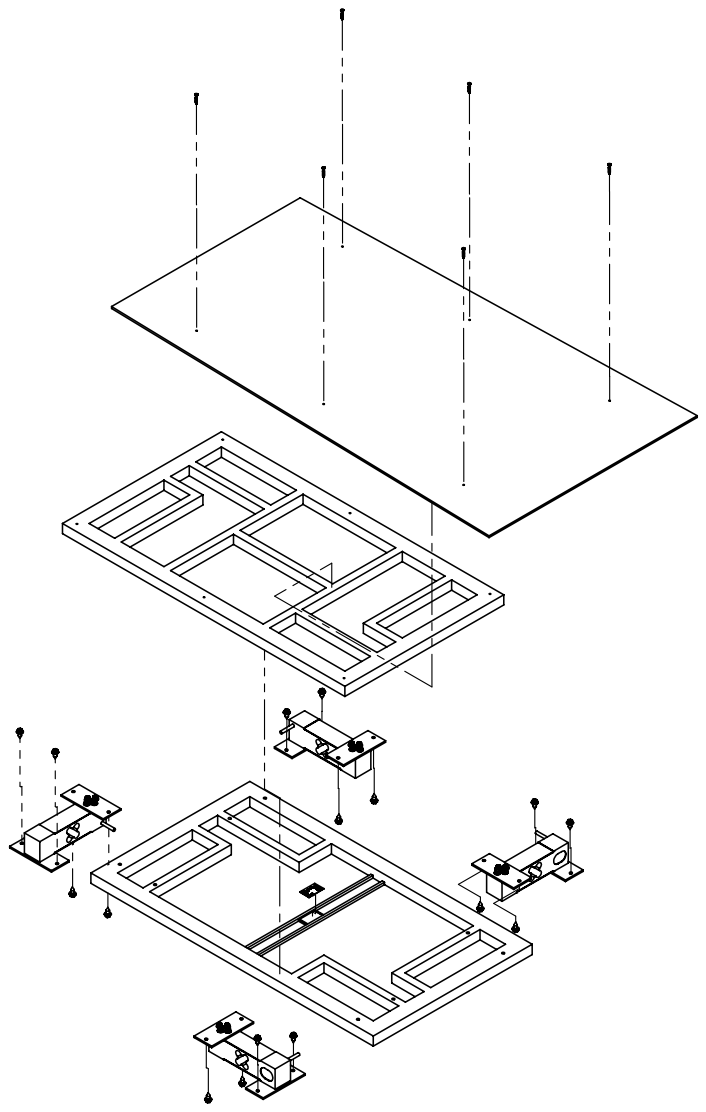
[picture p248: page 1]
