Flash-Cart/Flash-Cart-Model/5.Manuais/Manual_Chassi/Chassi.pdf

8

D | D

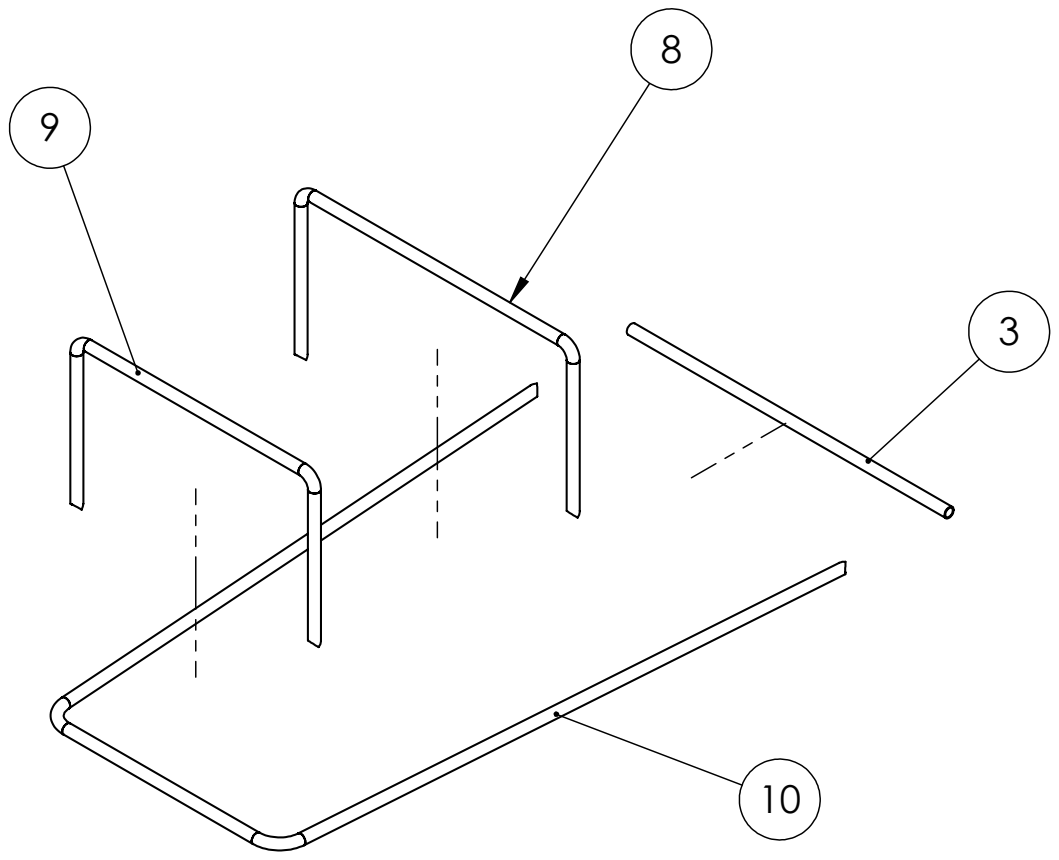
[picture p249: page 1]

Produto educacional do SOLIDWORKS. Somente para fins de instrução.

D | D

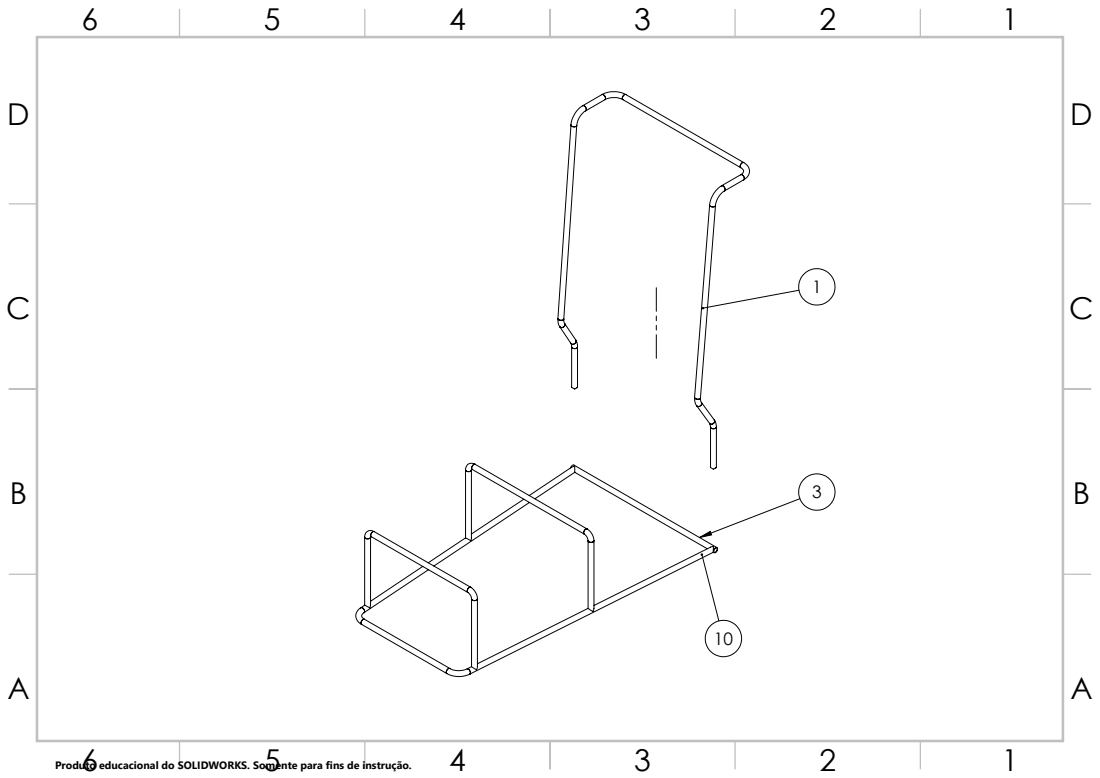
[picture p250: page 2]

D | D

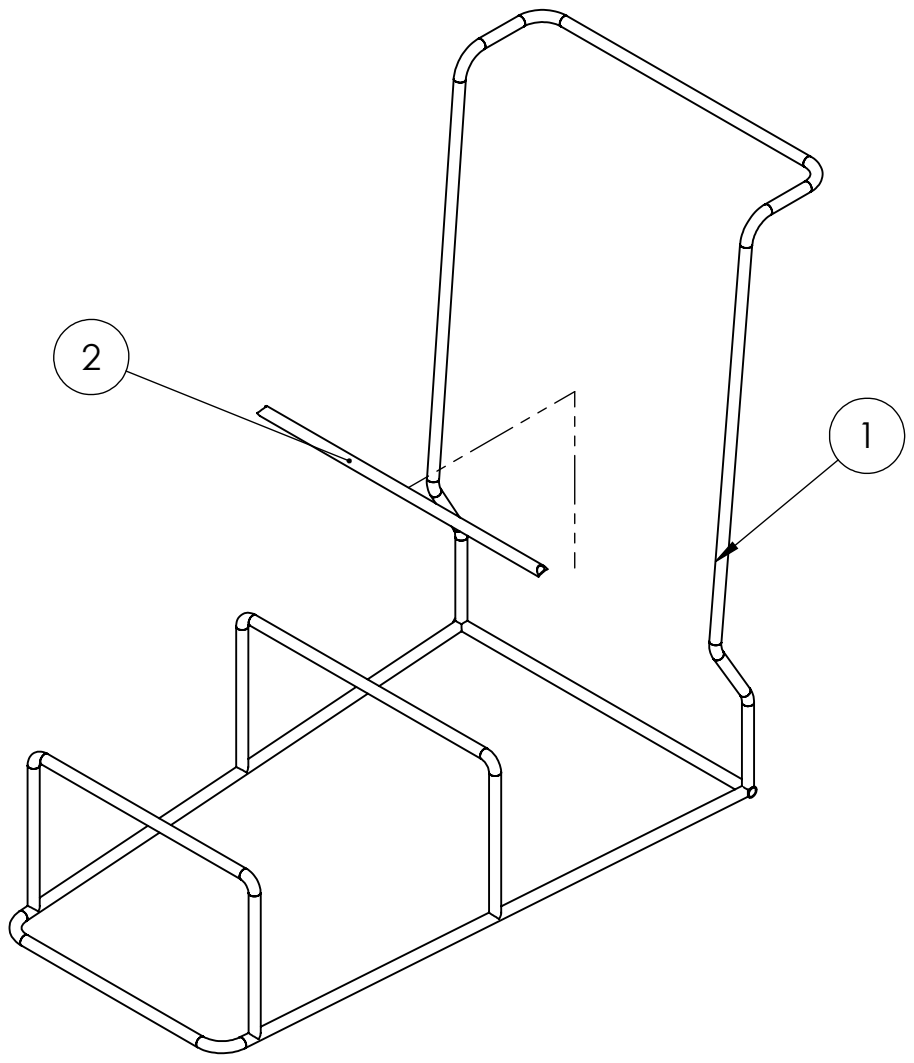
[picture p251: page 3]

5

D | D

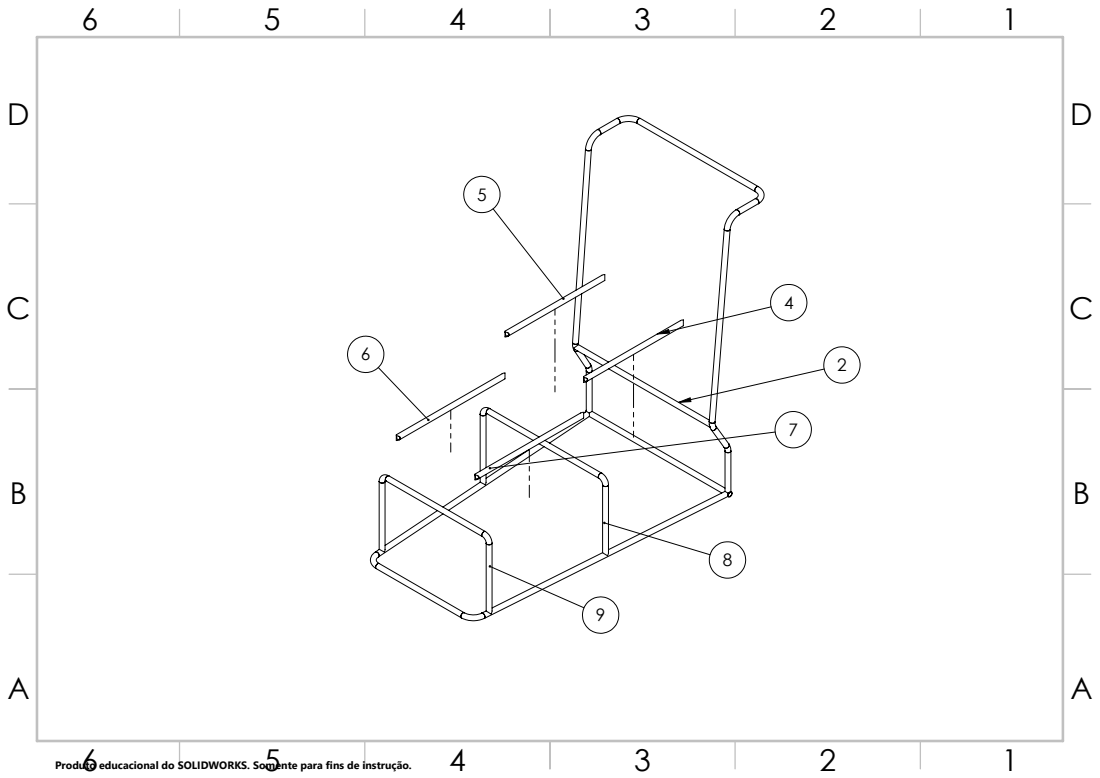
[picture p252: page 4]

D | D

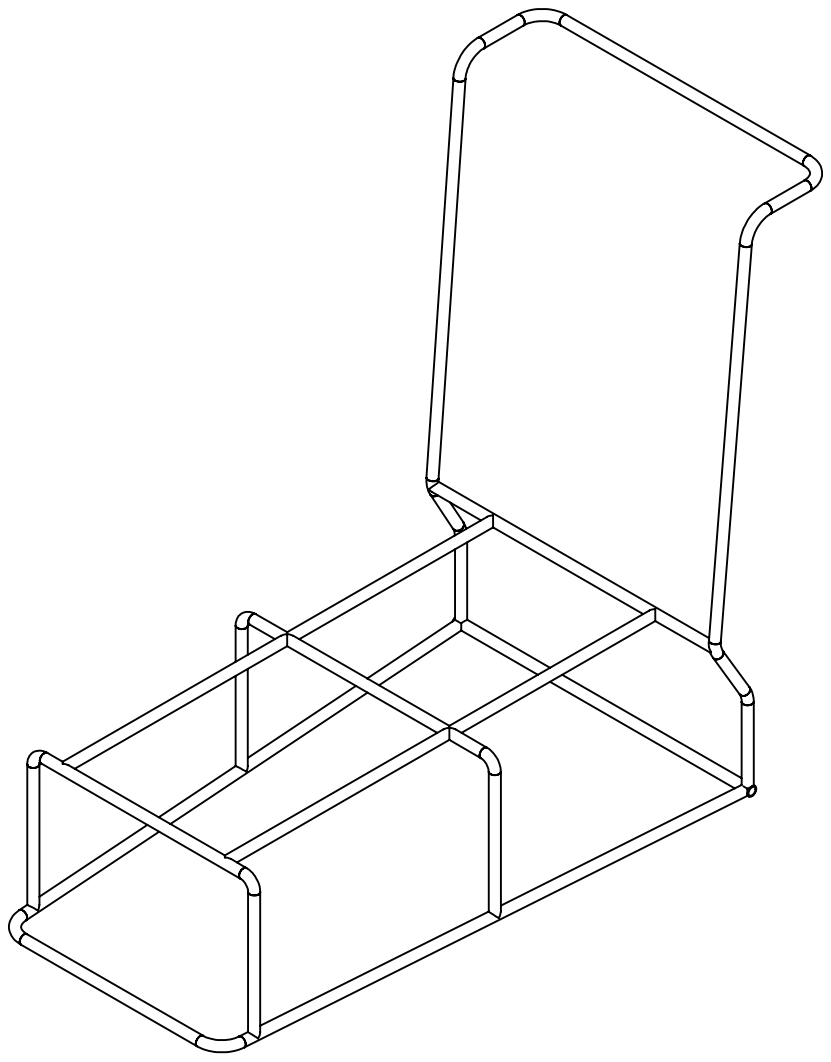
[picture p253: page 5]
