Flash-Cart/Flash-Cart-Model/5.Manuais/Balança/combinepdf (4).pdf

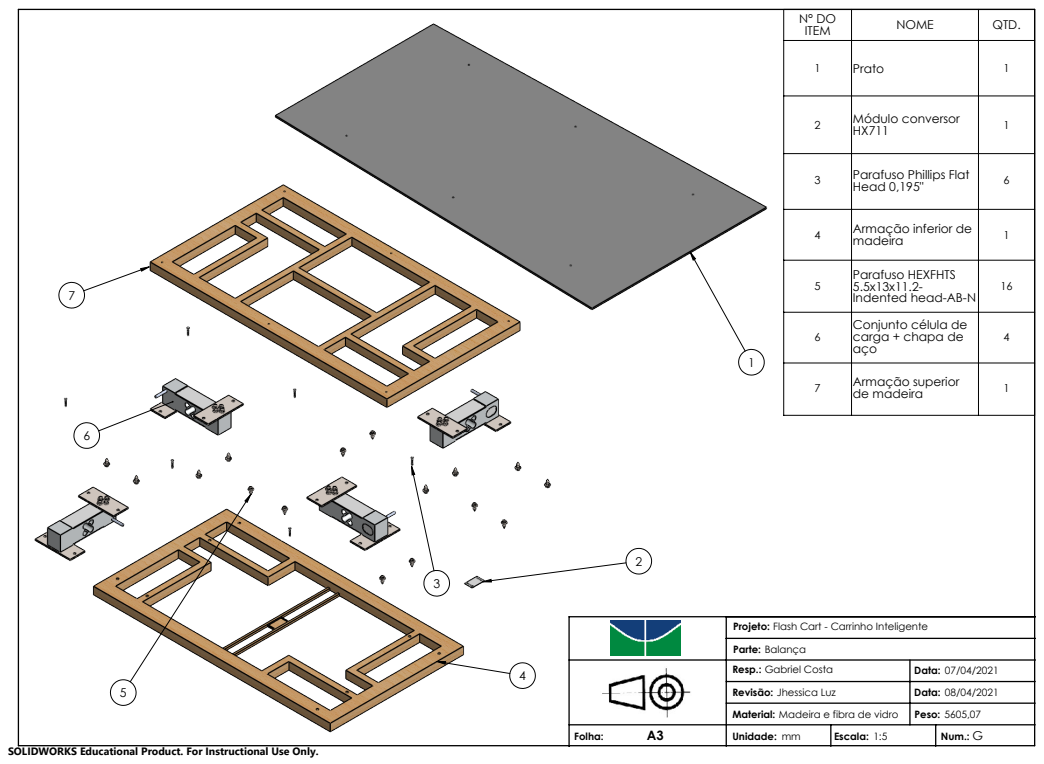
[picture p254: page 1]

N° DO ITEM | NOME | QTD.

1 | Prato | 1

2 | Módulo conversor HX711 | 1

3 | Parafuso Phillips Flat Head 0,195" | 6

4 | Armação inferior de madeira | 1

5 | Parafuso HEXFHTS 5.5x13x11.2-Indented head-AB-N | 16

6 | Conjunto célula de carga + chapa de aço | 4

7 | Armação superior de madeira | 1

Projeto:
Flash Cart - Carrinho Inteligente
Parte:
Balança

Resp.: Gabriel Costa | Data: 07/04/2021
Revisão: Jhessica Luz | Data: 08/04/2021
Material: Madeira e fibra de vidro | Peso: 5605,07

Folha: A3 | Unidade: mm | Escala: 1:5 | G Num.:

SOLIDWORKS Educational Product. For Instructional Use Only.

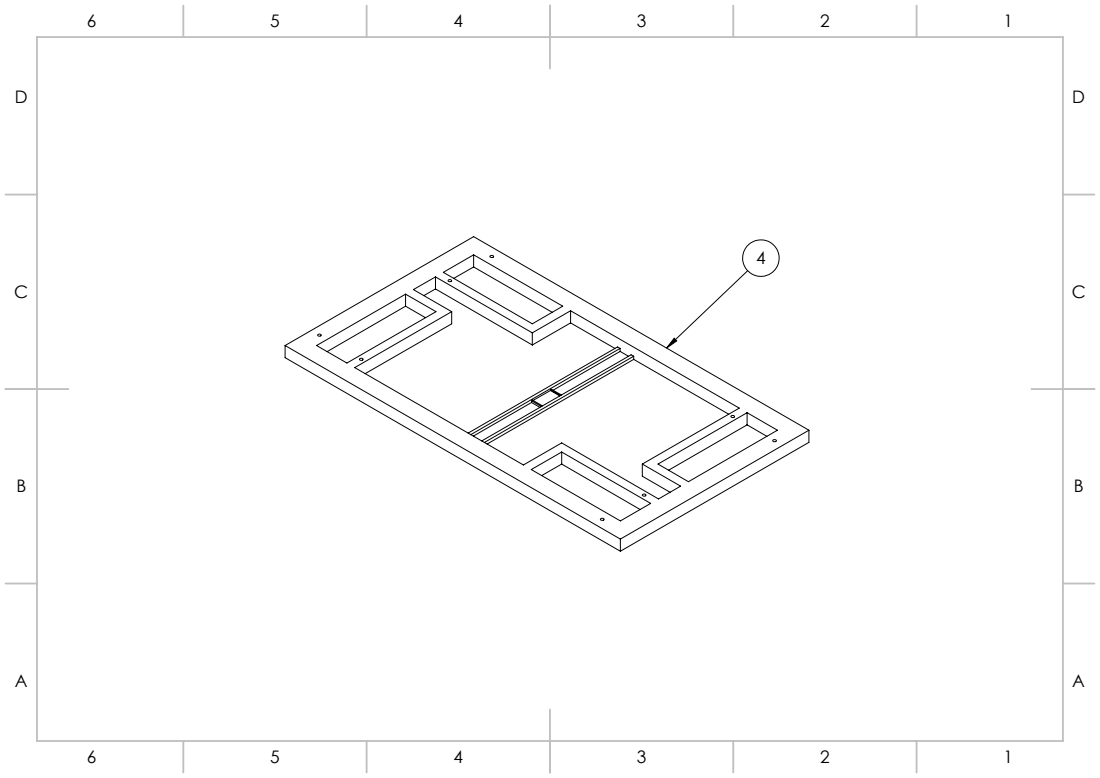
[picture p255: page 2]

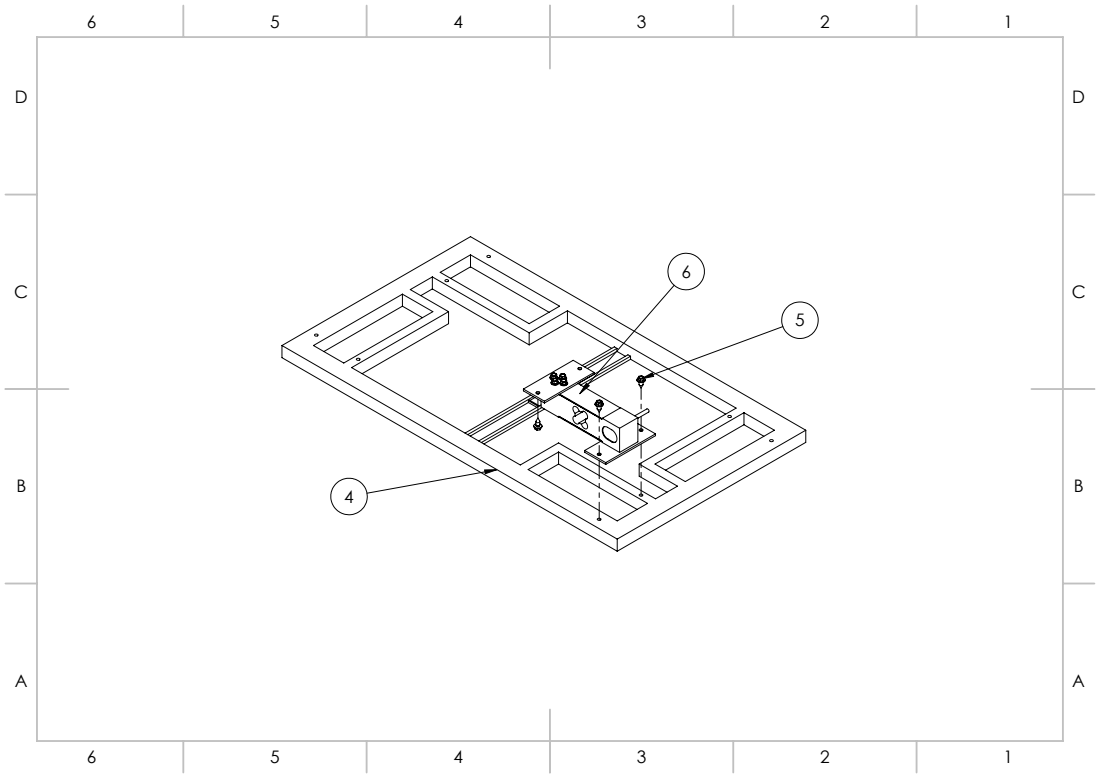
[picture p256: page 3]

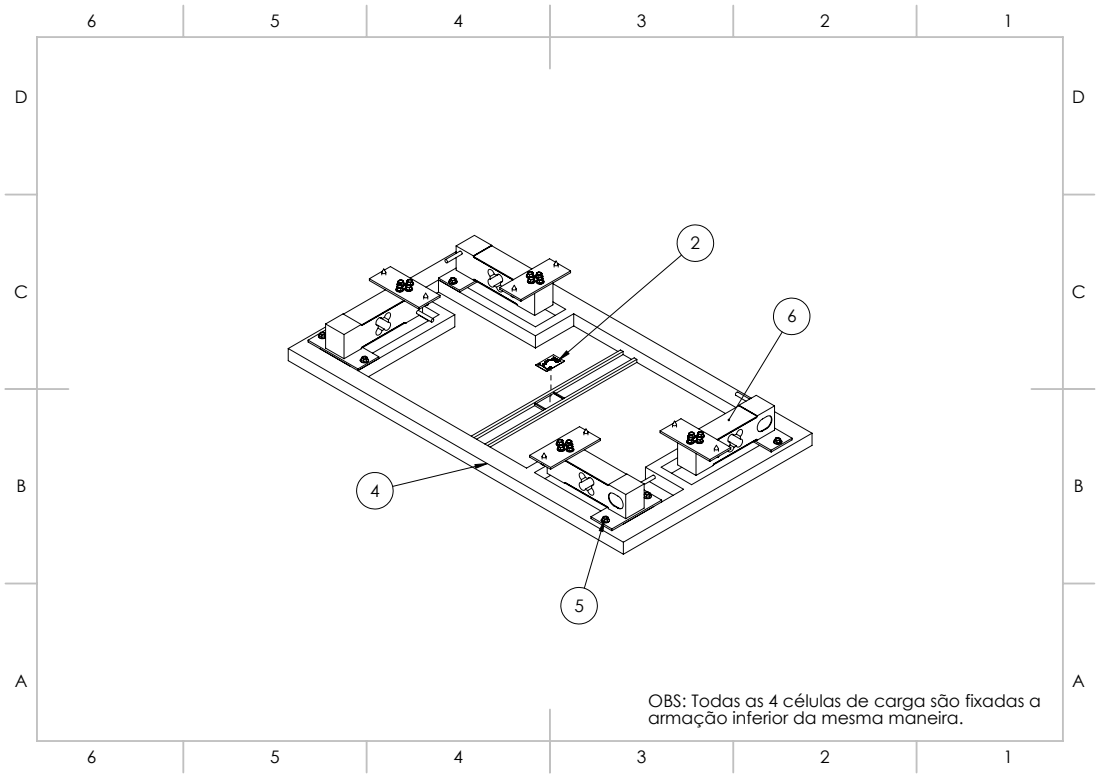
[picture p257: page 4]

OBS: Todas as 4 células de carga são fixadas a
armação inferior da mesma maneira.

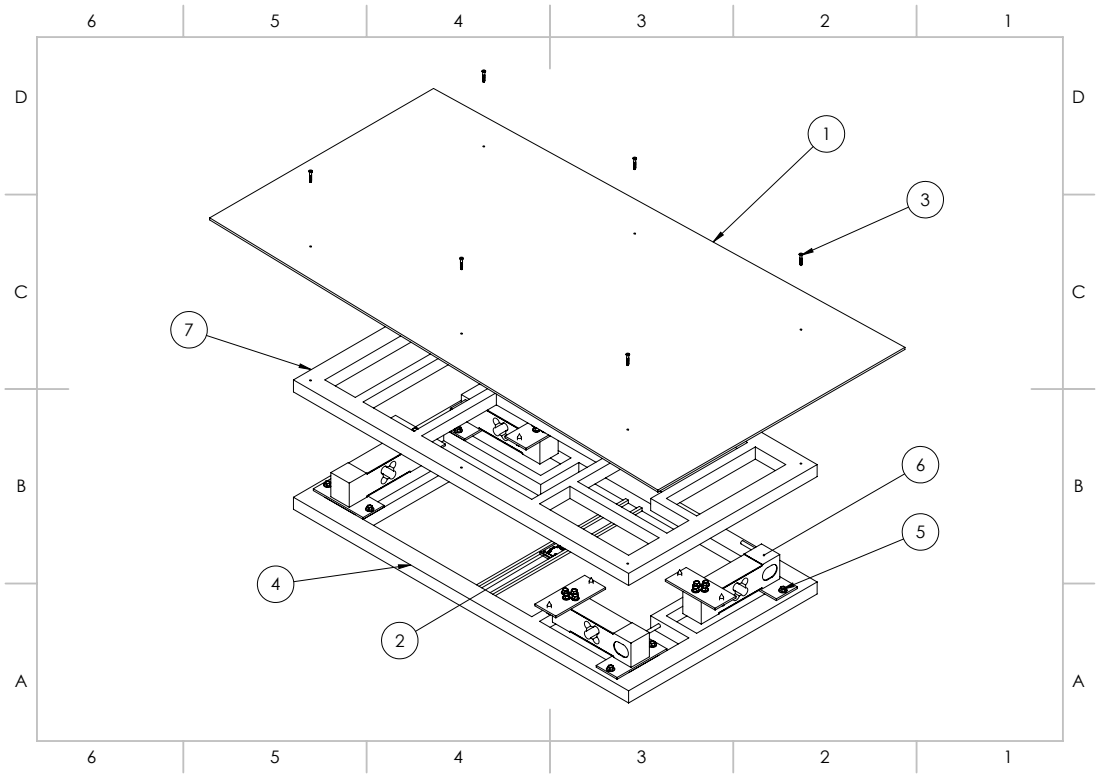
[picture p258: page 5]

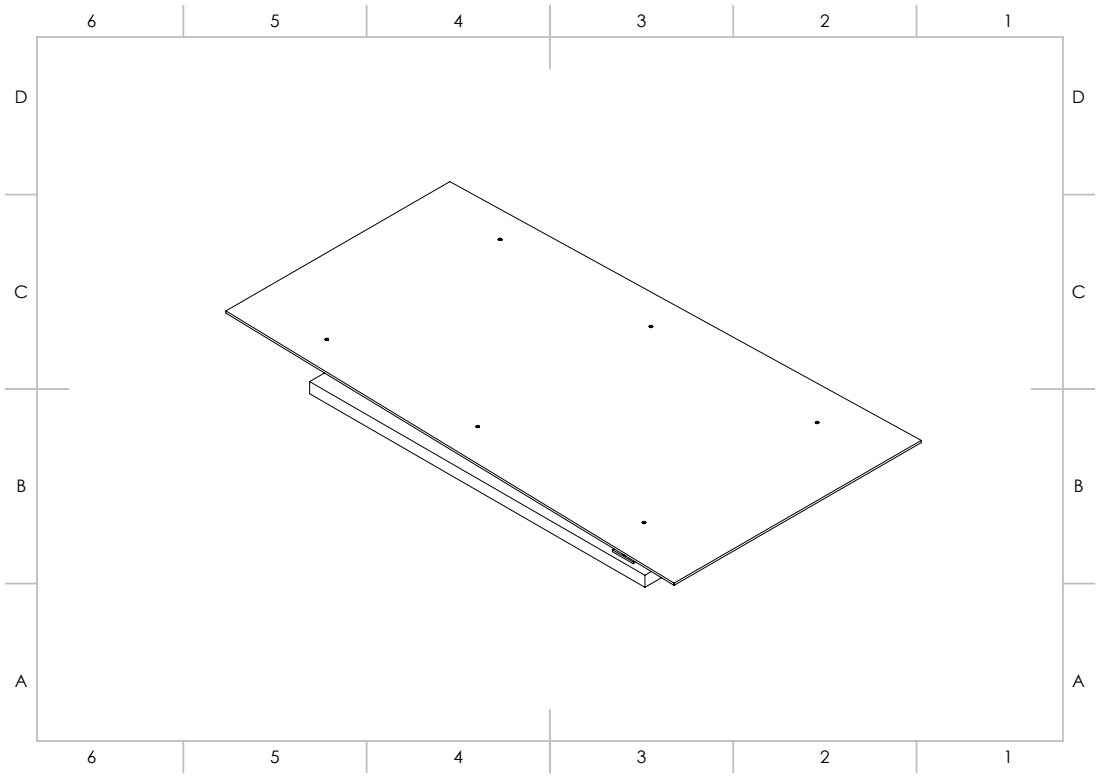
[picture p259: page 6]
