Flash-Cart/Flash-Cart-Model/5.Manuais/Balança/Passo 3.PDF

OBS: Todas as 4 células de carga são fixadas a
armação inferior da mesma maneira.
