Flash-Cart/Flash-Cart-Model/5.Manuais/Caixa da bateria/passo1.pdf

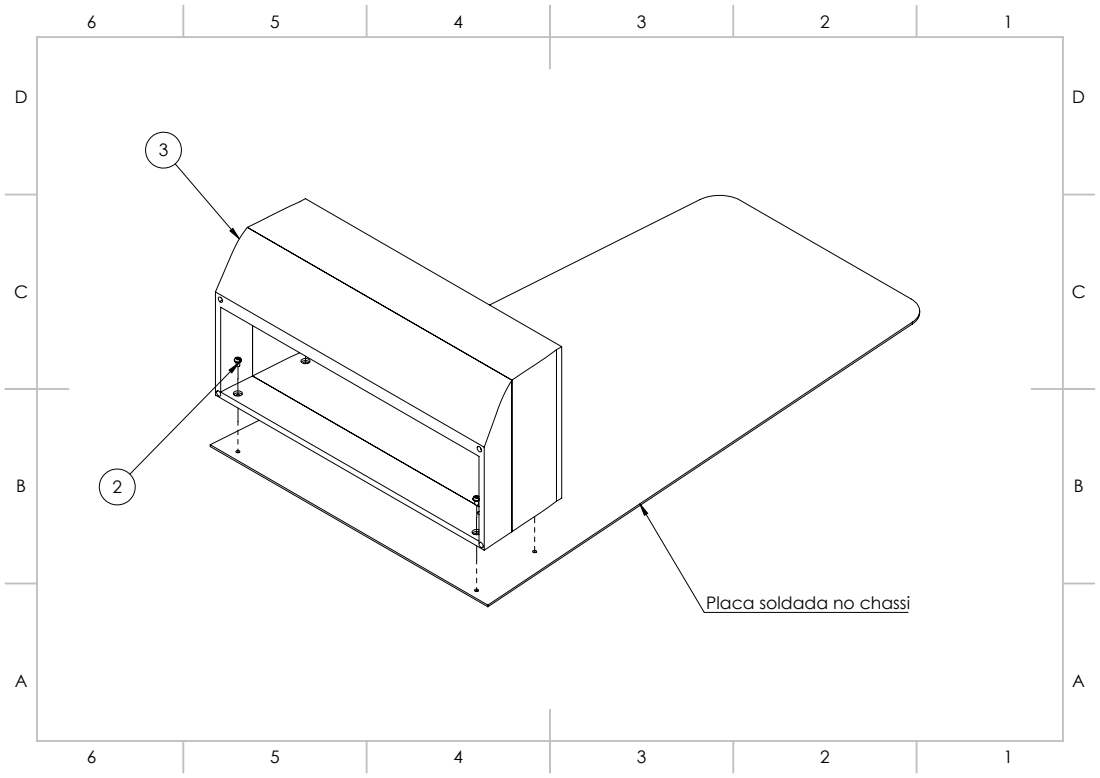
[picture p260: page 1]

Placa soldada no chassi
