Flash-Cart/Flash-Cart-Model/5.Manuais/Caixa da bateria/passo2 atualizado.pdf

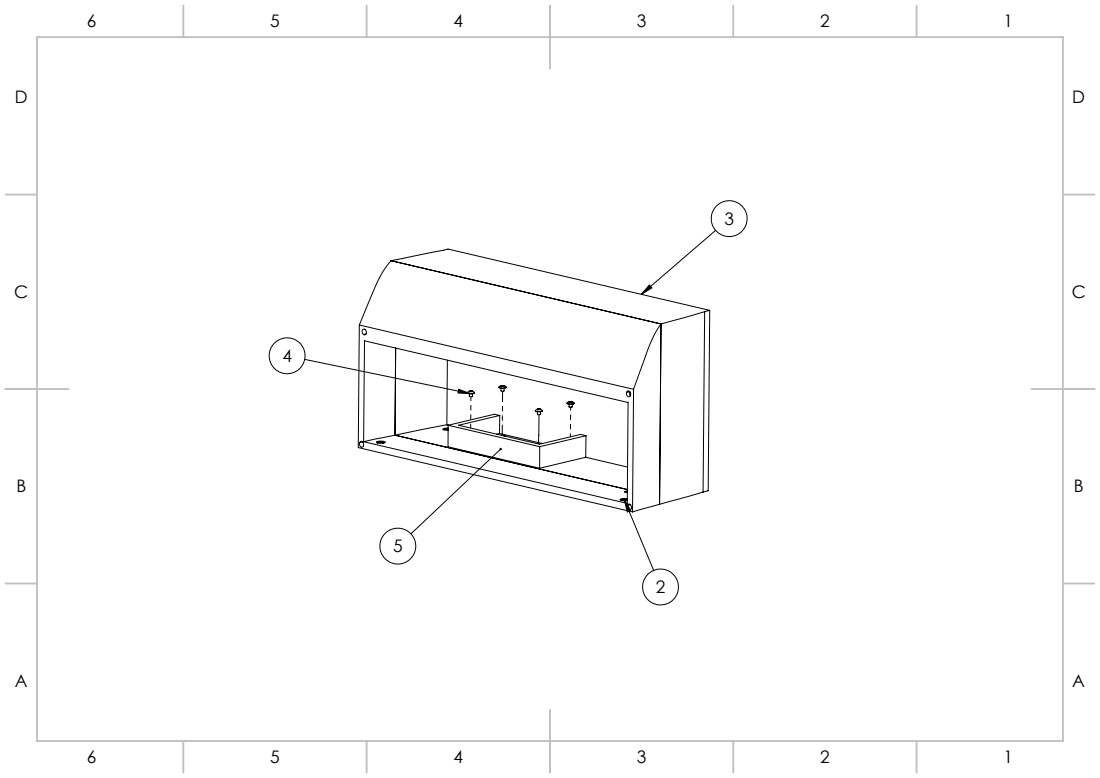
[picture p261: page 1]
