Flash-Cart/Flash-Cart-Model/5.Manuais/Caixa da bateria/passo3 atualizado.pdf

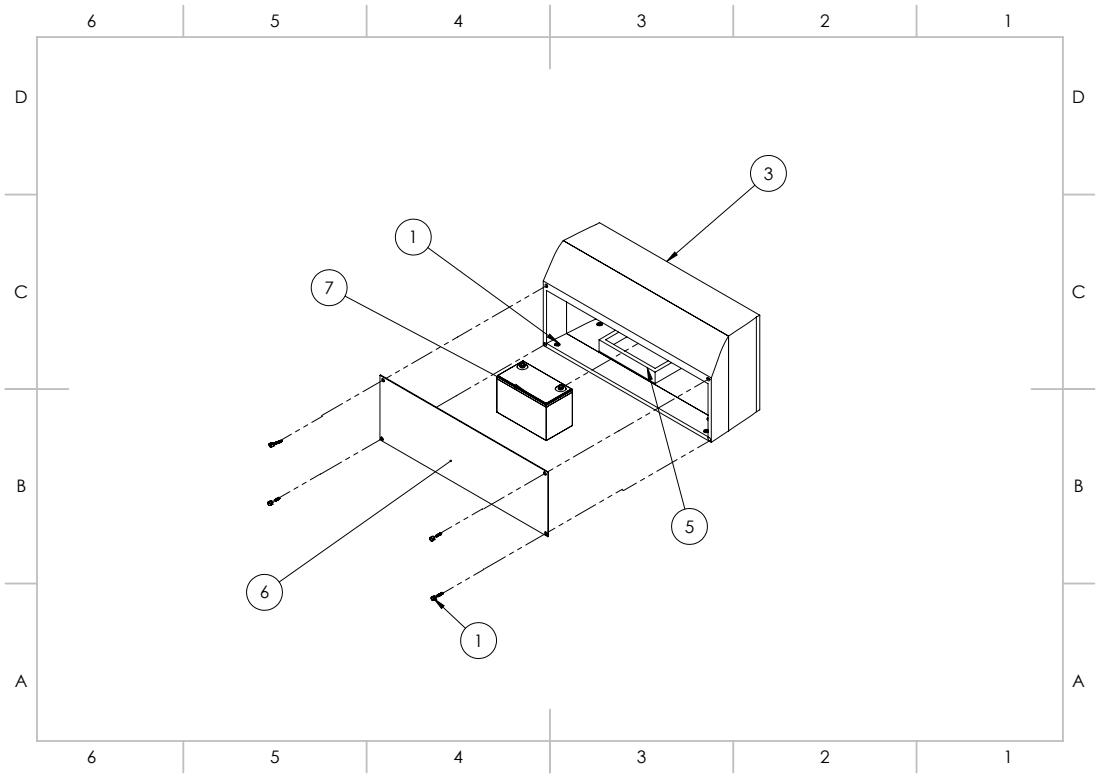
[picture p262: page 1]
