Flash-Cart/Flash-Cart-Model/5.Manuais/Caixa da bateria/passo4 atualizado.pdf

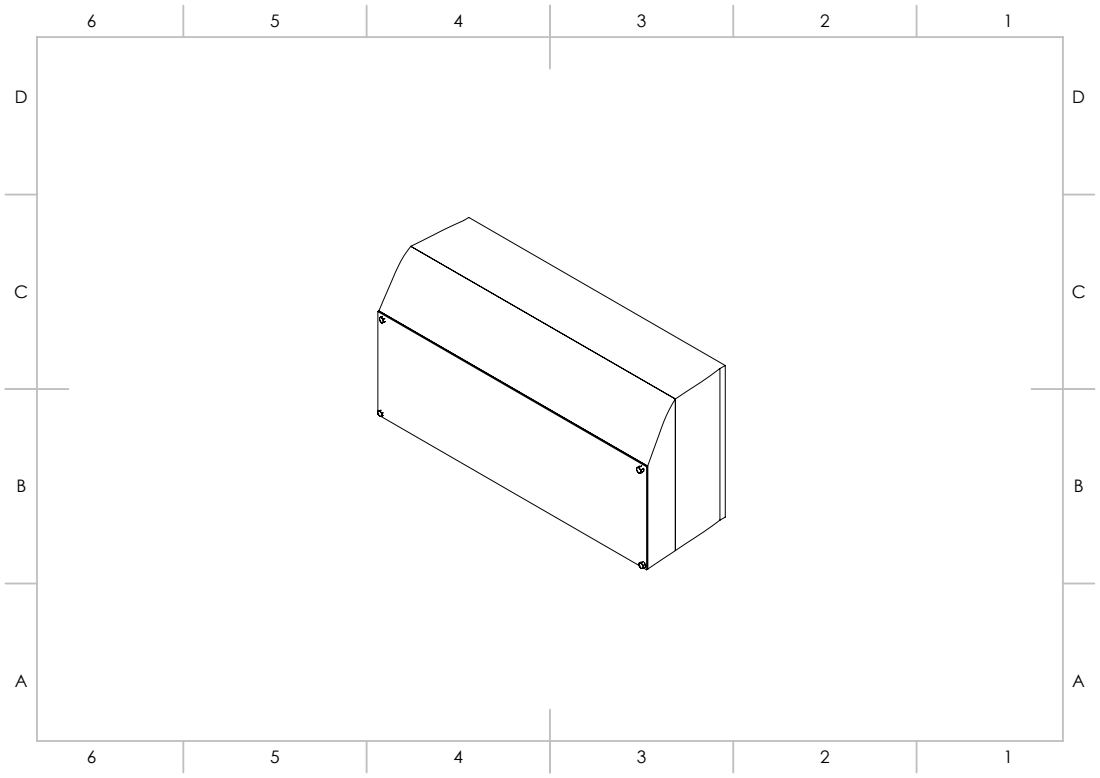
[picture p263: page 1]
