Flash-Cart/Flash-Cart-Model/5.Manuais/Cesta + balança + capas/Flash cart colorido.pdf

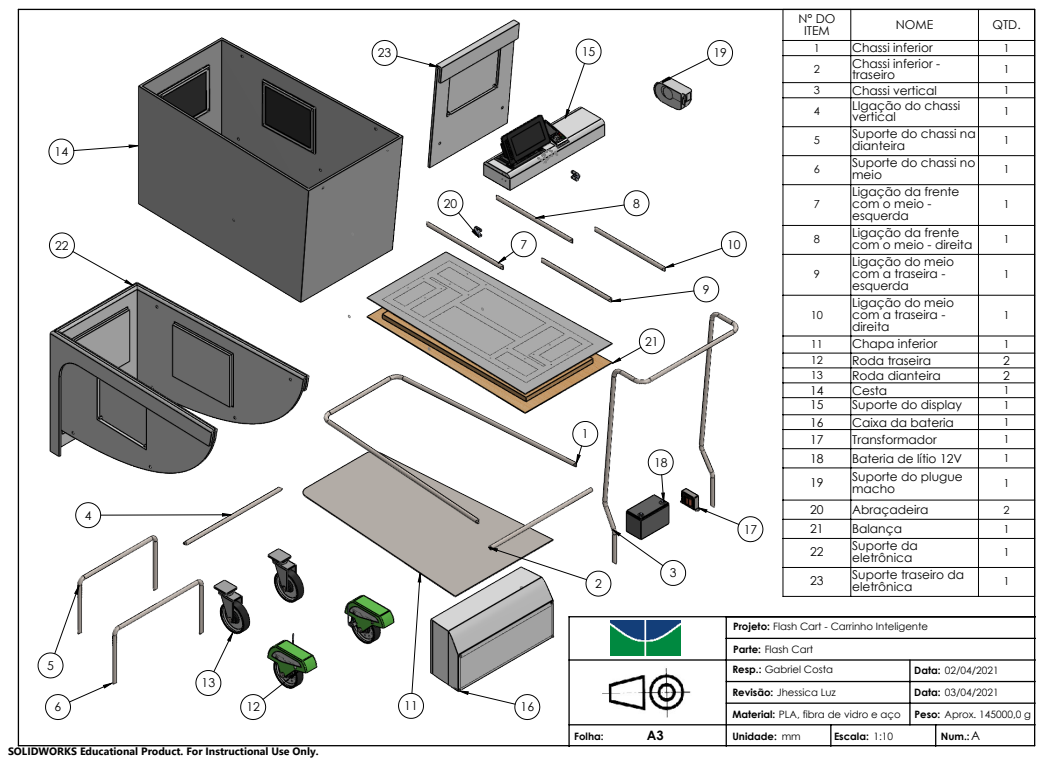
[picture p264: page 1]

N° DO ITEM | NOME | QTD.
1 | Chassi inferior | 1
2 | Chassi inferior -traseiro | 1
3 | Chassi vertical | 1
4 | LIgação do chassi vertical | 1
5 | Suporte do chassi na dianteira | 1
6 | Suporte do chassi no meio | 1
7 | Ligação da frente com o meio -esquerda | 1

8 | Ligação da frente com o meio - direita | 1
9 | Ligação do meio com a traseira -esquerda | 1

10 | Ligação do meio com a traseira -direita | 1

11 | Chapa inferior | 1
12 | Roda traseira | 2
13 | Roda dianteira | 2
14 | Cesta | 1
15 | Suporte do display | 1
16 | Caixa da bateria | 1
17 | Transformador | 1
18 | Bateria de lítio 12V | 1
19 | Suporte do plugue macho | 1

20 | Abraçadeira | 2
21 | Balança | 1
22 | Suporte da eletrônica | 1
23 | Suporte traseiro da eletrônica | 1

Projeto:
Flash Cart - Carrinho Inteligente
Parte:
Flash Cart

Resp.: Gabriel Costa | Data: 02/04/2021
Revisão: Jhessica Luz | Data: 03/04/2021
Material: PLA, fibra de vidro e aço | Peso: Aprox. 145000,0 g

Folha: A3 | mm Unidade: | Escala: 1:10 | A Num.:

SOLIDWORKS Educational Product. For Instructional Use Only.
