Flash-Cart/Flash-Cart-Model/5.Manuais/Cesta + balança + capas/passo4.pdf

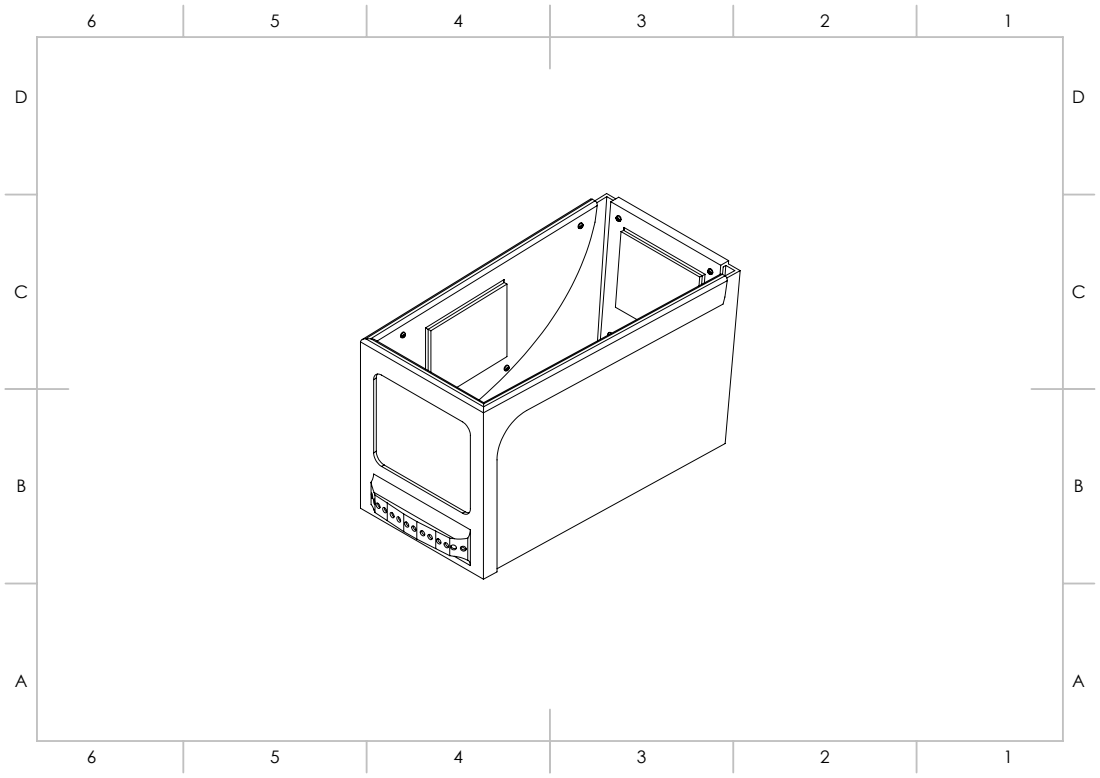
[picture p265: page 1]
