Flash-Cart/Flash-Cart-Model/5.Manuais/Explodida chassi + roda + placa/exploded chassi roda e placa colorido.pdf

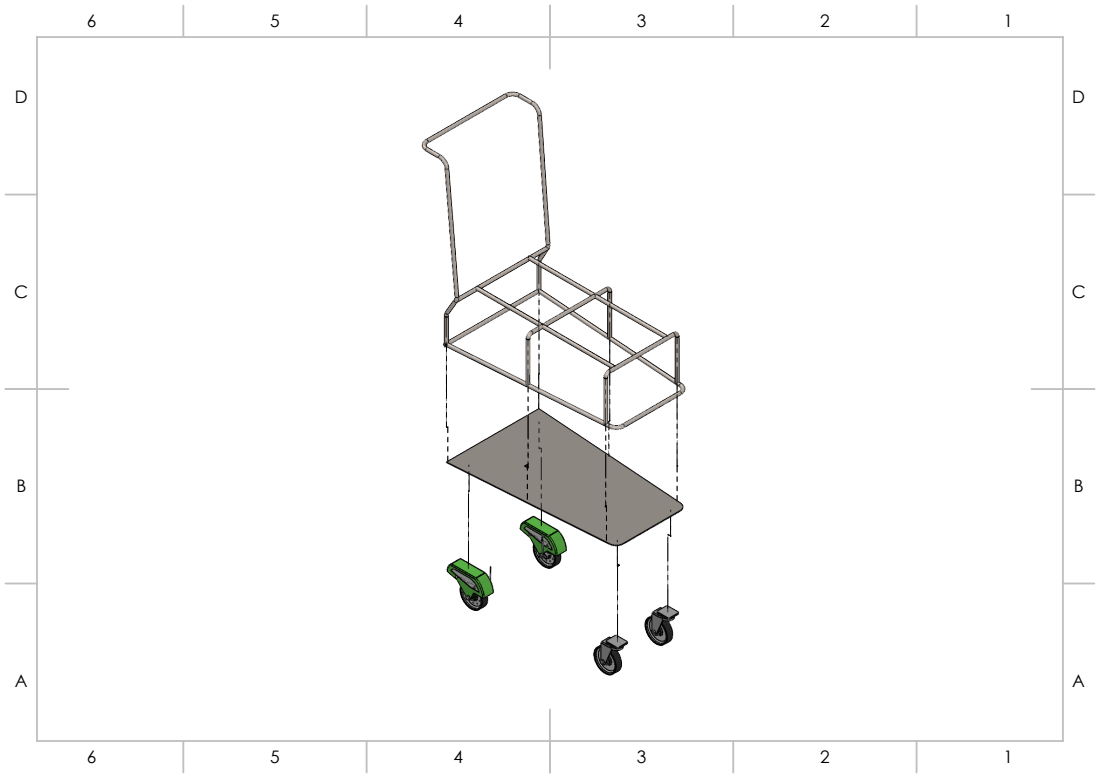
[picture p266: page 1]
