Flash-Cart/Flash-Cart-Model/5.Manuais/Explodida chassi + roda + placa/exploded chassi+roda+placa.PDF

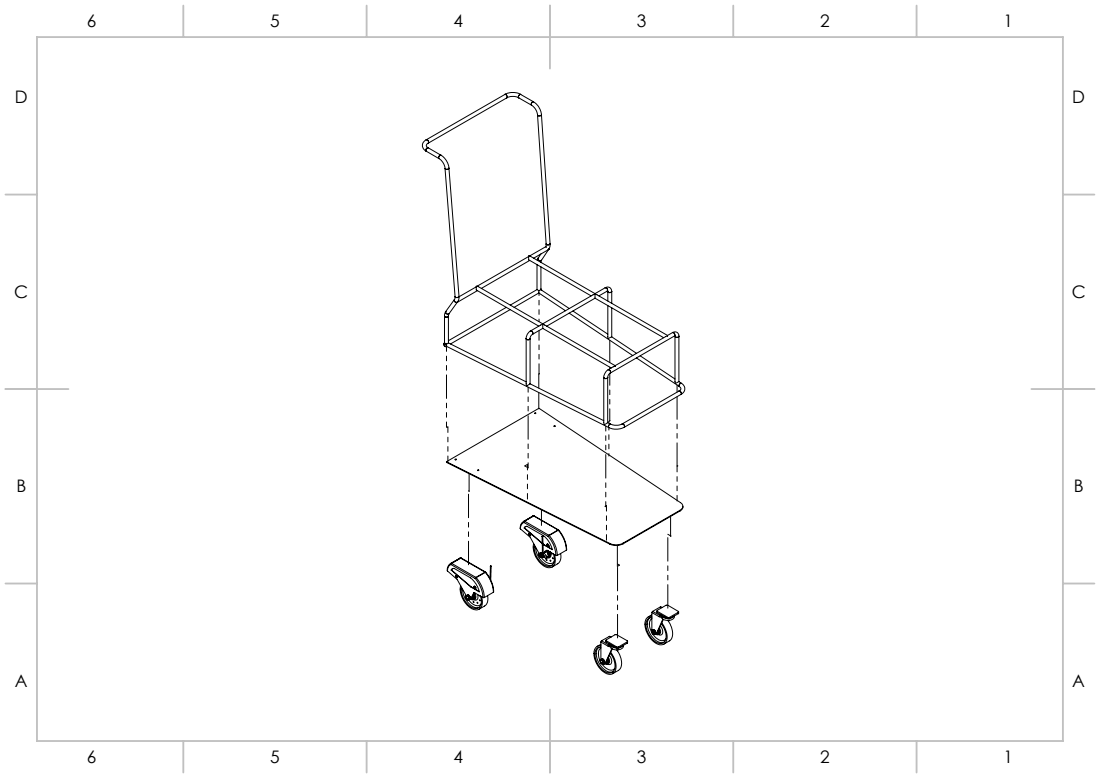
[picture p267: page 1]
