Flash-Cart/Flash-Cart-Model/5.Manuais/Plugue/passo1.pdf

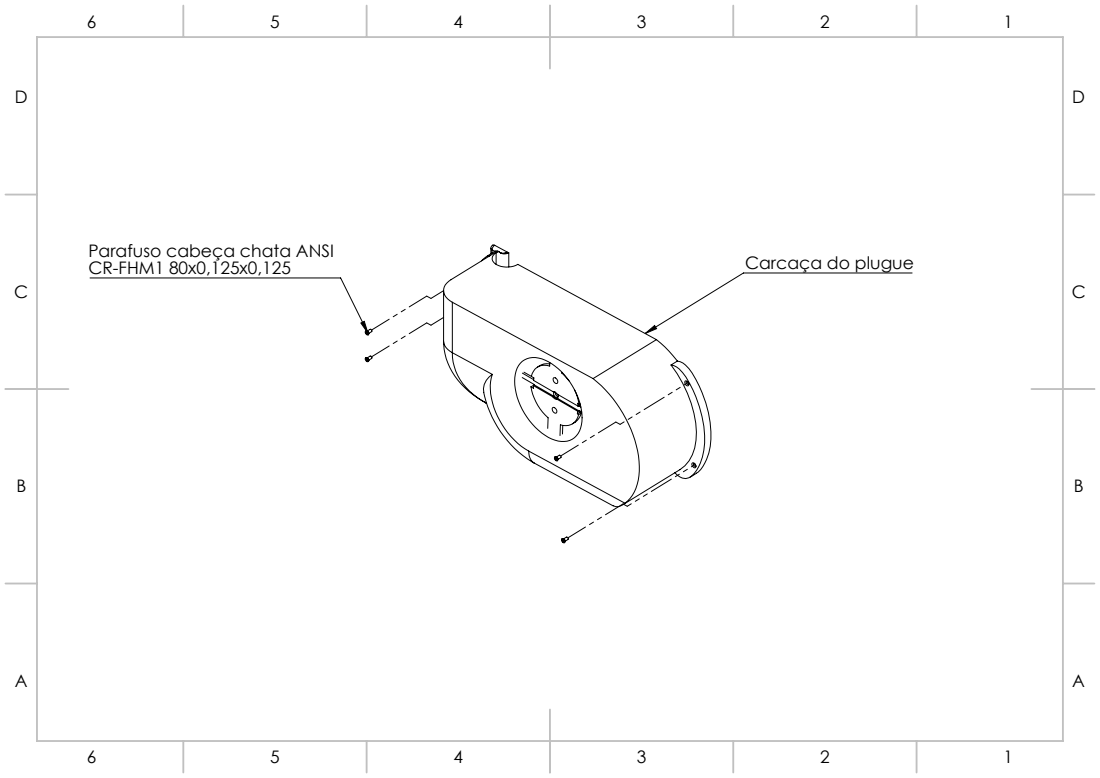
[picture p268: page 1]

Carcaça do plugue Parafuso cabeça chata ANSI
CR-FHM1 80x0,125x0,125
