Flash-Cart/Flash-Cart-Model/5.Manuais/Plugue/passo2.PDF

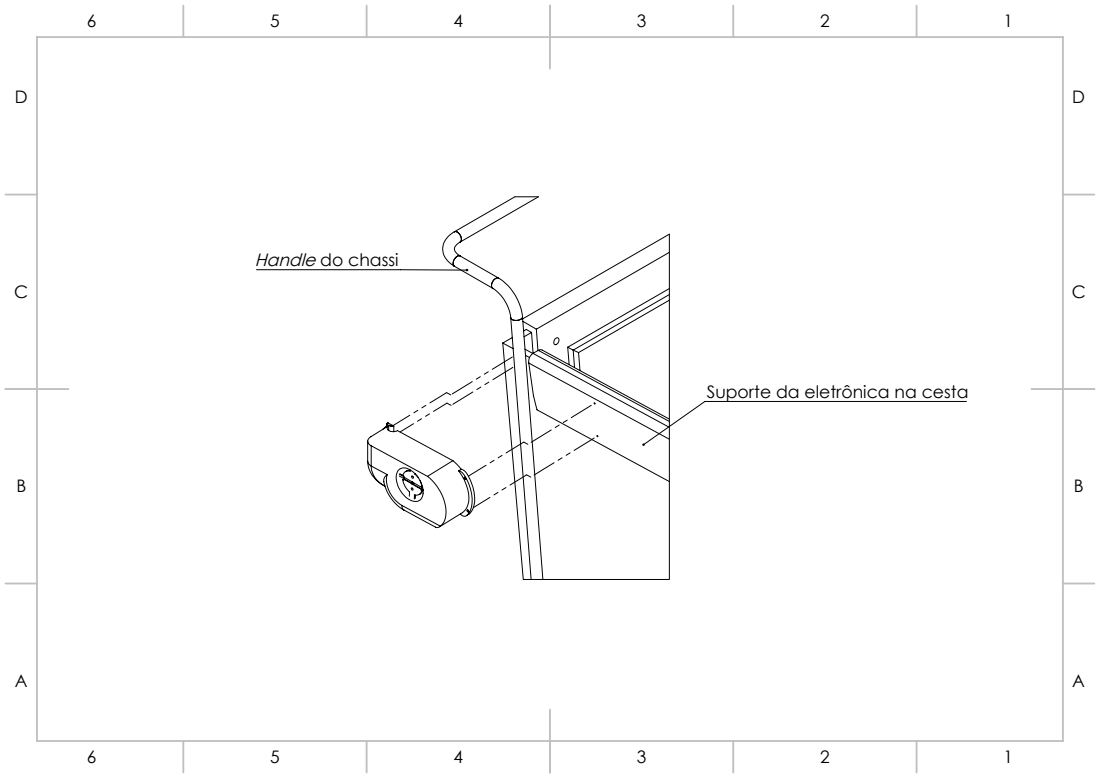
[picture p269: page 1]

Handle do chassi

Suporte da eletrônica na cesta
