Flash-Cart/Flash-Cart-Model/5.Manuais/Plugue/passo3.pdf

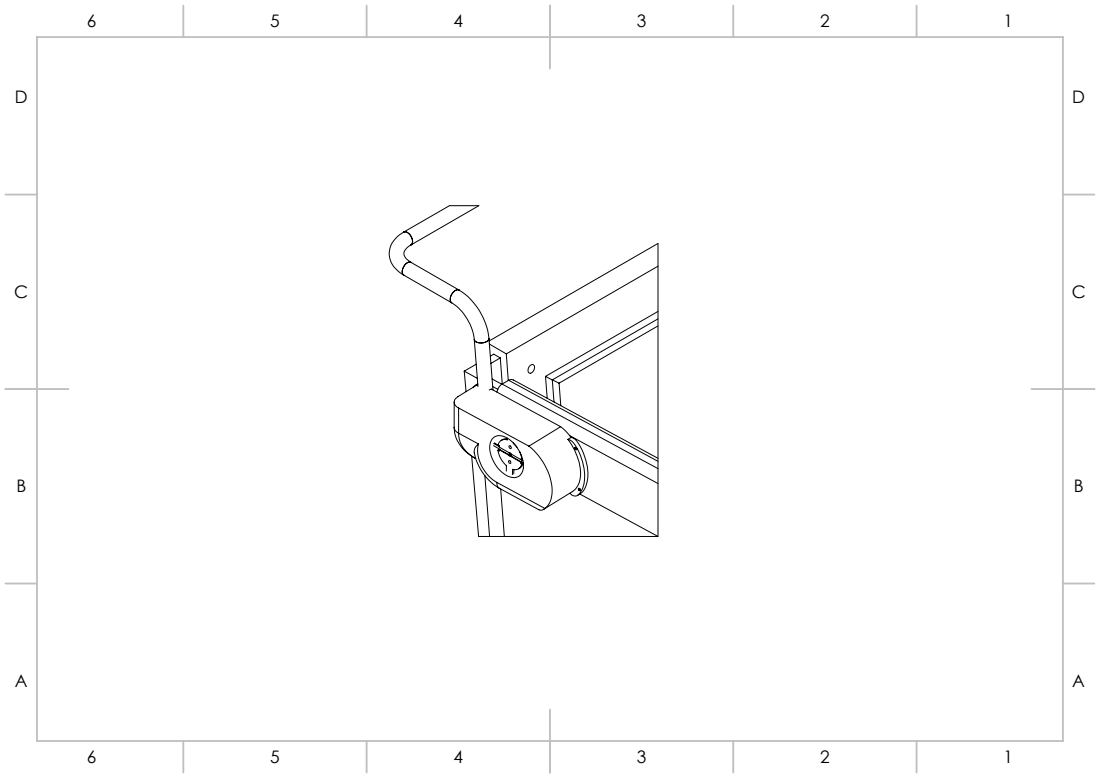
[picture p270: page 1]
