Flash-Cart/Flash-Cart-Model/5.Manuais/RodaDianteira/RodaDianteira.pdf

D | D

6

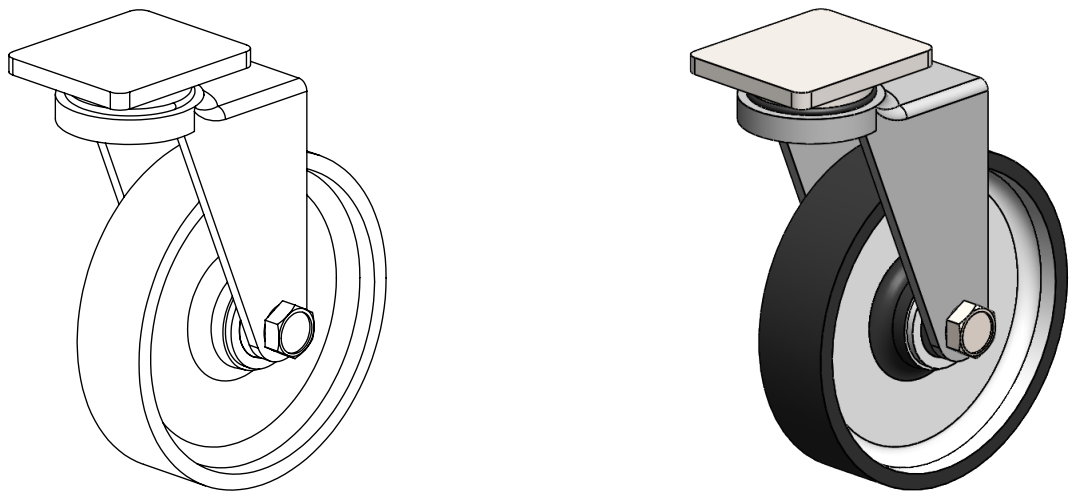
[picture p271: page 1]

Produto educacional do SOLIDWORKS. Somente para fins de instrução.

1

D | D

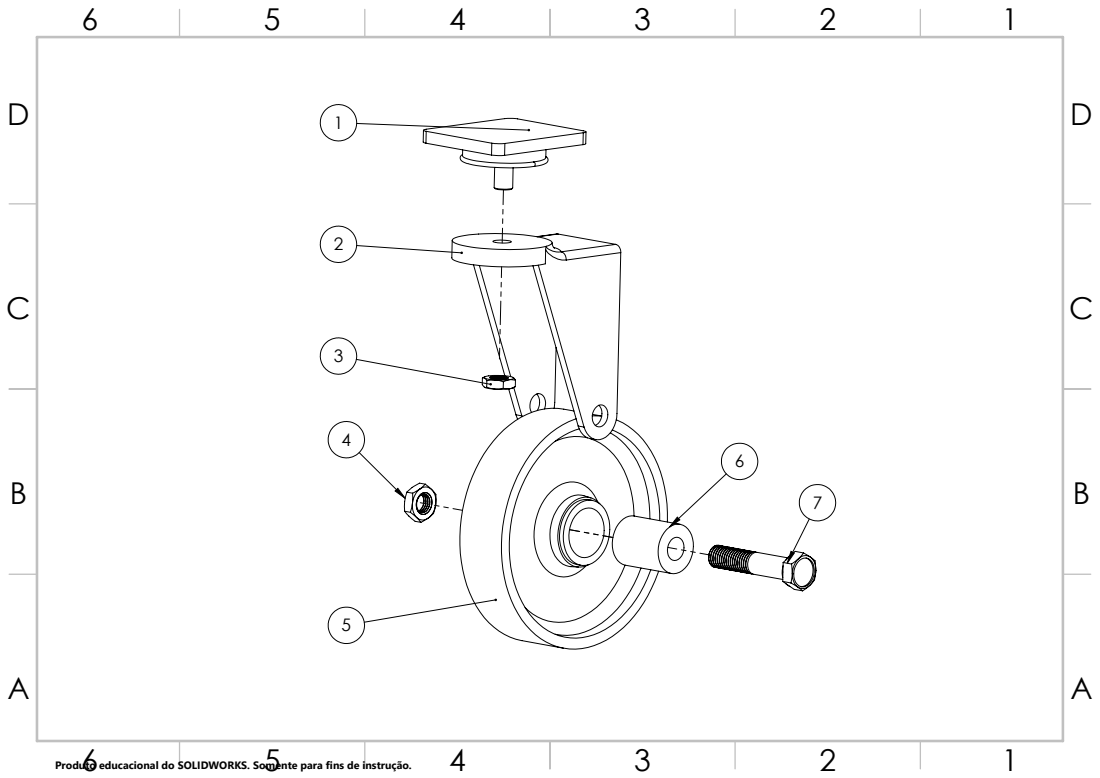
[picture p272: page 2]

Produto educacional do SOLIDWORKS. Somente para fins de instrução.
