Flash-Cart/Flash-Cart-Model/5.Manuais/slot de carregamento/passo 2.pdf

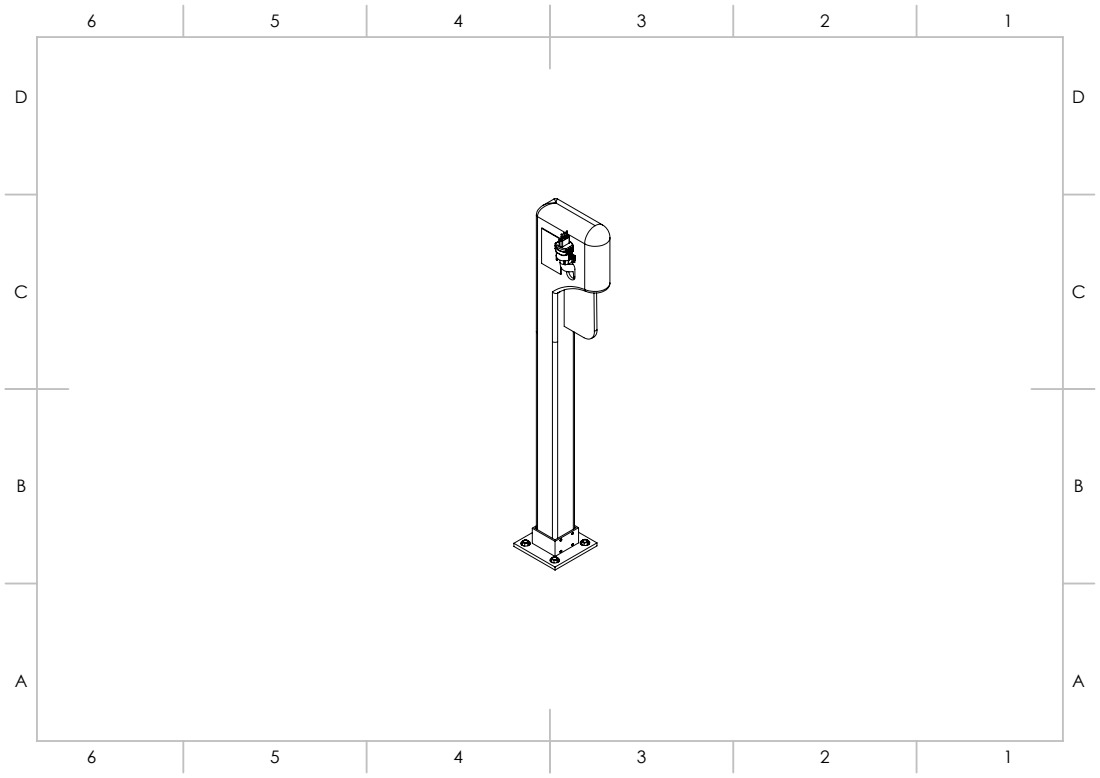
[picture p273: page 1]
