Flash-Cart/Flash-Cart-Model/5.Manuais/Suporte do display/passo1.pdf

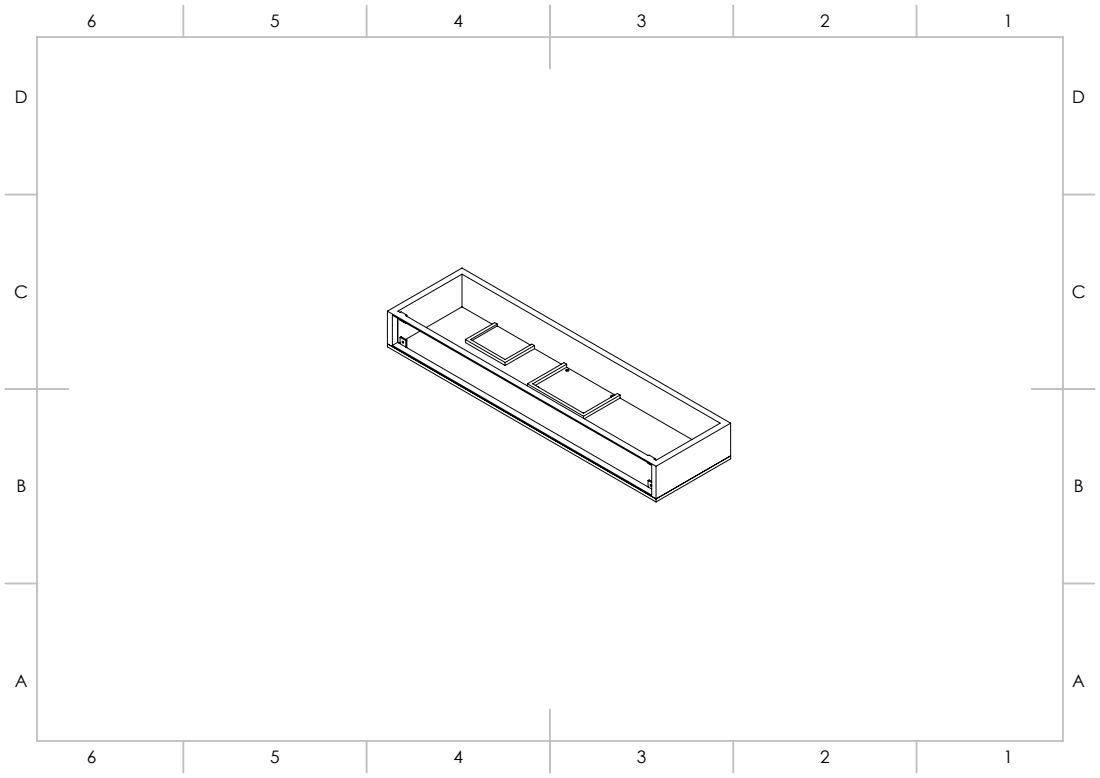
[picture p274: page 1]
