Flash-Cart/Flash-Cart-Model/5.Manuais/Suporte do display/passo2.pdf

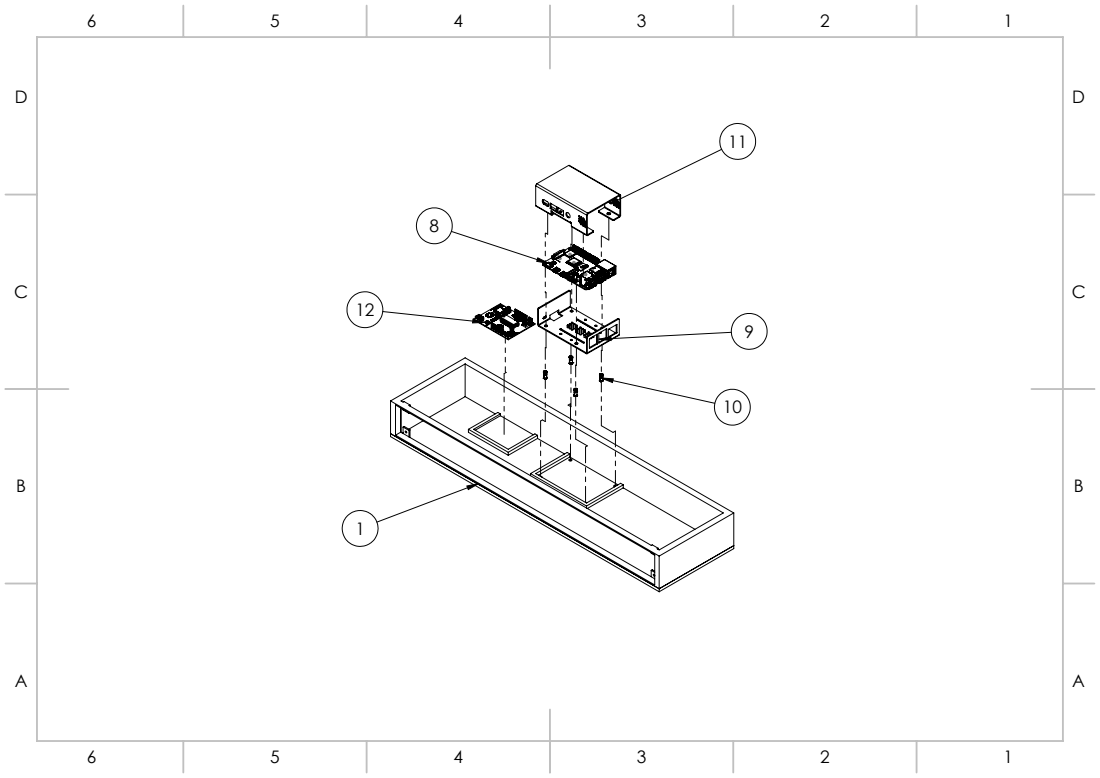
[picture p275: page 1]
