Flash-Cart/Flash-Cart-Model/5.Manuais/Suporte do display/passo3.pdf

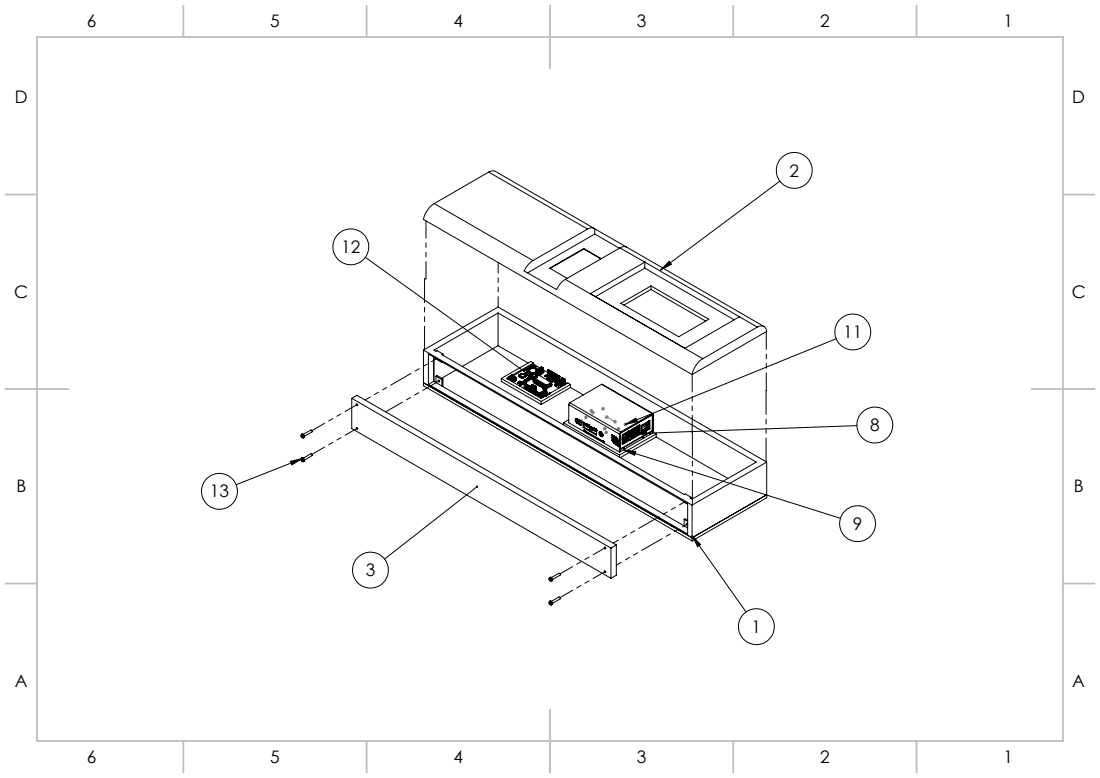
[picture p276: page 1]
