Flash-Cart/Flash-Cart-Model/5.Manuais/Suporte do display/passo4.pdf

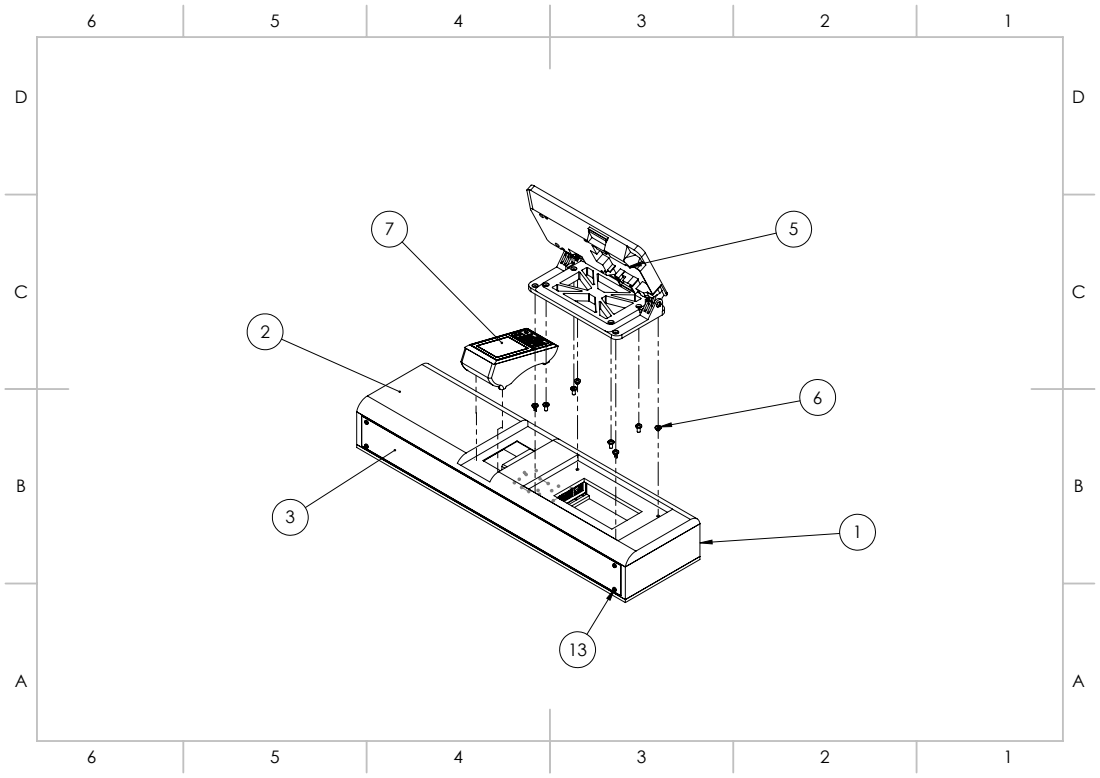
[picture p277: page 1]
