Flash-Cart/Flash-Cart-Model/5.Manuais/Suporte do display/passo5.pdf

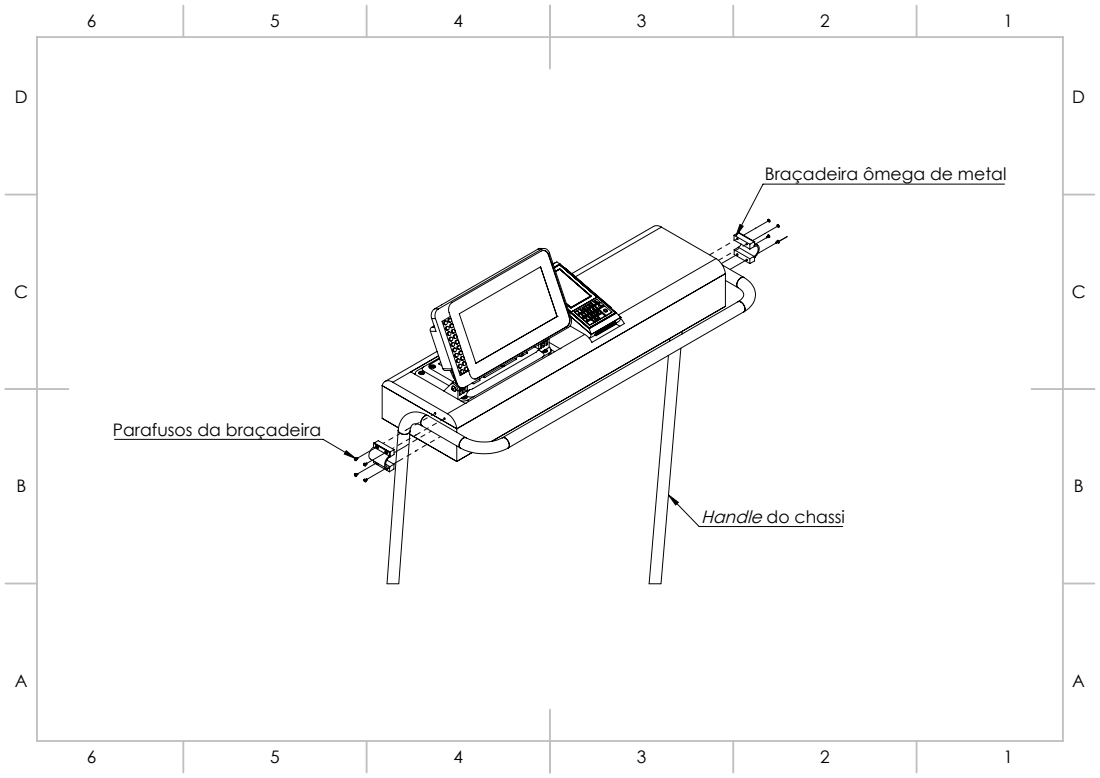
[picture p278: page 1]

Braçadeira ômega de metal

Parafusos da braçadeira

Handle do chassi
