Flash-Cart/Flash-Cart-Model/4.Desenhos Tecnicos/Desenhos finais /Caleffi/Chassi/D.PDF

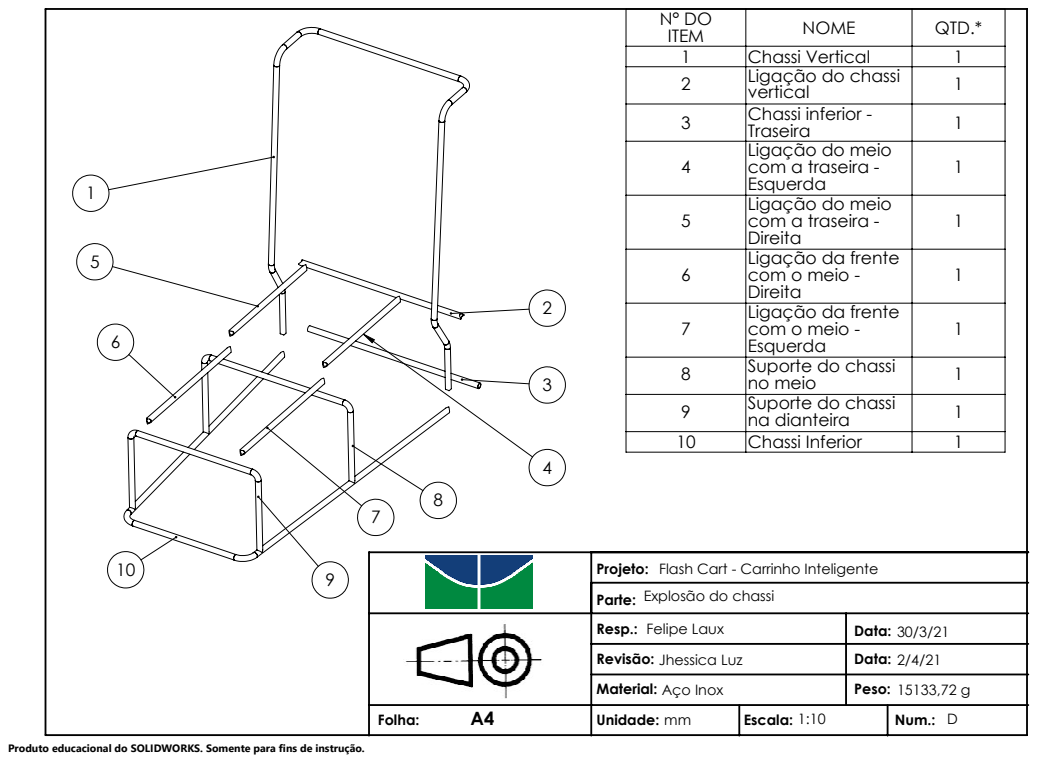
[picture p279: page 1]

N° DO ITEM | NOME | QTD.*
1 | Chassi Vertical | 1
2 | Ligação do chassi vertical | 1
3 | Chassi inferior -Traseira | 1
4 | Ligação do meio com a traseira -Esquerda | 1

5 | Ligação do meio com a traseira -Direita | 1

6 | Ligação da frente com o meio -Direita | 1

7 | Ligação da frente com o meio -Esquerda | 1

8 | Suporte do chassi no meio | 1
9 | Suporte do chassi na dianteira | 1
10 | Chassi Inferior | 1

Projeto:
Explosão do chassi
Parte:

Flash Cart - Carrinho Inteligente

Resp.: Felipe Laux | Data: 30/3/21
Revisão: Jhessica Luz | Data: 2/4/21
Material: Aço Inox | Peso: 15133,72 g

Folha: A4 | Unidade: mm | Escala: 1:10 | Num.: D

Produto educacional do SOLIDWORKS. Somente para fins de instrução.
