Flash-Cart/Flash-Cart-Model/(list of files, drawings)

Other design files:
9.Eletrônica/Crcuitos/AutoFalante.pdsprj
9.Eletrônica/Crcuitos/Carirnho - PCB.pdsprj
9.Eletrônica/Crcuitos/Carrinho - PCB.pdsprj
9.Eletrônica/Crcuitos/Circuito do solenoide da roda.pdsprj
9.Eletrônica/Crcuitos/CircuitoTelaResp.pdsprj
9.Eletrônica/Crcuitos/DisplayRASP.pdsprj
9.Eletrônica/Crcuitos/Imported/ROOT.DSN
9.Eletrônica/Crcuitos/SolenoideRespberryFirmware.pdsprj
9.Eletrônica/Crcuitos/TravaDaRoda.pdsprj
10.Energia/simulações/fonte com fio.pdsprj
10.Energia/simulações/fonte sem fio emissor.pdsprj
10.Energia/simulações/fonte sem fio receptor.pdsprj
